EOSCogniton/Intergen/08_Quizz_competition/Quizz_FSG_2019/Q5_Chassis.jpg

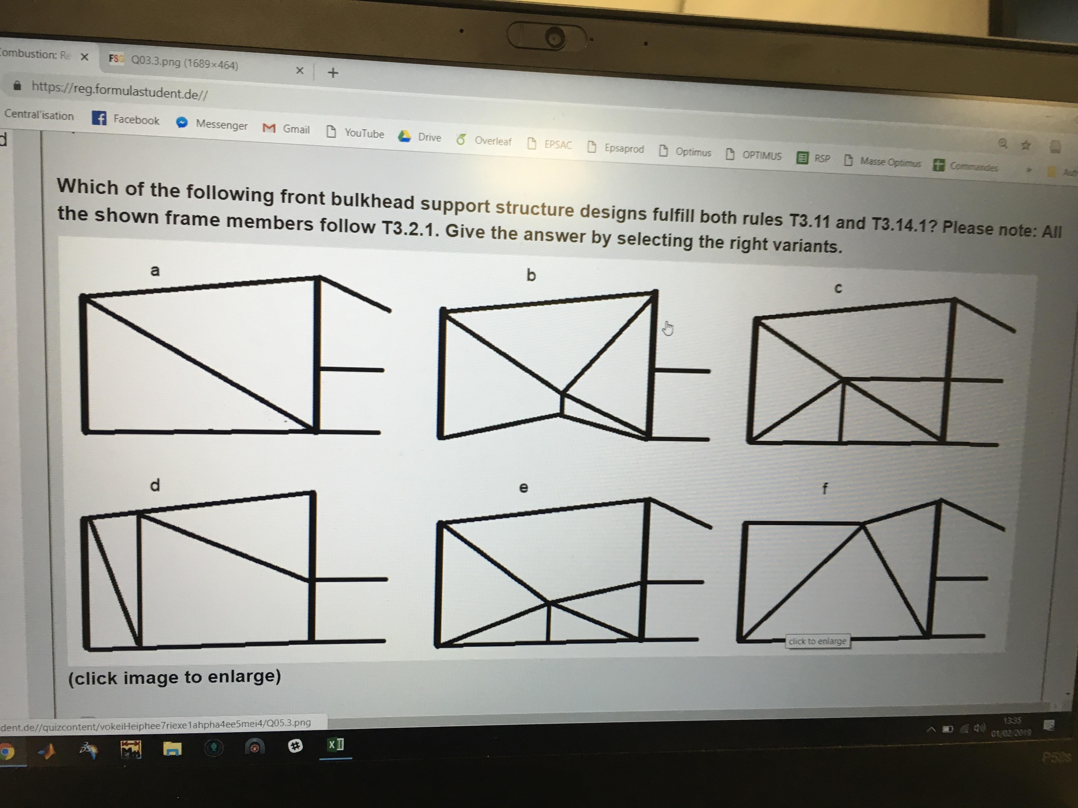
08_Quizz_competition/Quizz_FSG_2019/Q5_Chassis.jpg
