EOSCogniton/Intergen/05_Documents_Competition/03_Inscription Competition/Exemples questionnaire/IMG_5171.JPG

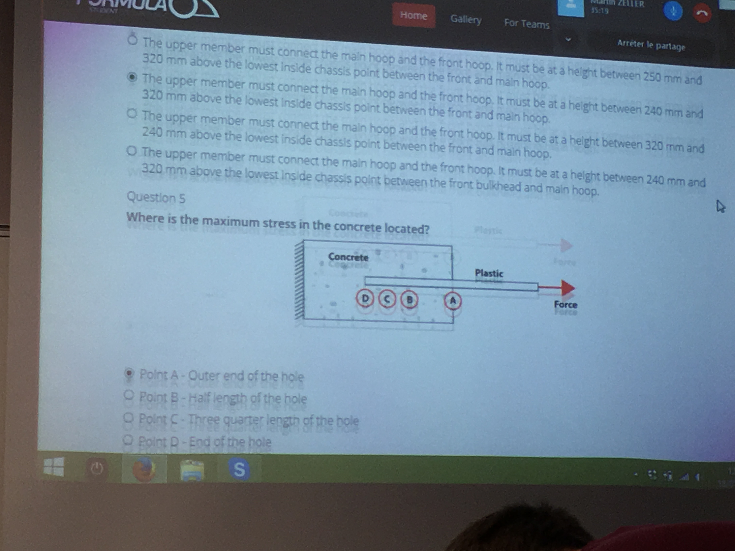
05_Documents_Competition/03_Inscription Competition/Exemples questionnaire/IMG_5171.JPG
