EOSCogniton/Intergen/02_Modèles/Lap_Time_Model/Read_Me.txt

Pour démarrer nous avons une version simple : peu précise mais faible en temps de calcul ==> Simple_Model
Puis une version plus complexe qui intégre les données pneu pour accel, freinage & skidpad ==> Complex_Model
Nous avons fait un programme pour trace le circuit ==> Track_Plot

Comparaison_Model.xslx ==> C'est un excel de rendu pour comparer différentes architectures
