EOSCogniton/Intergen/02_Modèles/Lap_Time_Model/04_Appli/Release_Version.txt

V0.1 : 
V0.2 : Import .mat Button added
v0.3 : Skidpad button run the simulation for Skidpad, Import .mat become import .xlsx
