EOSCogniton/Intergen/06_Plateforme_Bron/Plan_Rules.pptx

Plateforme de ISYPRO (Lycée Emile Bejuit - Bron)

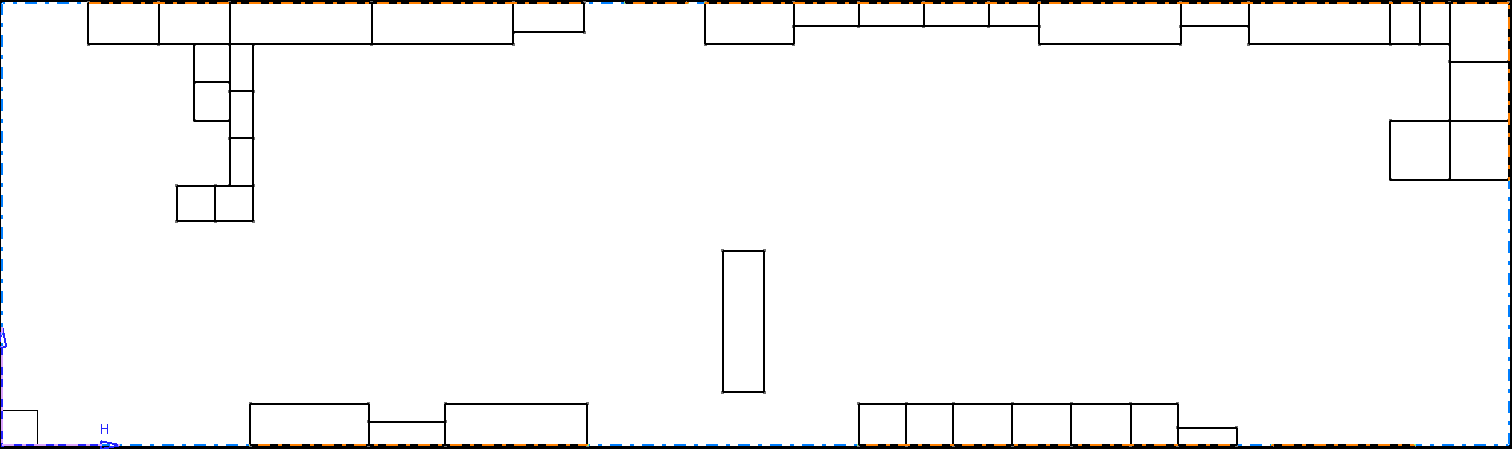
[picture p20: figure]

Sector 7

Sector 6

Sector 3

1,1 m

2,4 m

Sector 2

2,4 m

Sector 1

2 m

3 m

7,5 m

Sector 4

Tableau de Bord

1,6 m

Sector 5

Machines

25,5 m

1,6 m

3 m

0,8 m

1 m

0,6 m

2,4 m

Etabli Moteur

Sector 1

Raw materials & trailer & machining

Sector 2

Sector 3

Etagère Kit Montage & Inventaire Pièces

Sector 4

Anciens Véhicules
+ Equipements Pilotes

Sector 5

Rangement Outils
+ Etablis

Sector 6

Intégration sur le véhicule

Sector 7

Cuisine, Equipements de sécurité

Electrical Departement

Version : v3.0

Date : 06/03/2020, CMI

## Slide 2

Features

Sector 7

Machines

Sector 6

Sector 3

1,1 m

2,4 m

Sector 2

2,4 m

Sector 1

2 m

3 m

7,5 m

Sector 4

Sector 5

25,5 m

Sector 4

1,6 m

3 m

0,8 m

1 m

0,6 m

2,4 m

1,6 m

Sector 1

Sector 2

Sector 3

Sector 5

Sector 6

Sector 7

Version : v3.0

Version : v3.0

Date : 06/03/2020, CMI

## Slide 3

Plateforme de ISYPRO (Lycée Emile Bejuit - Bron)

I - Working rules :
- Rule I-1 : Always clean up after working time
- Rule I-2 : Put the tools back where you found them
- Rule I-3 : Leave written messages on parts you worked on if necessary
II - Safety rules :
- Rule II-1 : Do not work when you are alone
- Rule II-2 : Always wear the appropriate protection clothes & shoes
- Rule II-3 : When machining, wear safety glasses and gloves

Version : v3.0

## Slide 4

Sector 1 : Machining & Storage

Officer : MPL

- Grinder
- Drilling machine
- 2 metal shears
- One hydraulic press
- 2 Vices
- 4 raw material storage slots (plates, woods, plain material & misc.)

Version : v3.0

## Slide 5

Sector 2 : Electrical Departement

Officer : BAT

- …

Version : v3.0

## Slide 6

Sector 3 : Assembly Boxes

Officer : MPL

- …

Version : v3.0

## Slide 7

Sector 4 : …

Officer : …

- …

Version : v3.0

## Slide 8

Sector 5 : …

Officer : …

- …

Version : v3.0

## Slide 9

Sector 6 : …

Officer : …

- …

Version : v3.0

## Slide 10

Sector 7 : …

Officer : …

- …

Version : v3.0

## Pb echappement : distance entre echappement et réservoir

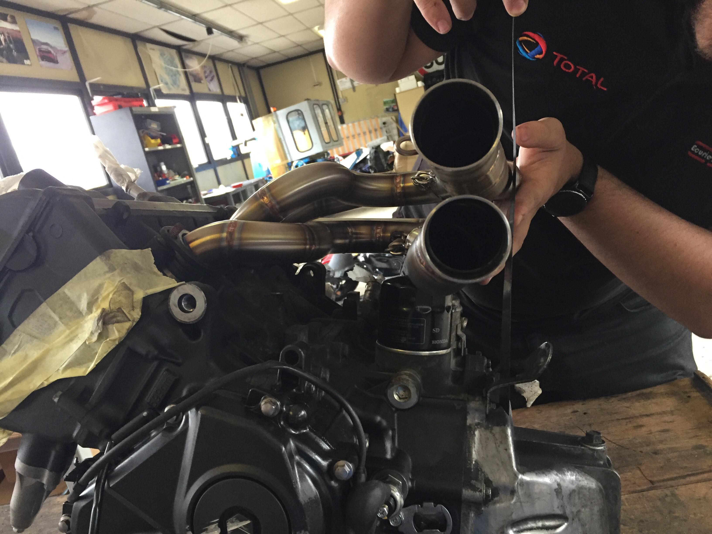
[picture p21: figure]
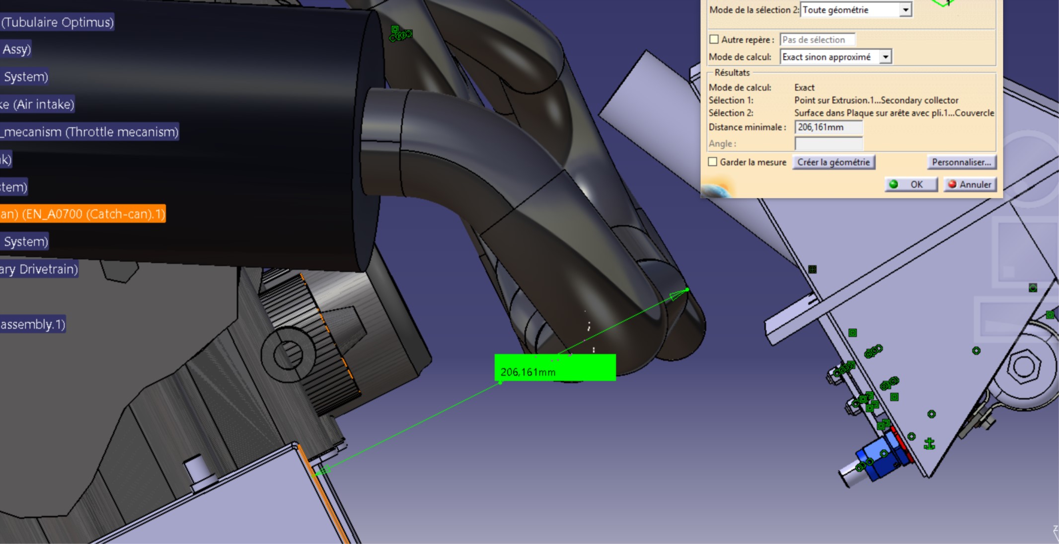
[picture p22: figure]

? < 50 mm

200 mm

215 mm

53 mm

## Pb chaine/couronne et BAR

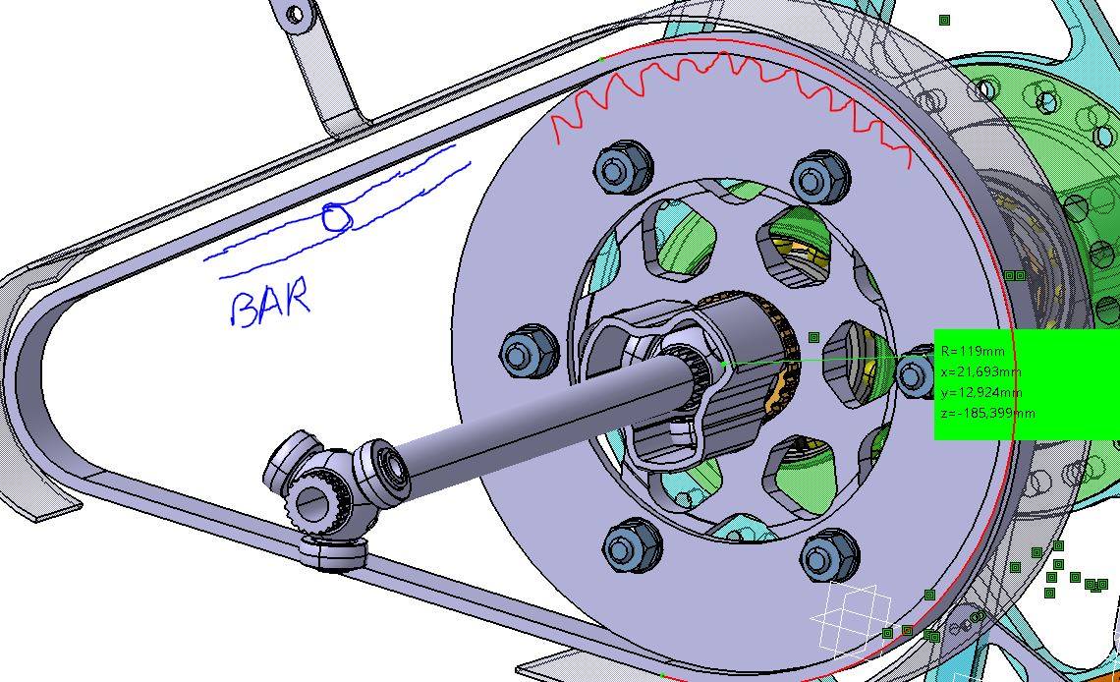
[picture p23: figure]

Braum tu es sur d’avoir pris en compte le fait que la chaine rentre dans les pignons de la couronne ?

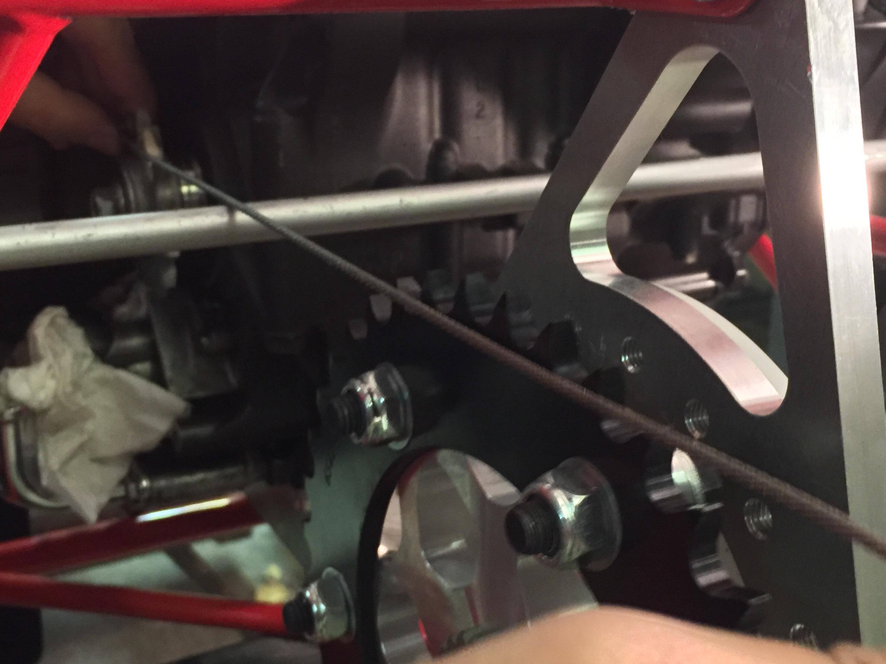
[picture p24: figure]

## Pb Couronne passage circlip

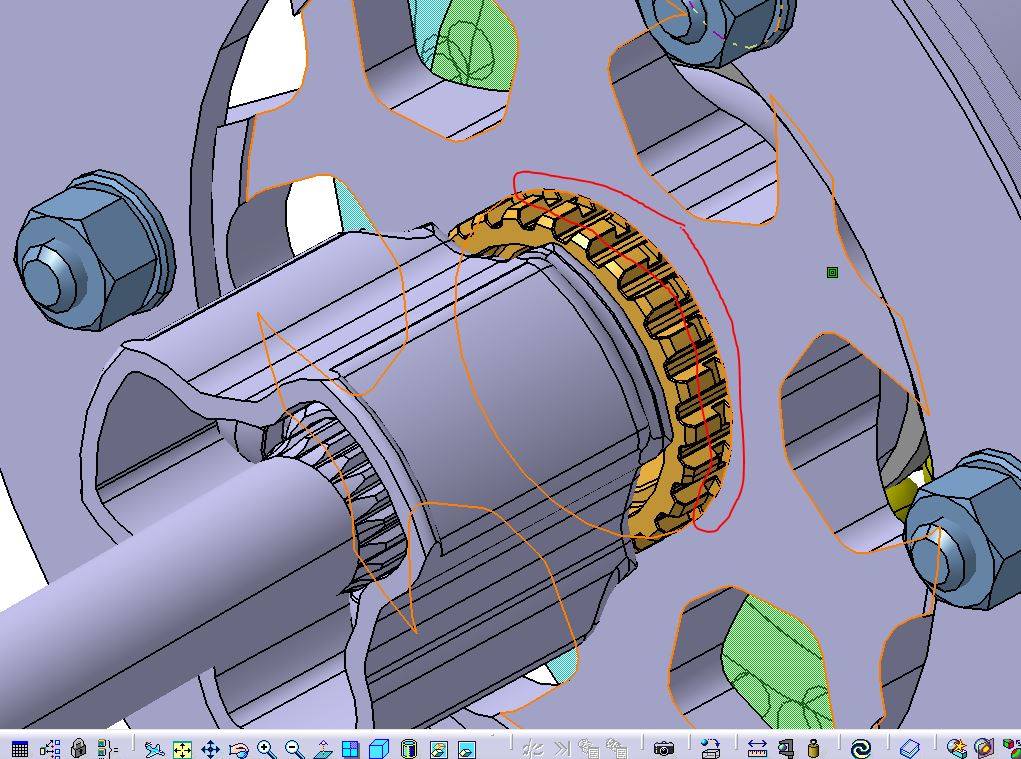
[picture p25: figure]

L’évidement que Bertrand houx n’avez pas fait pour éviter de l’usinage était en fait nécessaire pour assurer la place de passer correctement le circlip du Drexler

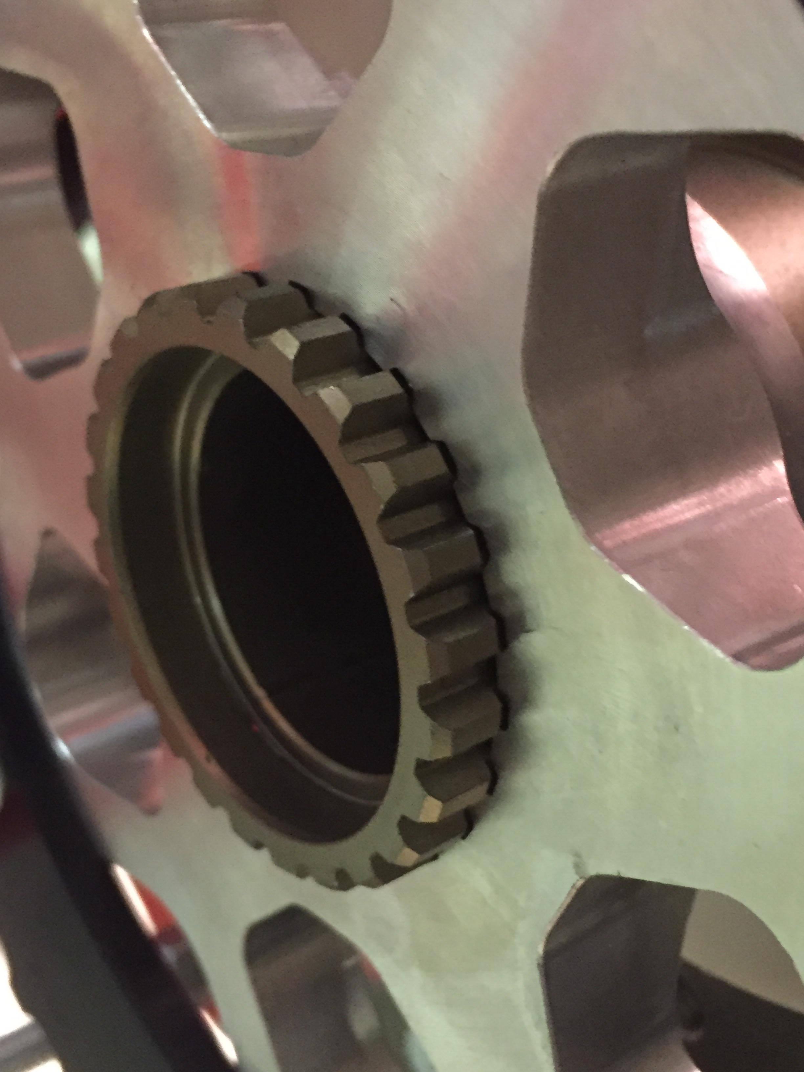
[picture p26: figure]
