EOSCogniton/Intergen/08_Quizz_competition/2018_Quizz2.pptx

Quizz #2

Mardi 4 Decembre 2018

## Question #1

What is the minimum distance between 95th percentile lower 200mm circle and face of the pedal ?
- 925 mm
- 920 mm
- 37 in
- 36 in

Notes: 36 in

## Question #2

What is the maximum angle which the lower portion of Main hoop (i-e below upper side impact member) can make with the horizontal, when inclined rearward ?

- No limit
- 10
- 80
- 45

Notes: 80

## Question #3

The engine lubrication system of your vehicle has a capacity of 12.5l. In driving condition it is 80% filled with the fluid. What is the minimum volume of catch can?

- 1l
- 0.9l
- 1.1l
- 1.2l

Notes: 1l

## Question #4

Which ones meets the positive locking requirement?

- Washers
- Cotter pins
- Bolts with nylon patches
- Loctite

Notes: Cotter pins

## Question #5

Runner system between restrictor and throttle body is made up of rectangular cross-section with height 55mm. What is the possible width of the runner system?
- 60mm
- 50mm
- 55mm
- 65mm

Notes: 50mm

## Question #6

What is the penalty, if a team is not able to submit notice of intent or FMEA of ETC by the due date?
- -10 points daily till max -50 points
- Disqualification from competition
- Back to mechanical throttle
- No penalty

Notes: Back to mechanical throttle

## Question #7

Which of the following is not a requirement of Cost report ?
- Font size 10 point or higher
- Page size A4
- Page size 8.5in x 11in
- Must not exceed 350 pages

Notes: Must not exceed

## Question #8

In Autocross Event, which flag is used to indicate the approval to begin ?
- Blue flag
- Red flag
- Green flag
- Red-yellow striped

Notes: green

## Question #9

In endurance event if a team exceeds Tmax time then how much points do they score ?
- 50
- 25
- 10
- 0

Notes: 25

## Question #10

Which of the following act results in penalty ?
- Alcohol and illegal material
- Arguments with official
- Unsportsmanlike conduct
- Failed to follow an official instruction

Notes: Failed to follow
