EOSCogniton/Intergen/03_Gestion_De_Projet/03_Diapo_Presentation_Seance_PA_PE/2018_12_18_Project_Brief.pptx

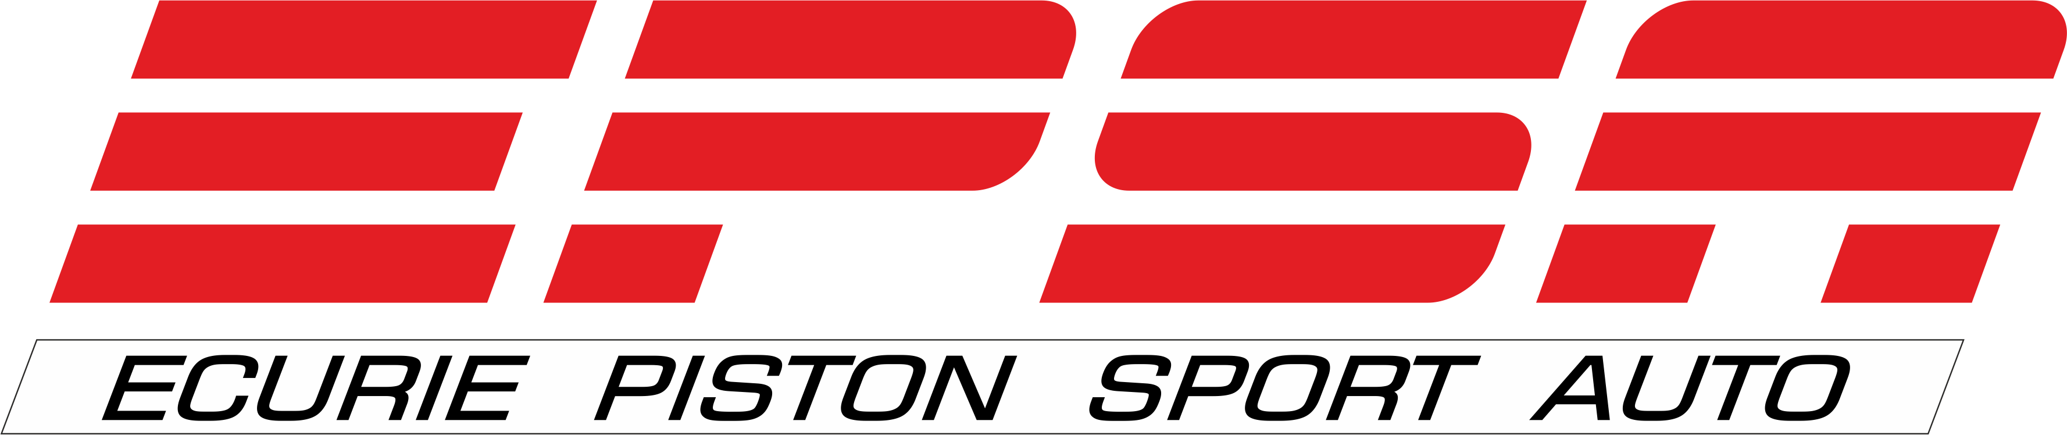
[picture p31: figure]

Point sur le projet

Mardi 18 Décembre 2018

## Point sur l’avancée des mEP

- Premiers envois en production chez La Mache productique, Boisard et La mache Laser
- Préparer les devis

## Réalisation des gabarits

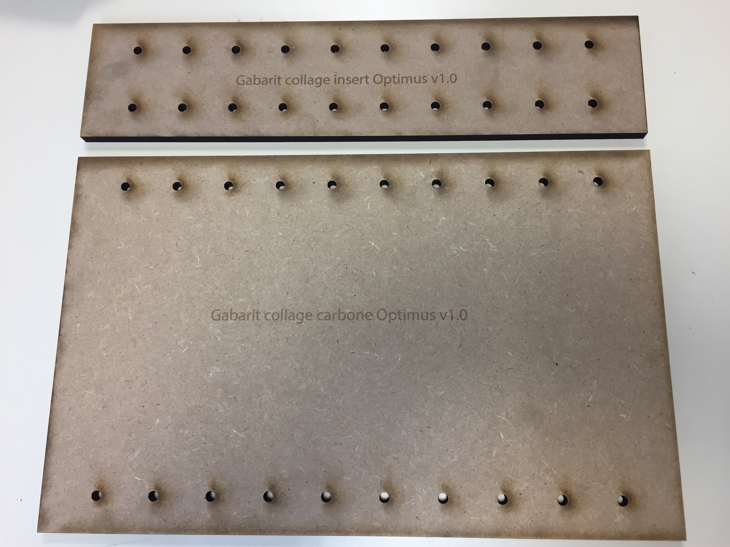
[picture p32: figure]

## Pour le top projet

Questions ?
