EOSCogniton/Intergen/07_Documents Techniques/02_Formations/Formation_Departement_2A/Template_Diapo_Formation.pptx

Département …

Janvier 2018

## Cahier de charges

- Explication des critères et contraintes principales intervenants dans la conception de votre système ou pièce.

## Conception préliminaire

- …

## Conception DETAILLEE

- …

## ERREURS A EVITER

- …

## Pour le top projet

Questions ?
