EOSCogniton/Intergen/05_Documents_Competition/Documents_Design_Vulcanix_2018/Impression/Engine Support.pdf

## MOTORISATION

## Aims

- Reliable engine
- Reduce the impact of the air intake restrictor

## Constraint

According to the rule, all the air used by the engine should go through a 20mm diameter air intake restrictor. Consequences after the “maximum” engine speed is reached:
- Constant power after a certain engine speed
- Decay of the torque

## Engine choice

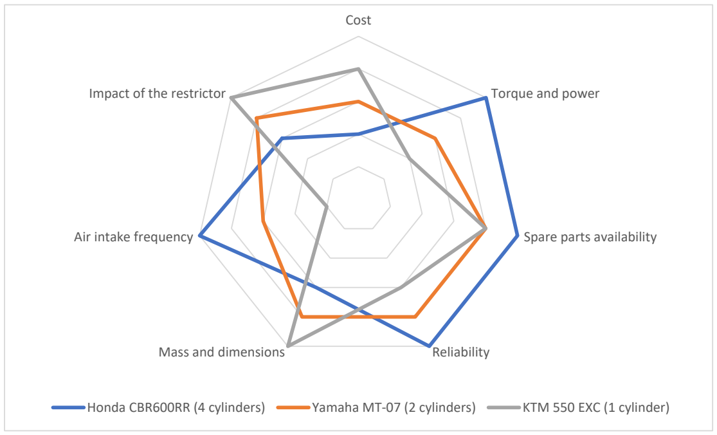
[picture p65: figure]
Cost; Torque and power; Spare parts availability; Mass and dimensions; Reliability; Air intake frequency; Impact of the restrictor; Honda CBR600RR (4 cylinders); Yamaha MT-07 (2 cylinders); KTM 550 EXC (1 cylinder)

- Choice of the Honda CBR600RR, particularly for is reliability, and impact of the restrictor on this engine.

Figure 1: Diagram of engine choice

## Air intake and exhaust

## Objective

- Reduce the impact of the air intake restrictor
- Dispose of a stock of air between the engine and the air intake restrictor
- Low pressure loss in the plenum

## Acoustic study

Hypothesis:

- Intake: 20°C
- Exhaust: 600°C

Lengths:

- Admission runner: 351mm
- Exhaust:
- First runner: 402-426mm
- Collector: 296-308mm
- Final collector: 378mm
- Gain of torque in the constant power zone.

## Engine tuning

Sensors:

- Camshaft angle
- Crankshaft speed
- Water temperature
- Air temperature

Parameters:

- Fuel injection time
- Ignition timing: timing advance

Objective: increase torque and efficiency

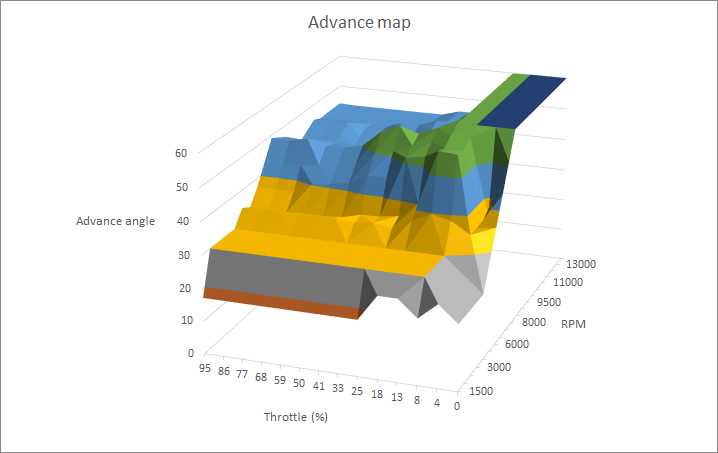
[picture p66: figure]

Figure 1: 3D timing advance map
