EOSCogniton/Intergen/02_Modèles/Acceleration BRT (Simulink)/Lisez-moi.txt

Lancer en premier le script matlab d'initialisation des variables.
Le fichier simulik s'exécutera tout seul.
