EOSCogniton/Intergen/04_Communication/CHARTE GRAPHIQUE EPSA.docx

CHARTE GRAPHIQUE EPSA

Couleurs :

R : 247

V : 9

B : 3

LOGO et utilisation :

Logo sur fond blanc

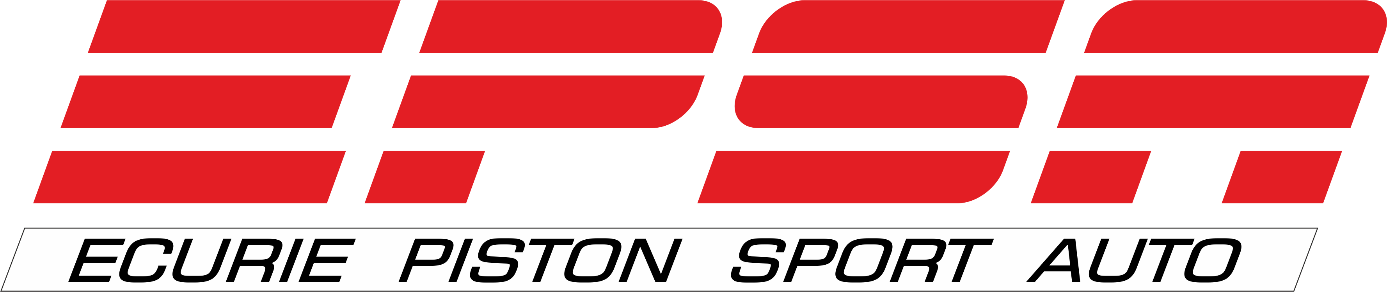
[picture p122: figure]

Petit format type signature

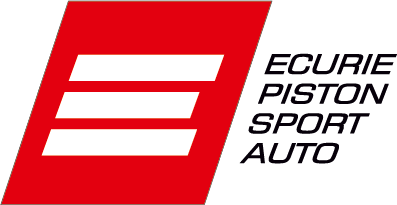
[picture p123: figure]

Police :

Raleway
