EOSCogniton/Intergen/03_Gestion_De_Projet/02_Ressources TOPs/Templates_Diapo_TOP_Projet/TOP PROJET.pptx

## Top Projet Optimus

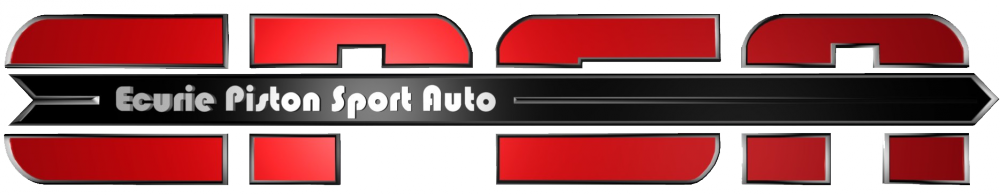
[picture p141: figure]
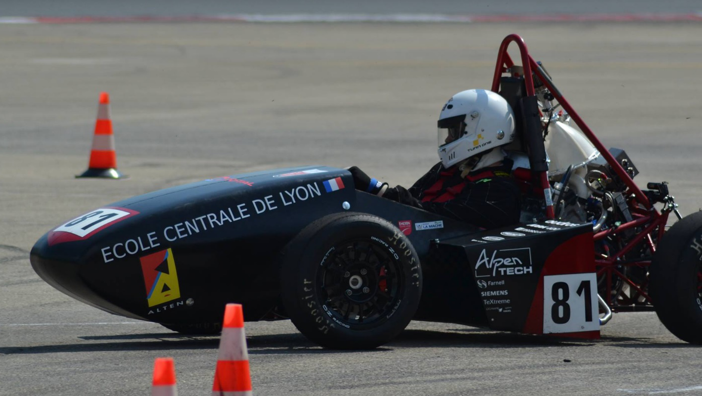
[picture p142: figure]

v1.3

## Sommaire

1. Présentation du Projet : Véhicule Optimus
2. Retour d’expérience de la saison passée
3. Présentation de la Direction Véhicule
4. Présentation des Départements
5. Proposition de jalonnement des TOP
6. Présentation du budget prévisionnel ISYRUN
7. Conclusion

## Sommaire

1. Présentation du Projet : Véhicule Optimus
2. Retour d’expérience de la saison passée
3. Présentation de la Direction Véhicule
4. Présentation des Départements
5. Proposition de jalonnement des TOP
6. Présentation du budget prévisionnel ISYRUN
7. Conclusion

## Objectifs Principaux

01

Respect strict des échéances

- Sortir la voiture dans les temps
- Date de TOP Moteur fixée au 1er Mars
- Permet une grande période de tests et entraînement pilotes

02

Formation efficace des Alpha 1A

- Formation et accompagnement revu
- Meilleure intégration de la contribution des 1A

## Optimus v1.0

Résultats Prévus :

Epreuve | Meilleurs résultats | Prévision | Barème
Cost Event | 94/100 Vulcanix | 85 | 100
Business Event | 63/75 Atomix v1.0 | 50 | 75
Design Event | 106/150 Dynamix v1.0 | 85 | 150
Skid Pad | 45/75 Kinétix | 40 | 75
Accélération | 60/100 Dynamix v2.0 | 75 | 100
Autocross | 41/125 Atomix v2.0 | 55 | 125
Endurance | 160/275 Dynamix v2.0 | 175 | 275
Efficiency | 6/100 Atomix v1.0 | 10 | 100
Total Brut | 480/1000 Dynamix v2.0 | 575 | 1000

## Sommaire

1. Présentation du Projet : Véhicule Optimus
2. Retour d’expérience de la saison passée
3. Présentation de la Direction Véhicule
4. Présentation des Départements
5. Proposition de jalonnement des TOP
6. Présentation du budget prévisionnel ISYRUN
7. Conclusion

## Retour d’expérience des années passées

Décisions :

- Un véritable travail intergénérationnel unissant 1A, 2A et 3A autour d’un même véhicule
- Un renforcement de la structure managériale autour de “Départements”
- Un reporting hebdomadaire pour le suivi d’avancement
- Une meilleure gestion de la formation pour les 1A arrivant à l’EPSA

## Sommaire

1. Présentation du Projet : Véhicule Optimus
2. Retour d’expérience de la saison passée
3. Présentation de la Direction Véhicule
4. Présentation des Départements
5. Proposition de jalonnement des TOP
6. Présentation du budget prévisionnel ISYRUN
7. Conclusion

## Organisation de la direction Véhicule pour la saison 2019

Organisation du Projet :
- Directeur de Projet : Nicolas Gameiro (NGO)
- Directeur Technique : Maxime Proriol (MPL)
- Directeur Performance : Bob Aubouin (BAT)
- Directeur Financier : Yohan Reguiai (YRI)

## Organisation de l’association pour la saison 2019

Organisation Associative :
- Président : Paco Tanchon (PTN)
- Vice-Président : Antoine Maros (AMS)
- Secrétaire Général : Josselin Kiefel (JKL)
- Trésorier : Erwan De Longcamp (EDP)

## Sommaire

1. Présentation du Projet : Véhicule Optimus
2. Retour d’expérience de la saison passée
3. Présentation de la Direction Véhicule
4. Présentation des Départements
5. Proposition de jalonnement des TOP
6. Présentation du budget prévisionnel ISYRUN
7. Conclusion

## Organisation des Départements

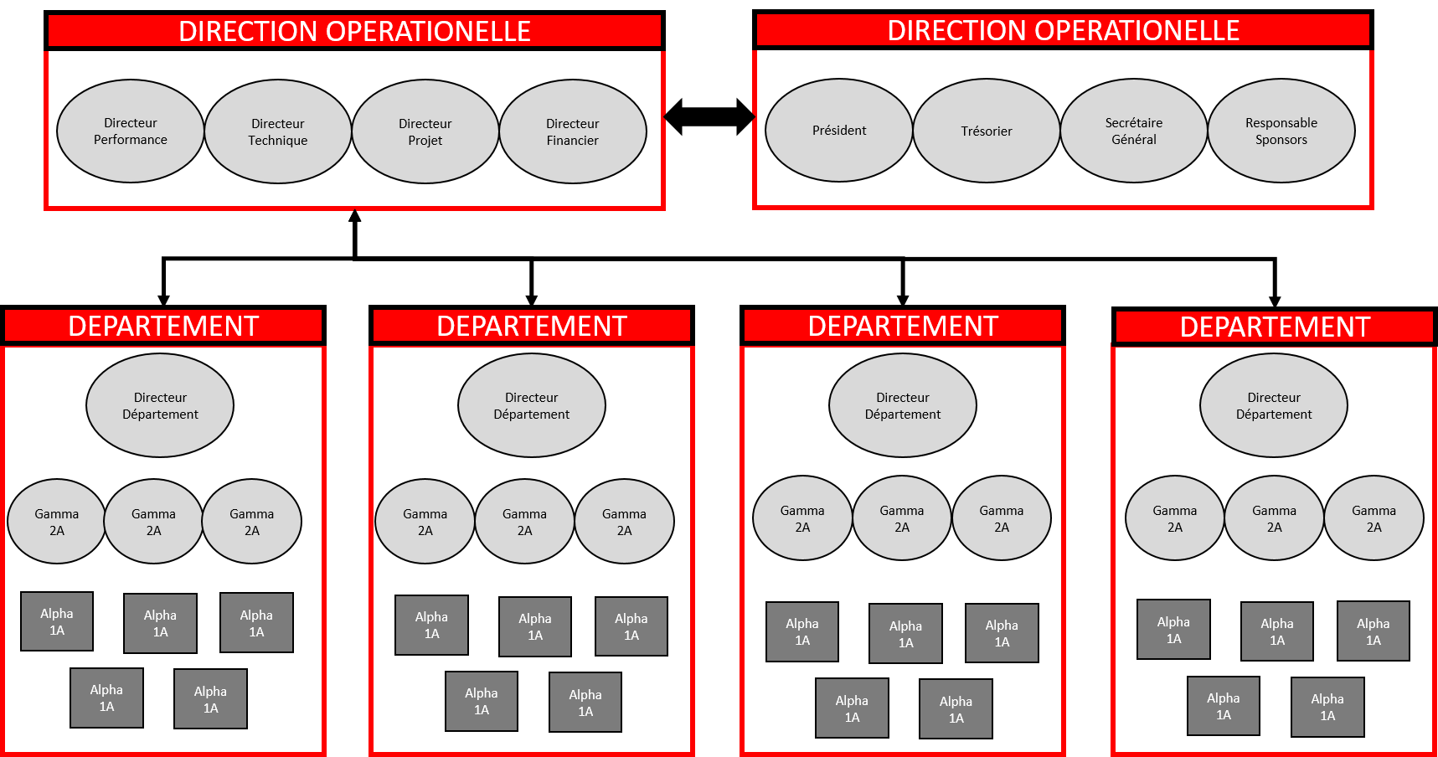
[picture p143: figure]

## Organisation des Départements

| Châssis équipé & aéro | Motorisation | LAS | Elec.
Directeur | Robin Clamens | Clément Emerique | Pierre Alexis Corpechot | Bob Aubouin
Membre | Rafael De Leon | Théophane Bau | Erwan De Longchamps | En phase de recrutement
Membre | Yohan Reguiai | Maxime Proriol | Lucas Trouessin
Membre | Josselin Kiefel | Paco Tanchon | Gameiro Nicolas

## Objectifs Département LAS

Ce qu’on garde :
- LAS Automatique réalisée par les 2As
- Porte Moyeux
Ce qu’on ajoute :
- Mise en place de l’anti-roll Bar
- Optimisation de la position des centres de Roulis
- Réflexion sur anti-dive & anti-squat

## Objectifs Département Chassis équipé & aéro

Ce qu’on garde :
- conception paramétrique
- structure générale
Ce qu’on ajoute :
- éléments aéro (ouies, diffuseur..)
- repenser la cellule arrière
- optimisation du cockpit
- attention au surdimensionnement

## Objectifs département Electronique

Ce qu’on garde :
- La rigueur de travail de l’équipe de Vulcanix
- Le faisceau de Vulcanix s’il fait ses preuves cet été
Ce qu’on ajoute :
- Un possible système de télémétrie ( si recrutement)
- Un volant équipé

## Objectifs Département Motorisation

Ce qu’on garde :
- Pas de changement Moteur
- Refroidissement
- Transmission secondaire
Ce qu’on ajoute :
- Changement de l’échappement
- Optimisation de l’admission
- Changement du réservoir d’essence

## Sommaire

1. Présentation du Projet : Véhicule Optimus
2. Retour d’expérience de la saison passée
3. Présentation de la Direction Véhicule
4. Présentation des Départements
5. Proposition de jalonnement des TOP
6. Présentation du budget prévisionnel ISYRUN
7. Conclusion

## Dates Prévisionnelles des TOPs (Conforme PO-07-002)

TOP Projet (S)
Lancement officiel du projet du nouveau véhicule autorisant les ressources humaines du projet

4 Avril 2018

TOP Pré-Dim (SF)
Validation des premiers maquettes autorisant l’engagement des ressources logicielles de validation numérique

6 Juin 2018

TOP Maquette
Présentation des premiers concepts autorisant l’engagement des ressources logicielles de la modélisation physique et de maquette numérique

9 Mai 2018

TOP Appro
Présentation des validation de maquettes et lancement des premiers approvisionnements autorisant l’engagement des bons de commandes des approvisionnements matière à cycle long

29 Juin 2018

TOP Saison
Lancement de la saison 2018/2019 avec les 1er années et les académiciens.

22 Septembre 2018

TOP Copeau (SFF)
Présentation de l’intégralité des choix de conceptions et leur justification autorisant le lancement de la production véhicule, l’engagement des matières premières, la fabrication des pièces unitaires chez les partenaires.

6 novembre 2018

TOP Synthèse
Présentation de l’avancement du projet autorisant l’engagement des moyens techniques et humains de la plateforme ISYMECA

2 Octobre 2018

TOP Organe
Vérification de l’état d’avancement des kits sur une plateforme partenaire.

9 Janvier 2019

Fin de la phase descendante
et début de la phase remontante

## Dates Prévisionnelles des TOPs (Conforme PO-07-002)

TOP Véhicule
autorise l’Intégration Véhicule sur la plateforme ISYPRO.

15 Février 2019

TOP Qualif (SFFV)
Validation du véhicule par un pilote professionnel

16 Mars 2018

TOP Moteur
Démarrage du moteur autorisant la Validation Système du véhicule sur piste d’essais.

2 Mars 2019

TOP Compet
Présentation de l’équipe des pilotes

1er Juillet 2019

## Diagramme de GANTT du début de la phase Descendante

## Jalonnement des livrables (Déploiement de la PO-19-001)

TOPs Phase descendante :
- Pour le TOP Maquette : DDI, DSS
- Pour le TOP PréDim : DCP, ½ DMI-3D
- Pour le TOP Appro : DCD, ¾ DMI-3D
- Pour le TOP Synthèse : DMI-3D
- Pour le TOP Copeaux : BIC, PROP
TOPs Phase remontante :
- Pour le TOP Organe : PROM, PROC, PFC
- Pour le TOP Véhicule : PROV, PROX

## Sommaire

1. Présentation du Projet : Véhicule Optimus
2. Retour d’expérience de la saison passée
3. Présentation de la Direction Véhicule
4. Présentation des Départements
5. Proposition de jalonnement des TOP
6. Présentation du budget prévisionnel ISYRUN
7. Conclusion

## Budget prévisionnel Optimus

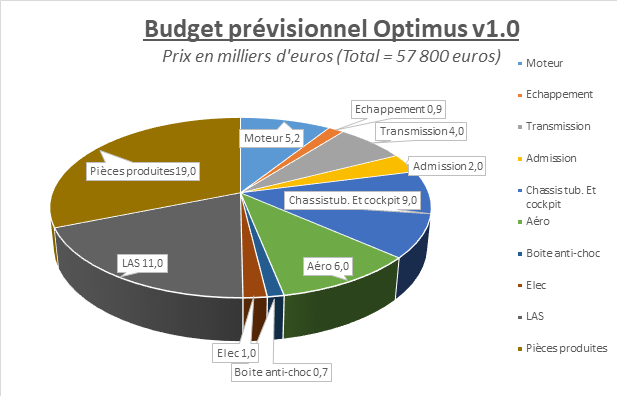
[picture p144: figure]

## Sommaire

1. Présentation du Projet : Véhicule Optimus
2. Retour d’expérience de la saison passée
3. Présentation de la Direction Véhicule
4. Présentation des Départements
5. Proposition de jalonnement des TOP
6. Présentation du budget prévisionnel ISYRUN
7. Conclusion

## Conclusion

⇒ Le retour intergénérationnel a été exploité
⇒ Le déploiement de la PO-07-002 et PO-19-001 est effectué
9 Mai 2018 : TOP Maquette
Save the date !
⇒ Questions ?

## Crowdfunding 2018

Lancement du crowdfunding sur Ulule
Lien dès demain par mail

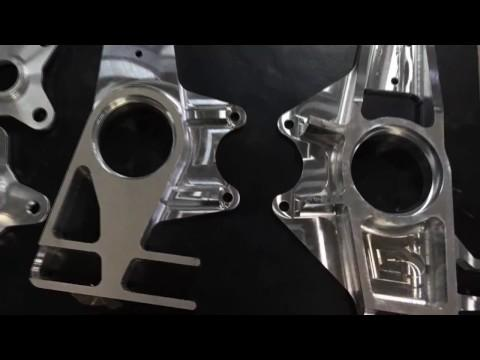
[picture p145: figure]
