EOSCogniton/Intergen/03_Gestion_De_Projet/01_Documents Organisation/2019_Optimus/04_Direction Financière/Gestion_Budget.pptx

## Gestion du Budget EPSA

Version 1.0

Saison 2019-2020

## Sommaire

Budget EPSA

- Les sources de financement de l’EPSA
- Les interlocuteurs privilégiers
- Les procédures à suivre
- Remarques de la saison 2018-2019

## Les sources de financement

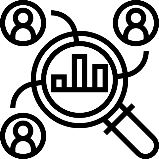
[picture p146: figure]

- La taxe d’apprentissage
  - Total
  - Alten
  - Volvo
  - Et plein d’autres
- Don sur l’association :
  - Alten
  - Instituts Carnot
- Don en nature :
  - SKF
  - ARRK
  - Souriau

## Les procédures à suivre

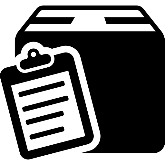
[picture p147: figure]

Procédure EPSA :

1. Faire un devis auprès d’une entreprise
2. Transmettre le devis au directeur financier qui tient un excel à jour avec les commandes et leur statut (en préparation, lancée,…)
3. Envoie d’un mail avec une forme particulière à Béatrice (Service facturé H10 Centrale)
4. Remplissage du Tableau chrono sur EPSABox

Procédure Service facturé Centrale :

1. Elle prépare la commande
2. Transmission de la commande à Roxane du service financier de Centrale

Procédure Service financier Centrale :

1. Elle prépare le bon de commande
2. Transmission de la commande à Oliver Barielle pour le signer

## Les procédures à suivre

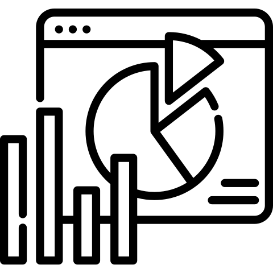
[picture p148: figure]

- Réalisation du budget prévisionnel en début de saison avec le directeur de projet
- Le directeur financier doit tenir à jour un excel avec des données statiques sur le budget.

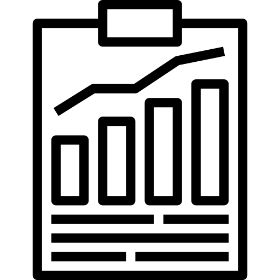
[picture p149: figure]

- Le directeur financier doit faire des rapports hebdomadaires à l’ensemble de l’équipe sur slack et lors des séances de PA

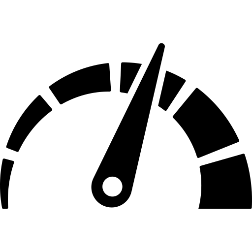
[picture p150: figure]

- Le directeur financier doit aider le directeur projet à la relance et la tenue des délais des commandes planifiées dans le Gantt.

## Les remarques

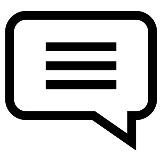
[picture p151: figure]

Nouveau fournisseur :

- Il faut demander à l’entreprise, en même temps que le devis, de remplir la fiche d’ajout de fournisseur de Centrale. Lien : …

Fournisseur étranger :

- Il faut les prévenir de notre mode de payement particulier
- Réaliser le Bill of sales (Bos). Exemple : …

## Les remarques

Nom des anciens directeurs financiers EPSA :

- Dynamix : Fabien ROBERT
- Atomix :
- Kinetix : Marc Salmon ?
- Olympix : Pierre Antoine Allart
- Vulcanix : Pierre Gras
- Optimus : Yohan Reguai
- Invictus : Romain Martin

## Questions ?
