EOSCogniton/Intergen/07_Documents Techniques/01_Livrables_TOPs/03_Livrables_TOP_Pré_Dim/Regles de conception_v1.0.pdf

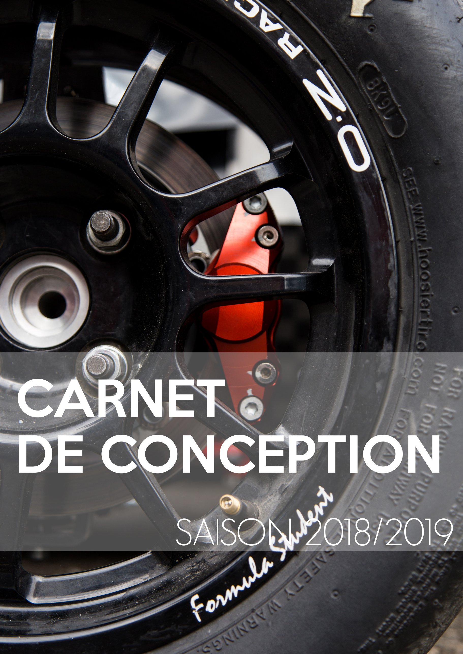
[picture p152: page 1]

# CARNET DE CONCEPTION

# SAISON 2018/2019

# INTRODUCTION :

# ACCESSIBILITE :

# PRINCIPALES REGLES :

L’objectif de ce document est de donner un ensemble d’informations utiles pour réaliser et concevoir les différentes pièces qui constituent vos systèmes et sous-systèmes. Il est principalement utile lors de la phase de conception Post TOP Pré-Dimensionnement. Il convient au directeur Technique du véhicule de prendre connaissance de ce document et de s’assurer du respect des régles qui y sont énoncées.

Vous concevez des pièces, mais plus largement des assemblages. Pensez que vous allez avoir des éléments de serrage (vis, écrou principalement). Mettez les autant que possible sur vos maquettes : ça peut montrer des problèmes d’encombrement, de collision, d’impossibilité de mise en place. Et oui, ça ne vient pas comme par magie dans le trou (place pour les doigts, suffisamment de place pour insérer la longueur de la vis).

Et ensuite il faut serrer : pensez que les outils ça prend encore plus de place (diamètre de douille, place pour les clés/ cliquets etc).

De manière générale, quand il s’agit d’encombrement au niveau du châssis, passages de gabarits, ou entre sous systèmes essayez toujours d’avoir un peu de marge. Car la maquette numérique reste parfaite. Dans le monde réel il y a des défauts de fabrication (notamment au niveau du châssis). Pour ce qui est usinage on est plutôt bon par contre.

Essayer au plus de prendre des épaisseurs standard pour vos pièces. Exemple porte excentrique 5mm c’est du standard, ça évite de devoir ressurfacer la pièce. Si c’est pas possible les partenaires feront avec mais bon : coût et travail en plus.

# Si votre pièce est découpée laser : c’est du 2D

Si votre pièce est usinée (tour/fraiseuse) : on ne fait pas les formes que l’on veut, les dimensions que l’on veut partout. On est limité par l’accessibilité/dimensions des outils, les techniques, le maintien en position de ta pièce (ce dernier point est beaucoup moins limitant). Ces problématiques sont surtout pour ce qui est formes internes et moins des contours. Typiquement un trou carré ça n’existe pas. Si tu fais une découpe interne, tu le fais avec une fraise qui est cylindrique. Donc tu auras des congés au minimum du rayon de ta fraise.

Si vous voulez avoir toute la liberté dans les formes, il faut voir du côté de l’impression 3D, mais bon.
Évitez absolument les variations brusques de section (exemple un cylindre de 10mm qui continu directement sur un cylindre de 20mm). Préférez des transitions plus douces : utilisation de congés.
Évitez au plus possible de faire travailler vos pièces en flexion, c’est beaucoup moins résistant que si tu travaille en simple traction compression.

Concernant les maquettes CATIA, aucune esquisse ne doit avoir de traits blancs, ils doivent tous être verts. Toutes les esquisses doivent être contriantes. Sinon tu as le risque pour tu sais pas quelle raison ton esquisse bouge. Soit tu t’en rend compte avant et ça te fais faire 2 fois le même travail, soit ta pièce part en prod, tu la reçoit et oh surprise, ça

# marche pas comme tu voulais !

# DIMENSIONNEMENT DES VIS :

Le diamètre/nombre de vis ne sort pas de nulle part.

# Deux écoles :

- Ta vis fonctionne comme un ressort. Quand tu sers ton écrou avec un certain couple, ça va avoir tendance à déformer ta vis qui va vouloir reprendre sa forme initiale. Donc elle applique une force (dépendante du couple, du filetage, de la lubrification,...) qui va comprimer les deux pièces que tu veux boulonner. Loi de coulomb : tant que tu reste dans le cône ça adhère. Combiné à l’effort normal, tes pièces bougent pas.

# - Tu dimensionnes au cisaillement

# Rédaction : Arthur Perdereau (Vulcanix - Saison 2018)

Si vous avez des questions d’usinage, de conception, que vous ne savez pas trop comment faire une pièce pour telle fonction, ou que vous pensez qu’il pourrait y avoir une meilleure solution, n’hésitez pas à me contacter j’essaierai de répondre du mieux possible. Ca fera gagner du temps à tout le monde :) En annexe, vous trouverez les tables de serrages et de passage de vis.

épaisseur chape découpée laser | 1,5 mm | 3 mm | 5 mm

# longueur entretoise conique (LAS)

# STANDARDISATION DES EPAISSEURS DE DECOUPE :

# TABLE SERRAGE DE VIS :

# 6Serrage contrôlé

| www.facom.com

ISO

Fo

Cs

8,8 *

5,6 | 5,8 | 6,8 | 8,8 * | 9,8 ** | 10,9 | 12,9

ISO 272

d mm | ISO mm | mm | Cs | Fo | Cs | Fo | Cs | Fo | Cs | Fo | Cs | Fo | Cs | Fo | Cs | Fo
1,6** | 0,35 | 3,2 | 0,060 | 260 | 0,084 | 364 | 0,096 | 416 | 0,128 | 555 | 0,144 | 624 | 0,189 | 815 | 0,221 | 954
2** | 0,40 | 4 | 0,126 | 432 | 0,177 | 604 | 0,202 | 690 | 0,270 | 921 | 0,303 | 1 036 | 0,396 | 1 352 | 0,463 | 1 582
2,5** | 0,45 | 5 | 0,261 | 718 | 0,365 | 1 006 | 0,417 | 1 150 | 0,556 | 1 533 | 0,626 | 1 724 | 0,82 | 2 251 | 0,96 | 2 634
3 | 0,50 | 5,5 | 0,44 | 1 077 | 0,62 | 1 508 | 0,71 | 1 724 | 0,95 | 2 298 | 1,09 | 2 586 | 1,40 | 3 376 | 1,64 | 3 951
4 | 0,70 | 7 | 1,03 | 1 868 | 1,44 | 2 615 | 1,65 | 2 988 | 2,20 | 3 985 | 2,49 | 4 484 | 3,23 | 5 853 | 3,78 | 6 849
5 | 0,80 | 8 | 2,03 | 3 053 | 2,85 | 4 275 | 3,25 | 4 885 | 4,34 | 6 514 | 4,92 | 7 335 | 6,3 | 9 568 | 7,4 | 11 196
6 | 1 | 10 | 3,53 | 4 310 | 4,95 | 6 034 | 5,6 | 6 896 | 7,5 | 9 195 | 8,53 | 10 336 | 11 | 13 506 | 12,9 | 15 805
8 | 1,25 | 13 | 8,5 | 7 904 | 11,9 | 11 066 | 13,6 | 12 647 | 18,2 | 16 863 | 20,63 | 18 968 | 26 | 24 768 | 31 | 28 984
10 | 1,50 | 16 | 16,8 | 12 580 | 23 | 17 612 | 27 | 20 128 | 36 | 26 838 | 41 | 30 197 | 52 | 39 418 | 61 | 46 128
12 | 1,75 | 18 | 29 | 18 337 | 40 | 25 672 | 46 | 29 339 | 62 | 39 119 | 70 | 44 022 | 91 | 57 457 | 106 | 67 236
14 | 2 | 21 | 46 | 25 175 | 65 | 35 245 | 74 | 40 280 | 99 | 53 707 | 111 | 60 251 | 145 | 78 882 | 170 | 92 309
16 | 2 | 24 | 71 | 34 597 | 100 | 48 436 | 115 | 55 356 | 153 | 73 808 | 173 | 83 165 | 225 | 108 406 | 263 | 126 858
18 | 2,5 | 27 | 99 | 42 094 | 139 | 58 932 | 159 | 67 351 | 220 | 92 440 | | | 313 | 131 897 | 366 | 154 348
20 | 2,5 | 30 | 140 | 54 059 | 196 | 75 682 | 225 | 86 494 | 311 | 119 003 | | | 440 | 169 385 | 515 | 198 216
22 | 2,5 | 34 | 192 | 67 511 | 269 | 94 515 | 307 | 108 017 | 424 | 148 374 | | | 602 | 211 534 | 704 | 247 540
24 | 3 | 36 | 241 | 77 845 | 338 | 108 983 | 387 | 124 552 | 534 | 171 437 | | | 758 | 243 914 | 887 | 285 432
27 | 3 | 41 | 355 | 102 393 | 498 | 143 350 | 569 | 163 829 | 784 | 225 110 | | | 1 114 | 320 832 | 1 304 | 375 442
30 | 3,5 | 46 | 483 | 124 491 | 677 | 174 287 | 773 | 199 185 | 1 067 | 274 030 | | | 1 515 | 390 072 | 1 773 | 456 467
33 | 3,5 | 50 | 653 | 155 083 | 915 | 217 116 | 1 046 | 248 132 | 1 442 | 341 347 | | | 2 048 | 485 926 | 2 397 | 568 637
36 | 4 | 55 | 841 | 182 032 | 1 177 | 254 845 | 1 346 | 291 252 | 1 855 | 400 571 | | | 2 636 | 570 369 | 3 085 | 667 453
39 | 4 | 60 | 1 088 | 218 667 | 1 523 | 306 135 | 1 741 | 349 868 | 2 399 | 481 158 | | | 3 410 | 685 159 | 3 990 | 801 782
42** | 4,5 | 65 | 1 348 | 250 311 | 1 887 | 350 435 | 2 156 | 400 497 | 2 965 | 550 683 | | | 4 223 | 784 306 | 4 941 | 917 805
45** | 4,5 | 70 | 1 681 | 292 970 | 2 353 | 410 158 | 2 690 | 468 752 | 3 698 | 644 534 | | | 5 267 | 917 973 | 6 164 | 1 074 223
48** | 5 | 75 | 2 032 | 329 254 | 2 845 | 460 956 | 3 251 | 526 807 | 4 470 | 724 359 | | | 6 367 | 1 031 663 | 7 450 | 1 207 265
52** | 5 | 80 | 2 608 | 395 006 | 3 651 | 553 008 | 4 172 | 632 009 | 5 737 | 869 013 | | | 8 171 | 1 237 685 | 9 562 | 1 448 354
56** | 5,5 | 85 | 3 255 | 456 159 | 4 557 | 638 622 | 5 208 | 729 854 | 7 161 | 1 003 549 | 10 199 | 1 429 298 11 935 | 1 672 582
60** | 5,5 | 90 | 4 032 | 532 893 | 5 645 | 746 050 | 6 451 | 852 629 | 8 871 | 1 172 365 | 12 634 | 1 669 732 14 785 | 1 953 941
64** | 6 | 95 | 4 856 | 602 793 | 6 798 | 843 911 | 7 769 | 964 470 | 10 683 | 1 326 146 | 15 215 | 1 888 753 17 805 | 2 210 243

# Clés dynamométriques

# Couple de serrage et force de précharge

## - Seule une précharge correcte procure un assemblage fiable : – précharge trop faible : risque de desserrage – précharge trop forte : risque de déformation des pièces à

assembler, ou de rupture de la vis.

## - La précharge est fonction du couple de serrage appliqué sur

la vis et du coefficient de frottement.

# Guide de serrage contrôlé

µ = 0.10 tableau de serrage pour visserie phosphatée ou zinguée, lubrification adaptée de bonne qualité ( µ = coefficient de frottement moyen)

## Qu’est-ce que la précharge ? (Fo) C'est la force en Newton qui met les pièces en pression

lors du serrage de la vis.

*Classe 8-8a jusqu’a d=16mm, 8-8b à partir de d=118 mm

Classes de qualité boulonnerie acier ISO 898-1

### 4. Convertir des Ibf.in

- Pound-force foot en Newton-mètre : | 1 lbf.ft = 1.35 N.m
- Pound-force foot en Kilogramme-force mètre : | 1 lbf.ft = 0.138 kgf.m
- Pound-force foot en Pound-force inch : | 1 lbf.ft = 12 lbf.in
- Pound-force inch en Newton-mètre : 1 lbf.in = 0.1129 N.m
- Pound-force inch en Kilogramme-force mètre : | 1 lbf.in = 0,0115 kgf.m
- Pound-force inch en Pound-force foot : | 1 lbf.in = 0,083 lbf.ft
- Pound-force inch en Ounce-force inch : | 1 lbf.in = 16 ozf.in

### 3. Convertir des lbf.ft

### 1. Convertir des N.m

- Newton-mètre en Kilogramme-force mètre : | 1 N.m = 0,102 kgf.m
- Newton-mètre en Pound-force foot : | 1 N.m = 0,738 lbf.ft
- Newton-mètre en Pound-force inch : | 1 N.m = 8,851 lbf.in
- Newton-mètre en Ounce-force inch : | 1 N.m = 141.61 ozf.in

TAbLE DE CONVERSIONS
L’unité internationale est le N.m (Newton x mètre).

## 1. Quel coefficient de frottement ?

Choisir le tableau de valeurs en fonction de votre vis (0.10, 0.15, ou 0.20).

## Exemple : µ = 0.10

### 2. Convertir des kgf.m

- Kilogramme-force mètre en Newton-mètre : | 1 kgf.m = 9.81 N.m
- Kilogramme-force mètre en Pound-force foot : | 1 kgf.m = 7.23 lbf.ft
- Kilogramme-force mètre en Pound-force inch : | 1 kgf.m = 86,8 lbf.in
3. Couples de serrage (Cs).
Ils sont indiqués, pour chaque type de vis, en Newton x mètre (N.m).

## Dans l’exemple, on appliquera un couple de serrage de 36 N.m sur

la vis.

# Tableau des couples de serrage :

## Les couples de serrage sont calculés à 85 % de la limite élastique

(documentation E 25-030).

## 2. Quelle "-classe de qualité-" de vis ? Les caractéristiques des vis dépendent de leur classe de qualité

(les vis 12.9 étant "-les plus performantes-").

Choisir la colonne correspondant à la classe de votre vis.

## Exemple : vis d 10, qualité de vis

## Qu’est-ce qu’un couple de serrage ? (Cs) Le couple "-est une force-" appliquée au bout d’un bras

de levier-;

*Classe 8-8a jusqu’a d=16mm, 8-8b à partir de d=118 mm

# Clés dynamométriques

# Guide de serrage contrôlé (suite)

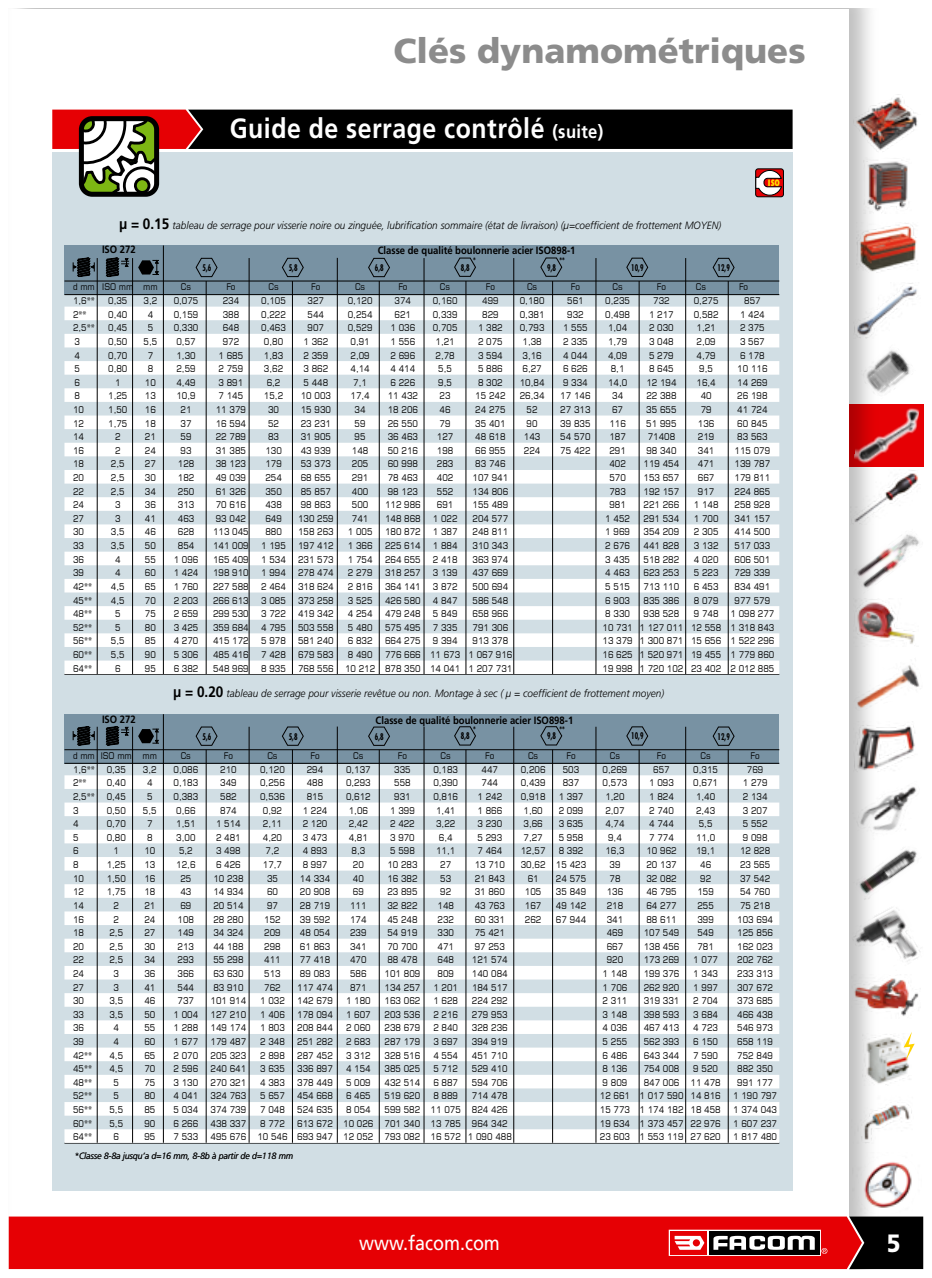
[picture p153: page 5]
www.facom.com; ISO; ISO 272; ISO mm

µ = 0.15 tableau de serrage pour visserie noire ou zinguée, lubrification sommaire (état de livraison) (µ=coefficient de frottement moyen)

Classe de qualité boulonnerie acier ISO898-1

µ = 0.20 tableau de serrage pour visserie revêtue ou non. montage à sec ( µ = coefficient de frottement moyen)

*Classe 8-8a jusqu’a d=16 mm, 8-8b à partir de d=118 mm

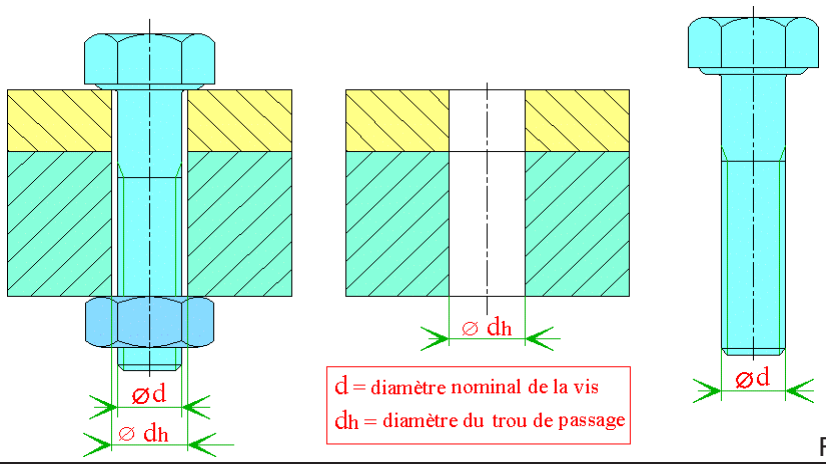
[picture p154: figure]

# Figure 15

# Trous de passage pour vis ou boulons - EN 20273 (ISO 273) Tableau 15

∅ de filetage | ∅ dh du trou de passage | ∅ de filetage | ∅ dh du trou de passage
d (mm) | série fine (H12)* | série moyenne (H13)* | série large (H14)* | d (mm) | série fine (H12)* | série moyenne (H13)* | série large (H14)*
1 1,2 1,4 1,6 | 1,1 1,3 1,5 1,7 | 1,2 1,4 1,6 1,8 | 1,3 1,5 1,8 2 | 36 39 42 45 | 37 40 43 46 | 39 42 45 48 | 42 45 48 52
1,8 2 2,5 3 | 2 2,2 2,7 3,2 | 2,1 2,4 2,9 3,4 | 2,2 2,6 3,1 3,6 | 48 52 56 60 | 50 54 58 62 | 52 56 62 66 | 56 62 66 70
3,5 4 4,5 5 | 3,7 4,3 4,8 5,3 | 3,9 4,5 5 5,5 | 4,2 4,8 5,3 5,8 | 64 68 72 76 | 66 70 74 78 | 70 74 78 82 | 74 78 82 86
6 7 8 10 | 6,4 7,4 8,4 10,5 | 6,6 7,6 9 11 | 7 8 10 12 | 80 85 90 95 | 82 87 93 98 | 86 91 96 101 | 91 96 101 107
12 14 16 18 | 13 15 17 19 | 13,5 15,5 17,5 20 | 14,5 16,5 18,5 21 | 100 105 110 115 | 104 109 114 119 | 107 112 117 122 | 112 117 122 127
20 22 24 27 | 21 23 25 28 | 22 24 26 30 | 24 26 28 32 | 120 125 130 140 | 124 129 134 144 | 127 132 137 147 | 132 137 144 155
30 33 | 31 34 | 33 36 | 35 38 | 150 | 155 | 158 | 165

# * pour information, à utiliser s'il est souhaitable de spécifier des tolérances

Dans un monde parfait, une vis M6 a un diamètre de 6 et ça rentre parfaitement dans un perçage de diamètre 6. Vous avez pas envie de vous faire chier à reprendre tous les passages de vis de la voiture à la main? Ce qu’on fait

# dans le monde réel, suivez le tableau suivant, série fine :

# TABLE PASSAGE DE VIS :
