EOSCogniton/Intergen/07_Documents Techniques/03_Ressources_Cours/MECAmaster_V0.1.pdf

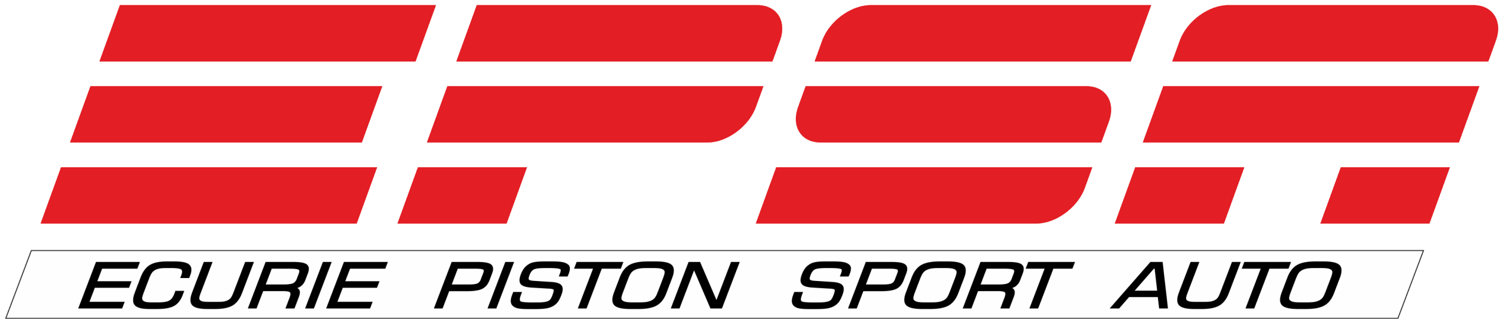
[picture p192: figure]

# Utilisation de MECAmaster : Calculs des efforts dans les liaisons d’un véhicule FS

### Maxime Proriol maxime.proriol@ecl17.ec-lyon.fr

5 Décembre 2018

## 1 Remerciements

Avant de commencer cette formation, je souhaite tout d’abord remercier Paul Clozel, de nous avoir prêter son logiciel MECAmaster et de nous avoir donner de nombreux conseils dans la modélisation de notre véhicule.
Pour les futurs membres de l’écurie, n’hésitez pas à contacter Mr Clozel, professeur à Centrale, il peut vous donner de bons conseils pour votre véhicule.

## 2 Objectifs

Lors de la phase de conception détaillée, le dimensionnement des systèmes impose de connaître les efforts appliqués sur ces derniers. Il est donc important d’employer une méthode de calcul adaptée pour connaître les différents cas de charges en fonction des diverses phases de fonctionnement du véhicule.

Le logiciel MECAmaster permet directement sous CATIA, de modéliser les liaisons d’un systèmes et de connaître les efforts appliqués dans ces dernières par un calcul statique dans les différents cas de charges imposés au systèmes.
Ce guide s’adresse particulièrement au département LASMECA pour connaître les efforts dans les portes moyeux, inserts de triangles, basculeurs de suspensions et tout autres constituants de la liaison au sol. Néanmoins, la méthode de modélisation est transposable et utilisable à tout système. En effet, cette méthode de calcul peut être généralisé à tout système contenant des liaisons (pédalier, guillotine, etc).

## 3 Modélisation du véhicule

Avant de commencer, Il faut savoir que plus votre véhicule sera bien modélisé et surtout bien organisée, plus vous obtiendrez de bons résultats sans perdre de temps.

Pour modéliser le liaison au sol du véhicule, le plus simple est d’utiliser un filaire de la LAS comme si dessous sur la figure 1. Les triangles, amortisseurs ont été laissé apparent pour une meilleur visualisation des systèmes (préférence personnelle). Il est important de définir les points de liaisons pour créer ces dernières grâce à MECAmaster.


Figure 1 – Filaire de la LAS de Optimus

1

### 3.1 Création des liaisons

Il existe deux manières de modéliser le système. En effet, il est possible de modéliser la voiture complète mais aussi de modéliser un seul coter du véhicule et de faire différentes hypothèses de symétries. Les deux cas marchent très bien, cela dépends du temps que vous souhaitez investir dans la modélisation.
Pour avoir un modèle le plus précis possible, l’ensemble des liaisons doivent être choisies de telle sorte que le système sois le plus proche de la réalité possible.

Figure 2 et 3, la modélisation du véhicule Optimus STUF2019.

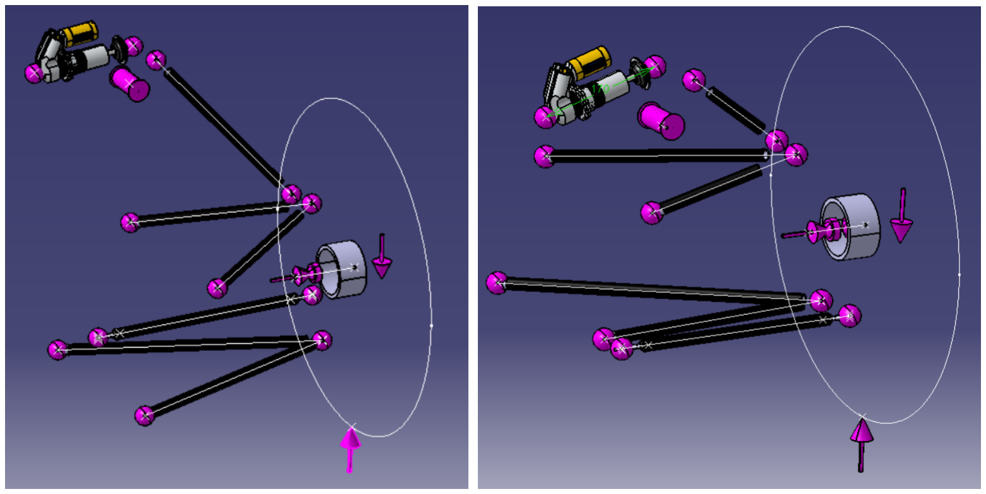
[picture p193: figure]

Figure 2 – A gauche : Front Right Suspension - A droite : Rear Right Suspension


Figure 3 – Vue globale de la modélisation du véhicule

2

Lors de la création d’une liaison divers paramètres sont a renseigner : nom, type de liaison, pièces concernés, point, direction. Ce travail de création de liaison demande une grande rigueur dans l’identification de toutes les liaisons permettant ainsi une meilleure facilité d’interprétation des résultats.
Pour le choix des pièces concernés, la création de pièces virtuelles permet de rendre plus clair la modélisation. Lors de la création d’une pièce, une rotule entre SOL et ROUE permet de créer un objet virtuel SOL et ROUE. Ces objets peuvent être réutilisé ultérieurement pour modéliser d’autre liaison.
Pour être bien organisé, le nom des pièces et des liaisons doivent être compréhensibles et les abréviations faciles à déchiffrer. Le véhicule STUF2018 Vulcanix a opté pour une identification normalisée facilement utilisable comme sur la figure 4 ci dessous.


Figure 4 – Exemple de noms de liaisons et de pièces virtuelles

3

Chaque pièce est nommé par sa position dans l’espace. Par exemple, rear uf a-arm est la bras du triangle supérieur (u :upper), avant (f :front) situé sur la suspension arrière (rear). Dans MECAmaster, la convention est prise de telle sorte que les efforts sont dirigés de la Part 1 sur la Part 2.

Première remarque : Quatre liaisons ponctuelles au point de contact sol/roues permettent de bloquer la translation suivant l’axe z.

Deuxième remarque : Une liaison ponctuelle sur chaque roues coté droit permet de connaître l’effort de freinage au niveau des étriers. Cette liaison doit être placée à un rayon égale au rayon moyen du disque de frein.

Troisième remarque : Les roulements sont modélisés par deux linéaires annulaires (à gauche et à droite) et une ponctuelle (à gauche). Attention, le placement des ces liaisons dépend des types de roulements utilisés. Dans le cas d’Optimus, l’emploi de roulement à contact oblique impose une modélisation des liaisons au centre de poussé des roulements. Ainsi, les différentes liaisons ne sont pas placé en centre du roulement mais au centre de poussé identifié par la côte a décrite sur la figure 5. En fonction du montage des roulement (en O ou en X) veillez à bien placer ces liaisons.


Figure 5 – Modélisation des deux roulements et extrais de la fiche technique des roulements

Quatrième remarque : On considère que chaque triangle est composé de deux branches. On modélise une branche grâce à deux rotules de part et d’autre. En conséquence, à l’intersection des branches deux rotules sont présentes (pas de panique).

4

### 3.2 Création des efforts extérieurs et adaptation du modèle

Pour connaître l’effort maximale dans les différents constituants de la liaison au sol, il est important de diviser l’étude pour balayer les différents modes de fonctionnement du véhicule.
Les modes de fonctionnement étudiés dans le cas de Vulcanix et Optimus sont :
— Freinage 2G (BRAKING 2G) ;

— BUMP 3G ;
— Virage à gauche 2G (LEFT TURN 2G) ;

— Virage à droite 2G (RIGHT TURN 2G) ;

— Combiné virage à gauche 1G + freinage 1G (LEFT TURN 1G + BRAKING 1G) ;

— Combiné virage à droite 1G + freinage 1G (RIGHT TURN 1G + BRAKING 1G) ;

— Accélération 0,5G (INVERSE BRAKING 0,5G).

Ces différents mode de fonctionnement sont extrêmes et difficilement atteignables avec le véhicule. Ils permettent ainsi de connaître les efforts les plus importants dans le pire des cas dans les différentes liaisons.

Remarque importante : Si vous modélisez l’ensemble des liaisons du véhicule (coté gauche et droit), il n’est pas nécessaire de réaliser les modes de fonctionnement des deux cotés. On se contentera donc d’un seul virage et d’un seul combiné.

### 3.2.1 Poids du véhicule

Le poids du véhicule avec pilote doit être inclus dans le modèle. Il doit être place au centre de gravité. Pour cela, il est important de calculer une approximation du poids du véhicule (bilan de masse), de la répartition de masse et de la hauteur du centre de gravité.

Données Optimus :
— Poids : 3100N (230kg de véhicule + 80kg de pilote) ;

— Répartitiion de masse : 50/50 (Donné vérifiée numériquement sur Vulcanix) ;

— Hauteur du centre de gravité : 35cm (Donné vérifiée numériquement sur Vulcanix) ;

### 3.2.2 BRAKING 2G

Pour modéliser le cas de freinage en 2G, il est nécessaire de placer de chaque coté du train avant, une liaison ponctuelle au point de contact avec le sol. Chacune des deux ponctuelles créé un paramètre que l’on nomme sur le dernier menu déroulant (BrakeFR pour le coté droit et BrakeFL pour le coté gauche. Enfin sur le train arrière, on place de chaque coté une force dirigée vers l’arrière située au point de contact avec le sol prenant en paramètre la valeur de l’effort de la ponctuelle située à l’avant. Pour cela, écrire sur le dernier menue déroulant le nom du paramètre créé initialement à l’avant. Cela permet indirectement de prendre en compte la répartition de freinage avant/arrière.
Le coté droit est décrit sur le figure 6 ci dessous.

5

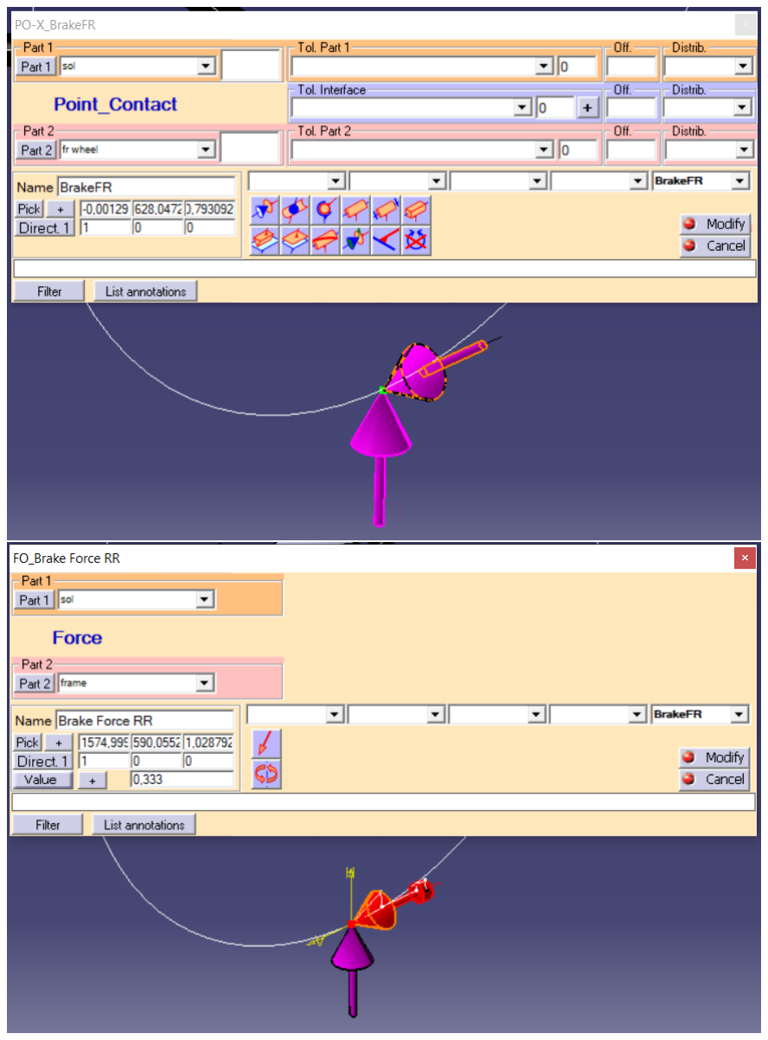
[picture p194: figure]

Figure 6 – En haut : Front Right Wheel - En bas : Rear Right Wheel

Ensuite, il est nécessaire de créer comme décrit sur la figure 7 une force d’inertie au centre de gravité égale à deux fois le poids du véhicule dirigée dans le sens d’avancement de ce dernier.

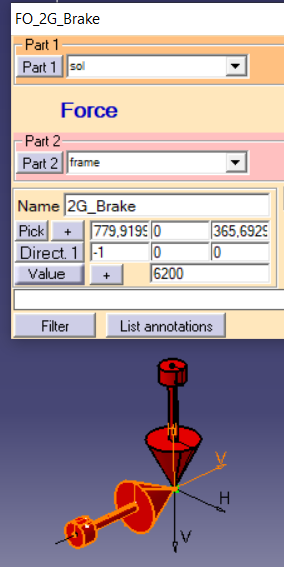
[picture p195: figure]

Figure 7 – création de la force d’inertie au centre de gravité

6

### 3.2.3 BUMP 3G

Ce mode de fonctionnement est très simple. Il consiste à multiplier la norme du poids du véhicule par trois et de lancer le calcul.

### 3.2.4 LEFT TURN 2G

### 3.2.5 LEFT TURN 1G + BRAKING 1G

### 3.2.6 INVERSE BRAKING 0,5G

Ce mode de fonctionnement est très simple. Il consiste à ajouter en plus du poids une force d’inertie dans le sens de la marche de 0,5 fois le poids du véhicule.

7
