EOSCogniton/Intergen/07_Documents Techniques/01_Livrables_TOPs/07_Livrables_TOP_Copeau/IO_GAV.pdf

### CERTIFICAT DE VERIFICATION ET DE CONFORMITE PIECE

Date de vérification :
Nom du vérificateur : | TRIGRAMME :
Référence COST de la pièce : | Numéro si multiple :
Référence de la MEP : | Versionnement de la MEP :
Lieu de la production :

Vérifications :

OK/KO

Statut déclaré de la pièce : | Conforme | Non Conforme

Si coché conforme, la pièce concernée est réputée de qualité BLEUE 4 ETOILES
Sinon, la pièce peut etre considérée valide si dérogation cochée, et visa DIR TECH apposé
VISA VERIFICATEUR | VISA DIR PERF | VISA DEROG.
COTES CRITIQUES | Valeur nominale | Valeur mesurée

Ce document est la propriété exclusive de l'EPSA et de ces membres Saison 2019 - Véhicule Optimus v1.0
