EOSCogniton/Intergen/03_Gestion_De_Projet/01_Documents Organisation/2018_Vulcanix/Vulcanix_FAB_commandes.pdf

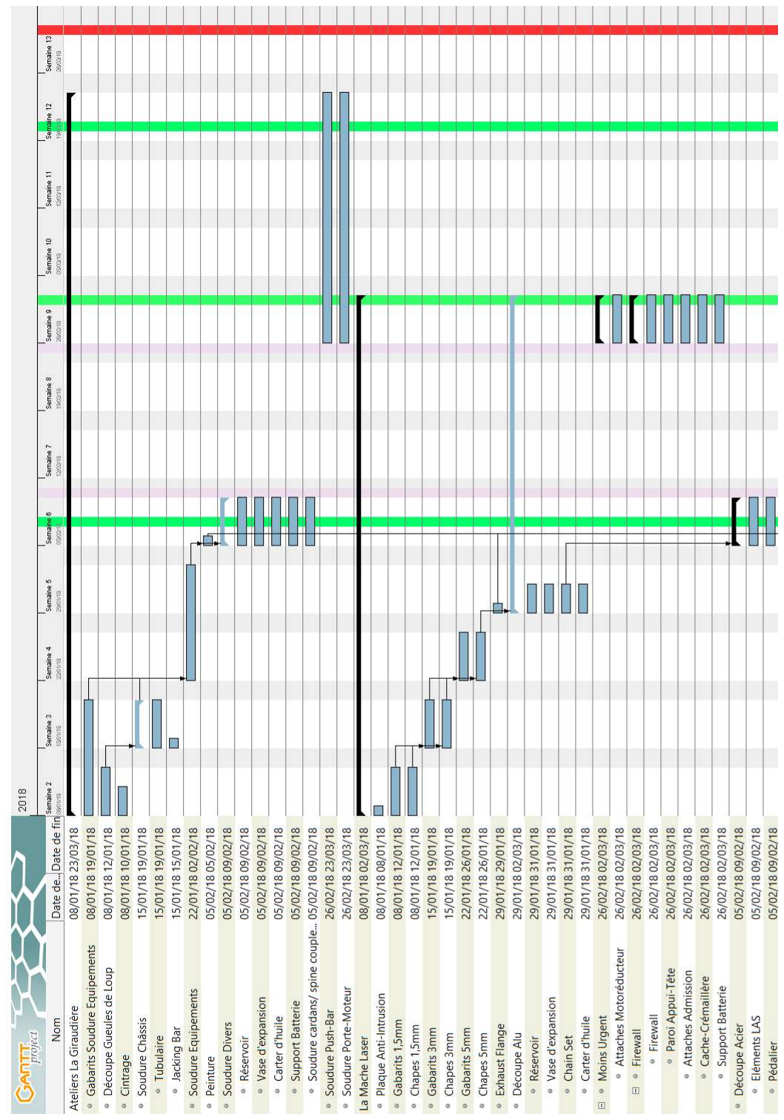
[picture p228: page 1]
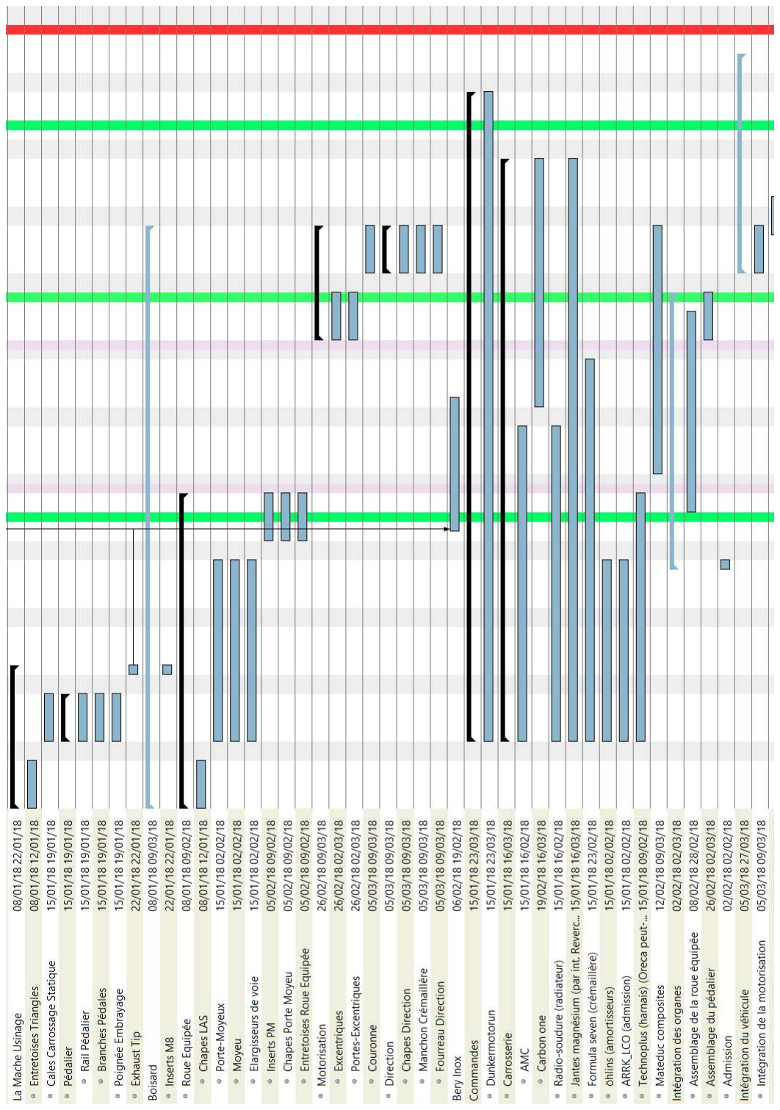
[picture p229: page 2]
