EOSCogniton/Intergen/02_Modèles/Acceleration TDN (Matlab)/essai_recalage_1.jpg

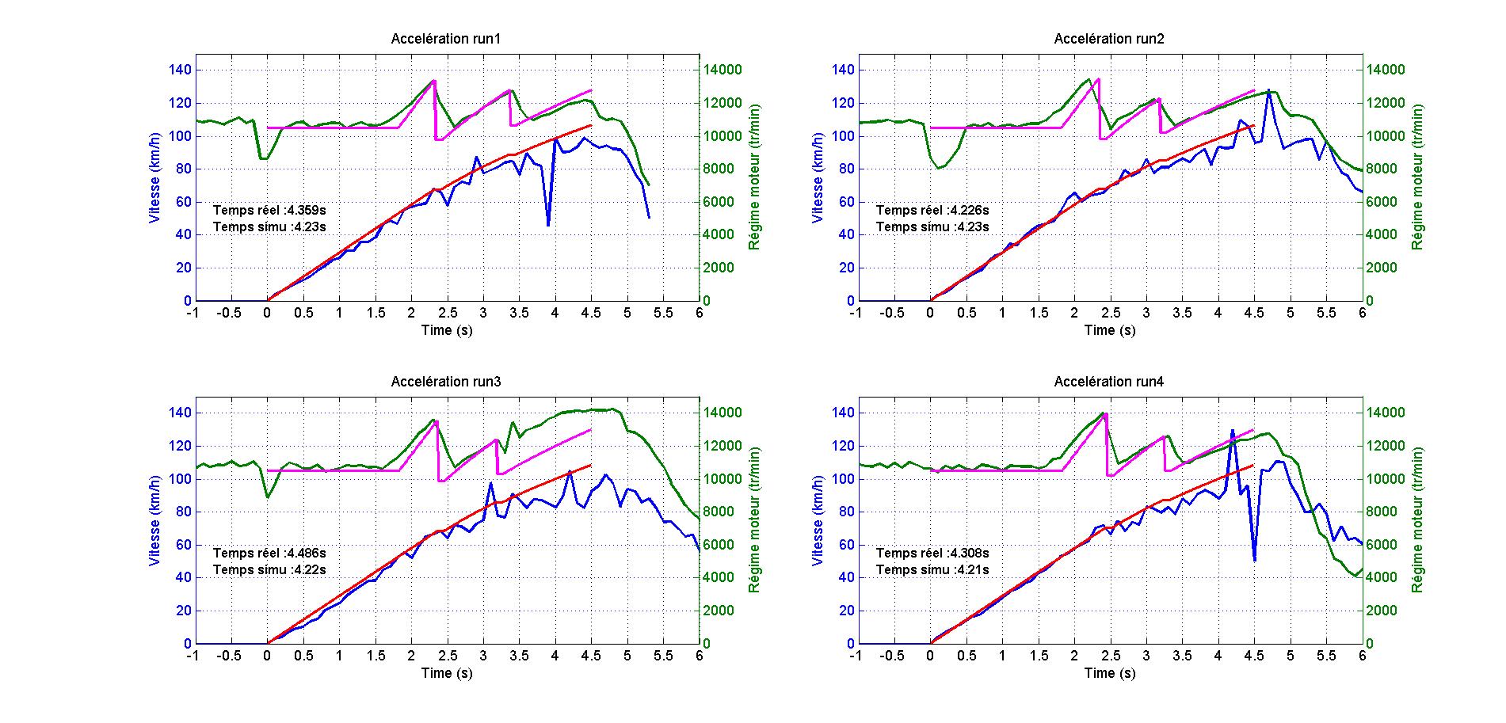
02_Modèles/Acceleration TDN (Matlab)/essai_recalage_1.jpg
