EOSCogniton/Intergen/02_Modèles/Acceleration TDN (Matlab)/essai_recalage_run2_adh=1.4.jpg

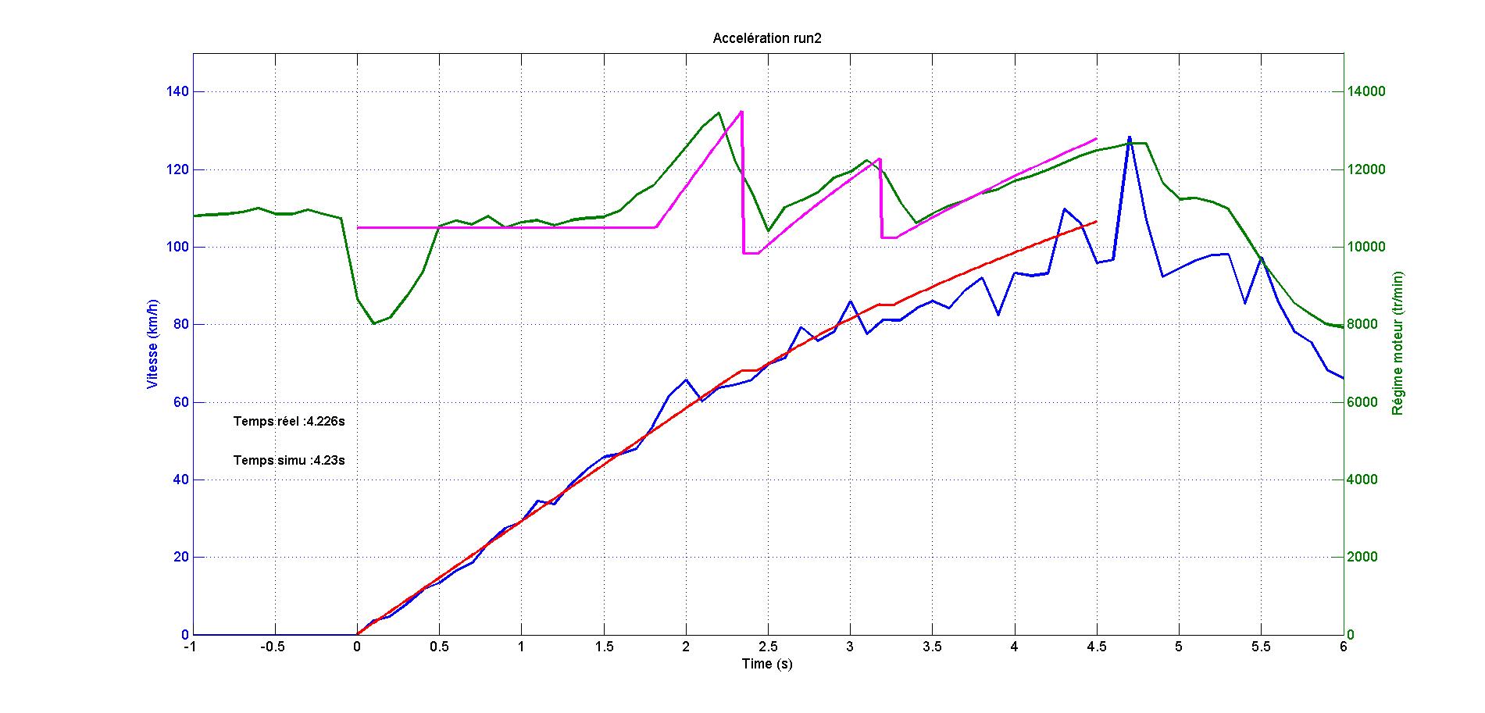
02_Modèles/Acceleration TDN (Matlab)/essai_recalage_run2_adh=1.4.jpg
