EOSCogniton/Intergen/02_Modèles/Acceleration TDN (Matlab)/etude_param_final_ratio.jpg

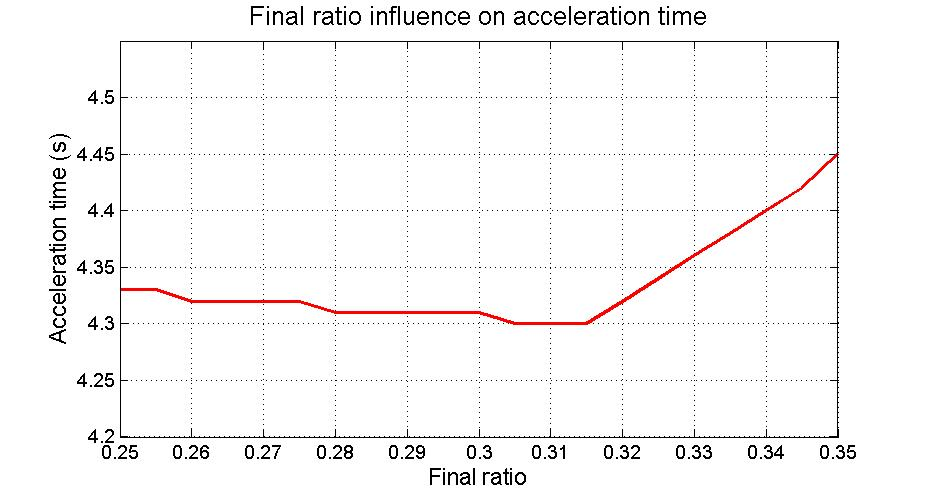
02_Modèles/Acceleration TDN (Matlab)/etude_param_final_ratio.jpg
