EOSCogniton/Intergen/02_Modèles/Acceleration TDN (Matlab)/etude_param_vehicle_mass.jpg

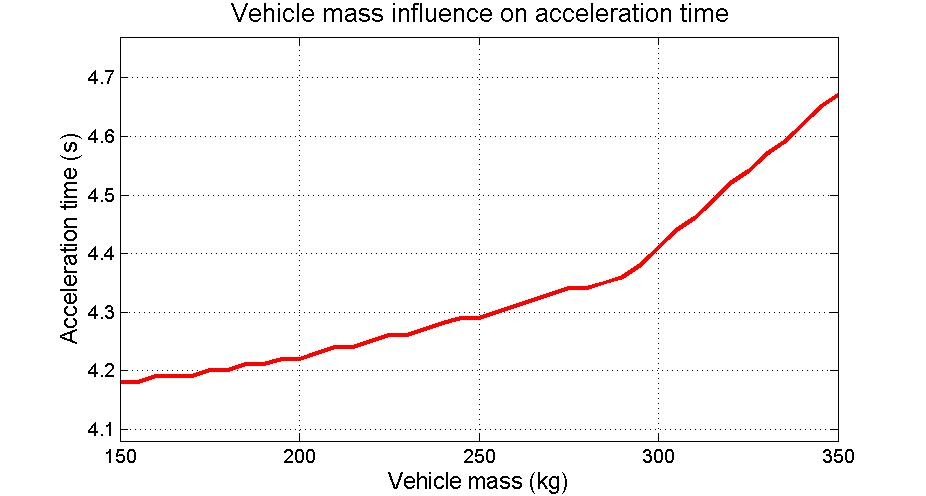
02_Modèles/Acceleration TDN (Matlab)/etude_param_vehicle_mass.jpg
