EOSCogniton/Intergen/02_Modèles/Lap_Time_Model/01_Simple_Model/Endurance_track_FSATA esual.JPG

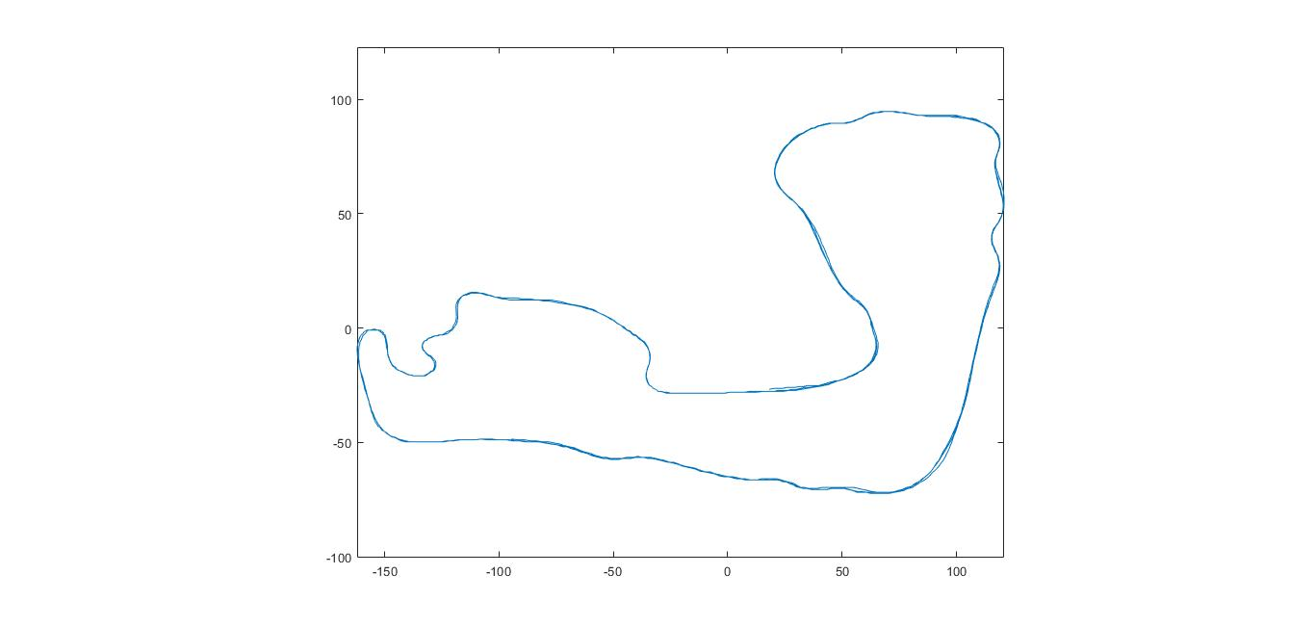
02_Modèles/Lap_Time_Model/01_Simple_Model/Endurance_track_FSATA esual.JPG
