EOSCogniton/Intergen/02_Modèles/Lap_Time_Model/04_Appli/Fichier 1.png

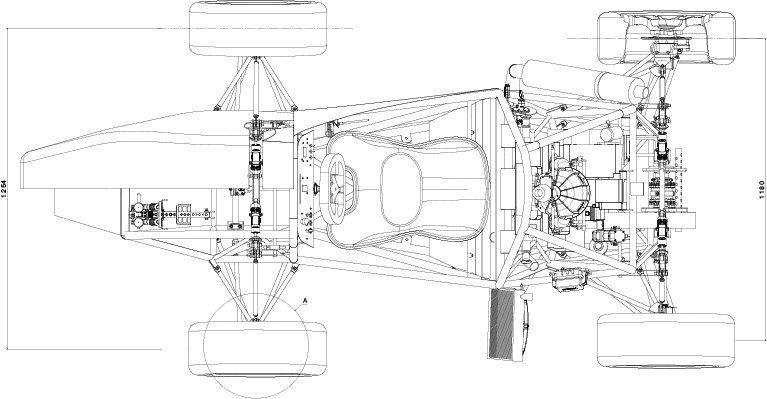
02_Modèles/Lap_Time_Model/04_Appli/Fichier 1.png
