EOSCogniton/Intergen/03_Gestion_De_Projet/01_Documents Organisation/2018_Vulcanix/Vulcanix.jpg

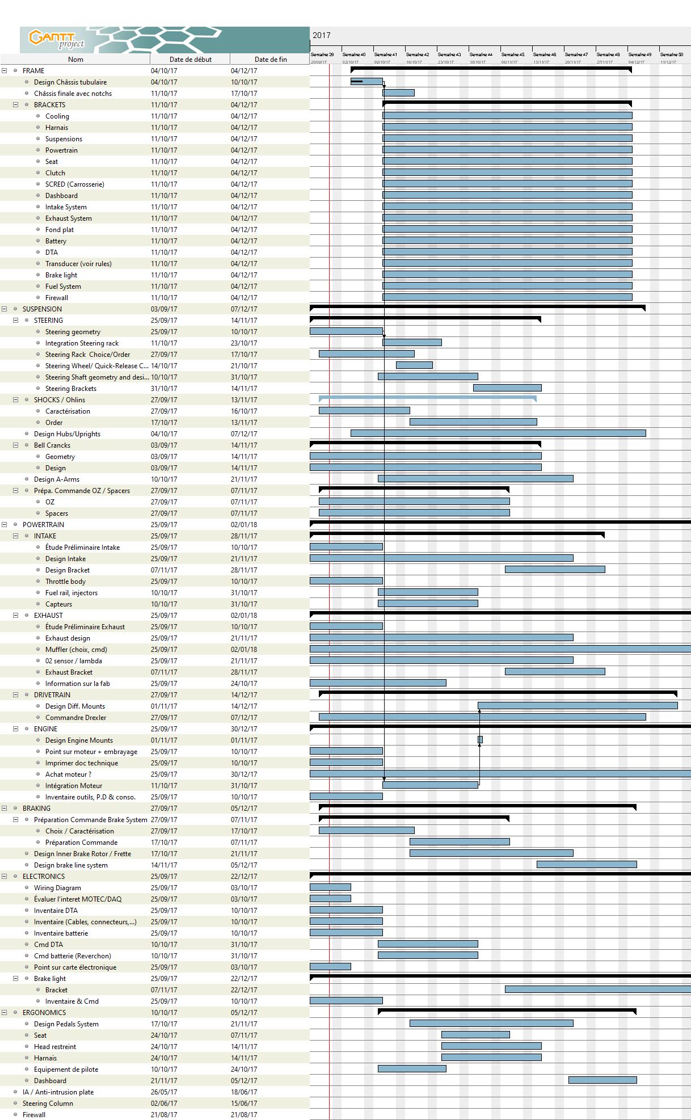
03_Gestion_De_Projet/01_Documents Organisation/2018_Vulcanix/Vulcanix.jpg
