EOSCogniton/Intergen/05_Documents_Competition/03_Inscription Competition/Exemples questionnaire/IMG_5175.JPG

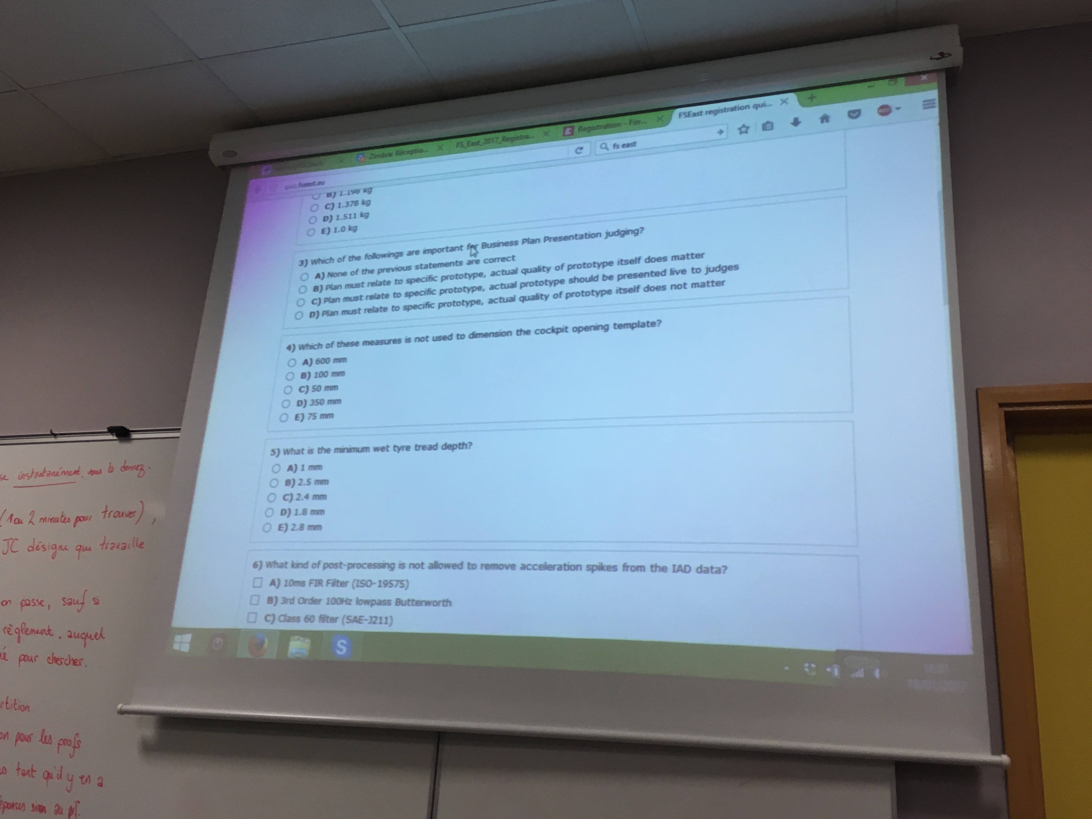
05_Documents_Competition/03_Inscription Competition/Exemples questionnaire/IMG_5175.JPG
