EOSCogniton/Intergen/08_Quizz_competition/Quizz_FSCZ_2019/Q1_aero.jpg

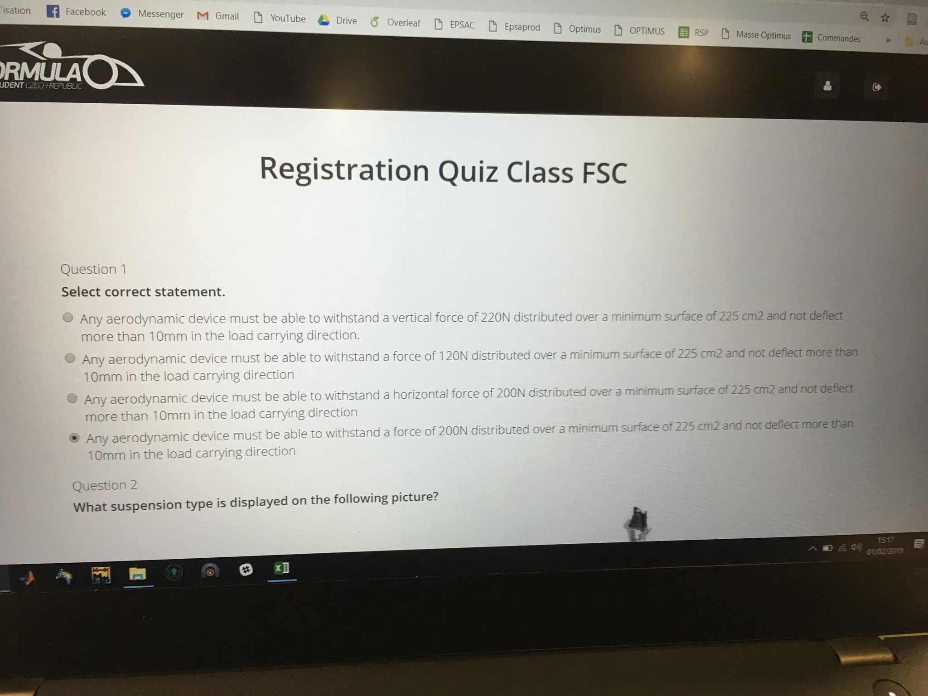
08_Quizz_competition/Quizz_FSCZ_2019/Q1_aero.jpg
