EOSCogniton/Intergen/08_Quizz_competition/Quizz_FSCZ_2019/Q2_suspension_type.jpg

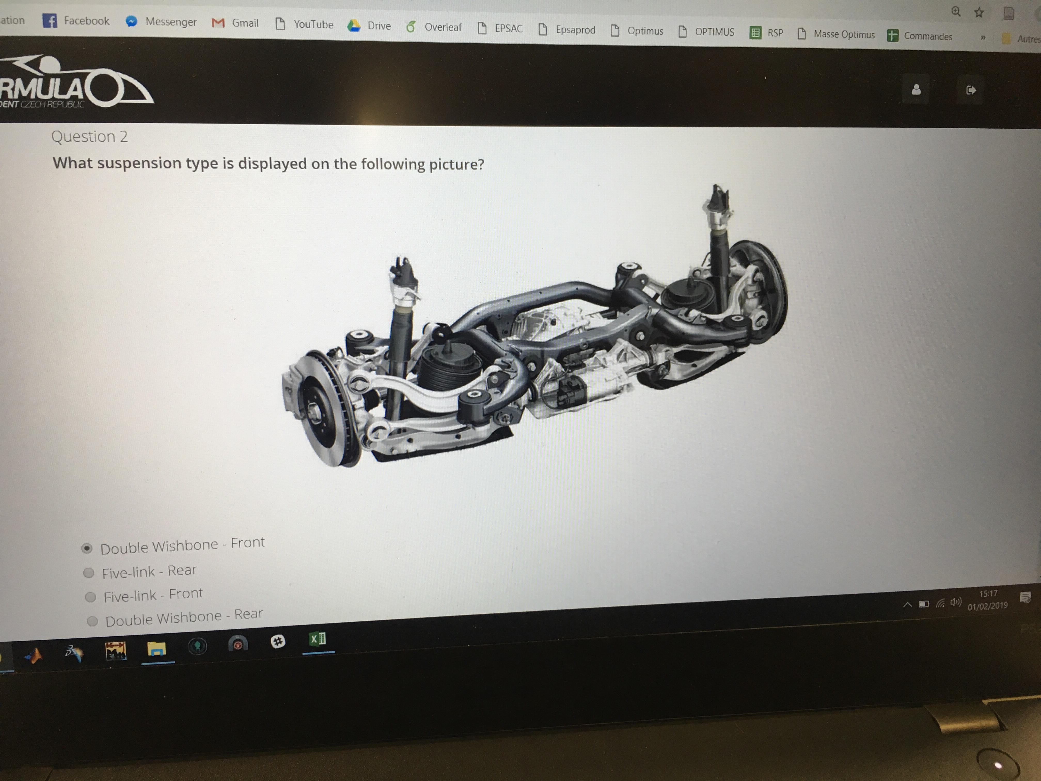
08_Quizz_competition/Quizz_FSCZ_2019/Q2_suspension_type.jpg
