EOSCogniton/Intergen/08_Quizz_competition/Quizz_FSCZ_2019/Q3_GearBox.jpg

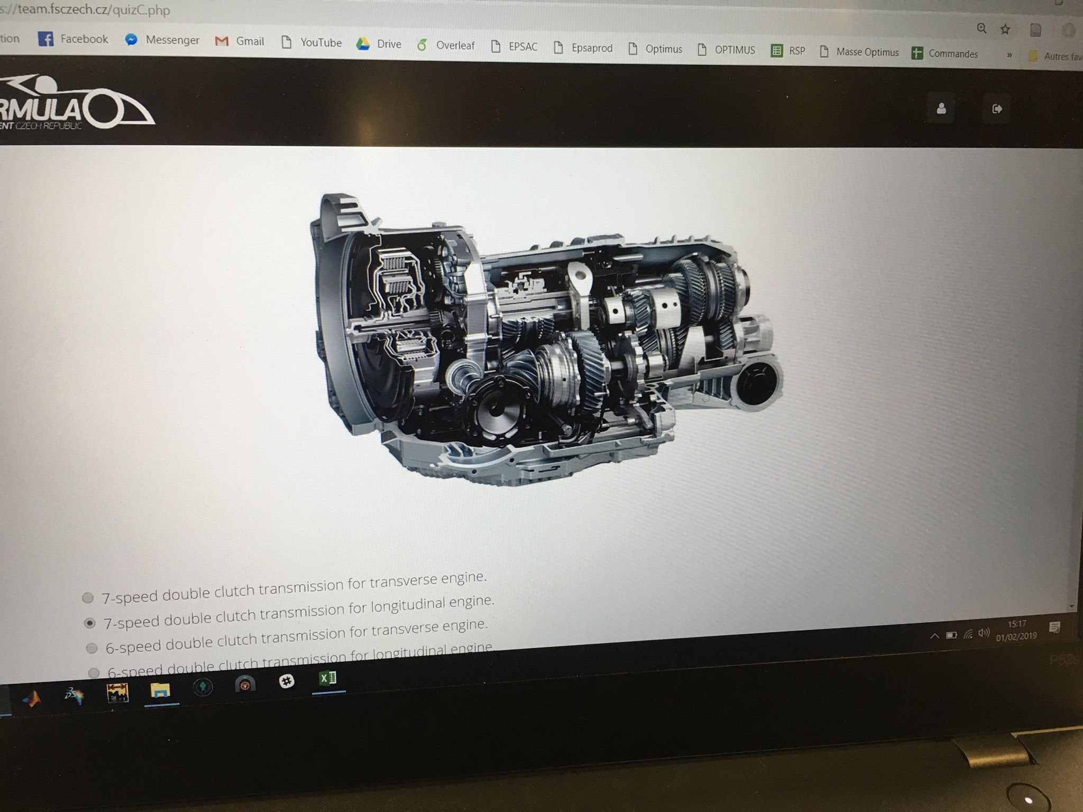
08_Quizz_competition/Quizz_FSCZ_2019/Q3_GearBox.jpg
