EOSCogniton/Intergen/08_Quizz_competition/Quizz_FSCZ_2019/Q4_5.JPG

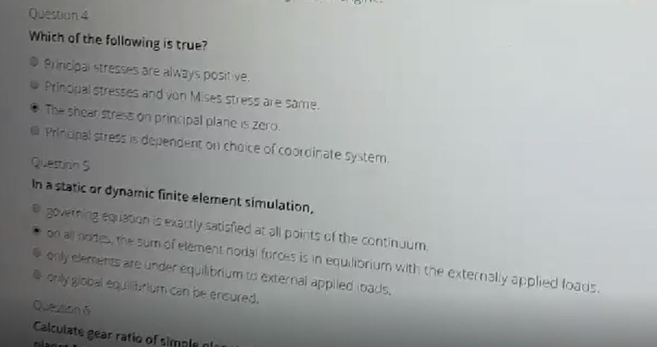
08_Quizz_competition/Quizz_FSCZ_2019/Q4_5.JPG
