EOSCogniton/Intergen/08_Quizz_competition/Quizz_FSCZ_2019/Q6.JPG

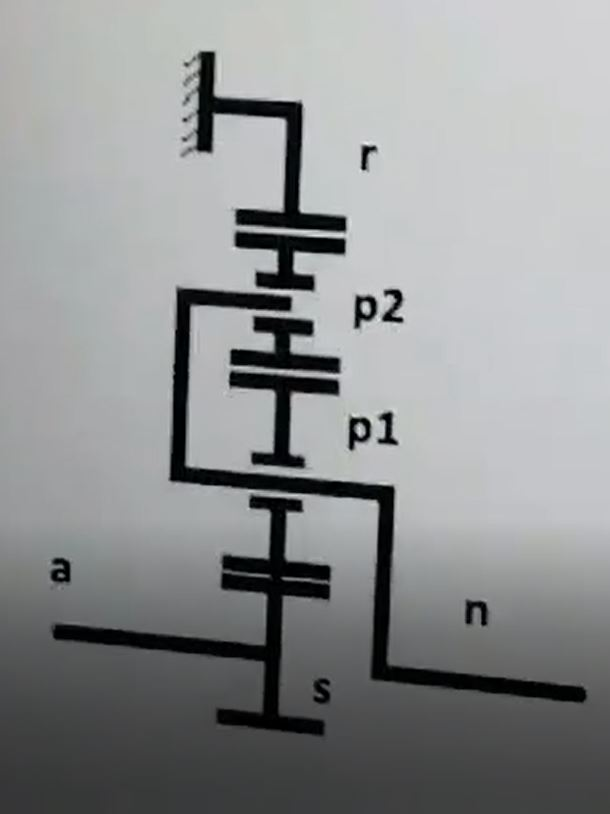
08_Quizz_competition/Quizz_FSCZ_2019/Q6.JPG
