EOSCogniton/Intergen/08_Quizz_competition/Quizz_FSCZ_2019/Q6_7.JPG

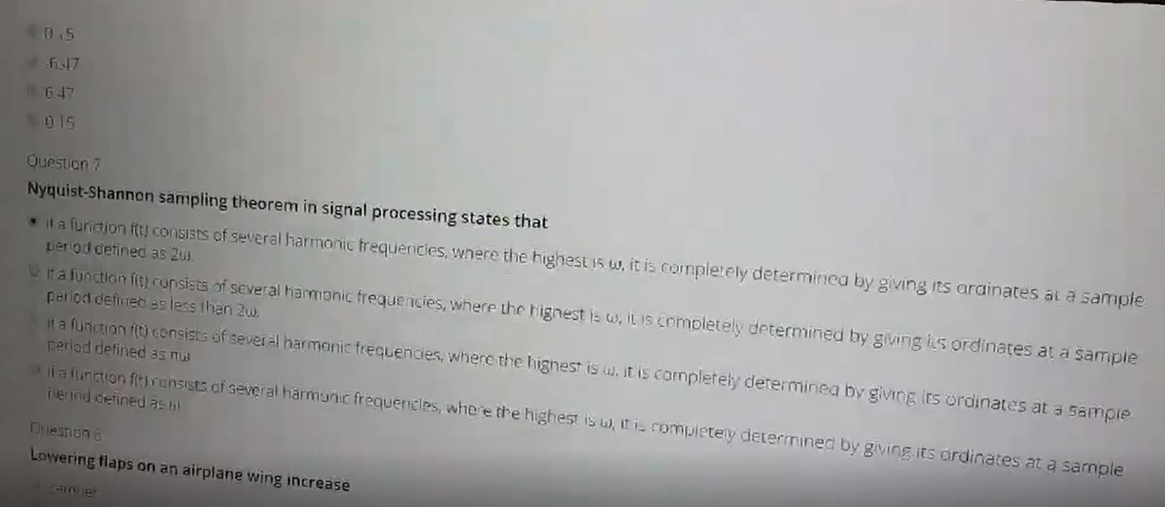
08_Quizz_competition/Quizz_FSCZ_2019/Q6_7.JPG
