EOSCogniton/Intergen/08_Quizz_competition/Quizz_FSCZ_2019/Q8_9_10.JPG

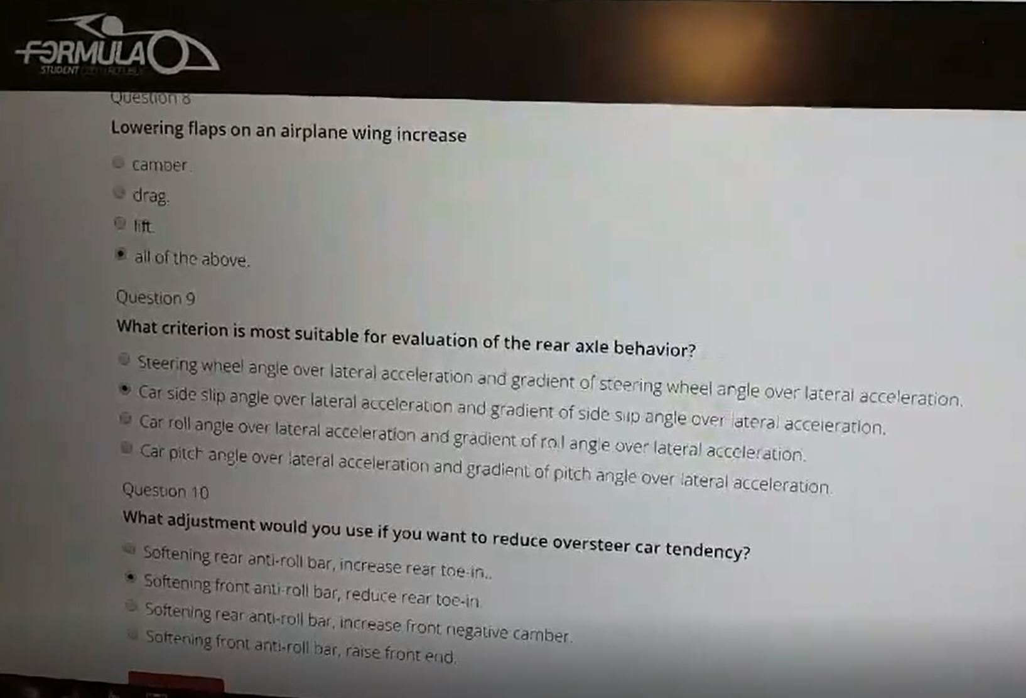
08_Quizz_competition/Quizz_FSCZ_2019/Q8_9_10.JPG
