EOSCogniton/Intergen/08_Quizz_competition/Quizz_FSG_2019/Q4_BusCAN.jpg

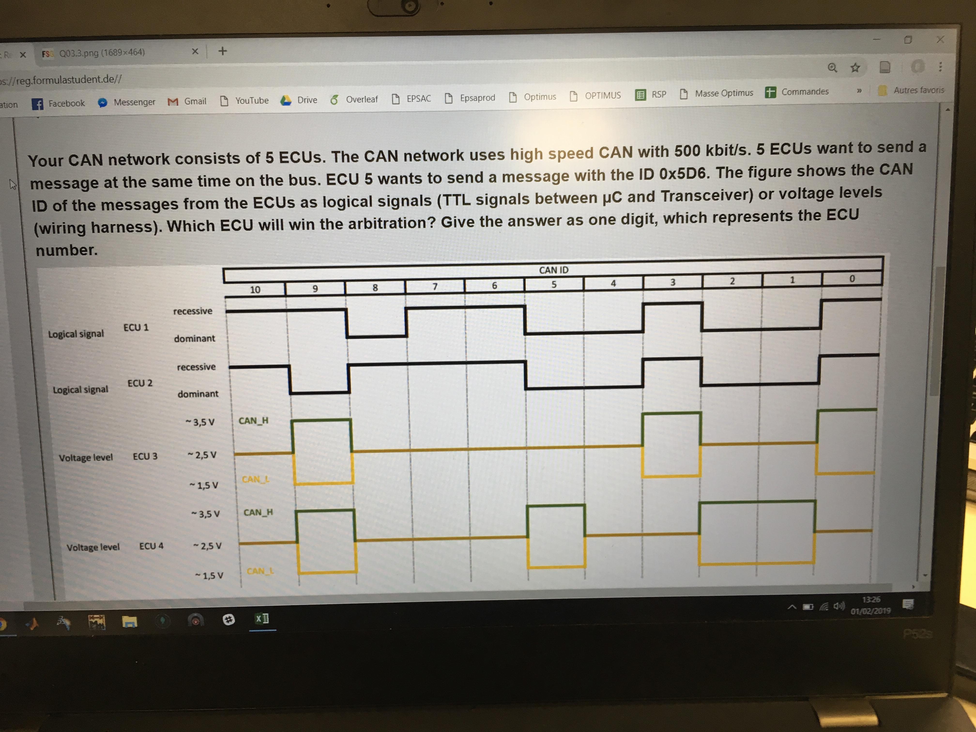
08_Quizz_competition/Quizz_FSG_2019/Q4_BusCAN.jpg
