EOSCogniton/Intergen/08_Quizz_competition/Quizz_FSG_2019/Q6_RDM.jpg

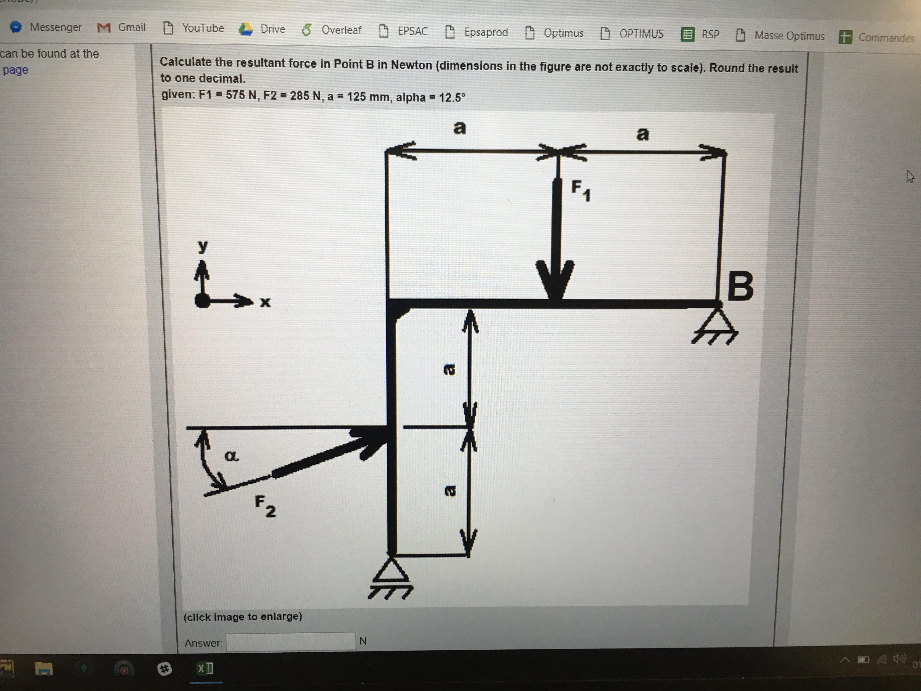
08_Quizz_competition/Quizz_FSG_2019/Q6_RDM.jpg
