EOSCogniton/Intergen/08_Quizz_competition/Quizz_FSG_2019/Q7_CdG.jpg

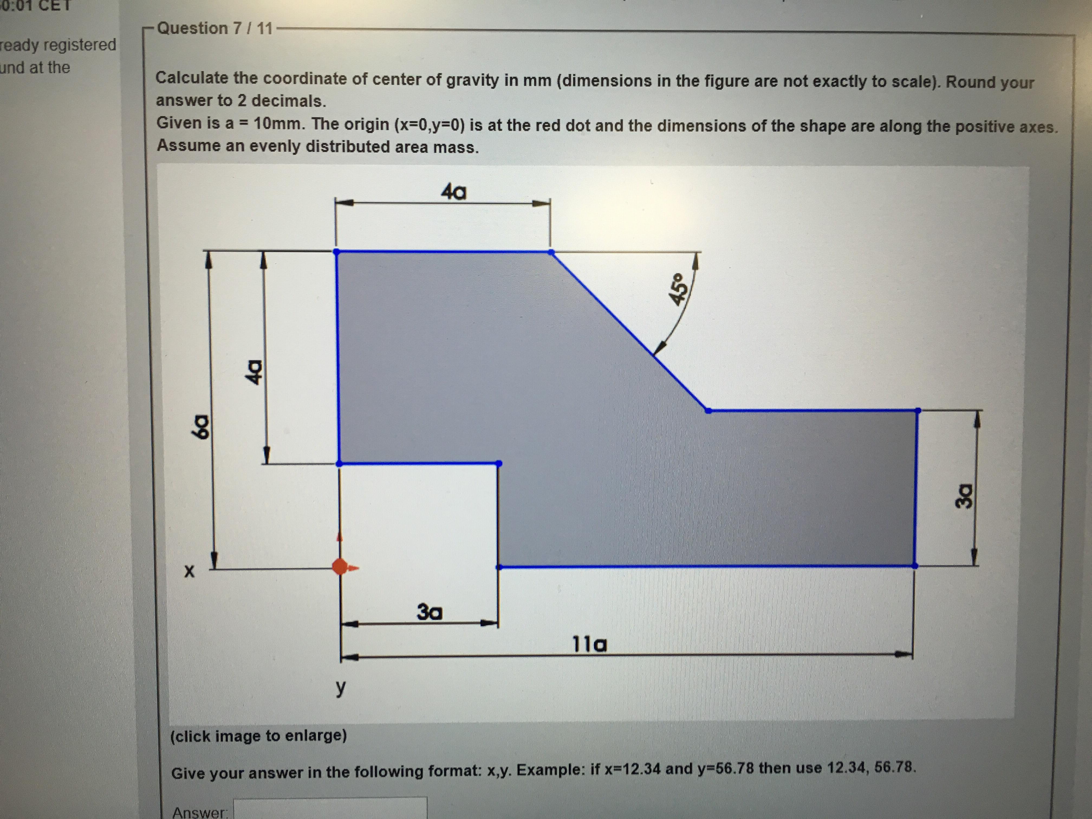
08_Quizz_competition/Quizz_FSG_2019/Q7_CdG.jpg
