EOSCogniton/Intergen/08_Quizz_competition/Quizz_FSG_2019/Q8_Ressorts_Frequences.jpg

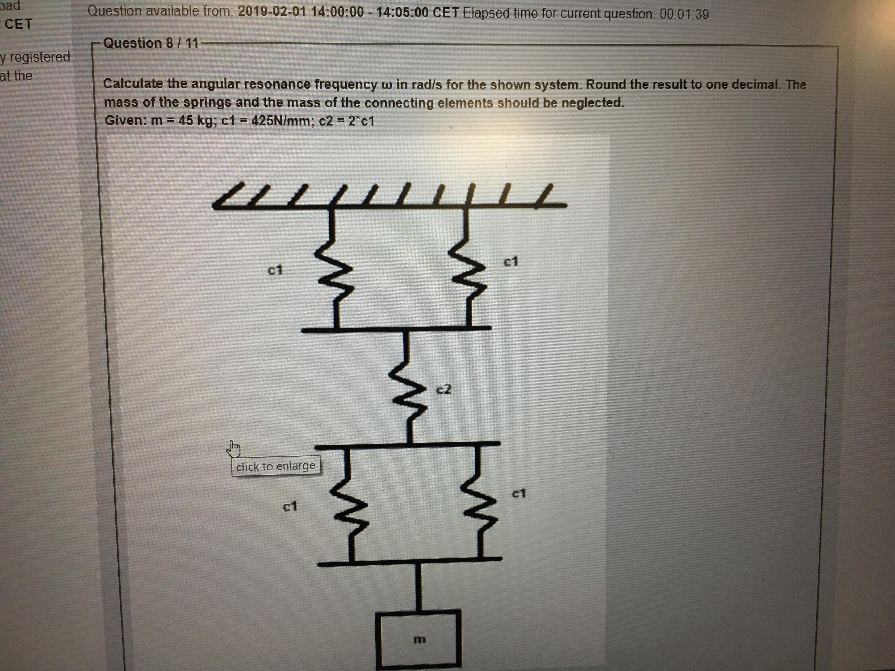
08_Quizz_competition/Quizz_FSG_2019/Q8_Ressorts_Frequences.jpg
