EOSCogniton/Intergen/08_Quizz_competition/Quizz_FSG_2019/Q9_Capacité.jpg

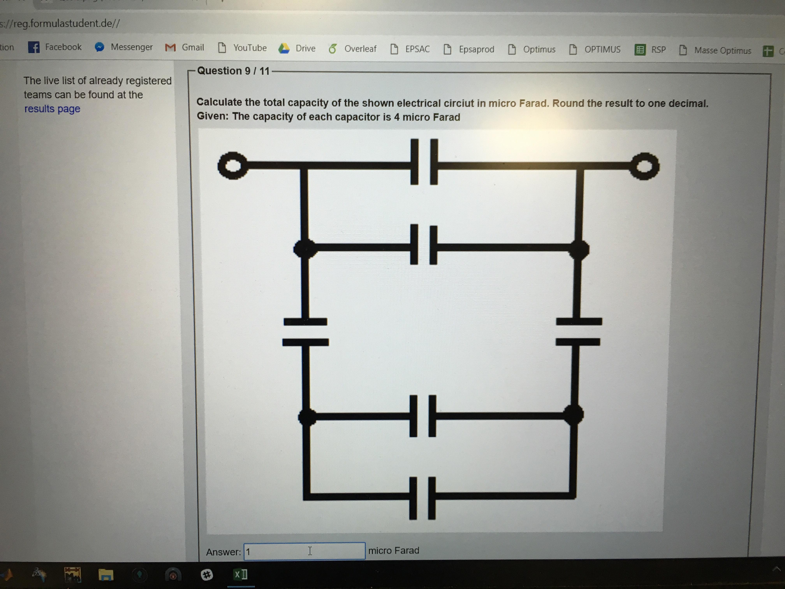
08_Quizz_competition/Quizz_FSG_2019/Q9_Capacité.jpg
