EOSCogniton/Intergen/08_Quizz_competition/Quizz_FSG_2019/Q11_Doppler.jpg

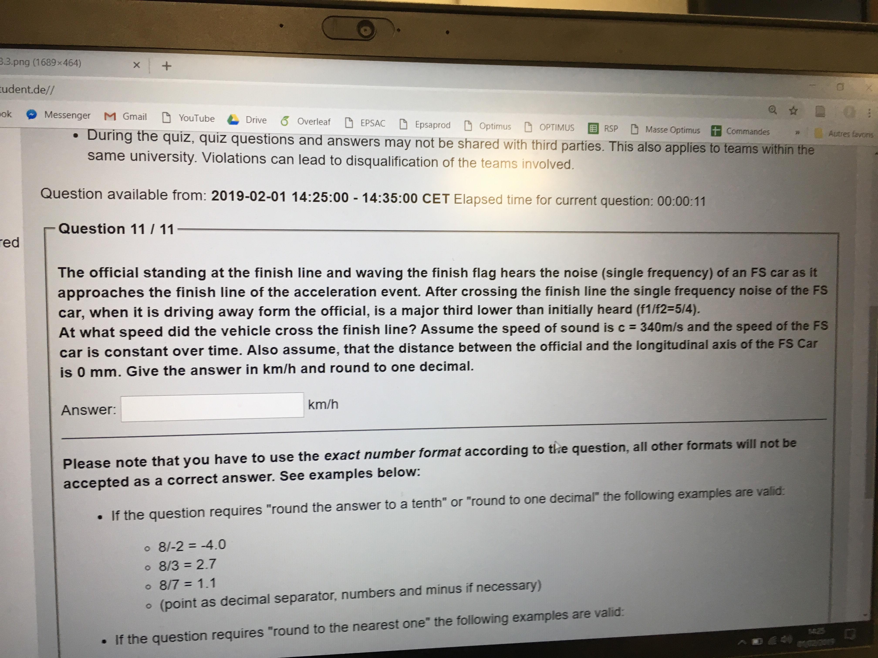
08_Quizz_competition/Quizz_FSG_2019/Q11_Doppler.jpg
