EOSCogniton/Intergen/08_Quizz_competition/Quizz_FSN_2019/Q3.jpg

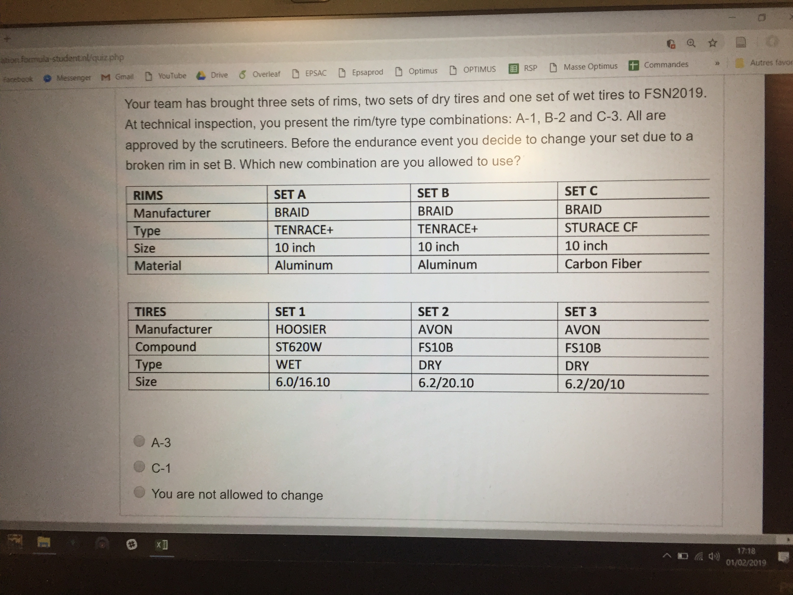
08_Quizz_competition/Quizz_FSN_2019/Q3.jpg
