EOSCogniton/Intergen/08_Quizz_competition/Quizz_FSN_2019/Q12.jpg

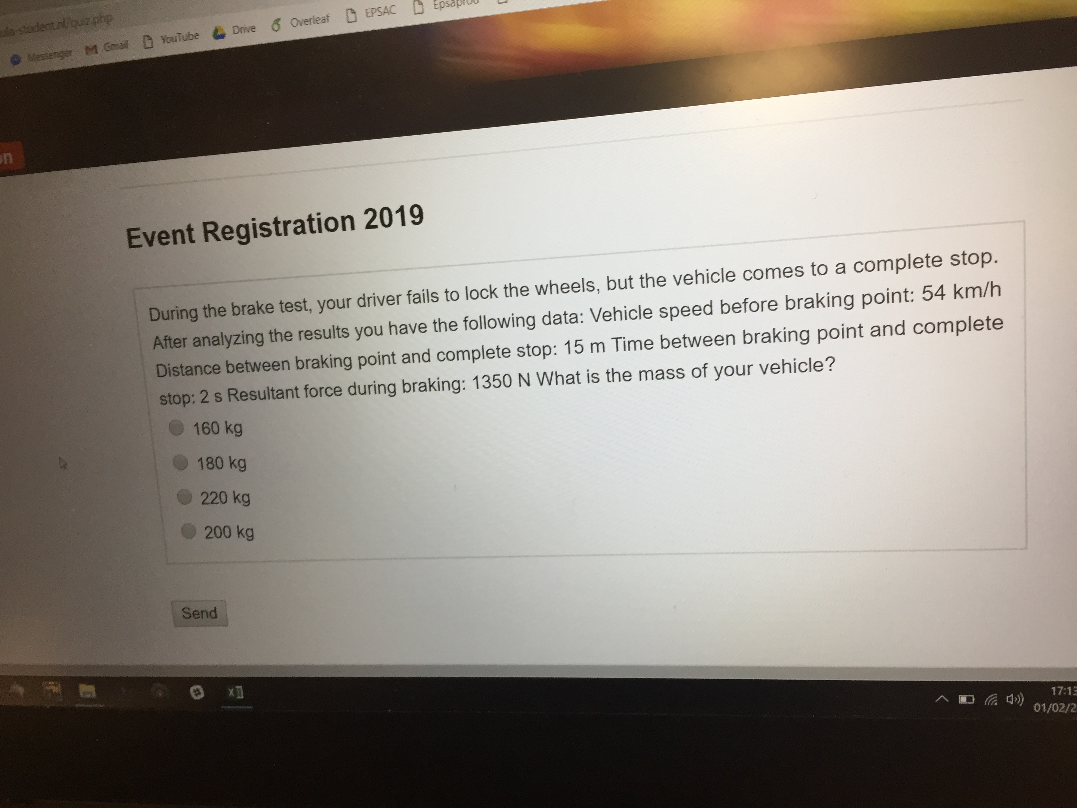
08_Quizz_competition/Quizz_FSN_2019/Q12.jpg
