EOSCogniton/Intergen/08_Quizz_competition/Quizz_FSS_2019/FSS3.PNG

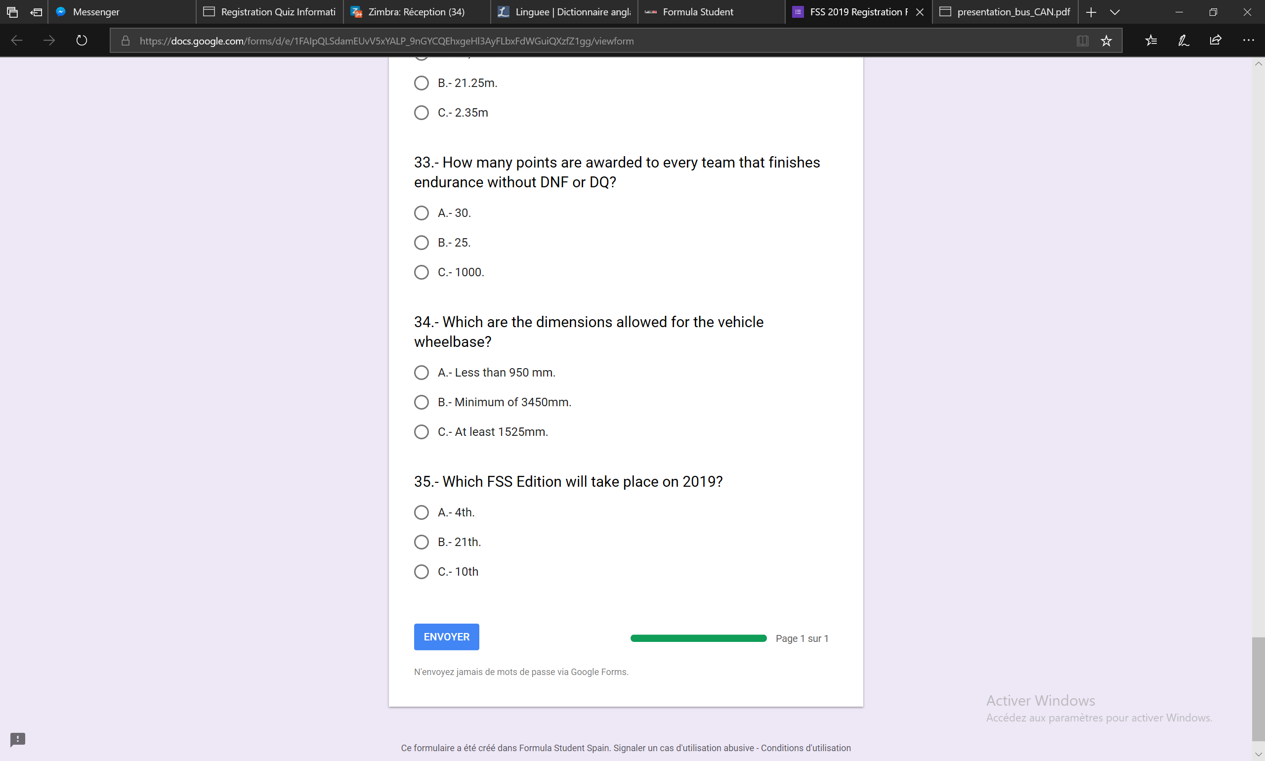
08_Quizz_competition/Quizz_FSS_2019/FSS3.PNG
