EOSCogniton/Intergen/05_Documents_Competition/Documents_Design_Vulcanix_2018/wetransfer-13cafa/Cost_Global_Vulcanix_v4_corrige_vrai-486-509.pdf

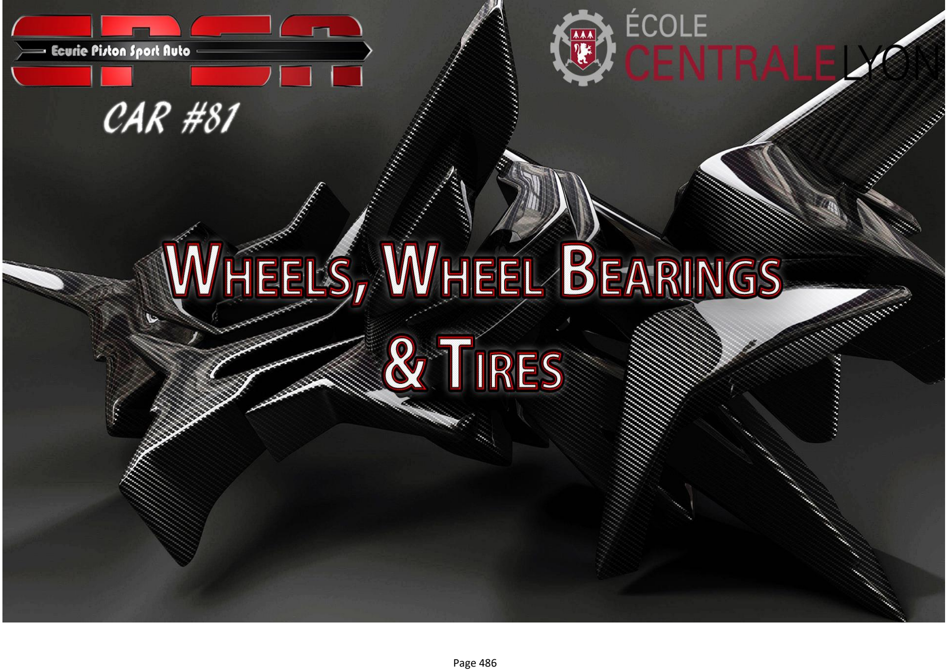
[picture p344: page 1]

University | Ecole Centrale de Lyon | Back to BOM | Car # | 81 | Asm Cost | $ 175,23
System | Wheels & Tires | | | | Qty | 4
Assembly | Wheel Assembly | | FileLink1
P/N Base | WT A0100 | FileLink2 | Extended Cost $ 700,92
Suffix | AA | | FileLink3
Details | Complete Wheel Assembly
ItemOrder | Material | Use | UnitCost | Size1 | Unit1 | Size2 | Unit2 | Area NameArea | Length | Density | Quantity | Sub Total
10 | Wheel, 13", 1 Piece OZ, Aluminum | Rim | $ 80,00 | | unit | | | | | | 1 | $ 80,00
20 | Tire, Hoosier, R25B, 13"-20.5 x 7.0 | Tire | $ 85,00 | | unit | | | | | | 1 | $ 85,00
30 | Valve Stem (and Tire Inflation) | | $ 1,00 | | unit | | | | | | 1 | $ 1,00
40 | Wheel Weights (and Balancing) | Balancing and set up the wheel | $ 4,00 | | unit | | | | | | 1 | $ 4,00
| | | | | | | | | | | Sub Total | $ 170,00

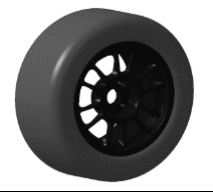
[picture p345: figure]

ItemOrder | Process | Use | UnitCost | Unit | Quantity | Multiplier | Mult. Val. | Sub Total
10 | Assemble, 5kg, Line-on-Line | Fix Wheel on Hubs | $ 0,63 | unit | 1 | | 1 | $ 0,63
20 | Ratchet <= 25.4 mm | Tighten Lug Nuts | $ 0,75 | unit | 4 | | 1 | $ 3,00
| | | | | | | Sub Total | $ 3,63
ItemOrder | Fastener | Use | UnitCost | Size1 | Unit1 | Size2 | Unit2 | Quantity | Sub Total
10 | Nut, Lug | Fix Wheel on Hubs | $ 0,40 | | unit | | | 4 | $ 1,60
| | | | | | | | Sub Total | $ 1,60

University | Ecole Centrale de Lyon | Back to BOM | Car # | 81 | Asm Cost | $ | 346,18
System | Wheels & Tires | | | | Qty | | 2
Assembly | Front Hubs | | FileLink1
P/N Base | WT A0200 | FileLink2 | Extended Cost $ | 692,35
Suffix | AA | | FileLink3
Details | Assembly of a part of the wheel with the hub, bearings and a part to mesure the speed of the wheel
ItemOrder Part | | Part Cost | Quantity | Sub Total
10 | Front Hub | $ 63,51 | 1 | $ 63,51
20 | Front Bearing Spacer | $ 2,62 | 1 | $ 2,62
30 | Front Wheel Spacer | $ 20,03 | 1 | $ 20,03
40 | Speed Sensor Spacer | $ 0,95 | 1 | $ 0,95
50 | Speed Sensor Disc | $ 9,71 | 1 | $ 9,71
| | | Sub Total | $ 96,81
ItemOrder Material | | Use | UnitCost | Size1 | Unit1 | Size2 | Unit2 | Area NameArea | Length | Density | Quantity | Sub Total
10 | Wheel Bearing, Ball, Angular Contact | | $ 118,75 | 72 | mm | 17 | mm | | | | 2 | $ 237,49
20 | Locknut/L.P.///Steel/ | Bearing Nuts | $ 5,98 | 35 | mm | | | | | | 1 | $ 5,98
30 | Adhesive | Wheel studs and hub assemble, cost included in process | $ - | | | | | | | | | $ -
| | | | | | | | | | | Sub Total | $ 243,47
ItemOrder Process | | Use | UnitCost | Unit | Quantity | Multiplier | Mult. Val. | Sub Total
10 | Assemble, 1kg, Loose | Bearing spacer assemble on the hub | $ 0,06 | unit | 1 | | 1 | $ 0,06
20 | Assemble, 1 kg, Interference | Bearings Assemble | $ 0,19 | unit | 2 | | 1 | $ 0,38
30 | Assemble, 1kg, Loose | Speed sensor spacer assemble on the hub | $ 0,06 | unit | 1 | | 1 | $ 0,06
40 | Assemble, 1kg, Loose | Speed sensor disc assemble on the hub | $ 0,06 | unit | 1 | | 1 | $ 0,06
50 | Assemble, 1kg, Loose | Lock nut washer assemble on the hub | $ 0,06 | unit | 1 | | 1 | $ 0,06
80 | Assemble, 1 kg, Line-on-Line | Locknut on hub | $ 0,13 | Unit | 1 | | 1 | $ 0,13
60 | Liquid Applicator Gun | Wheel studs and hub assemble | $ 0,02 | cm | 15,07 | | 1 | $ 0,30
70 | Assemble, 1 kg, Line-on-Line | Wheel studs and hub assemble | $ 0,13 | unit | 4 | | 1 | $ 0,52
80 | Assemble, 1 kg, Loose | Front Wheel Spacer on hub | $ 0,06 | Unit | 1 | | 1 | $ 0,06
| | | | | | | Sub Total | $ 1,63
ItemOrder Fastener | | Use | UnitCost | Size1 | Unit1 | Size2 | Unit2 | Quantity | Sub Total
10 | Stud, Grade 12.9 | Wheel Studs | $ 1,07 | 12 | mm | 62 | mm | 4 | $ 4,26
| | | | | | | | Sub Total | $ 4,26

University | Ecole Centrale de Lyon | Back to BOM | Car # | 81 | Part Cost | $ | 63,51
System | Wheels & Tires | FileLink1 | Drawing | Qty | 1
Assembly | Front Hubs | FileLink2 | FileLink1
Part | Front Hub | FileLink3 | FileLink2 | Extended Cost $ | 63,51
P/N Base | WT 02001 | | FileLink3
Suffix | AA
Details | Main part of the assembly
ItemOrder Material | | Use | UnitCost | Size1 | Unit1 | Size2 | Unit2 | Area Name | Area | Length | Density | Quantity | Sub Total
10 | Aluminium, Premium | | $ 4,20 | 3,27 | kg | | | round area, 130mm diameter | 0,013 | 0,091 | 2712 | 1 | $ 13,75
| | | | | | | | | | | | Sub Total | $ 13,75

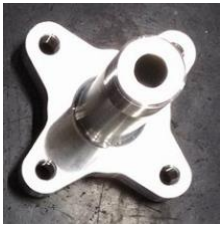
[picture p346: figure]

ItemOrder Process | | Use | UnitCost | Unit | Quantity | Multiplier | Mult. Val. | Sub Total
10 | Machining Setup, Install and Remove | Setup for turning | $ 1,30 | Unit | 1 | | 1 | $ 1,30
20 | Machining | Turning | $ 0,04 | cm^3 | 930,6 | Material - Aluminium | 1 | $ 37,22
30 | Machining Setup, Change | Change the turning setup | $ 0,65 | Unit | 1 | | 1 | $ 0,65
40 | Machining | Turning | $ 0,04 | cm^3 | 63,5 | Material - Aluminium | 1 | $ 2,54
50 | Machining Setup, Change | | $ 0,65 | Unit | 1 | | 1 | $ 0,65
60 | Machining | Milling | $ 0,04 | cm^3 | 149 | Material - Aluminium | 1 | $ 5,96
70 | Machining Setup, Change | | $ 0,65 | Unit | 1 | | 1 | $ 0,65
80 | Machining | Milling | $ 0,04 | cm^3 | 0,336 | Material - Aluminium | 1 | $ 0,01
90 | Threading, Internal (machining) | For wheel studs | $ 0,10 | cm | 6 | Material - Aluminium | 1 | $ 0,60
100 | Threading, External (machining) | For locknut | $ 0,10 | cm | 1,7 | Material - Aluminium | 1 | $ 0,17
| | | | | | | Sub Total | $ 49,76

### Drawing part : WT 02001

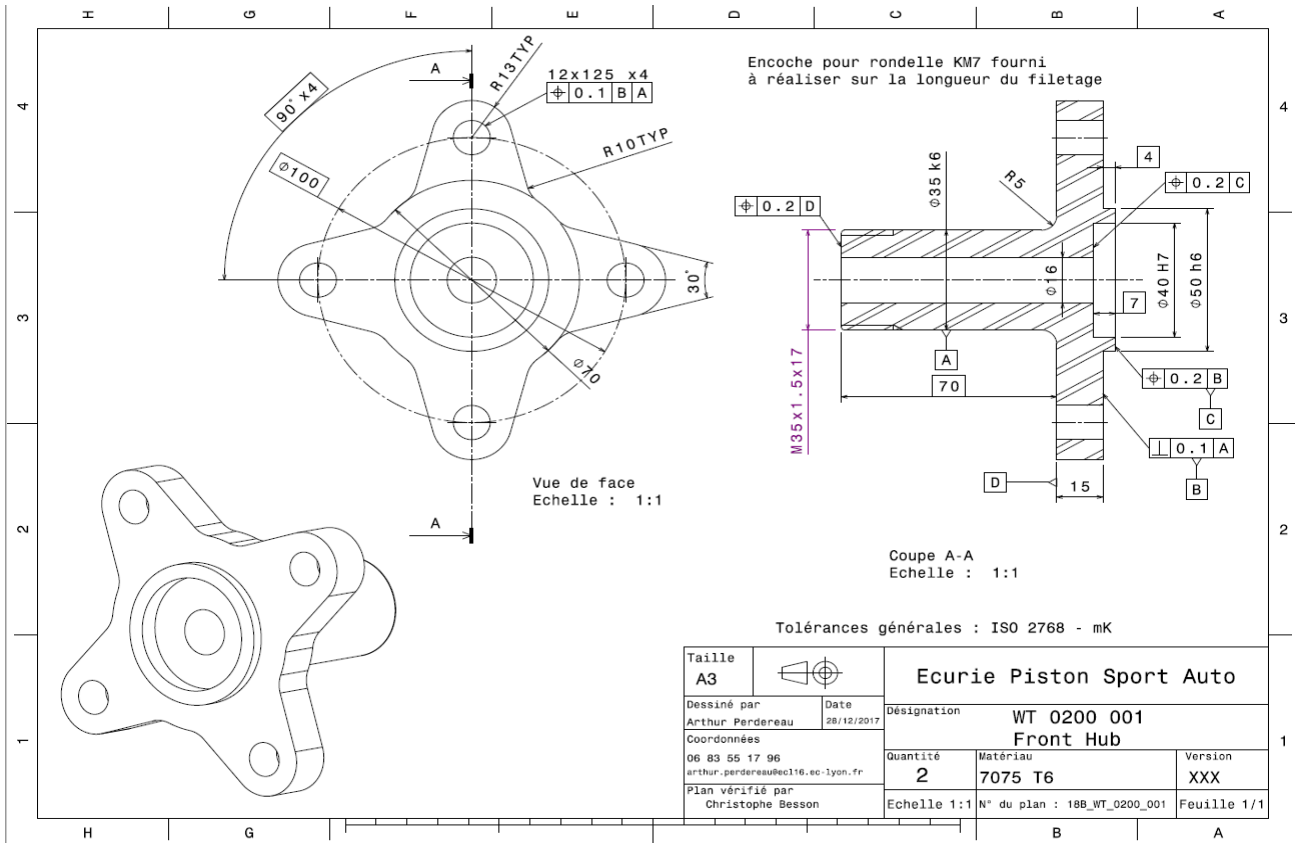
[picture p347: figure]

University | Ecole Centrale de Lyon | Back to BOM | Car # | 81 | Part Cost | $ | 2,62
System | Wheels & Tires | FileLink1 | Drawing | Qty | 1
Assembly | Front Hubs | FileLink2 | FileLink1
Part | Wheel bearing spacer | FileLink3 | FileLink2 | Extended Cost $ | 2,62
P/N Base | WT 02002 | | FileLink3
Suffix | AA
Details | Part to let a space beetween the hub and the first bearing

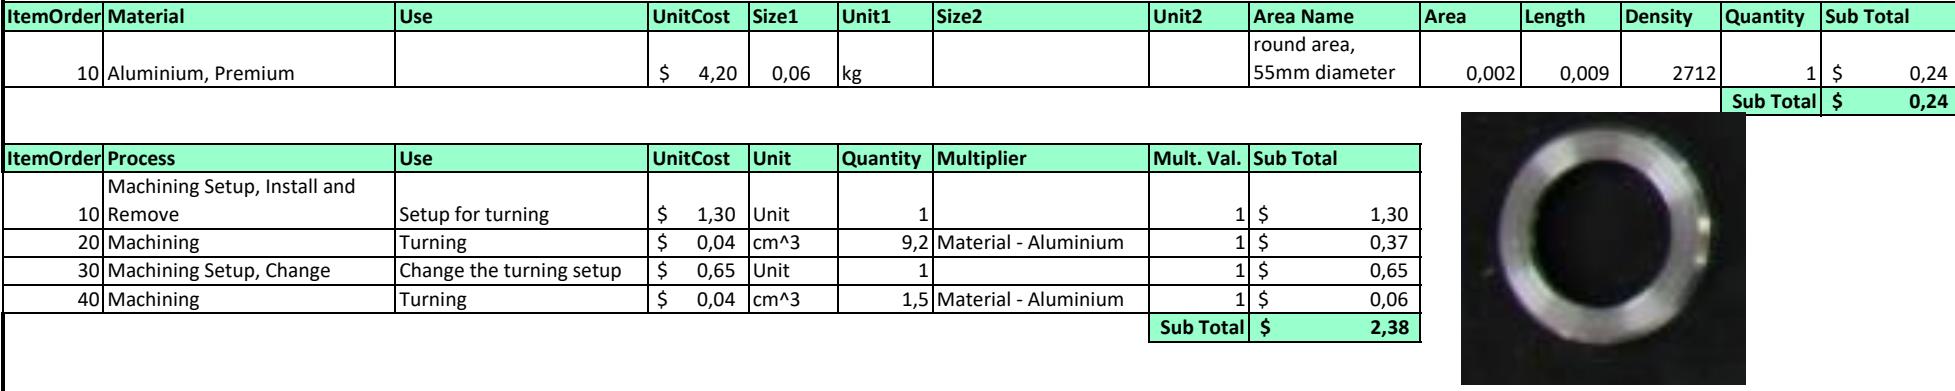
[picture p348: figure]
ItemOrder Material; Use; UnitCost; Size1; Unit1; Size2; Unit2; Area Name; Area; Length; Density; Quantity; Sub Total; Aluminium, Premium; round area, 55mm diameter; ItemOrder Process; Unit; Multiplier; Mult. Val.; Machining Setup, Install and Remove; Setup for turning; Machining; Turning; Material - Aluminium; Machining Setup, Change; Change the turning setup

### Drawing part : WT_02002

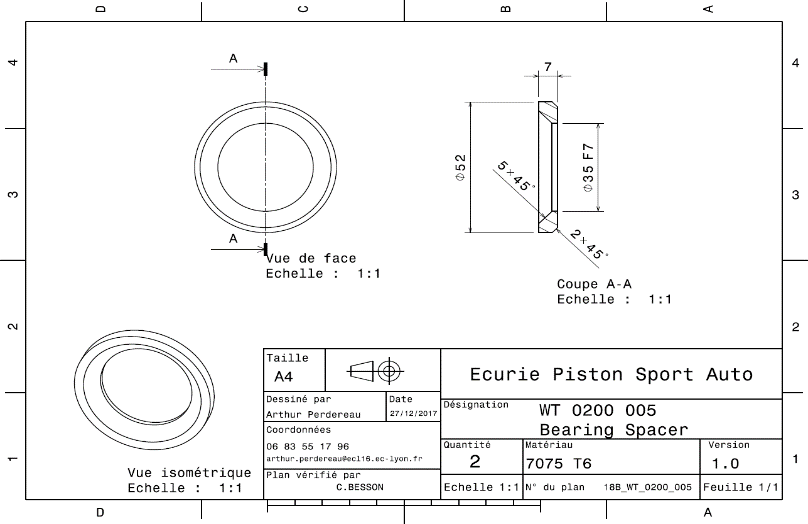
[picture p349: figure]

University | Ecole Centrale de Lyon | Back to BOM | Car # | 81 | Part Cost | $ | 20,03
System | Wheels & Tires | FileLink1 | Drawing | Qty | 1
Assembly | Front Hubs | FileLink2 | FileLink1
Part | Front Wheel Spacer | FileLink3 | FileLink2 | Extended Cost $ | 20,03
P/N Base | WT 02003 | | FileLink3
Suffix | AA
Details | Part to position the wheel on the good position relative to the hub and upright assembly
ItemOrder | Material | Use | UnitCost | Size1 | Unit1 | Size2 | Unit2 | Area Name | Area | Length | Density | Quantity | Sub Total
10 | Aluminium, Premium | | $ 4,20 | 0,86 | kg | | | round area, 130mm diameter | 0,013 | 0,024 | 2712 | 1 | $ 3,63
| | | | | | | | | | | | Sub Total | $ 3,63

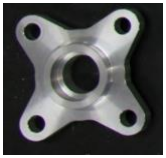
[picture p350: figure]

ItemOrder | Process | Use | UnitCost | Unit | Quantity | Multiplier | Mult. Val. | Sub Total
10 | Machining Setup, Install and Remove | Setup for turning | $ 1,30 | Unit | 1 | | 1 | $ 1,30
20 | Machining | Turning | $ 0,04 | cm^3 | 112 | Material - Aluminium | 1 | $ 4,48
30 | Machining Setup, Change | Change the turning setup | $ 0,65 | Unit | 1 | | 1 | $ 0,65
40 | Machining | Turning | $ 0,04 | cm^3 | 84 | Material - Aluminium | 1 | $ 3,36
50 | Machining Setup, Change | | $ 0,65 | Unit | 1 | | 1 | $ 0,65
60 | Machining | Milling | $ 0,04 | cm^3 | 149 | Material - Aluminium | 1 | $ 5,96
| | | | | | | Sub Total | $ 16,40

### Drawing part : WT_02003

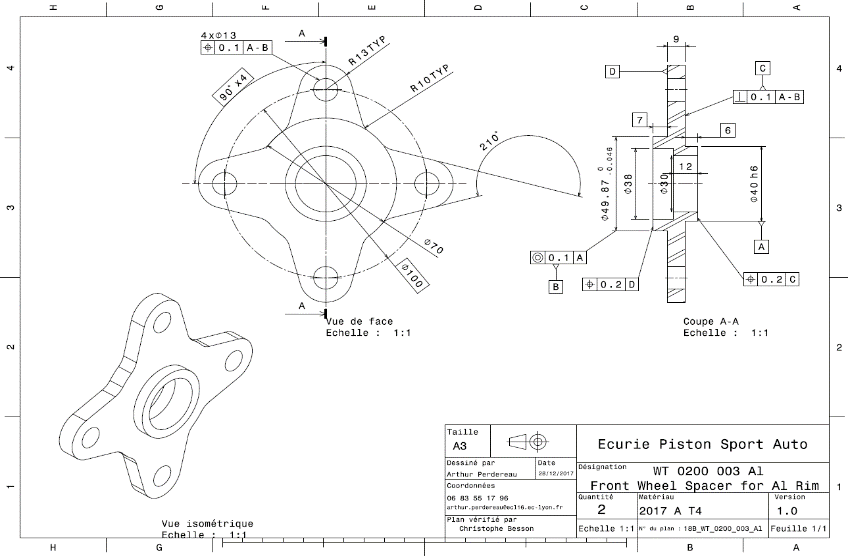
[picture p351: figure]

University | Ecole Centrale de Lyon | Back to BOM | Car # | 81 | Part Cost | $ | 0,95
System | Wheels & Tires | FileLink1 | Drawing | Qty | 1
Assembly | Front Hubs | FileLink2 | FileLink1
Part | Speed sensor spacer | FileLink3 | FileLink2 | Extended Cost $ | 0,95
P/N Base | WT 02004 | | FileLink3
Suffix | AA
Details | Part to avoid the speed sensor disc to interfere with the Upright
ItemOrder Material | | Use | UnitCost | Size1 | Unit1 | Size2 | Unit2 | Area Name | Area | Length | Density | Quantity | Sub Total
10 | Aluminum, Normal | | $ 4,20 | 0,011 | kg | | | Square area 45x45mm | 0,002 | 0,002 | 2712 | 1 | $ 0,05
| | | | | | | | | | | | Sub Total | $ 0,05
ItemOrder Process | | Use | UnitCost | Unit | Quantity | Multiplier | Mult. Val. | Sub Total
10 | Machining Setup, Install and Remove | Setup for turning | $ 1,30 | Unit | 1 | one setup for 2 pieces | 0,5 | $ 0,65
20 | Laser cut | | $ 0,01 | cm | 25,4 | | 1 | $ 0,25
| | | | | | | Sub Total | $ 0,90

### Drawing part : WT_02004

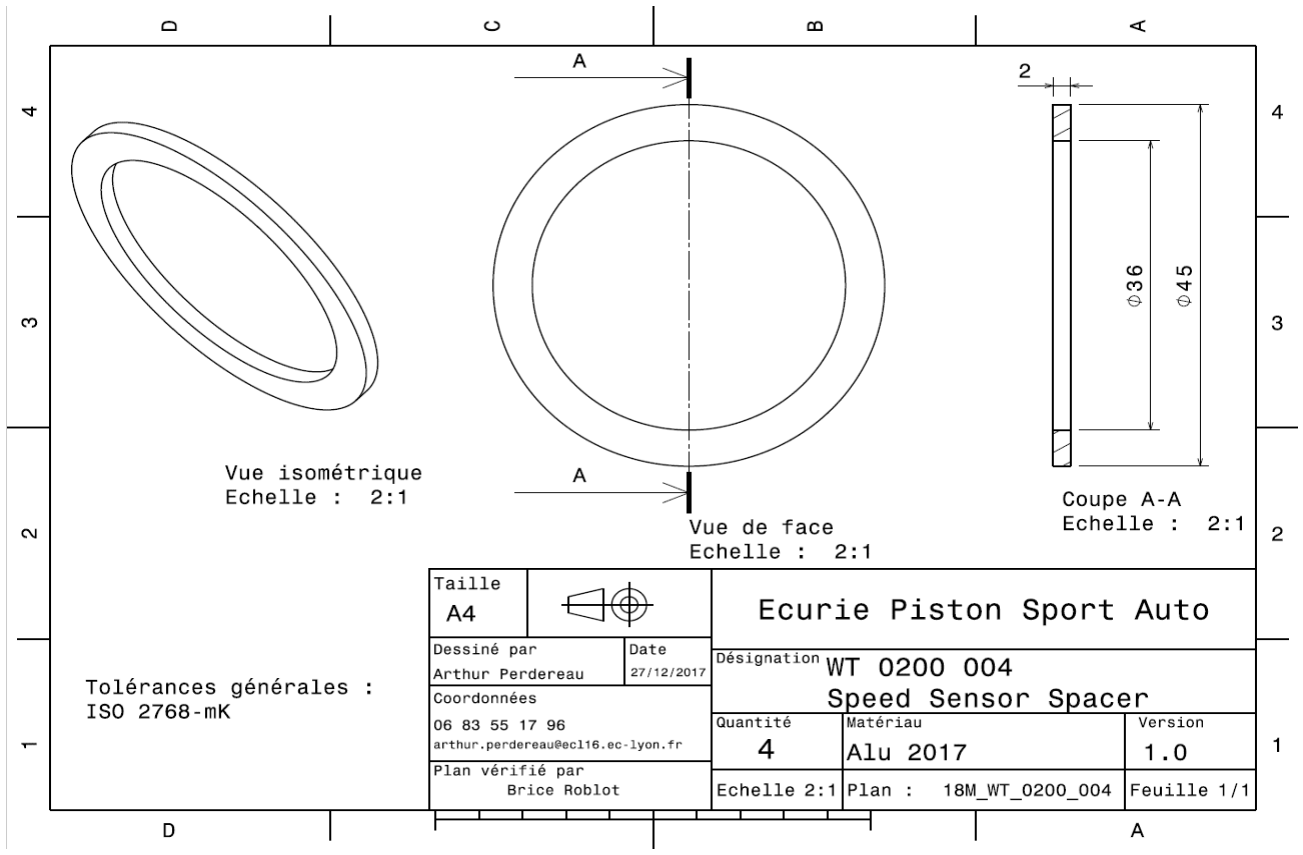
[picture p352: figure]

University | Ecole Centrale de Lyon | Back to BOM | Car # | 81 | Part Cost | $ | 9,71
System | Wheels & Tires | FileLink1 | Drawing | Qty | 1
Assembly | Front Hubs | FileLink2 | FileLink1
Part | Speed Sensor Disc | FileLink3 | FileLink2 | Extended Cost $ | 9,71
P/N Base | WT 02005 | | FileLink3
Suffix | AA
Details | Disc use in combination with a sensor to obtain the speed of a wheel
ItemOrder | Material | Use | UnitCost | Size1 | Unit1 | Size2 | Unit2 | Area Name | Area | Length | Density | Quantity | Sub Total
10 | Steel, Mild | | $ 2,25 | 0,20 | kg | | | rectangular area, 160mm*160mm | 0,026 | 0,001 | 7 850 | 1,00 | $ 0,45
| | | | | | | | | | | | Sub Total | $ 0,45
ItemOrder | Process | Use | UnitCost | Unit | Quantity | Multiplier | Mult. Val. | Sub Total
10 | Machining Setup, Install and Remove | Setup for turning | $ 1,30 | Unit | 1 | one setup for 2 pieces | 0,5 | $ 0,65
20 | Laser cut | | $ 0,01 | cm | 286,8 | Material -steel | 3 | $ 8,60
| | | | | | | Sub Total | $ 9,25

### Drawing part : WT_02005

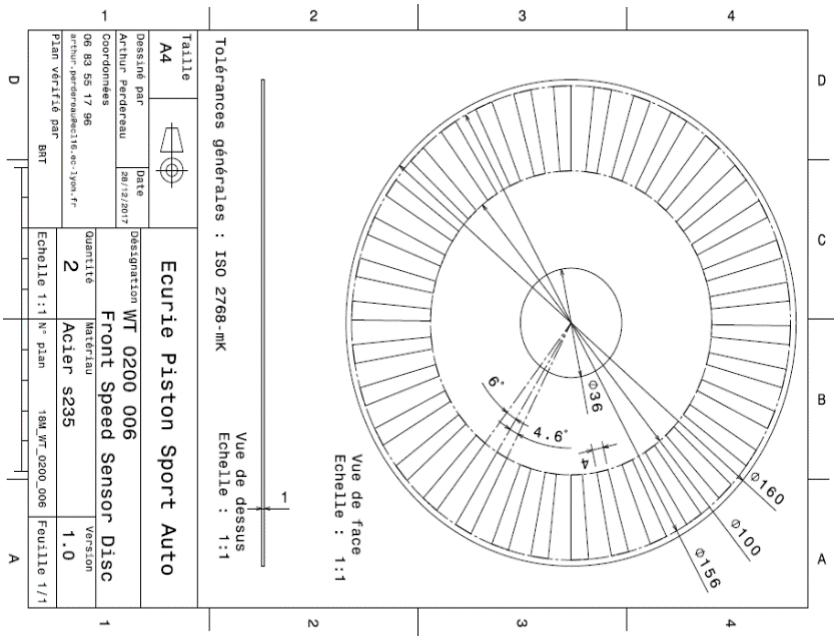
[picture p353: figure]

University | Ecole Centrale de Lyon | Back to BOM | Car # | 81 | Asm Cost | $ 346,18
System | Wheels & Tires | | | | Qty | 2
Assembly | Rear Hubs | | FileLink1
P/N Base | WT A0300 | FileLink2 | Extended Cost $ 692,35
Suffix | AA | | FileLink3
Details | Assembly of a part of the wheel with the hub, bearings and a part to mesure the speed of the wheel
ItemOrder Part | | Part Cost | Quantity | Sub Total
10 | Rear Hub | $ 52,08 | 1 | $ 52,08
20 | Rear Bearing Spacer | $ 3,97 | 1 | $ 3,97
30 | Rear Wheel Spacer | $ 21,67 | 1 | $ 21,67
40 | Tripod Housing Spacer | $ 3,90 | 1 | $ 3,90
50 | Speed Sensor Disc | $ 7,69 | 1 | $ 7,69
| | | Sub Total | $ 89,31
ItemOrder Material | | Use | UnitCost | Size1 | Unit1 | Size2 | Unit2 | Area NameArea | Length | Density | Quantity | Sub Total
10 | Wheel Bearing, Ball, Angular Contact | | $ 99,77 | 72 | mm | 12 | mm | | | | 2,00 | $ 199,53
20 | Adhesive | Wheel studs and hub assemble, cost included in process | $ - | | | | | | | | | $ -
| | | | | | | | | | | Sub Total | $ 199,53
ItemOrder Process | | Use | UnitCost | Unit | Quantity | Multiplier | Mult. Val. | Sub Total
10 | Assemble, 1kg, Loose | Bearing spacer assemble on the hub | $ 0,06 | unit | 1 | | 1 | $ 0,06
20 | Assemble, 1 kg, Interference | Bearings Assemble | $ 0,19 | unit | 2 | | 1 | $ 0,38
30 | Assemble, 1kg, Loose | Tripod housing spacer assemble on the hub | $ 0,06 | unit | 1 | | 1 | $ 0,06
40 | Assemble, 1kg, Loose | Speed sensor disc assemble on the hub | $ 0,06 | unit | 1 | | 1 | $ 0,06
50 | Liquid Applicator Gun | Wheel studs and hub assemble | $ 0,02 | cm | 15,07 | | 1 | $ 0,30
60 | Assemble, 1 kg, Line-on-Line | Wheel studs and hub assemble | $ 0,13 | unit | 4 | | 1 | $ 0,52
70 | Assemble, 1 kg, Loose | Front Wheel Spacer on hub | $ | 0,06 | Unit | 1 | 1 | $ | 0,06
| | | | | | | Sub Total | $ | 1,44
ItemOrder Fastener | | Use | UnitCost | Size1 | Unit1 | Size2 | Unit2 | Quantity | Sub Total
10 | Stud, Grade 12.9 | Wheel Studs | $ 1,07 | 12 | mm | 62 | mm | 4 | $ 4,26
| | | | | | | | Sub Total | $ 4,26

University | Ecole Centrale de Lyon | Back to BOM | Car # | 81 | Part Cost | $ | 52,08
System | Wheels & Tires | FileLink1 | Drawing | Qty | 1
Assembly | Rear Hubs | FileLink2 | FileLink1
Part | Rear Hub | FileLink3 | FileLink2 | Extended Cost $ | 52,08
P/N Base | WT 03001 | | FileLink3
Suffix | AA
Details | Main part of the assembly
ItemOrder | Material | Use | UnitCost | Size1 | Unit1 | Size2 | Unit2 | Area Name | Area | Length | Density | Quantity | Sub Total
10 | Aluminium, Premium | | $ 4,20 | 2,87 | kg | | | round area, 130mm diameter | 0,013 | 0,080 | 2712 | 1 | $ 12,06
| | | | | | | | | | | | Sub Total | $ 12,06

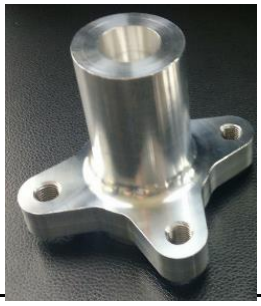
[picture p354: figure]

ItemOrder | Process | Use | UnitCost | Unit | Quantity | Multiplier | Mult. Val. | Sub Total
10 | Machining Setup, Install and Remove | Setup for turning | $ 1,30 | Unit | 1 | | 1 | $ 1,30
20 | Machining | Turning | $ 0,04 | cm^3 | 652,3 | Material - Aluminium | 1 | $ 26,09
30 | Machining Setup, Change | Change the turning setup | $ 0,65 | Unit | 1 | | 1 | $ 0,65
40 | Machining | Turning | $ 0,04 | cm^3 | 63,5 | Material - Aluminium | 1 | $ 2,54
50 | Machining Setup, Change | | $ 0,65 | Unit | 1 | | 1 | $ 0,65
60 | Machining | Milling | $ 0,04 | cm^3 | 149 | Material - Aluminium | 1 | $ 5,96
70 | Machining Setup, Change | | $ 0,65 | Unit | 1 | | 1 | $ 0,65
80 | Threading, Internal (machining) | For wheel studs | $ 0,10 | cm | 6 | Material - Aluminium | 1 | $ 0,60
100 | EDM - Wire | For tripod housing | $ 0,20 | cm | 7,9 | Material - Aluminium | 1 | $ 1,58
| | | | | | | Sub Total | $ 40,02

### Drawing part : WT_03001

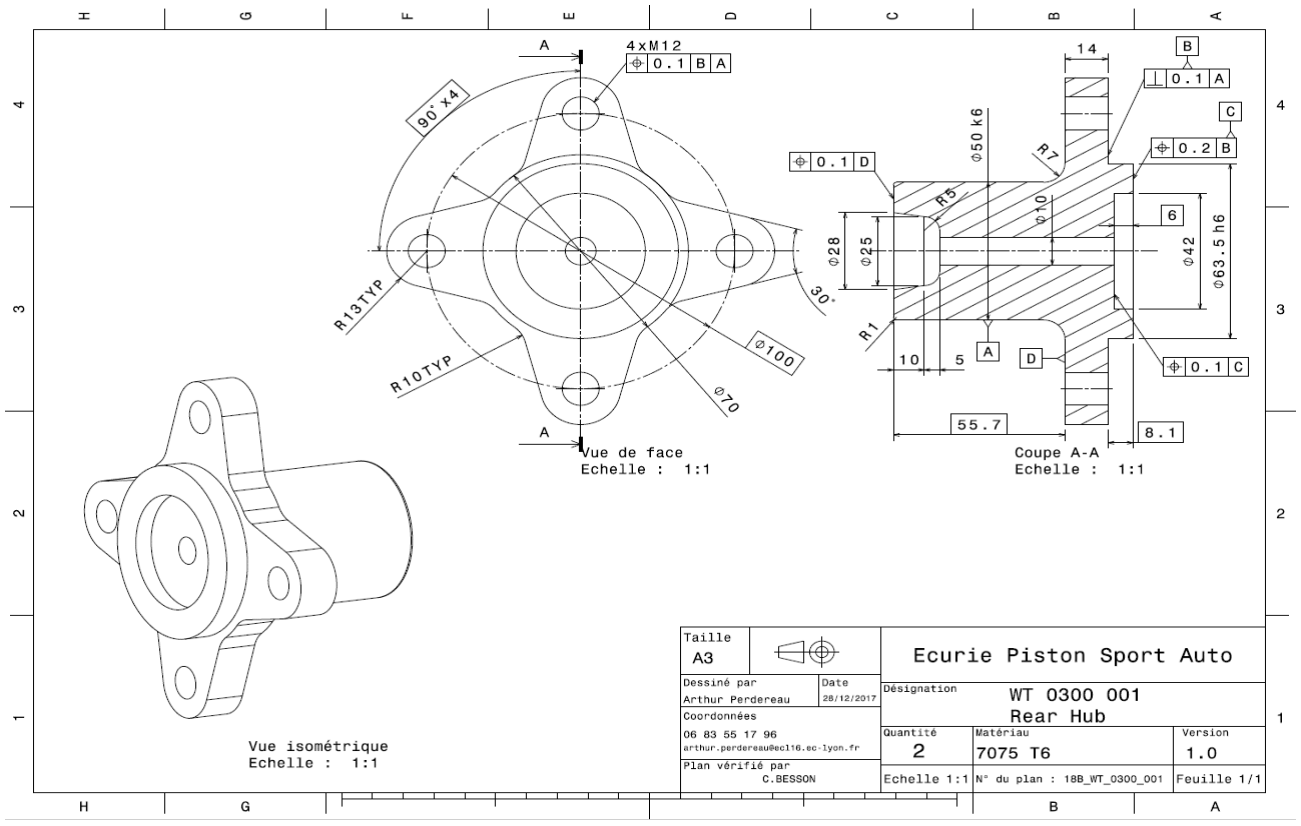
[picture p355: figure]

### Comment : Drawing before the EDM process for spline at the center

University | Ecole Centrale de Lyon | Back to BOM | Car # | 81 | Part Cost | $ | 3,97
System | Wheels & Tires | FileLink1 | Drawing | Qty | 1
Assembly | Rear Hubs | FileLink2 | FileLink1
Part | Wheel bearing spacer | FileLink3 | FileLink2 | Extended Cost $ | 3,97
P/N Base | WT 03002 | | FileLink3
Suffix | AA
Details | Part to let a space beetween the hub and the first bearing
ItemOrder | Material | Use | UnitCost | Size1 | Unit1 | Size2 | Unit2 | Area Name | Area | Length | Density | Quantity | Sub Total
10 | Aluminium, Premium | | $ 4,20 | 0,16 | kg | | | round area, 55mm diameter | 0,004 | 0,014 | 2712 | 1 | $ 0,67
| | | | | | | | | | | | Sub Total | $ 0,67

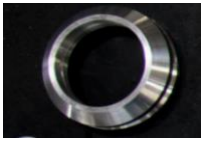
[picture p356: figure]

ItemOrder | Process | Use | UnitCost | Unit | Quantity | Multiplier | Mult. Val. | Sub Total
10 | Machining Setup, Install and Remove | Setup for turning | $ 1,30 | Unit | 1 | | 1 | $ 1,30
20 | Machining | Turning | $ 0,04 | cm^3 | 28,3 | Material -Aluminium | 1 | $ 1,13
30 | Machining Setup, Change | Change the turning setup | $ 0,65 | Unit | 1 | | 1 | $ 0,65
40 | Machining | Turning | $ 0,04 | cm^3 | 5,5 | Material -Aluminium | 1 | $ 0,22
| | | | | | | Sub Total | $ 3,30

### Drawing part : WT_03002

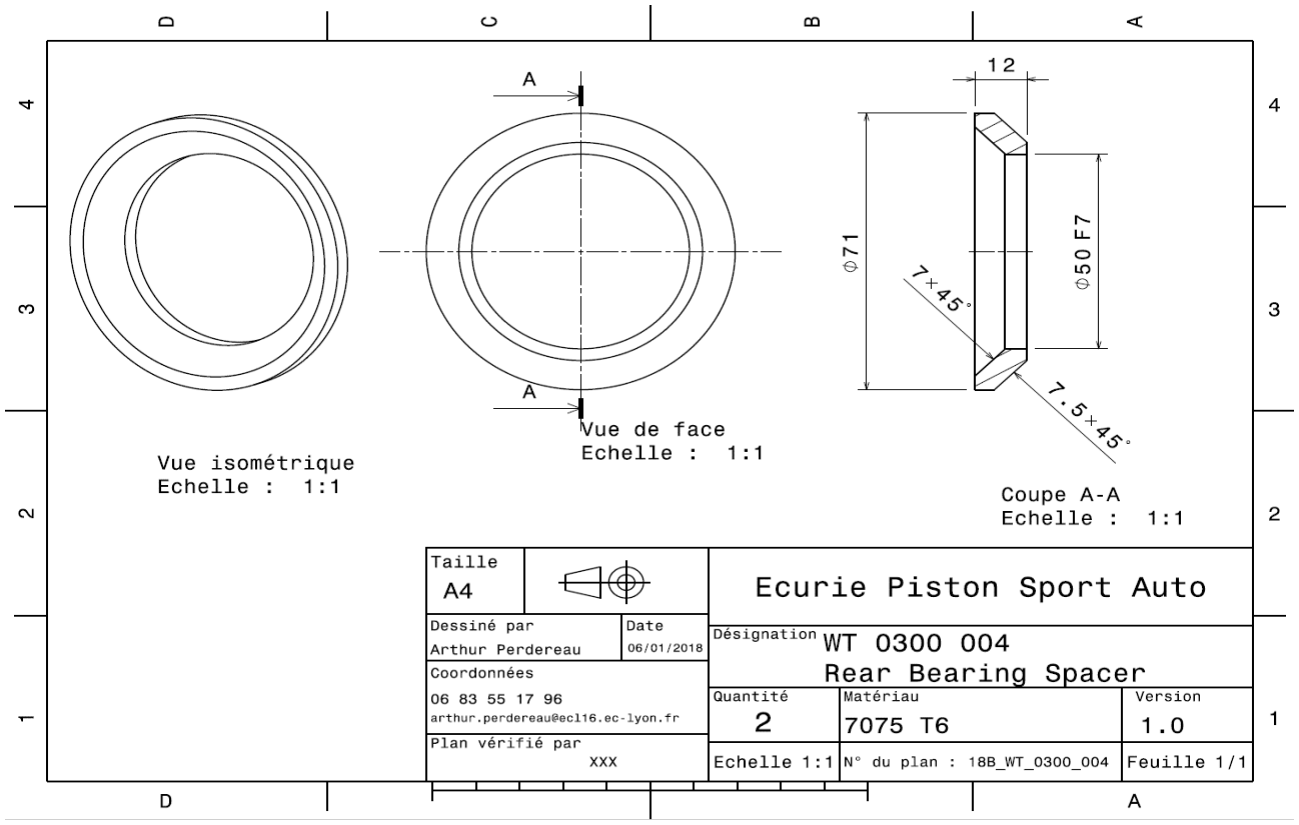
[picture p357: figure]

University | Ecole Centrale de Lyon | Back to BOM | Car # | 81 | Part Cost | $ | 21,67
System | Wheels & Tires | FileLink1 | Drawing | Qty | 1
Assembly | Rear Hubs | FileLink2 | FileLink1
Part | Rear Wheel Spacer | FileLink3 | FileLink2 | Extended Cost $ | 21,67
P/N Base | WT 03003 | | FileLink3
Suffix | AA
Details | Part to position the wheel on the good position relative to the hub and upright assembly
ItemOrder Material | | Use | UnitCost | Size1 | Unit1 | Size2 | Unit2 | Area Name | Area | Length | Density | Quantity | Sub Total
10 | Aluminium, Premium | | $ 4,20 | 0,86 | kg | | | round area, 130mm diameter | 0,013 | 0,024 | 2712 | 1 | $ 3,63
| | | | | | | | | | | | Sub Total | $ 3,63

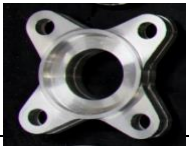
[picture p358: figure]

ItemOrder Process | | Use | UnitCost | Unit | Quantity | Multiplier | Mult. Val. | Sub Total
10 | Machining Setup, Install and Remove | Setup for turning | $ 1,30 | Unit | 1 | | 1 | $ 1,30
20 | Machining | Turning | $ 0,04 | cm^3 | 135 | Material - Aluminium | 1 | $ 5,40
30 | Machining Setup, Change | Change the turning setup | $ 0,65 | Unit | 1 | | 1 | $ 0,65
40 | Machining | Turning | $ 0,04 | cm^3 | 102 | Material - Aluminium | 1 | $ 4,08
50 | Machining Setup, Change | | $ 0,65 | Unit | 1 | | 1 | $ 0,65
60 | Machining | Milling | $ 0,04 | cm^3 | 149 | Material - Aluminium | 1 | $ 5,96
| | | | | | | Sub Total | $ 18,04

### Drawing part : WT_03003

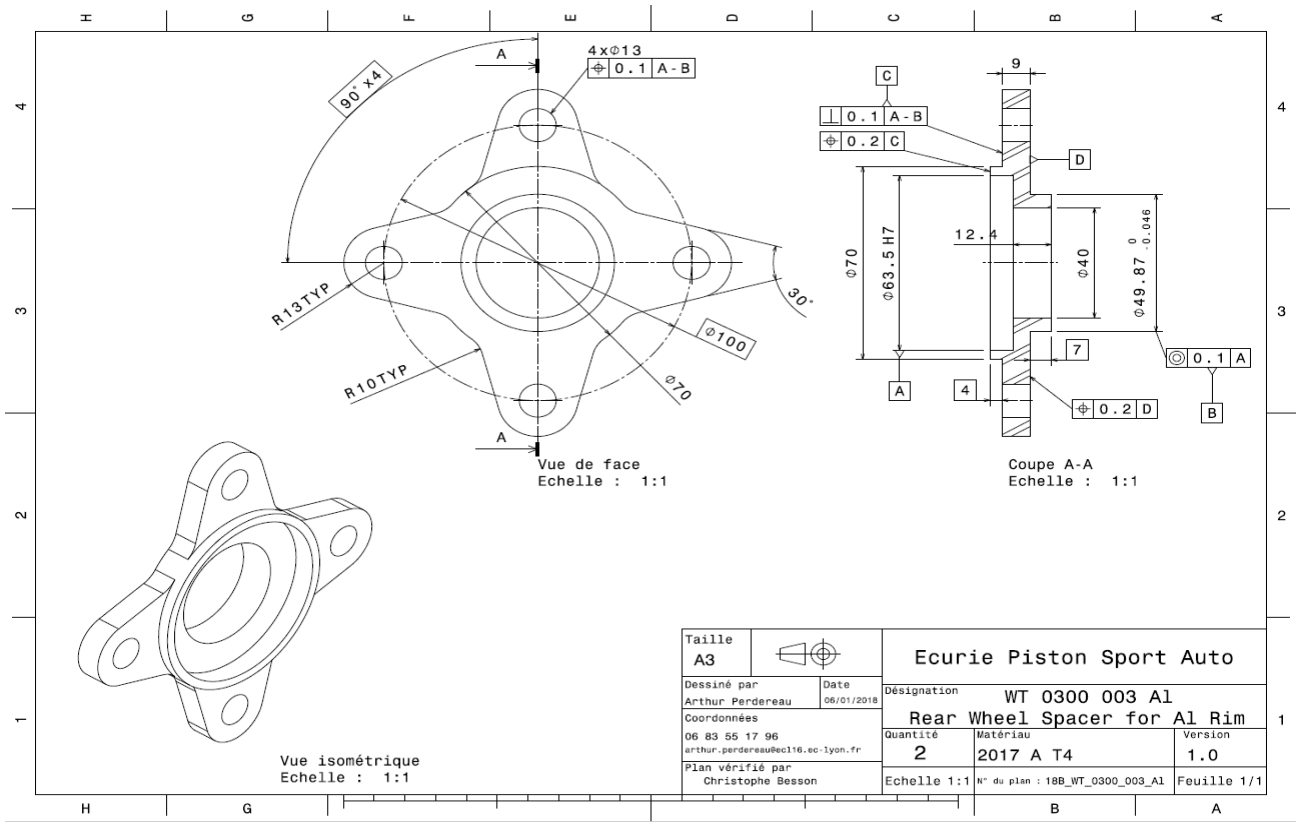
[picture p359: figure]

University | Ecole Centrale de Lyon | Back to BOM | Car # | 81 | Part Cost | $ | 3,90
System | Wheels & Tires | FileLink1 | Drawing | Qty | 1
Assembly | Rear Hubs | FileLink2 | FileLink1
Part | Tripod housing spacer | FileLink3 | FileLink2 | Extended Cost $ | 3,90
P/N Base | WT 03004 | | FileLink3
Suffix | AA
Details | Part to allow the tripod housing to be used as locknut to prestress the bearings. Also used to separate the speedsensor disc from the upright
ItemOrder | Material | Use | UnitCost | Size1 | Unit1 | Size2 | Unit2 | Area Name | Area | Length | Density | Quantity | Sub Total
10 | Aluminium, Premium | | $ 4,20 | 0,16 | kg | | | round area, 130mm diameter | 0,003 | 0,022 | 2712 | 1 | $ 0,66
| | | | | | | | | | | | Sub Total | $ 0,66

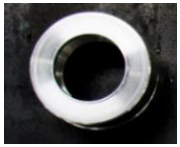
[picture p360: figure]

ItemOrder | Process | Use | UnitCost | Unit | Quantity | Multiplier | Mult. Val. | Sub Total
10 | Machining Setup, Install and Remove | Setup for turning | $ 1,30 | Unit | 1 | | 1 | $ 1,30
20 | Machining | Turning | $ 0,04 | cm^3 | 27,7 | Material - Aluminium | 1 | $ 1,11
30 | Machining Setup, Change | Change the turning setup | $ 0,65 | Unit | 1 | | 1 | $ 0,65
40 | Machining | Turning | $ 0,04 | cm^3 | 4,6 | Material - Aluminium | 1 | $ 0,18
| | | | | | | Sub Total | $ 3,24

### Drawing part : WT_03004

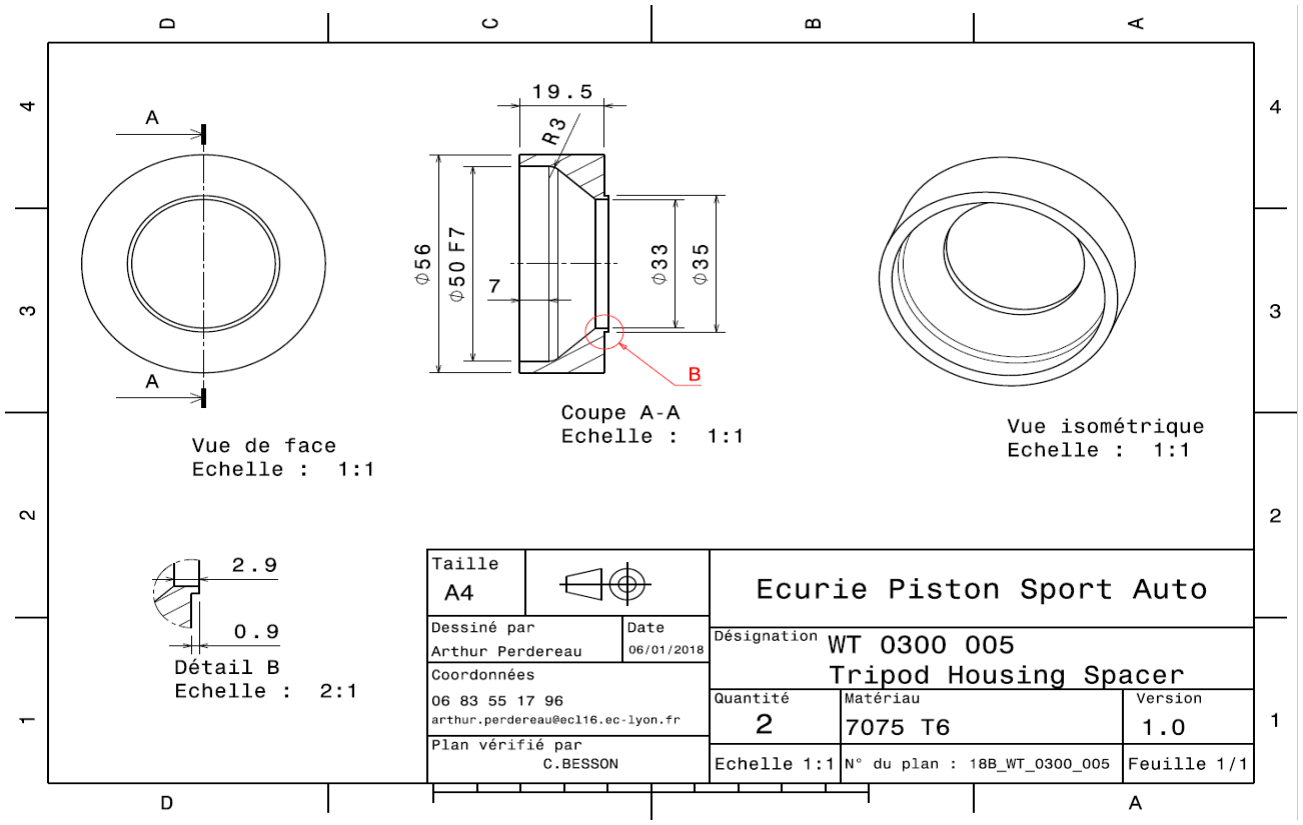
[picture p361: figure]

University | Ecole Centrale de Lyon | Back to BOM | Car # | 81 | Part Cost | $ | 7,69
System | Wheels & Tires | FileLink1 | Drawing | Qty | 1
Assembly | Rear Hubs | FileLink2 | FileLink1
Part | Speed Sensor Disc | FileLink3 | FileLink2 | Extended Cost $ | 7,69
P/N Base | WT 03005 | | FileLink3
Suffix | AA
Details | Disc use in combination with a sensor to obtain the speed of a wheel

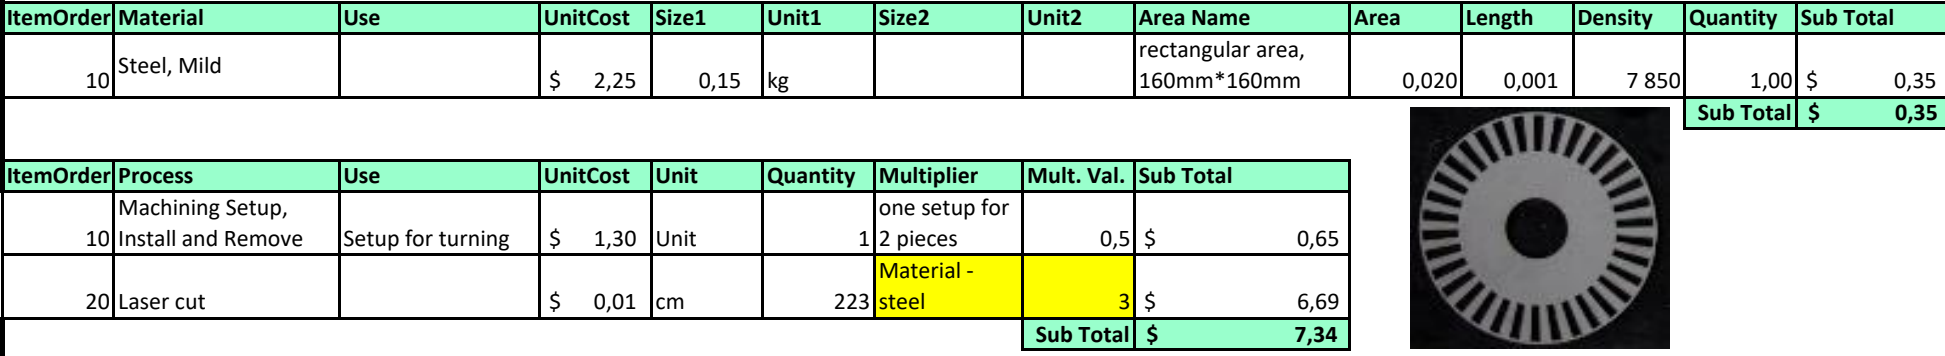
[picture p362: figure]
ItemOrder; Material; Use; UnitCost; Size1; Unit1; Size2; Unit2; Area Name; Area; Length; Density; Quantity; Sub Total; Steel, Mild; rectangular area, 160mm*160mm; Process; Unit; Multiplier; Mult. Val.; Machining Setup, Install and Remove; Setup for turning; one setup for 2 pieces; Laser cut; Material -steel

### Drawing part : WT_03005

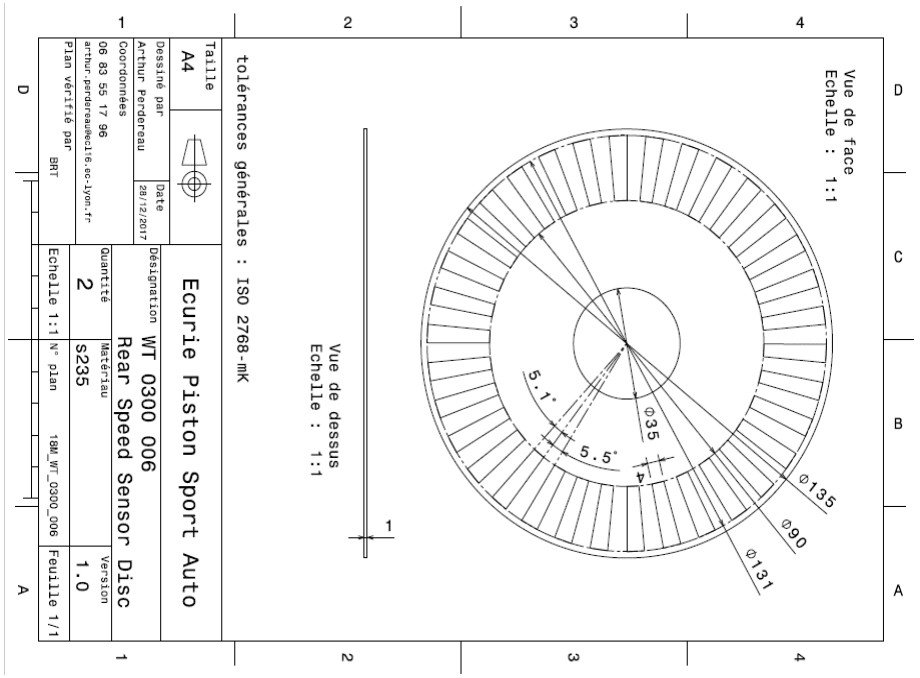
[picture p363: figure]
