EOSCogniton/Intergen/07_Documents Techniques/01_Livrables_TOPs/02_Livrables_TOP_Maquette/OPTIMUS - Tableau synthétique pièces assemblages.xlsx

Sheet: Introduction
Nomenclature des Pièces PFFVV de STUF'2019-Optimus
 | Version : | v1.6
 | Date : | 2019-01-16
 | Abréviations :
 | PFFV : | Pièce Fonctionnelle, Fabricable et Vérifiée - (statiquement sur plan)
 | PFFVV : | Pièce Fonctionnelle, Fabricable, Vérifiée et Validée - (dynamiquement sur système sur banc)

Sheet: Help
Cette classification est basée sur celle imposée par le cost
Comment remplir les différentes colonnes :
Asm | numéro de l'assemblage
Part # | numéro de la pièce
Component | nom de la pièce/assemblage
Description | petite description
version | version
date | date de la dernière modification
Etat | Différentes possibilitées :
 | En cours de design : | Design su CATIA et justification mécanique
 | Design terminé : | Pièce terminé sous CATIA
 | Devis effectué : | Prise de contact avec fournisseur et devis envoyé
 | Commande lancée : | Devis transmis au directeur financier
 | Fabrication : | Pièce en cours de fabrication
 | Livraison : | Pièce en cours de livraison
 | Reçu : | Pièce reçue
 | Intégré : | Pièce intégré
Dessin Technique | la mise en plan a été faite
Vérification dessin | Le dessin a été vérifié par une autre prsonne que le concepteur
Cost | La page du cost correspondant à la pièce est remplie
Prix | Prix de la pièce en €
Masse | Masse de la pièce (g)
Commentaire | Des remarques générales sur la pièce
L'appendix S-3 est fourni par la compétition, s'y référer pour avoir le nom des sous systèmes.

Sheet: Brake System
Brake System
Asm | Part # | Component | Description | version | Qté | date | Etat | Dessin technique | Vérification Dessin | Fournisseur | Numéro de commande | Prix | Masse théorique (g) | Masse réelle (g) | Localisation | Commentaire(s)
BR_A0100 |  | Front brake rotor | Même que vulcanix à l'avant
 | BR_0100_001 | Front Brake Caliper |  |  | 2 | 2018-12-06 | Design terminé |  |  | Récupéré de Olympix
 | BR_0100_002 | Front Brake disc |  |  | 2 | 2018-12-06 | Design terminé |  |  | Récupéré de Olympix
BR_A0200 |  | Rear brake rotor
 | BR_0200_001 | Rear Brake Caliper |  |  | 2 | 2018-12-06 | Design terminé |  |  | Récupéré de Olympix
 | BR_0200_002 | Rear Brake disc |  |  | 2 | 2018-12-06 | Design terminé |  |  | Beringer
BR_A0300 |  | Brake circuit assembly

Sheet: Engine & Drivetrain
Engine & Drivetrain
Asm | Part # | Component | Description | Qté | date | Etat | Dessin technique | Vérification Dessin | Fournisseur | Numéro de commande | Prix | Masse théorique (g) | Masse réelle (g) | Localisation | Commentaire(s)
EN_A0100 |  | Engine assembly
 | EN_0100_001 | Engine |  | 1 | 2018-09-28 | Reçu |  |  | Accimoto |  | 2700 |  |  | Bron
 | EN_0100_002 | Sprocket
 | EN_0100_003 | Plaque pair |  | 2 |  | Design terminé | OUI | NON | La mache
 | EN_0100_004 | Bracket |  | 2
 | EN_0100_005 | Adaptator oil pressure
 | EN_A0101 | Oil Sump |  | 1
 | EN_0101_001 | Carter |  | 1
 | EN_0101_002 | Plaque anti déjaugeage |  | 1
 | EN_0101_003 | Plan de joint |  | 1
 |  |  |  | 1
 |  |  |  | 1
 |  |  |  | 1
 |  |  |  | 1
 |  |  |  | 1
EN_A0250 |  | Exhaust System
 | EN_0200_001 | Exhaust Tip | CEE |  |  | En cours de design
 | EN_0200_002 | Exhaust Tip (part of Exhaust headers) |  |  |  | En cours de design
 | EN_A0261 | Exhaust header 1 |  |  |  | En cours de design
 | EN_0200_003 | ech 1.1 (part of Exhaust header 1) |  |  |  | En cours de design
 | EN_0200_004 | ech 1.2 (part of Exhaust header 1) |  |  |  | En cours de design
 | EN_0200_005 | ech 1.3 (part of Exhaust header 1) |  |  |  | En cours de design
 | EN_0200_006 | ech 1.4 (part of Exhaust header 1) |  |  |  | En cours de design
 | EN_A0262 | Exhaust header 2 |  |  |  | En cours de design
 | EN_0200_007 | ech 2.1 (part of Exhaust header 2) |  |  |  | En cours de design
 | EN_0200_008 | ech 2.2 (part of Exhaust header 2) |  |  |  | En cours de design
 | EN_0200_009 | ech 2.3 (part of Exhaust header 2) |  |  |  | En cours de design
 | EN_0200_010 | ech 2.4 (part of Exhaust header 2) |  |  |  | En cours de design
 | EN_0200_011 | ech 2.5 (part of Exhaust header 2) |  |  |  | En cours de design
 | EN_0200_012 | ech 2.6 (part of Exhaust header 2) |  |  |  | En cours de design
 | EN_0200_013 | ech 2.7 (part of Exhaust header 2) |  |  |  | En cours de design
 | EN_0200_014 | ech 2.8 (part of Exhaust header 2) |  |  |  | En cours de design
 | EN_0200_015 | ech 2.9 (part of Exhaust header 2) |  |  |  | En cours de design
 | EN_A0263 | Exhaust header 3 |  |  |  | En cours de design
 | EN_0200_016 | ech 3.1 (part of Exhaust header 3) |  |  |  | En cours de design
 | EN_0200_017 | ech 3.2 (part of Exhaust header 3) |  |  |  | En cours de design
 | EN_0200_018 | ech 3.3 (part of Exhaust header 3) |  |  |  | En cours de design
 | EN_0200_019 | ech 3.4 (part of Exhaust header 3) |  |  |  | En cours de design
 | EN_0200_020 | ech 3.5 (part of Exhaust header 3) |  |  |  | En cours de design
 | EN_0200_021 | ech 3.6 (part of Exhaust header 3) |  |  |  | En cours de design
 | EN_A0264 | Exhaust header 4 |  |  |  | En cours de design
 | EN_0200_022 | ech 4.1 (part of Exhaust header 4) |  |  |  | En cours de design
 | EN_0200_023 | ech 4.2 (part of Exhaust header 4) |  |  |  | En cours de design
 | EN_0200_024 | ech 4.3 (part of Exhaust header 4) |  |  |  | En cours de design
 | EN_0200_025 | ech 4.4 (part of Exhaust header 4) |  |  |  | En cours de design
 | EN_0200_026 | ech 4.5 (part of Exhaust header 4) |  |  |  | En cours de design
 | EN_0200_027 | Primary collector |  |  |  | En cours de design
 | EN_A0271 | Primary collector tubing 1-4 |  |  |  | En cours de design
 | EN_0200_028 | ech 1-4.1 (part of Primary collector tubing 1-4) |  |  |  | En cours de design
 | EN_0200_029 | ech 1-4.2 & ech 1-4.3 (part of Primary collector tubing 1-4) |  |  |  | En cours de design
 | EN_0200_030 | ech 1-4.4 (part of Primary collector tubing 1-4) |  |  |  | En cours de design
 | EN_0200_031 | Primary collector tubing 2-3 |  |  |  | En cours de design
 | EN_0200_032 | Secondary Collector |  |  |  | En cours de design
 | EN_A0282 | Secondary collector tubing |  |  |  | En cours de design
 | EN_0200_101 | Secondary collector tubing 1 |  |  |  | En cours de design
 | EN_0200_102 | Secondary collector tubing 2 |  |  |  | En cours de design
 | EN_0200_103 | Secondary collector tubing 3 |  |  |  | En cours de design
 | EN_0200_104 | Secondary collector tubing 4 |  |  |  | En cours de design
 | EN_0200_037 | Muffler |  |  |  | En cours de design
 | EN_0200_038 | Exhaust collar |  |  |  | En cours de design
 | EN_0200_151 | Frame fixation (mobile part) |  |  |  | En cours de design
 | EN_0200_152 | Frame fixation (fixed part) |  |  |  | En cours de design
EN_A0300 |  | Air Intake System |  |  |  | Design terminé
 | EN_0300_001 | Plenum | CEE | 1 |  | Design terminé
 | EN_0300_002 | Fond plat | CEE | 1 |  | Design terminé
 | EN_0300_003 | Tubulures | CEE | 1 |  | Design terminé
 | EN_0300_004 | Jonction moteur | CEE | 4 |  | Reçu
 | EN_0300_005 | Fixation moteur | CEE | 2 |  | Design terminé
 | EN_0300_006 | Rampe d'injection | CEE | 1 |  | Design terminé
 | EN_0300_007 | Fixation châssis droite | CEE | 1 |  | Design terminé
 | EN_0300_008 | Fixation châssis gauche | CEE | 1 |  | Design terminé
 | EN_0300_009 | Jonction bride / plenum | CEE | 1 |  | Design terminé
 | EN_0300_010 | Join plenum / tubulures | CEE | 1 |  | Reçu
 | EN_0300_011 | Chape fixation admission |  | 1 |  | Design terminé
EN_A0400 |  | Throttle body
 | EN_0400_001 | Bas guillotine | CEE | 1 |  | En cours de design
 | EN_0400_002 | Milieu guillotine | CEE | 1 |  | En cours de design
 | EN_0400_003 | Arret guillotine | CEE | 1 |  | En cours de design
 | EN_0400_004 | Guillotine | CEE | 1 |  | En cours de design
 | EN_0400_005 | Haut guillotine | CEE | 1 |  | En cours de design
 | EN_0400_006 | Gaine | CEE | 1 |  | En cours de design
 | EN_0400_007 | Convergeant | CEE | 1 |  | En cours de design
 | EN_0400_008 | Filtre à air | CEE | 1 |  | En cours de design
 | EN_0400_009 | Cable accélarateur | CEE | 1 |  | En cours de design
 | EN_0400_010 | Bride | CEE | 1 |  | En cours de design
 | EN_0400_011 | Capteur guillotine (fixe) | CEE | 1 |  | En cours de design
 | EN_0400_012 | Capteur guillotine (mobile) | CEE | 1 |  | En cours de design
 | EN_0400_013 | Entretoise 3mm | CEE | 2 |  | En cours de design
 | EN_0400_014 | Ressort | CEE | 2 |  | En cours de design
EN_A0500 |  | Fuel tank assembly |  |  |  | En cours de design
 | EN_0500_001 | Main | BVL | 1 |  | En cours de design
 | EN_0500_002 | Tube | BVL | 1 |  | En cours de design
 | EN_0500_003 | Silent block M4 | BVL | 4 |  | Design terminé
 | EN_0500_004 | Raccord Dash6 Droit | BVL | 2 |  | Design terminé
 | EN_0500_005 | Fonds | BVL | 1 |  | Design terminé
 | EN_0500_006 | Chape avant gauche final | BVL | 1 |  | Design terminé
 | EN_0500_008 | Chape reservoir fixation | BVL | 3 |  | En cours de design
 | EN_0500_009 | Triangle plie | BVL | 1 |  | En cours de design
 | EN_0500_010 | Embase dash 6 | BVL | 3 |  | En cours de design
 | EN_0500_011 | Filler neck | BVL | 1 |  | Design terminé
 | EN_0500_012 | filler neck collar | BVL | 1 |  | Design terminé
 | EN_0500_013 | filler neck collar bracket | MJT | 1 |  | Design terminé
EN_A0600 |  | Fuel system
 | EN_0600_001 | Fuel rail
 | EN_0600_002 | Fuel Pump |  | 1
 | EN_0600_003 | Pression Regulator |  | 1
 | EN_0600_004 | Chape fixation pompe chassis |  | 1
 | EN_0600_005 | Colier pompe essence |  | 1
 | EN_0600_006 | Chape fixation pression regulator |  | 1 |  | Design terminé
EN_A0700 |  | Catch cans
 | EN_0700_001 |  |  |  |  | En cours de design
EN_A0800 |  | Cooling system
 | EN_0800_001 |  | AMS
 | EN_0800_002 |  | AMS
 | EN_0800_003 | Chape vase d'expansion |  | 1 |  | Design terminé | OUI
 | EN_0800_004 | Frame Bracket Top |  | 1
 | EN_0800_005 | Frame bracket rear |  | 1
 | EN_0800_006 | Fixing bar |  | 1
 | EN_0800_007 | Frame bracket bottom |  | 1
 | EN_0800_008 | Radiator bracket |  | 3 |  |  | OUI
 | EN_0800_004 | Expansion Tank | ASE | 1
EN_A0900 |  | Secondary drivetrain
 | EN_A0901 | Differential assembly
 | EN_0901_001 | Drexler |  |  |  | Reçu |  |  |  |  |  |  |  | Local Centrale
 | EN_0901_002 | Left bearing
 | EN_0901_003 | Right bearing
 | EN_0901_004 | Left eccentric
 | EN_0901_005 | Right eccentric
 | EN_0901_006 | Douille
 | EN_0901_007 | Douille
 | EN_0901_008
 | EN_A0902 | Chain set
 | EN_0902_001 | Porte couronne |  |  |  | Design terminé |  |  |  |  |  |  |  | Local Centrale | En attente de la couronne pour usinage à Centrale
 | EN_0902_002 | Chaine |  |  |  | commande lancée
 | EN_0902_003
 | EN_0902_004 | Chape chainshield top |  | 1 |  | Design terminé | OUI
 | EN_0902_005 | Chape chainshield bottom |  | 1 |  | Design terminé | OUI
 | EN_A0903 | Drive shaft left
 | EN_0903_001
 | EN_A0904 | Drive shaft right
 | EN_0904_001
 | EN_A0905 | Jacking bar
 | EN_0905_001 | Brackets |  | 2
 | EN_0905_002 | Bar |  | 1
EN_A1200 |  | Shifter
 | EN_1200_001 | Reducteur
 | EN_1200_002 | MCC
 | EN_1200_003 | Renvoi d'angle
 | EN_1200_004 | Etoile
 | EN_1200_005 | Axe + Roue
 | EN_1200_006 | Roue
 | EN_1200_007 | Collier serrage
 | EN_1200_008 | Circlip
 | EN_1200_009 | Chape motored av
 | EN_1200_010 | Chape motored ar
 | EN_1200_011 | Rondelle
 | EN_1200_012 | Vis
 | EN_1200_013 | Boulon
 | EN_1200_014 | Silent bloc
 | EN_1200_015 | Vis silent bloc
 | EN_1200_016 | Ecrou silent bloc
 | EN_1200_017 | Rondelle silent bloc
 | EN_1200_018 | Chape frame

Sheet: Steering System
Asm | Part # | Component | Description | Qté | date | Etat | Dessin technique | Vérification Dessin | Fournisseur | Numéro de commande | Prix | Masse théorique (g) par pièce | Masse réelle(g) | Localisation | Commentaire(s)
ST_A0100 | ST_A0100 | Steering rack Assembly
 | ST_0100_001 | Steering rack | Crémaillère Formula Seven | 1 | 2018-10-16 | commande lancée | X | X | Formula Seven |  | 1200€ | 940 |  |  | Pièce arrivée
 | ST_0100_002 | Steering Rack Brackets | Chapes pliées pour accrocher la crémaillère | 2 | 2018-11-27 | Design terminé | NON | NON | La Mache |  |  | 31
ST_0100_003 | Half Moon |  | Pièce soutenant la crémaillère | 4 | 2018-10-16 | Design terminé | OUI | OUI | La Mache productique | 19M_ST_0100_003 |  | 21 |  |  | Cette pièce est en Aluminium
 | M6*50 |  |  | 4 | 2018-10-16 | En cours de design | X | X |  |  |  | 14
 | M6 Nut |  |  | 4 | 2018-10-16 | Design terminé | X | X |  |  |  | 3
 | M6 Washer |  |  | 4 | 2018-10-16 | Design terminé | X | X |  |  |  | 1
ST_A0200 | Steering column assembly
ST_0200_001 | Steering U-Join |  | Cardan | 1 | 2018-10-16 | En cours de design | X | X | APEX |  | 220€ (environ) | 120
ST_0200_002 | Spline Coupler |  | Coupleur à cannelure | 1 | 2018-10-16 | commande lancée | X | X | Formula Seven |  | 50€ (acier) et 65€ (Alu) | 30 |  |  | Version Alu et Acier commandées, l'acier pèse 60g. Idem crémaillère pour la commande
ST_0200_003 | Steering Column |  | Colonne de direction | 1 | 2018-10-16 | En cours de design | NON | NON |  |  |  | 60 |  |  | Le choix va se faire à priori sur une colonne en Aluminium collé et goupillée
ST_A0300 | ST_A0300 | Quick release |  | 1 | 2018-10-16 | Design terminé | X | X | Reverchon |  | 150€ (environ | 100 (environ) |  |  | La décomposition en sous-pièce ne se fait que pour le cost
ST_A0400 | ST_A0400 | Steering wheel assembly
 | ST_0400_001 | Steering Wheel | Volant | 1 | 2018-10-16 | commande lancée | NON | NON | Formula Seven |  | 250€ | 330 |  |  | Idem crémaillère, version 265mm de diamètre choisie. Attention il faudra percer le volant proprement à Boisard.
 | ST_0400_002 | Spacer | Entretoise entre le Quick release et le shifter | 1 | 2018-10-16 | Design terminé | NON | NON | Boissard ou la mache |  |  | 43 |  |  | PIèce en Aluminium
 | FR_0600_001 | Shifter | voir frame & Body
 |  | M6*50 | Pas sûr de la taille | 3 | 2018-10-16 | En cours de design | X | X |  |  |  | 14 |  |  | Le choix de ces vis n'est pas si simple que ça, il faut à priori des têtes fraisées qu'il faudra commander.
 |  | M6 Nut |  | 3 | 2018-10-16 | Design terminé | X | X |  |  |  | 3
 |  | M6 Washer |  | 3 | 2018-11-27 | Design terminé | X | X |  |  |  | 1 |  |  | Ces rondelles sont pour le volant, il ne faut pas mettre directement la vis sur le carbone
ST_A0500 | ST_A0500 | Steering rod
 | ST_0500_001 | tapped insert | Insert taraudé | 4 |  |  |  |  |  | SU_09001_AT
 | ST_0500_002 | Carbon fiber tube |  | 2
 | ST_0500_003 | Spacer |  | 8
ST_A0600 | ST_A0600 | Steering pivot Assembly
 | ST_0600_001 | Steering Upper Shaft | Axe du pivot | 1 | 2018-10-16 | Design terminé | OUI | OUI | Boisard |  |  | 127 |  |  | Il faut bien vérifier que la Mache n'a pas fait de la merde. La gorge du circlip a été agrandi par rapport à l'année dernière
 | ST_0600_002 | Steering Bore | Cage du pivot | 1 | 2018-11-27 | Design terminé | OUI | OUI | Boisard |  |  | 147 |  |  | Il faut bien vérifier que la Mache n'a pas fait de la merde car c'est une porté de roulement
 | ST_0600_003 | Quick release Shaft | Partie cannelé pour mettre le Quick release | 1 | 2018-10-16 | Design terminé | X | X | Comme Quick Release : Reverchon |  |  | 118 |  |  | A voir si il y en a encore à Bron
 | ST_0600_004 | Lateral tubes | tube d'attache du pivot de direction | 2 | 2018-11-27 | Design terminé | X | X | Decoupe laser des tube (Noel métal) |  |  | 85 |  |  | Robin est au courant et ajoute ce tube à la commande de decoupe laser
 |  | Retaining Ring | Circlip de rayon interieur 13.95mm | 1 | 2018-10-16 | Design terminé | X | X |  |  |  | 4 |  |  | A voir si il y en a encore à Bron
 |  | Bearing | Roulement SKF 61806-2RS1 | 2 | 2018-10-16 | Design terminé | X | X | SKF |  |  | 25 |  |  | Lien vers les références : http://www.skf.com/group/products/bearings-units-housings/ball-bearings/deep-groove-ball-bearings/deep-groove-ball-bearings/index.html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
ST_A0700 | ST_A0700 | Seering Rack protection Assembly
 | ST_0700_001 | Seering Rack protection | Cache crémailère | 1 | 2018-11-27 | En cours de design | NON | NON | La mache |  |  | 246 |  |  | En alu de 2mm d'épaisseur
 |  | M4*16 |  | 4 | 2018-11-27 | Design terminé | X | X |  |  |  | 3 |  |  | M4*10 passe inchallah mais très juste et sans rondelle
 |  | M4 nut |  | 4 | 2018-11-27 | Design terminé | X | X |  |  |  | 1

Sheet: Suspension System
re
Asm | Part # | Component | Description | Qté | date | Etat | Dessin technique | Vérification Dessin | Fournisseur | Numéro de commande | Prix | Masse théorique (g) | Masse réelle (g) | Localisation | Commentaire(s)
SU_A0100 |  | Upper Front A-Arms | ABR respo | 2
 | SU_0100_001 | Upper front bearing support | Insert côté PM | 2 | 2018-10-07 | En cours de design |  |  | ALPENTECH | SU_01001_AT
 | SU_0100_002 | Inner bearing support | Insert côté châssis | 4 | 2018-10-07 | En cours de design |  |  | ALPENTECH | SU_01002_AT
 | SU_0100_003 | Front carbon fiber tube |  | 2 | 2018-10-07 | En cours de design |  |  | Mateduc composites | SU_01003_AT
 | SU_0100_004 | Back Carbon fiber tube |  | 2 | 2018-10-07 | En cours de design |  |  | Mateduc composites | SU_01004_AT
 | SU_0100_005 | Spacer | Entretoises type 16 mm | 8 | 2018-10-07 | Design terminé | OUI |  | La Mache productique | SU_0100_005_MA
 | SU_0100_006 | Cylinder aluminium | Cylindre alu interieur | 4 | 2018-10-08 | En cours de design |  |  | Boisard
 | SU_0100_007 | Bracket triangle avant haut bras avant 1 |  | 2 | 2108-12-06 | Design terminé |  |  | La Mache | SU_0100_007_MA |  |  |  |  | Qté 2 = 1 + symétrique
 | SU_0100_008 | Bracket triangle avant haut bras avant 2 |  | 2 | 2108-12-06 | Design terminé |  |  | La Mache | SU_0100_008_MA |  |  |  |  | Qté 2 = 1 + symétrique
 | SU_0100_009 | Bracket triangle avant haut bras arrière 1 |  | 2 | 2108-12-06 | Design terminé |  |  | La Mache | SU_0100_009_MA |  |  |  |  | Qté 2 = 1 + symétrique
 | SU_0100_010 | Bracket triangle avant haut bras arrière 2 |  | 2 | 2108-12-06 | Design terminé |  |  | La Mache | SU_0100_010_MA |  |  |  |  | Qté 2 = 1 + symétrique
SU_A0200 |  | Lower Front A-Arms | ABR respo | 2
 | SU_0200_001 | Lower front bearing support | Insert côté PM | 2 | 2018-10-07 | En cours de design |  |  | ALPENTECH | SU_02001_AT
 | SU_0200_002 | Inner bearing support | Insert côté châssis | 4 | 2018-10-07 | En cours de design |  |  | ALPENTECH | SU_01002_AT
 | SU_0200_003 | Front carbon fiber tube |  | 2 | 2018-10-07 | En cours de design |  |  | Mateduc composites
 | SU_0200_004 | Back Carbon fiber tube |  | 2 | 2018-10-07 | En cours de design |  |  | Mateduc composites
 | SU_0200_005 | Spacer | Entretoises type 16 mm | 8 | 2018-10-07 | Design terminé | OUI |  | La Mache productique | SU_0100_005_MA
 | SU_0200_006 | Bracket triangle avant bas bras avant 1 |  | 2 | 2108-12-09 | Design terminé |  |  | La Mache | SU_0200_006_MA
 | SU_0200_007 | Bracket triangle avant bas bras avant 2 |  | 2 | 2108-12-09 | Design terminé |  |  | La Mache | SU_0200_007_MA
 | SU_0200_008 | Bracket triangle avant bas bras arrière 1 |  | 2 | 2108-12-09 | Design terminé |  |  | La Mache | SU_0200_008_MA
 | SU_0200_009 | Bracket triangle avant bas bras arrière 2 |  | 2 | 2108-12-09 | Design terminé |  |  | La Mache | SU_0200_009_MA
SU_A0300 |  | Upper Rear A-Arms | ABR respo | 2 | 2018-10-07 | En cours de design |  |  | ALPENTECH
 | SU_0300_001 | Upper rear bearing support | Insert côté PM | 2 | 2018-10-07 | En cours de design |  |  | ALPENTECH | SU_03001_AT
 | SU_0300_002 | Inner bearing support | Insert côté châssis | 4 | 2018-10-07 | En cours de design |  |  | Mateduc composites | SU_01002_AT
 | SU_0300_003 | Front carbon fiber tube |  | 2 | 2018-10-07 | En cours de design |  |  | Mateduc composites
 | SU_0300_004 | Back Carbon fiber tube |  | 2 | 2018-10-07 | En cours de design |  |  | Boisard
 | SU_0300_005 | Spacer | Entretoises type 16 mm | 8 | 2018-10-07 | Design terminé | OUI |  | La Mache productique | SU_0100_005_MA
 | SU_0300_006 | Cylinder aluminium | cylindre alu interieur, même que SU_0100_006 | 4 | 2018-10-07 | En cours de design |  |  | Boisard
 | SU_0300_007 | Bracket triangle arrière haut bras avant 1 |  | 2 | 2108-12-09 | Design terminé |  |  | La Mache | SU_0300_007_MA
 | SU_0300_008 | Bracket triangle arrière haut bras avant 2 |  | 2 | 2108-12-09 | Design terminé |  |  | La Mache | SU_0300_008_MA
 | SU_0300_009 | Bracket triangle arrière haut bras arrière 1 |  | 2 | 2108-12-09 | Design terminé |  |  | La Mache | SU_0300_009_MA
 | SU_0300_010 | Bracket triangle arrière haut bras arrière 2 |  | 2 | 2108-12-09 | Design terminé |  |  | La Mache | SU_0300_010_MA
SU_A0400 |  | Lower Rear A-Arms | ABR respo | 2
 | SU_0400_001 | Lower rear bearing support | Insert côté PM | 2 | 2018-10-07 | En cours de design |  |  | ALPENTECH | SU_04001_AT
 | SU_0400_002 | Inner bearing support | Insert côté châssis | 4 | 2018-10-07 | En cours de design |  |  | ALPENTECH | SU_01002_AT
 | SU_0400_003 | Front carbon fiber tube |  | 2 | 2018-10-07 | En cours de design |  |  | Mateduc composites
 | SU_0400_004 | Back Carbon fiber tube |  | 2 | 2018-10-07 | En cours de design |  |  | Mateduc composites
 | SU_0400_005 | Spacer | Entretoises type 16 mm | 8 | 2018-10-07 | Design terminé | OUI |  | La Mache productique | SU_0100_005_MA
 | SU_0400_006 | Bracket triangle arrière bas bras avant 1 |  | 2 | 2108-12-09 | Design terminé |  |  | La Mache | SU_0400_006_MA
 | SU_0400_007 | Bracket triangle arrière bas bras avant 2 |  | 2 | 2108-12-09 | Design terminé |  |  | La Mache | SU_0400_007_MA
 | SU_0400_008 | Bracket triangle arrière bas bras arrière 1 |  | 2 | 2108-12-09 | Design terminé |  |  | La Mache | SU_0400_008_MA
 | SU_0400_009 | Bracket triangle arrière bas bras arrière 2 |  | 2 | 2108-12-09 | Design terminé |  |  | La Mache | SU_0400_009_MA
SU_A0500 |  | Front Rocker Mount
 | SU_0500_001
 | SU_0500_002
SU_A0600 |  | Front bell cranck assembly
 | SU_A0600_001 | basculeur |  | 4 |  | Design terminé | OUI |  | La Mache Laser
 | SU_A0600_002 | Entretoise M8 20 mm |  | 32 |  | Design terminé | OUI |  | La Mache Productique
 | SU_A0600_003 | Entretoise Pivot Basculeur |  | 20 |  | Design terminé | OUI |  | La Mache productique
SU_A0700 |  | Rear shock assembly
 | SU_0700_001
 | SU_0700_002
 | SU_0700_003 | Chape fixation Ohlins |  | 2 |  | Design terminé | OUI
SU_A0800 |  | Rear bell cranck assembly
 | SU_0800_001 | Basculeur arrière |  | 4 |  | Design terminé | OUI |  | La Mache laser
 | SU_0800_002 | Bracket front rocker avant |  | 2 |  | Design terminé | OUI |  | La Mache
 | SU_0800_003 | Bracket front rocker arrière |  | 2 |  | Design terminé | OUI |  | La Mache
 | SU_0800_004 | Bracket Pivot suspension |  | 2 |  | Design terminé | OUI | NON
SU_A0900 |  | Rear tie-rod | ABR respo | 2 |  | En cours de design
 | SU_0900_001 | tapped insert | Insert taraudé | 4 |  | En cours de design |  |  | ALPENTECH | SU_09001_AT
 | SU_0900_002 | Carbon fiber tube |  | 2 |  | En cours de design |  |  | Mateduc composites
 | SU_0900_003 | Spacer | Entretoises type 16 mm | 4 | 2018-10-07 | Design terminé | OUI |  | La Mache productique | SU_0100_005_MA
 | SU_0900_004 | Spacer | Entretoise type 25 mm M6 | 4 |  | Design terminé | OUI |  | La Mache productique | SU_1000_006_MA
SU_A1000 |  | Front upright assembly |  | 1+1 | 2018-12-06 | En cours de design
 | SU_1000_001 | Front Left Upright | PM avant gauche | 1+1 |  | Design terminé | OUI | OUI | Boisard | 19B_SU_10001 |  | 718
 | SU_1000_002 | Upper Arm Bracket | Chappe pour triangle sup montée sur le PM | 2 |  | Design terminé | OUI | OUI | Boisard | 19B_SU_10002 |  | 60
 | SU_1000_003 | Upper Arm Wedge Shim | Calle de carrossage pour l'instant non détaillé . 2 version une en 1mm une en 2mm | 12 en 2mm 3 en 1mm |  | Design terminé | OUI | OUI | La mache découpe laser | 19M_SU_10003_1mm/19M_SU_10003_2mm |  | 5.7 pour 1mm
 | SU_1000_004 | Speed Sensor Washer | Entretoise pour correctement écarter le capteur de vitesse v2 du disque | 2 |  | Design terminé | OUI | OUI | La mache découpe laser | 19M_SU_10004 |  | 0.753
 | SU_1000_005 | Upper Arm Wedge base | base des cales de carrossage pour éviter les congés en fond de PM | 2 |  | Design terminé | OUI | OUI | Boisard | 19B_SU_10005 |  | 2018-05-28
 | SU_1000_006 | Spacer | Entretoise type 25 mm M6 | 12 |  | Design terminé | OUI |  | La Mache productique | SU_1000_006_MA
SU_A1100 |  | Rear upright assembly |  |  | 2018-12-06
 | SU_1100_001 | Rear Left Upright | PM arrière gauche | 1+1 |  | Design terminé | OUI | OUI | Boisard | 19B_SU_10001 |  | 679
 | SU_1100_002 | Upper Arm Bracket | Chappe triangle sup montée sur le PM, idem chape avant | 2 |  | Design terminé | OUI | OUI | Boisard | 19B_SU_10002 |  | 60
 | SU_1100_003 | Upper Arm Wedge Shim | Calle de carrossage idem avant | 12 en 2mm 3 en 1mm |  | Design terminé | OUI | OUI | La mache découpe laser | 19M_SU_10003_1mm/19M_SU_10003_2mm |  | 5.7 pour 1mm
 | SU_1100_004 | Speed Sensor Washer | Idem avant | 2 |  | Design terminé | OUI | OUI | La mache découpe laser | 19M_SU_10004 |  | 0.753
 | SU_1100_005 | Spacer | Entretoise type 25 mm M6 | 12 |  | Design terminé | OUI |  | La Mache productique | SU_1000_006_MA
SU_A1200 |  | Front suspension rod |  | 2
 | SU_1200_001 | tapped insert | Insert taraudé | 4 |  | En cours de design |  |  | ALPENTECH | SU_09001_AT
 | SU_1200_002 | Carbon fiber tube |  | 2 |  | En cours de design |  |  | Mateduc composites
 | SU_1200_003 | Spacer | Entretoises type 16 mm | 4 | 2018-10-07 | Design terminé | OUI |  | La Mache productique | SU_0100_005_MA
 | SU_1200_004 | Spacer 2 | Entretoise type 20 mm | 4 |  | Design terminé | OUI |  | La Mache productique | SU_1200_004_MA
SU_A1300 |  | Rear suspension rod |  | 2 |  | En cours de design
 | SU_1300_001 | tapped insert | Insert taraudé | 4 |  | En cours de design |  |  | ALPENTECH | SU_09001_AT
 | SU_1300_002 | Carbon fiber tube |  | 2 |  | En cours de design |  |  | Mateduc composites
 | SU_1300_003 | Spacer | Entretoises type 16 mm | 4 | 2018-10-07 | Design terminé | OUI |  | La Mache productique | SU_0100_005_MA
 | SU_1300_004 | Spacer 2 | Entretoise type 20 mm | 4 |  | Design terminé | OUI |  | La Mache productique | SU_1200_004_MA
SU_A1400 |  | Front Anti Roll Bar
 | SU_1400_001 | Barre |  | 1 |  | Design terminé
 | SU_1400_002 | Chape |  | 2 |  | Design terminé
 | SU_1400_003 | Pivot |  | 2 |  | Design terminé
 | SU_1400_004 | Couteau |  | 4 |  | Design terminé
 | SU_1400_005 | Biellette |  | 2 |  | Design terminé
SU_A1500 |  | Rear Anti Roll Bar
 | SU_1500_001 | Barre |  |  |  | Design terminé
 | SU_1500_002 | Chape (côté droit) |  | 1 |  | Design terminé | OUI
 | SU_1500_003 | Pivot |  |  |  | Design terminé
 | SU_1500_004 | Couteau |  | 4 |  | Design terminé | OUI
 | SU_1500_005 | Biellette |  |  |  | Design terminé
 | SU_1500_006 | Tube de la biellette |  |  |  | Design terminé
 | SU_1500_007 | assemblage biellette |  | 1 |  | Design terminé | OUI
 | SU_1500_008 | Chape (côté gauche)
SU_A01600 |  | Front shock assembly
 | SU_1600_001
 | SU_1600_002
 | SU_1600_003 | Chape Ohlins F

Sheet: Frame & Body
Frame & Body
Asm | Part # | Component | Description | Qté | date | Etat | Dessin technique | Vérification Dessin | Fournisseur | Numéro de commande | Prix | Masse théorique (g) | Masse réelle (g) | Localisation | Commentaire(s)
FR_A0100 |  | Frame
 | FR_0100_001 |  | RCS
 | FR_0100_002 | Anti intrusion plate | RCS | 1 |  | Design terminé
 | FR_0100_003 | Sleeve Joint | RCS | 2 |  | Design terminé
FR_A0200 |  | Impact attenuator
 | FR_0200_001 |  | PTN |  |  | Reçu
FR_A0300 |  | Pedal box | BDE
 | FR_0300_000_BA | Rail superieur pedale de frein |  | 1 | 2018-11-14 | Design terminé
 | FR_0300_001_BA | Branche pédale de frein |  | 1 | 2018-11-14 | Design terminé
 | FR_0300_002_BA | Branche pédale d'accélérateur |  | 1 | 2018-11-14 | Design terminé
 | FR_0300_003_BA | Cale bout de pied |  | 2 | 2018-11-14 | Design terminé
 | FR_0300_004_BA | Cale talon |  | 2 | 2018-11-14 | Design terminé
 | FR_0300_005_BA | Rail inférieur |  | 2 | 2018-11-14 | Design terminé
 | FR_0300_006_BA | Support latéral pédale de frein |  | 2 | 2018-11-14 | Design terminé
 | FR_0300_007_BA | Connecteur bouton d'arrêt d'urgence pédale de frein |  | 1 | 2018-11-14 | Design terminé
 | FR_0300_008_BA | Bouton d'arrêt d'urgence pédale de frein |  | 1 | 2018-11-14 | Design terminé
 | FR_0300_009_BA | Support bouton d'arrêt d'urgence pédale de frein |  | 1 | 2018-11-14 | Design terminé
 | FR_0300_010_BA | Support latéral gauche pédale d'accélérateur |  | 1 | 2018-11-14 | Design terminé
 | FR_0300_011_BA | Tige support câble pédale d'accélérateur |  | 1 | 2018-11-14 | Design terminé
 | FR_0300_012_BA | Cylindre répartiteur pédale de frein |  | 1 | 2018-11-14 | Design terminé
 | FR_0300_013_BA | Maitre cylindre |  | 2 | 2018-11-14 | Design terminé
 | FR_0300_014_BA | Axe répartiteur pédale de frein |  | 1 | 2018-11-14 | Design terminé
 | FR_0300_015_BA | Rotule répartiteur pédale de frein |  | 1 | 2018-11-14 | Design terminé
 | FR_0300_016_BA | Chape répartiteur pédale de frein |  | 2 | 2018-11-14 | Design terminé
 | FR_0300_017_BA | Cylindre vis répartiteur pédale de frein |  | 2 | 2018-11-14 | Design terminé
 | FR_0300_018_BA | Entretoise intérieure pédale de frein |  | 2 | 2018-11-14 | Design terminé
 | FR_0300_019_BA | Chape té de répartition |  | 1 | 2018-11-14 | Design terminé
 | FR_0300_020_BA | Rail supérieur pedale d'accélérateur |  | 1 | 2018-11-14 | Design terminé
 | FR_0300_021_BA | Cage a aiguille |  | 2 | 2018-11-14 | Design terminé
 | FR_0300_022_BA | Rondelle de butée |  | 4 | 2018-11-14 | Design terminé
 | FR_0300_023_BA | Vis épaulée HPC |  | 2 | 2018-11-14 | Design terminé
 | FR_0300_024_BA | Chape avant |  | 4 | 2018-11-14 | Design terminé
 | FR_0300_025_BA | Chape arrière |  | 4 | 2018-11-14 | Design terminé
 | FR_0300_026_BA | Manchon taraudé |  | 2 | 2018-11-14 | Design terminé
 | FR_0300_027_BA | Entretoise extérieure pédale de frein |  | 2 | 2018-11-14 | Design terminé
 | FR_0300_028_BA | Support latéral droit pédale d'accélérateur |  | 1 | 2018-11-14 | Design terminé
 | FR_0300_029_BA | Chape support bocal de liquide de frein |  | 1 | 2018-11-14 | Design terminé
 | FR_0300_030_BA | Bocal de liquide de frein |  | 2 | 2018-11-14 | Design terminé
 | FR_0300_031_BA | Couvercle bocal liquide de frein |  | 2 | 2018-11-14 | Design terminé
FR_A0400 |  | Floor pan
 | FR_0400_001 |  | CMI | 1 | 2018-11-24 | En cours de design
 | FR_0400_002
FR_A0500 |  | Clutch actuation system | Version levier
 | FR_0500_001 | Lever axis | MJT | 1 | 2018-11-22 | Design terminé | OUI
 | FR_0500_002 | Lever | MJT | 1 | 2018-11-22 | Design terminé | OUI
 | FR_0500_003 | cable cope | MJT | 1 | 2018-11-22 | Design terminé | OUI
 | FR_0500_004 | self-lubricating ring | MJT | 2 | 2018-11-22 | Design terminé | NON |  | SKF
 | FR_0500_005 | Circlip D14 | MJT | 1 | 2018-11-22 | Design terminé | NON
 | FR_0500_006 | Cable Protector | MJT | 2 | 2018-11-24 | Design terminé | OUI
 | FR_0500_007 | Cable sheath | MJT | 1 | 2018-11-22 | Design terminé | NON
 | FR_0500_008 | Clutch actuation Cable | MJT | 1 | 2018-11-22 | Design terminé | NON
 | FR_0500_009 | Nilstop nut | MJT | 2 | 2018-11-22 | Design terminé | NON
 | FR_0500_010 | Lock plate | MJT | 1 | 2018-11-24 | Design terminé | OUI
FR_A0600 |  | Shifter
 | FR_0600_001
 | FR_0600_002
FR_A0700 |  | Bodywork
 | FR_0700_001 | Nez | JKL | 1 |  | Design terminé
 | FR_0700_002 | Corps | JKL | 1 |  | Design terminé
FR_A0800 |  | Gearshiffting Paddles
 | FR_0800_001
 | FR_0800_002
FR_A0900 |  | Ergonomics
 | FR_0900_001 | Chapes harnais |  | 2

Sheet: Miscellaneous, Finish & Assembl
Miscellaneous, Finish & Assembly
Asm | Part # | Component | Description | Qté | date | Etat | Dessin technique | Vérification Dessin | Fournisseur | Numéro de commande | Prix | Masse théorique (g) | Masse réelle (g) | Localisation | Commentaire(s)
MS_A0100 |  | Firewall
 | MS_0100_001
 | MS_0100_002
MS_A0200 |  | Roll bar padding
 | MS_0200_001
 | MS_0200_002
MS_A0300 |  | Head restraint
 | MS_0300_001
 | MS_0300_002
MS_A0400 |  | Driver's seat
 | MS_0400_001 | Baquet
 | MS_0400_002 | Chapes |  | 4
MS_A0500 |  | Harness
 | MS_0500_001
 | MS_0500_002

Sheet: Electrical
Electrical
Asm | Part # | Component | Description | Qté | date | Etat | Dessin technique | Vérification Dessin | Fournisseur | Numéro de commande | Prix | Masse théorique (g) | Masse réelle (g) | Localisation | Commentaire(s)
EL_A0100 |  | Rear firewall instrument
 | EL_0100_001_AA | Regulator |  |  |  | Reçu
 | EL_0100_002_AA | Crash_sensor |  |  |  | Reçu
 | EL_0100_003_AA | break Light |  |  |  | Design terminé
 | EL_0100_004_AA | ECU |  |  |  | Reçu
 | EL_0100_005_AA | Power Box |  |  |  | Design terminé
 | EL_0100_006_AA | 40mm interrupter switch |  |  |  | Design terminé
EL_A0200 |  | Front vehicle electronics
 | EL_0200_001 | MK3
 | EL_0200_002
EL_A0300 |  | Battery assembly
 | EL_0300_001
 | EL_0300_002
 | EL_0300_003
 | EL_0300_004 | Chape 1 |  | 2
 | EL_0300_005 | Chape 2 |  | 1
EL_A0400 |  | Dashboard assembly |  |  |  | En cours de design
 | EL_0400_001_BD | Dashboard support |  | 1 |  | Design terminé
 | EL_0400_002_AA | Emergency stop button |  | 1 |  | Design terminé
 | EL_0400_003_AA | Blue LED Push button |  | 2 |  | Design terminé
 | EL_0400_004_AA | Push button reset motoreductor |  | 1 |  | Design terminé
 | EL_0400_005_AA | two position switch |  | 4 |  | Design terminé
 | EL_0400_006_AA | Push button |  | 1 |  | Design terminé
 | EL_0400_007_AA | LED Strip |  | 1 |  | Reçu
 | EL_0400_008_AA | three position switch |  | 1 |  | Design terminé
EL_A0401 |  | engaged gear display assembly
 | EL_0401_001_AA | 7 segment | display engaged gear | 1 |  | Design terminé
 | EL_0401_002_AA | printed circuit 7 segment display |  | 1 |  | En cours de design
 | EL_0401_003_AA | electrical components of the 7 segment display |  | 1 |  | En cours de design
EL_A0402 |  | 3*7 digit assembly
 | EL_04002_001_AA | 3*7 segment display | display motor temperature and batterie voltage | 1 |  | Design terminé
 | EL_04002_002_AA | printed circuit 3*7 segment display |  | 1 |  | En cours de design
 | EL_04002_003_AA | electrical components of the 3*7 segment display |  | 1 |  | En cours de design
EL_A0500 |  | Master switch assembly |  |  |  | Design terminé
 | EL_0500_001 | Master switch |  |  |  | Design terminé
 | EL_0500_002 | Master switch support |  |  |  | Design terminé
 | EL_0500_003 | DB-9 port |  |  |  | Design terminé
 | EL_0500_004 | Bracket |  | 2 |  | Design terminé | OUI | OUI
EL_A0600 |  | Box assembly
 | EL_0600_001 | Box |  | 2
 | EL_0600_002 | Cover |  | 2
 | EL_0600_003 | screw |  | 2
EL_A0700 |  | Chapes
 | EL_0700_001 | Chape push bouton |  | 2 |  | Design terminé | OUI | OUI | La mache Laser
 | EL_0700_002 | Chapes PowerBox |  | 2 |  | Design terminé | OUI | OUI | La mache Laser
 | EL_0700_003 | Chape Dashboard 1 |  | 1 |  | Design terminé | OUI | OUI | La mache Laser
 | EL_0700_004 | Chape Dashboard 2 |  | 1 |  | Design terminé | OUI | OUI | La mache Laser
 | EL_0700_005 | Chape Dashboard 3 |  | 1 |  | Design terminé | OUI | OUI | La mache Laser
 | EL_0700_006 | Chape Dashboard 4 |  | 1 |  | Design terminé | OUI | OUI | La mache Laser
 | EL_0700_007 | Chape Dashboard 5 |  | 1 |  | Design terminé | OUI | OUI | La mache Laser
 | EL_0700_008 | Chape Dashboard 6 |  | 1 |  | Design terminé | OUI | OUI | La mache Laser
 | EL_0700_009 | Chape Anderson (or booster) |  | 1 |  | Design terminé | OUI | OUI | La mache Laser
 | EL_0700_010 | Chape de masse |  | 1 |  | Design terminé | OUI | OUI | La mache Laser
 | EL_0700_011 | Chape_crash_sensor |  | 1 |  | Design terminé | OUI | OUI | La mache Laser
 |  |  |  | 1

Sheet: Wheels, Wheel Bearings & Tires
Wheels, Wheel Bearing & Tires
Asm | Part # | Component | Description | Qté | date | Etat | Dessin technique | Vérification Dessin | Fournisseur | Numéro de commande | Prix | Masse théorique (g) | Masse réelle (g) | Localisation | Commentaire(s)
WT_A0100 |  | Wheels assembly | Jantes, pneus, ... | 4 | 2018-12-15
 | WT_0100_001 | Oz Magnesium Rim |  | 1 |  | Reçu |  |  | Reverchon
 | WT_0100_002 | Hoosier 13" |  | 1 |  |  |  |  | ?
WT_A0200 |  | Front Hub |  | 2 | 2018-11-21 | Design terminé
 | WT_0200_001 | Front Hub | Moyeu avant | 2 |  | commande lancée | OUI | OUI | Boisard | 19B_WT_02001 |  | 492
 | WT_0200_002 | Brake Bell | Frette de frein | 2 |  | Design terminé | NON | NON | Boisard
 | WT_0200_003 | Front Bearing Washer | Entretoise pour eviter concentration de contrainte dans le moyeu | 2 |  | Design terminé | OUI | OUI | Boisard | 19B_WT_02003 |  | 39.9
 | WT_0200_004 | Speed sensor spacer | Entretoise pour positionner le disque capteur vitesse au milieu et aussi avoir un bon contact avec l'écrou encoche | 2 |  | Design terminé | OUI | OUI | La mache laser | 19M_WT_02004 |  | 2018-05-02
 | WT_0200_005 | Speed sensor disc | disque capteur vitesse style roue crantée | 1 |  | Design terminé | OUI | OUI | La mache laser | 19M_WT_02005 |  | 22
 | WT_0200_006 | Speed sensor spacer 3mm | Entretoise pour positionner le disque capteur vitesse au milieu | 1 |  | Design terminé | OUI | OUI | La mache laser | 19M_WT_02006 |  | 2018-08-03
WT_A0300 |  | Rear Hub |  | 2 | 2018-10-20 | Design terminé |  |  | Boisard
 | WT_0300_001 | Rear Hub | Moyeu arrière | 2 |  | Design terminé | OUI | OUI | Boisard | 19B_WT_03001 |  | 644.754 -cannelures
 | WT_0300_002 | Brake Bell | Frette de frein arrière | 2 |  | Design terminé | NON | NON | Acheté
 | WT_0300_003 | Rear Bearing Washer | Entretoise pour eviter concentration de contrainte dans le moyeu | 2 |  | Design terminé | OUI | OUI | Boisard | 19B_WT_03003 |  | 43.5
 | WT_0300_004 | Tripod Housing Spacer | Entretoise pour venir faire la précontrainte des roulements en serant le tripod housing | 2 |  | Design terminé | OUI | OUI | Boisard | 19B_WT_03004 |  | 33.7
 | WT_0300_005 | Speed sensor disc spacer | idem avant | 1 |  | Design terminé | OUI | OUI | La mache laser | 19M_WT_02004 |  | 2018-05-02
 | WT_0300_006 | Speed sensor disc | idem avant | 1 |  | Design terminé | OUI | OUI | La mache laser | 19M_WT_02005 |  | 22
 | WT_0300_007 | Speed sensor disc spacer 3mm | idem avant | 1 |  | Design terminé | OUI | OUI | La mache laser | 19M_WT_02006 |  | 2018-08-03

Sheet: Autre
Pour autres éléments : visseries spéciales, éléments pas intégré au véhicule, ...
Asm | Part # | Component | Description | Qté | date | Etat | Dessin technique | Vérification Dessin | Numéro de commande | Prix | Masse théorique (g) | Masse réelle (g) | Commentaire(s)
ESSAI_TRACTION
 | ESSAI_TRACTION_01 | Insert | Longueur collage 20 mm | 10 |  |  |  |  | 19B_TRACT_01
 | ESSAI_TRACTION_02 | Insert percage |  | 10 |  |  |  |  | 19B_TRACT_02
 | ESSAI_TRACTION_03 | Entretoises |  | 10 |  |  |  |  | 19B_TRACT_03
 | ESSAI_TRACTION_04 | Insert v2 | Longueur collage 25mm pour test avec tubes carbone |  |  |  |  |  | 19B_TRACT_04
ESSAI_ROTULES | ESSAI_ROTULES_01 | Entretoise rotule |  | 4 |  |  |  |  | 19B_ROTU_01
 | ESSAI_ROTULES_02 | Entretoise vis |  | 4 |  |  |  |  | 19B_ROTU_02
 | ESSAI_ROTULES_03 | Pièce bloc maintien vis rotule |  | 1 |  |  |  |  | 19B_ROTU_03
 | ESSAI_ROTULES_04 | Pièce bloc maintien plaque |  | 1 |  |  |  |  | 19B_ROTU_04
 | ESSAI_ROTULES_05 | Plaque blocage rotule |  | 1 |  |  |  |  | 19B_ROTU_05
 | ESSAI_ROTULES_06 | Plaque trou rotule H7 |  | 5 |  |  |  |  | 19B_ROTU_06
 | ESSAI_ROTULES_07 | Plaque trou rotule K7 |  | 5 |  |  |  |  | 19B_ROTU_07
 | ESSAI_ROTULES_08 | Plaque trou rotule M7 |  | 5 |  |  |  |  | 19B_ROTU_08
 | ESSAI_ROTULES_09 | Plaque trou rotule P7 |  | 5 |  |  |  |  | 19B_ROTU_09
 | ESSAI_ROTULES_10 | Entretoise presse bague ext M6 | Pour montage rotules à la presse |  |  |  |  |  | 19B_ROTU_10
