EOSCogniton/Intergen/03_Gestion_De_Projet/01_Documents Organisation/2019_Optimus/03_Gantt_Fabrication/Liste_Chapes_Vulcanix.xlsx

Sheet: Chapes par épaisseur
Nom/Acroche | Quantité | Système | Masse | Masse totale | Masse mesurée (g) | Masse mesurée totale (g) | Epaisseur | Fabriqué | Soudé | Localisation | Num | IGS | PLAN | Respo Mise en plan | Final
1,5 MM
cooling system back | 1 | EN | 0.005 | 0.005 | 6 | 6 | 1,5 mm | oui | oui | Bron | 1 | OUI | OUI | Antonio | ok
air intake | 2 | EN | 0.002 | 0.004 | 2.5 | 5 | 1,5 mm | oui | oui | Bron | 2 | OUI | OUI | Lucas | ok
Steering (ST_06_001) | 2 | ST | 0.044 | 0.088 | 40 | 80 | 1,5 mm + pliage | oui | oui | Bron | 3 | OUI | OUI | Antonio | ok
Break Light | 2 | EL | 0.003 | 0.006 | 2.5 | 5 | 1,5mm | oui | oui | Bron | 4 | OUI | OUI | Lucas | ok
Battery | 3 | EL | 0.003 | 0.009 | 2.666666667 | 8 | 1,5mm | oui | oui | Bron | 5 | OUI | OUI | Lucas | ok
Crash sensor | 1 | EL | 0.024 | 0.024 | 25 | 25 | 1,5mm | oui | oui | Bron | 6 | OUI | OUI | Antonio | ok | Ajustée avec un marteau et une pince
Masse | 3 | EL | 0.002 | 0.006 | 2 | 6 | 1,5mm | oui | oui | Bron | 7 | OUI | OUI | Antonio | ok
Tableau de bord haut | 2 | EL | 0.004 | 0.008 | 3.5 | 7 | 1,5 mm + pliage | oui | oui | Bron | 8 | OUI | OUI | Antonio | ok
tableau de bord bas | 2 | EL | 0.005 | 0.01 | 4 | 8 | 1,5 mm + pliage | oui | oui | Bron | 9 | OUI | OUI | Antonio | ok
master switch | 2 | EN | 0.002 | 0.004 | 0 |  | 1,5mm | oui | oui | Bron | 10 | OUI | OUI | Lucas | ok
Firewall | 24 | FR | 0.004 | 0.096 | 4.916666667 | 118 | 1,5mm | oui | oui | Bron | 11 | OUI | OUI | Antonio | ok
Firewall - Appui tête | 4 | FR | 0.007 | 0.028 | 4.25 | 17 | 1,5mm | oui | oui | Bron | 12 | OUI | OUI | Antonio | ok
bocaux equipe frein | 1 | FR | 0.006 | 0.006 | 7 | 7 | 1,5mm | oui | oui | Bron | 13 | OUI | OUI | Erwan | ok
T de repartition freinage | 1 | FR | 0.008 | 0.008 | 8 | 8 | 1,5mm | oui | oui | Bron | 14 | OUI | OUI | Erwan | ok
Fond plat | 10 | FR | 0.006 | 0.06 | 6.2 | 62 | 1,5mm | oui | oui | Bron | 15 | OUI | OUI | Antonio | ok
 |  |  |  |  |  |  |  |  |  |  | 16
Nez | 4 | FR | 0.007 | 0.028 | 7 | 28 | 1,5mm | oui | oui | Bron | 17 | OUI | OUI | Antonio
Ouïe avant | 2 | FR | 0.007 | 0.014 | 10 | 20 | 1,5mm | oui | oui | Bron | 18 | OUI | OUI | Antonio
Ouïe arrière | 2 | FR | 0.007 | 0.014 | 7 | 14 | 1,5mm | oui | oui | Bron | 19 | OUI | OUI | Antonio
Plaque anti-intrusion | 1 | FR | 1.528 | 1.528 | 1480 | 1480 | 1,5mm | oui | oui | Bron | 20 | OUI | OUI | Antonio
expansion tank | 2 | EN | 0.004 | 0.008 | 0 |  | 1.5mm | oui | non |  | 21 | OUI | OUI | Paco
fuel tank L | 1 | EN | 0.012 | 0.012 |  |  | 1.5mm | oui | non |  | 22 | OUI | OUI | Antonio | Envoyer en prod
fuel tank rear L | 1 | EN | 0.007 | 0.007 | 0 |  | 1.5mm | oui | non |  | 23 | OUI | OUI | Antonio | Envoyer en prod
fuel tank rear R | 1 | EN | 0.007 | 0.007 | 0 |  | 1.5mm | oui | non |  | 24 | OUI | OUI | Antonio | Envoyer en prod
fuel tank R | 1 | EN | 0.012 | 0.012 | 0 |  | 1.5mm | oui | non |  | 25 | OUI | OUI | Antonio | Envoyer en prod
Cash Cremailliere | 4 | FR | 0.001 | 0.004 | 0 |  | 1.5mm | oui | oui |  | 26 | OUI | OUI | Antonio | Envoyer en prod
Boitier carte avant | 3 | EN | 0.003 | 0.009 |  |  | 1.5mm | oui | oui |  | 27
3 MM
power distribution box | 4 | EL | 0.006 | 0.024 | 7 | 28 | 3mm | oui | oui | Bron | 101 | OUI | OUI | Paco |  | ok
bracket Jacking bar left | 1 | EN | 0.042 | 0.042 | 42 | 42 | 3mm | oui | oui | Bron | 102 | OUI | OUI | Paco |  | ok
bracket Jacking bar right | 1 | EN | 0.043 | 0.043 | 44 | 44 | 3mm | oui | oui | Bron | 103 | OUI | OUI | Paco |  | ok
differential assy tube sup | 4 | EN | 0.021 | 0.084 | 20 | 80 | 3mm | oui | oui | Bron | 104 | OUI | OUI | Paco
differential assy tube inf | 4 | EN | 0.019 | 0.076 | 19.5 | 78 | 3mm | oui | oui | Bron | 105 | OUI | OUI | Paco
chain shield sup | 1 | EN | 0.008 | 0.008 | 11 | 11 | 3mm | oui | oui | Bron | 106 | OUI | OUI | Paco |  | ok
cooling system up | 1 | EN | 0.021 | 0.021 | 21 | 21 | 3mm | oui | oui | Bron | 107 | OUI | OUI | Paco | ok, il y en a deux | ok
cooling system down pliee | 1 | EN | 0.048 | 0.048 | 46 | 46 | 3mm | oui | oui | Bron | 108 | OUI | OUI | Paco | Ok
 |  |  |  |  |  |  |  |  |  |  | 109 ??
Regulateur de pression | 1 | EN | 0.027 | 0.027 | 19 | 19 | 3mm | oui | oui | Bron | 110 | OUI | OUI | Aurélien | ok, masse Catia chelou | ok
pédalier tube avant | 4 | FR | 0.022 | 0.088 | 20.6 | 82.4 | 3mm | oui | oui | Bron | 111 | OUI | OUI | Aurélien | Fait en 5 fois par La Mache...
pédalier tube arrière | 4 | FR | 0.021 | 0.084 | 20 | 80 | 3mm | oui | oui | Bron | 112 | OUI | OUI | Aurélien | Fait en 5 fois par La Mache...
pedalier support gaine | 1 | FR | 0.022 | 0.022 | 22 | 22 | 3mm | oui | oui | Bron | 113 | OUI | OUI | Aurélien |  | ok
Siege dessous | 4 | MS | 0.004 | 0.016 | 4.75 | 19 | 3mm | oui | oui | Bron | 114 | OUI | OUI | Aurélien
Siège arrière | 2 | MS | 0.003 | 0.006 | 4.75 | 9.5 | 3mm | oui | oui | Bron | 115 | OUI | OUI | Aurélien | Fait en 4 fois par La Mache...
pompe vers tubulaire | 1 | EN | 0.004 | 0.004 | 6 | 6 | 3mm | oui | oui | Bron | 116 | OUI | OUI | Aurélien |  | ok
Sur radiateur | 3 | pas soudé | 0.003 | 0.009 | 0 |  | 3mm alu |  |  |  | 117 | NON | NON |  | Pas en acier
Shifter | 1 | EN | 0.015 | 0.015 | 11 | 11 | 3mm | oui | oui | Bron | 118 | OUI | OUI | Aurélien |  | ok
chain shield inf | 1 | EN | 0.023 | 0.023 | 23 | 23 | 3mm | oui | oui | Bron | 119 | OUI | OUI | Aurélien |  | ok
5mm
Moteur | 2 | EN | 0.039 | 0.078 | 48.5 | 97 | 5 mm | oui | oui | Bron | 201 | OUI | OUI
Basculeur de Suspension avant av | 2 | SU | 0.039 | 0.078 | 0 |  | 5mm | oui | oui | Bron | 202 | OUI | OUI | Antonio
Basculeur de Suspension avant arr | 2 | SU | 0.039 | 0.078 | 0 |  | 5mm | oui | oui | Bron | 203 | OUI | OUI | Antonio
Triangle arrière inf 1 (avant sup) | 2 | SU | 0.031 | 0.062 | 0 |  | 5mm | oui | oui | Bron | 204 | OUI | OUI | Antonio
Triangle arrière inf 2 (avant inf) | 2 | SU | 0.041 | 0.082 | 0 |  | 5mm | oui | oui | Bron | 205 | OUI | OUI | Antonio
Triangle arrière inf 5 (arr sup + biellete) | 2 | SU | 0.053 | 0.106 | 0 |  | 5mm | oui | oui | Bron | 206 | OUI | OUI | Antonio
Triangle arrière inf 6 (arr inf + biellete) | 2 | SU | 0.068 | 0.136 | 0 |  | 5mm | oui | oui | Bron | 207 | OUI | OUI | Antonio
Triangle arrière sup 1 (avant sup) | 2 | SU | 0.054 | 0.108 | 0 |  | 5mm | oui | oui | Bron | 208 | OUI | OUI | Antonio
Triangle arrière sup 2 (avant inf) | 2 | SU | 0.04 | 0.08 | 0 |  | 5mm | oui | oui | Bron | 209 | OUI | OUI | Antonio
Triangle arrière sup 3 (arr sup) | 2 | SU | 0.2 | 0.4 | 0 |  | 5mm | oui | oui | Bron | 210 | OUI | OUI | Antonio
Triangle arrière sup 4 (arr inf) | 2 | SU | 0.038 | 0.076 | 0 |  | 5mm | oui | oui | Bron | 211 | OUI | OUI | Antonio
Triangle avant inf 1 (avant sup) | 2 | SU | 0.025 | 0.05 | 0 |  | 5mm | oui | oui | Bron | 212 | OUI | OUI | Antonio
Triangle avant inf 2 (avant inf) | 2 | SU | 0.038 | 0.076 | 0 |  | 5mm | oui | oui | Bron | 213 | OUI | OUI | Antonio | Partiel
Triangle avant inf 3 (arr sup) | 2 | SU | 0.017 | 0.034 | 0 |  | 5mm | oui | oui | Bron | 214 | OUI | OUI | Antonio
Triangle avant inf 4 (arr inf) | 2 | SU | 0.028 | 0.056 | 0 |  | 5mm | oui | oui | Bron | 215 | OUI | OUI | Antonio
Triangle avant sup 1 (avant sup) | 2 | SU | 0.031 | 0.062 | 0 |  | 5mm | oui | oui | Bron | 216 | OUI | OUI | Arthur
Triangle avant sup 2 (avant inf) | 2 | SU | 0.04 | 0.08 | 0 |  | 5mm | oui | oui | Bron | 217 | OUI | OUI | Antonio
Triangle avant sup 3 (arr sup) | 2 | SU | 0.025 | 0.05 | 0 |  | 5mm | oui | oui | Bron | 218 | OUI | OUI | Antonio
Triangle avant sup 4 (arr inf) | 2 | SU | 0.041 | 0.082 | 0 |  | 5mm | oui | oui | Bron | 219 | OUI | OUI | Antonio
(double joint side bracket) | 4 | FR | 0.077 | 0.308 | 0 |  | 5mm | oui | oui | Bron | 220 | NON | NON |  | (On garde la sol des tubes)
double joint up bracket | 2 | FR | 0.095 | 0.19 | 0 |  | 5mm | oui | oui | Bron | 221 | NON | NON
Harnais inf | 2 | MS |  |  | 54.4 |  | 5mm | oui | oui | Bron | 222 | OUI | OUI | Aurélien | Fait en 6 fois par La Mache... | oeilet plus gros ou 2 chapes | soit plus epais et reduire section
 |  |  | 3.131
Usinage
Jacking bar | 1 | EN | 0.444 | 0.444 | 0 |  | tube usiné |  |  |  | 301 |  | NON
Tube fixation moteur | 2 | EN | 0.056 | 0.112 | 0 |  | tube usiné |  |  |  | 302 | OUI | OUI | Antonio
Poignée embrayage | 1 | MS | 0.017 | 0.017 | 0 |  | tube usiné |  |  |  | 303 | OUI | OUI | Jérôme
sleeve joint | 4 | FR | 0.115 | 0.46 | 0 |  | Tube usiné 32*2 |  |  |  | 304 |  | NON
Tubes tenant pivot direction (gauche/droite) | 2 | ST | 0.116 | 0.232 | 0 |  | usiné |  |  |  | 305 |  | NON
Tube tenant pivot direction (milieu) | 1 | ST | 0.074 | 0.074 | 0 |  | usiné |  |  |  | 306 |  | NON
Amortisseurs à l'arrière | 2 | SU | 0.046 | 0.092 | 0 |  | usinée |  |  |  | 307 |  | NON
Amortisseurs à l'avant | 1 | SU | 0.211 | 0.211 | 0 |  | usinée |  |  |  | 308 |  | NON
Basculeur de Suspension arriere | 2 | SU | 0.113 | 0.226 | 0 |  | usinée | oui | non | Bron | 309 |  | NON
pompe à essence (en alu?) | 1 | pas soudé | 0.013 | 0.013 | 0 |  |  |  |  |  | 310 | achete dans le commerce | NON
Chapes sur motoreducteur arrière | 1 | pas soudé | 0.007 | 0.007 | 0 |  | Alu usiné |  |  |  | 311 |  |  | Recuperer Olympix
Chapes sur motoreducteur avant | 1 | pas soudé | 0.004 | 0.004 | 0 |  | Alu usiné |  |  |  | 312 |  |  | Recuperer Olympix
Silencieux / exhaust |  | EN |  | 0
Total | 186 |  |  | 6.809
 |  |  |  |  |  | 2527.674

Sheet: LAS
Quel triangle ? |  | Quelle rotule ? | Chape au dessus ou en dessous de la rotule ?
Gauche |  |  |  | Gauche |  | Droite
 |  |  |  | Nouveau nom | Plan ok a priori |  | Plan
Avant | inf | avant | inf | SU_0200_007 | ok | SU_0200_011 | ok
 |  |  | sup | SU_0200_008 | ok | SU_0200_012 | ok
 |  | arriere | inf | SU_0200_009 | ok | SU_0200_013 | ok
 |  |  | sup | SU_0200_010 | ok | SU_0200_014 | ok
 | sup | avant | inf | SU_0100_007 | ok | SU_0100_011 | ok
 |  |  | sup | SU_0100_008 | ok | SU_0100_012 | ok
 |  | arriere | inf | SU_0100_009 | ok | SU_0100_013 | ok
 |  |  | sup | SU_0100_010 | ok | SU_0100_014 | ok
Arrière | inf | avant | inf | SU_0400_007 | ok | SU_0400_011 | ok
 |  |  | sup | SU_0400_008 | ok | SU_0400_012 | ok
 |  | arriere | inf | SU_0400_009 | ok | SU_0400_013
 |  |  | sup | SU_0400_010 | ok | SU_0400_014
 | sup | avant | inf | SU_0300_007 | ok | SU_0300_011
 |  |  | sup | SU_0300_008 | ok | SU_0300_012
 |  | arriere | inf | SU_0300_009 | ok | SU_0300_013
 |  |  | sup | SU_0300_010 | ok | SU_0300_014 | ok

Sheet: Liste des chapes
Nom/Acroche | Qté |  | Masse | Masse totale | Epaisseur
Electrical
Break Light | 2 |  | 0.003 | 0.006 | 1,5mm
Battery | 3 |  | 0.003 | 0.009 | 1,5mm
Crash sensor | 1 |  | 0.024 | 0.024 | 1,5mm
Tableau de bord haut | 2 |  | 0.004 | 0.008 | 1,5mm
Tableau de bord bas | 2 |  | 0.005 | 0.01 | 1,5mm
Masse | 3 |  | 0.002 | 0.006 | 1,5mm
power distribution box | 4 |  | 0.003 | 0.012 | 1,5mm
master switch | 2 |  | 0.002 | 0.004 | 1,5mm
 | Total: | 19
Engine & Powertrain
Engine | 2 |  | 0.039 | 0.078 | 5 mm
fuel tank Rear | 2 |  |  | 0
fuel tank right | 1 |  |  | 0
Fuel tank left | 1 |  |  | 0
bracket Jacking Bar left | 2 |  | 0.042 | 0.084 | 3mm
Jacking bar | 1 |  | 0.444 | 0.444 | tube usiné
differential assy tube sup | 4 |  | 0.021 | 0.084 | 3mm
differential assy tube inf | 4 |  | 0.019 | 0.076 | 3mm
chain shield | 2 |  | 0.008 | 0.016 | 3mm
pompe à essence vers tubulaire | 1 |  | 0.004 | 0.004 | 1,5mm
cooling system up 1 | 1 |  | 0.028 | 0.028 | 3mm
coling system down 2 pliee | 1 |  | 0.075 | 0.075 | 3mm
colling system back | 1 |  | 0.005 | 0.005 | 1,5 mm
Motoreductor/shifter | 1 |  | 0.015 | 0.015 | 3mm pliée
Regulateur de pression | 1 |  | 0.027 | 0.027 | 3mm | chape de merde discuter avec martin
Silencieux / exhaust |  |  |  | 0
Shifter | 1 |  | 0.015 | 0.015 | 3mm pliée | modifier de façon a pas faire plier, retourner le colier
 |  |  |  |  |  |  | dta s80
Admission | 2 |  | 0.002 | 0.004 | 1,5 mm
 | Total : | 28
FR - Frame
pédalier,tube avant | 4 |  | 0.022 | 0.088 | 3mm
pédalier tube arrière | 4 |  | 0.021 | 0.084 | 3mm
pedalier support gaine | 1 |  | 0.022 | 0.022 | 1,5mm | changer vers 3? | rq du top
bocaux equipe frein | 1 |  | 0.006 | 0.006 | 1,5mm
freinage (te de repartition) | 1 |  | 0.005 | 0.005 | 1,5mm
double joint side bracket | 4 |  | 0.077 | 0.308 | 5mm
double joint up bracket | 2 |  | 0.095 | 0.19 | 5mm
sleeve joint | 2 |  | 0.115 | 0.23 | Tube usiné 32*2
fond plat avant | 4 |  | 0.007 | 0.028 | 1,5mm
fond plat arriere | 6 |  | 0.007 | 0.042 | 1,5mm
Noise body front down bracket | 2 |  | 0.007 | 0.014 | 1,5mm
Noise body rear up bracket | 2 |  | 0.007 | 0.014 | 1,5mm
Ouïe chape avant | 2 |  | 0.007 | 0.014 | 1,5mm
Ouïe chape arrière sur main hoop | 2 |  | 0.007 | 0.014 | 1,5mm
Plaque anti-intrusion | 1 |  | 1.528 | 1.528 | 1,5mm
Paroie pare feu | 20 |  | 0.004 | 0.08 | 1,5mm
 | total: | 58
Miscellaneous
Appui tête sup | 2 |  | 0.012 | 0.024 | 1,5mm | changé vers 1,5
Appui tête inf | 2 |  | 0.007 | 0.014 | 1,5mm
Dessous Siege | 4 |  | 0.004 | 0.016 | 3mm
Derriere siege | 2 |  | 0.003 | 0.006 | 3mm
Poignée embrayage | 1 |  | 0.017 | 0.017 | tube usiné
Harnais inf | 2 |  | 0.037 | 0.074 | 4mm | oeilet plus gros ou 2 chapes
 | total | 13
Steering system
Steering brackets (ST_06_001) | 2 |  | 0.044 | 0.088 | 1,5 mm + pliage
Tubes tenant pivot direction (gauche/droite) | 2 |  | 0.116 | 0.232 | usiné
Tube tenant pivot direction (milieu) | 1 |  | 0.074 | 0.074 | usiné
Suspension
Amortisseurs à l'arrière | 2 |  | 0.046 | 0.092 | usinée
Amortisseurs à l'avant | 1 |  | 0.211 | 0.211 | usinée
Basculeur de Suspension avant 1 | 2 |  | 0.039 | 0.078 | 5mm
Basculeur de Suspension avant 2 | 2 |  | 0.039 | 0.078 | 5mm
Basculeur de Suspension arriere | 2 |  | 0.097 | 0.194 | usinée
Triangle arrière inf 1 (avant sup) | 2 |  | 0.031 | 0.062 | 5mm
Triangle arrière inf 2 (avant inf) | 2 |  | 0.041 | 0.082 | 5mm
Triangle arrière inf 5 (arr sup + biellete) | 2 |  | 0.053 | 0.106 | 5mm
Triangle arrière inf 6 (arr inf + biellete) | 2 |  | 0.068 | 0.136 | 5mm
Triangle arrière sup 1 (avant sup) | 2 |  | 0.054 | 0.108 | 5mm
Triangle arrière sup 2 (avant inf) | 2 |  | 0.04 | 0.08 | 5mm
Triangle arrière sup 3 (arr sup) | 2 |  | 0.2 | 0.4 | 5mm
Triangle arrière sup 4 (arr inf) | 2 |  | 0.038 | 0.076 | 5mm
Triangle avant inf 1 (avant sup) | 2 |  | 0.025 | 0.05 | 5mm
Triangle avant inf 2 (avant inf) | 2 |  | 0.038 | 0.076 | 5mm
Triangle avant inf 3 (arr sup) | 2 |  | 0.017 | 0.034 | 5mm
Triangle avant inf 4 (arr inf) | 2 |  | 0.028 | 0.056 | 5mm
Triangle avant sup 1 (avant sup) | 2 |  | 0.031 | 0.062 | 5mm
Triangle avant sup 2 (avant inf) | 2 |  | 0.04 | 0.08 | 5mm
Triangle avant sup 3 (arr sup) | 2 |  | 0.025 | 0.05 | 5mm
Triangle avant sup 4 (arr inf) | 2 |  | 0.041 | 0.082 | 5mm
 | Total : | 41
NB total d'equipement soudés | 164 |  | Masse totale : | 6.439
Equipement n'étant pas soudées sur le châssis
Fuel Tank chape en U | 4 |  | 0.029 | 0.116
cash can
pompe à essence (en alu?) | 1 |  | 0.013 | 0.013 | acheté dans le commerce a priori (à confirmer) |  | - modif de la chape qui entoure la pompe
Chapes sur motoreducteur arrière | 1 |  | 0.007 | 0.007 | Alu usiné
Chapes sur motoreducteur avant | 1 |  | 0.004 | 0.004 | Alu usiné
Chapes sur radiateur | 3 |  | 0.003 | 0.009 | 3mm alu
Nb non soudés | 10

Sheet: Chapes
Inventaire des Chapes
Nom / Accroche | Qté | Pole | Importance/cas de charge | Observations | Idées
Bocaux équipe de frein | 1 |  | benj | Doivent etre a une certaine distance de la plaque du chassi (à l’avant) 1 ou deux pouces, pour cela on fait plutot tangent au tube de devant
Nez | 4 | Carrosserie Benj | benj | bcp trop grosse la leurs
chapes de masse | 3 | Electronique IHM | 1 | 1 petite chape toujours la même pour la masse, protéger avant que le chassi aille en peinture | peut etre utiliseé la chappe d’accroche du sys electronique, du coup proteger en peinture
Pédalier | 8 | IHM Benj |  | Les chapes seront inclinées pour permettre une hauteur aux barres qui tiennent le pédalier, utiliser la chappe standart
Fond plat | 8 |  |  | Plan tangent au bas du tube et mettre 2 parties s il faut traverser le front hoop (decoupe lazer pliage) format en L (en variant l’angle)
Triangle | 32 | LAS | Chape 3 et 8 triangle arriere pas en contact - chape triangle avant 2 et 4sur le coude :/ | 4 chapes par triangle : Les plans d’en haut et d’en bas sont parallèles et on le même plan médian que les 2 autres et preferentiellement parraleles de 2 cotes → Le positionnement est très important | moule 3 pour les chapes d’en dessous
 |  |  |  | Le triangle donne l’épaisseur entre les deux. On fait un gabarit, découpé au laser et précis, où autour du trous pour les chapes triangles on a l’epaisseur voulue (environ 20mm d’ordre de grandeur) – pour ce qui est du parallelisme
 |  |  |  | pour l’orientation de la chape, on fait un troisiéme trou avec une rotule : On passe une tige filetée avec des écrous pour régler l’hauteur sur ces points(obtenue sur catia) | Faire un marbre avec déjà les appuis des chapes inferieures
Basculeur de suspension | 4 | LAS | 3 | Important le cas de charge !
Cash de Crémaillère | 4 |  | 1 | Facile a faire, pour proteger la crémaillère, juste en dessous du pilote, simple
Crémaillère voir la masse et note rsterring | 4 |  | 3 | 2 fixes et 2 libres, serieuses a concevoir, doivent permettre le démontage de la cremaière cf photo
amortisseur voir masse et noter | 4 | LAS | 3 | porte la voiture, 2 avant deux arrière, cas de charge important
Arbre volant voir masse et noter steering | 1 | Direction |  | Cylindre, attention au fait que soudure déforme la matiere. Des roulements entrent dedans – tolerance tres precise : options souder puis réusiner ou augmenter l’epaisseur pour diminuer la deformation mais on a du poids inutile
Poignée d’embrayage | 1 | Passage Vitesse |  | Un tube, peut etre fait sur place a la giraudiere 15mm environ, Attention au placement !! Peut etre en dernier, apres la place de siège le gars se met assis pour le confort
D’ouïe voir masse et noter | Environ 4 | Châssis | benj
Parroi pare feu | Ils avaient 14, mais c trop | IHM |  | une parroi en alu de 1,5 mm, plusieurs petites chappes pour l’accrocher, supporte que son poids, tout simple a faire, 0 effort, habillage
Harnais (ceinture) |  | IHM | 3 | super important, épaissuer minimum existe, soudée tout le long, faut que se soit gros, c dans le reglement. Eye bolts voir forums. Mieux de mettre 2 de chaque coté. Car le crochet de la ceinture doit pouvoir bouger. Acheter des anneaux Fsae | tab or bracket to which any harness is attached must fulfill the following requirements: Have a minimum cross sectional area of 60 sq. mm; minimum thickness of 1.6 mm ; Where lap belts and anti-submarine belts use the same attachment point, there must be a minimum cross sectional area of 90 sq. mm ; Where brackets are fastened to the chassis, two 6mm Metric Grade 8.8 (1/4 inch SAE Grade 5) fasteners or stronger must be used to attach the bracket to the chassis.
Radiateur | 3 |  |  | pas besoin d faire trop épaisse, pas bcp de charge, juste son poids, + pettit dimensionement, 3mm tranquile
reservoir Essence | 8 |  |  | pas d’effort, juste pour la tenir, le collier avec une tige filettee qui entre dans la chappe
Tenir le siege | 6 |  |  | voir combien de points le siege me donne, important a supporter le cas de charge | la photo est rop moche
Tableau de bord |  |  |  | Petites chappes, pas de cas de charge, 1,5 mm
T du circuit de frein | 2 |  |  | petites chappes, il me dira facile a faire mais a ne pas oublier
Carte éléctronique | peut etre
Appui de tête | 4 |  |  | Solides d’apres le reglement, 100kg dessus
Regulatuer de circuit d’essence |  |  |  | tenir, pas tres de cas de charge
Vase d’expansion d’eau | 1 ou 2 |  |  | voir avec a conception, tenir un bocal avec de l’eau, 3mm environ petit machin
Master switch | guillaume |  |  | pas de cas de charge
Calculateur moteur pas besoin | 3 |  |  | le poids du TTA * acc, pas forcement tres longue
Motoreducteur a refaire | 1 |  |  | Peut etre un peu longue avec plusieurs trous pour régler la position du motored
Moteur | 2 |  | 3
Cash chaîne | 2 |  |  | faut tenir un peu si jamais la chaine pete, mais 2mm suffit
Portes excentriques | 8 | tramssion |  | tenir le differentiel, la transmission secondaire
Tenir la baterie | 3 |  |  | 2 petites, la leur est moche
Pompe à essence | 2
Recuperateur de fluide - cash can prendre la masse alu | 2
Admission | 2
Réservoir - refaire | 4
Ideal gabarit pour toutes les chapes sinon
Chape pour le mechanicall attached rool Hoop Bracing
Selon Christophe
Pipo | Structurelle | Forte charge
1mm | 1,8mm | 2,5mm
1.5 | 3 | 5 | En pratique
 | Moteur suspension direction triangles reservoir transmission

Sheet: Analyses
Porte dif |  | Moteur |  | jack bar
x | 3801 | Norme | 1314.54 | norme | 1500
y | -5845 | angle | 0.1919862177 | angle | 2.56
 |  | x | 1290.388198 |  | -1253.383166
 |  | y | 250.8260568 |  | 824.0331546
