EOSCogniton/Intergen/07_Documents Techniques/01_Livrables_TOPs/Budget Optimus 2018_19.xlsx

Sheet: Budget saison 2019
Pôle | Détail | Quantité | Budget (Total € TTC) | Remarques | Détail budget | Total
Châssis | Moules Carrosserie | 1 | 4000.00 |  | Restant saison 2018 | 5800.00
 | Carrosserie | 1 | 0.00 | Aprovisionné par Bron, 1100 eu sinon | Budget avance | 10000.00
 | plaques latérales + tableau de bord | 1 | 0.00 | Approvisonné par Bron, 550 eu sinon | Budget saison 2019 | 34400.00
 | Cintrage Ateliers la Giraudière | 1 | 300.00 | Régularisation cintrage (à confirmer) | Crédit RCV perfo | 400.00
 | A2M essais traction |  | 120.00 |  | Budget PEs | 1200.00
 | Tubes carrés Osborn Metal |  | 511.46 |  | Prix exact
 | Peinture châssis | 1 | 330.00 | PSEP Industrie
Liaison au sol | Pneumatiques slick | 12 | 1000.00 | Achat 12 pneus slicks neufs
 | Pneus rallyes | 4 | 0.00 | Achat 4 pneus rallyes achaté sur Reverchon
 | Crémaillère + spline couplers + capteur position + crash box + appui tete +Volant | 1 | 2 403,48 | Formula Seven
 | Amortisseurs | 4 | 3300.00 | Ohlins
 | Roulements haute précision | 4 | 0.00 | Offerts par SKF
 | Rotules essais | 25 | 241.50 | Acheté chez Brammer
 | Usinage cannelures moyeux | 1 | 200.00 | Innomolds
 | Tubes carbones pour triangles |  | 800.00 | Mateduc composites
 | Maitre-cylindres | 2 | 1000.00 | Réutilisation de ceux d'Olympix
 | Freinage |  | 2200.00 | Beringer
 | Jantes O.Z. Magnésium | 8 | 2 760,00 | 8 jantes magnesium approvisionné par Reverchon
Motorisation | Bride réglementaire | 1 | 400.00 | AT power
 | Filtres à air | 3 | 250.00 | filtre à air pour en avoir de rechange - AT power
 | Boîte à air | 1 | 0.00 | Offerte (3000 euros)
 | Différentiel | 1 | 2274.90 | Drexler
 | Rampe injection | 1 | 100.00 | SurplusMoto
 | Porte_couronne | 1 | 100.00 | Brut
 | Tulipes + tripodes + axe transmission | 2 | 2100.00 | RCV performance
 | Kit pignon-couronne | 1 | 100.00 | France équipement
 | Embrayage anti-dribble, huile moteur, joints moteur, disques embrayages | 1 | 1400.00 | Maxxes
 | Motoréducteur | 1 | 1122.17
 | Axe motoréducteur + engrenages | 1 | 320.00 | HPC
 | Calculateur DTA + connecteurs | 1 | 1347.98 | DTA Fast
 | Pièces circuit d'essence | 1 | 650.00 | Pompe à essence, régulateur de pression, rampe d'injection, bouchon de remplissage
 | Carter moteur | 1 | 100.00
 | Collecteur échappement 4-2-1 | 1 | 2760.00 | Basé sur coût Vulcanix
 | Revétement collecteur | 1 | 320.00 | AB Decometal
 | Silencieux | 1 | 600.00 | Achat
 | Soudure alu (carter, vase expansion, réservoir) | 1 | 800.00 | Bery Inox
 | Ensemble Refroidissement | 1 | 600.00 | Radiateur, ventilateur, couvercle calorstat
Ergonomie et électronique | Palettes | 1 | 800.00
 | Capteur de vitesse | 4 | 400.00 | Texense
 | Siège | 1 | 100.00 | Estimation
 | Batterie | 1 | 430.00 | on en a déjà
 | Boitier acquisition capteurs | 1 | 654.29 | Autosportlabs
 | Connecteurs |  | 0.00 | Offert par SOURIAU
 | Electronique |  | 1000.00 | Boutons tableau de bord, LED, éléments du faisceau, carte arduino
Divers | Manyspace |  | 700.00
 | Communication |  | 1000.00 | Vêtements, supports de présentation
 | Camping FS |  | 2600.00 | A payer en mars, 2 compétitions
 | Inscription compétition |  | 3200.00 | 2 compétitions
 | Nourriture FS |  | 1000.00 | Carrefour, paiement à terme
 | Soudures diverses la Giraudière |  | 0.00 | A voir
 | Commandes supplémentaires Boisard |  | 0.00 | Usinage chez Alpentech diminue dépenses boisard
Prévisions pour impondérables | Moteur |  | 2 700,00 | Budget de Bron si jamais rachat 3ème moteur
 | Consommables |  | 1500.00
 | Reverchon |  | 1 260,00
 | Total |  | 42732.30 €
 | Budget |  | 51800.00 €
 | Economies sur fonds propres |  | 9067.70 €

Sheet: Suivi des devis
Tableau de gestion des devis et de commandes
Département | Date ajout | Responsable | Fournisseur | Description fournisseur (si nécessaire) | Prix TTC en euros | Délai d'appro | Description | Devis PDF déposé et envoyé | Etat de la commande | Si livré, stocké où ? | Remarques
Suspension |  |  |  |  |  |  |  |  | Vide
Suspension |  |  |  |  |  |  |  |  | Vide
Suspension |  |  |  |  |  |  |  |  | Vide
Suspension |  |  |  |  |  |  |  |  | Vide
Frame |  |  |  |  |  |  |  |  | Vide
Frame |  |  |  |  |  |  |  |  | Vide
Frame |  |  |  |  |  |  |  |  | Vide
Frame |  |  |  |  |  |  |  |  | Vide
Powertrain |  |  |  |  |  |  |  |  | Vide
Powertrain |  |  |  |  |  |  |  |  | Vide
Powertrain |  |  |  |  |  |  |  |  | Vide
Powertrain |  |  |  |  |  |  |  |  | Vide
Electrical |  |  |  |  |  |  |  |  | Vide
Electrical |  |  |  |  |  |  |  |  | Vide
Electrical |  |  |  |  |  |  |  |  | Vide
Electrical |  |  |  |  |  |  |  |  | Vide
Divers |  |  |  |  |  |  |  |  | Vide
Divers |  |  |  |  |  |  |  |  | Vide
Divers |  |  |  |  |  |  |  |  | Vide
Divers |  |  |  |  |  |  |  |  | Vide

Sheet: Avance budget
Département | Fournisseur | Description | Prix (TTC) | Délais d'approvisionnement | Personne responsable | Etat commande | Date commande | Si livré, stocké où ? | Remarques
Chassis equipé et carrossé | Osborn Metal | Tubes carrés | 511.46 € |  | RCS | Livré
Chassis equipé et carrossé | A2M Industrie | Essais traction | 120.00 € |  | RCS | Commandé
Elec | DTA Fast | controleur moteur avec les connecteurs qui vont avec | 1347.98 € | 1 semaines | Bob | Livré |  | Béatrice | Les frais de port ne sont pas compris et on devrais avoir une réduc de 20% | vient de loin (non pas vraiment)
Elec | Dunker motoren | Motoréducteur | 1155.60 € | 4-5 mois | Bob | Commandé |  |  | Il faut vérifier s'il il reste des cables au garage | longue car petite production
Elec | Autosport Lab | boitier d'acquisition | 792.29 € | 2 semaine | Bob | Livré
Elec | Watterott | 2 Shield Can pour Arduino | 42.26 € | 2 semaines ? | Bob | Livré
Elec | RS Components | Arduino et MCP23008 | 0.00 € |  |  | Livré
Elec | RS Components | Ruban LED | 43.46 € |  |  | Livré
LAS | Brammer | Rotules pour essais | 241.50 € |  |  | Livré
LAS | Formula Seven | Crémaillère avec capteur rotation et spine coupler, crash box, volant en carbone, mousse appuie-tête | 2403.48 € | 6 semaines | ABR | Livré |  |  | http://www.formula-seven.com/shop-products/steering-racks-w-rotative-sensor/ Manque volant carbone et crashbox | longue car attendent d'avoir un carnet de commande rempli
LAS | Reverchon (OZ Racing) | 8 Jantes magnésium | 2760.00 € |  | NGO | Livré |  |  |  | pas de partenariat et sponring possible
LAS | Reverchon | 4 pneus rally (150 eur unité) + nettoyant freins + equipements pilotes saison précédente | 1359.80 € |  |  | Livré
Moteur | Drexler | Différentiel | 2274.79 € | plusieurs mois | Ludovic | Livré |  |  | https://shop.drexler-automotive.com/limited-slip-differential/formula-student/
Moteur | Maxxess | Filtres, bougies, chaîne et autres | 1009.49 € |  |  | Commandé
Moteur | Accimoto | Moteur | 2700.00 € |  | Maxime | Livré
Divers | Locamail | Impressions | 354.52 € |  |  | Livré
Divers | LDLC | Prises et webcam | 284.48 € |  |  | Livré
 |  | Total : | 17401.11 € | Restant | 12.89 €
 |  |  |  | Restant pouvant être dépensé | 0€

Sheet: Avance 8000
Budget prévisionnel pour l'avance de budget |  |  |  |  |  | Excuse pour les avoir tot
Département | Approvisionnement | Fournisseur | Prix unité | Quantité | Prix
Liaison au sol mécatronique | rotules | Michaud Chailly | 300.00 € | 1 | 300.00 €
Liaison au sol mécatronique | Etrier de frein (2) | Beringer | 300.00 € | 2 | 600.00 €
Liaison au sol mécatronique | Disque de frein (4) | Beringer | 200.00 € | 4 | 800.00 € | test de résitance au matage des frette
Liaison au sol mécatronique | Amortisseur Ohlins | Ohlins | 704.17 € | 4 | 2816.68 € | Pour les caractériser sur une machine
Electronique | Potentiomètre linéaire | RS Components | 100.00 € | 1 | 100.00 €
Electronique | Fer à souder | RS Components | 300.00 € | 1 | 300.00 € | Pour pouvoir tester les carte électronique rapidement
Electronique | Cables elec | RS Components | 80.00 € |  | 80.00 €
Motorisation instrumentée | Consommable (huile, ...) | Maxxess | 400.00 € | 1 | 400.00 €
Motorisation instrumentée | Kit chaine | Maxxess | 200.00 € | 1 | 200.00 €
Motorisation instrumentée | Silencieux |  | 500.00 € | 1 | 500.00 € | Passage sur banc
Motorisation instrumentée | Embrayage anti dribble |  | 900.00 € | 1 | 900.00 € | Préparation du passage sur banc de l'an prochain
Motorisation instrumentée | Protection Thermique | Reverchon | 150.00 € | 1 | 150.00 € | Passage sur banc
Châssis équipée | plaques carbones |  | 700.00 € | 1 | 700.00 €
Châssis équipée |  |  |  |  | 0.00 €
Autres |  |  | 150.00 € | 1 | 150.00 €
 |  |  |  |  | 0.00 €
 |  |  |  |  | 0.00 €
 |  |  |  |  | 0.00 €
 |  |  |  | Total | 7996.68€

Sheet: Budget Bron Vulcanix 2018
DATE | FOURNISSEUR | DETAIL | MONTANT
2017-10-06 | FORCH | Divers Réorganisation Local | 2 050 €
2017-10-06 | SETAM | Etablis et étagères réorganisation local | 3 409 € | Fournisseurs connus de Bron :
TOTAL 2017 |  |  | 5 459 € | AD
2018-03-23 | CARBONE ONE | Carrosserie | 1 872 € | Durand Services
2018-03-30 | FORCH | Mallettes rangement et écrous nilstop | 298.81€
2018-04-09 | RS Components | Matériel Electronique | 70.80€
Mai-Juin | Durand | Matériel Electronique | env. 300€
TOTAL 2018 |  |  | 2 542 €
TOTAL |  |  | 8 001 €

Sheet: Budget Bron Optimus 2019
Nom | Fournisseur | Description | Prix (TTC) | Délais d'approvisionnement | Personne responsable | Etat commande | Date commande | Si livré, stocké où ? | Remarques
 |  | Total : | 4525.14 € | Restant | 5474.86 €
meuleuse air comprimé slim | Durand | Ks Tool | 80.00 € | 515.5030 | Brice |  |  |  | meuleuse slim, 25.000 RPM
fraise HM (10 fraises dedans) | Durand | Ks Tool | 150.00 € | 515.3210 | Brice |  |  |  | 10 fraises HM de chez KS tool
Douilles pour écrou de roues | Durand | Ks Tool |  | 515.0990 | Brice |  |  |  | 3 douilles longue (il faut la 19)
Extracteur de goujons | Durand | Ks Tool |  | 150.1330 | Brice
Clé à filtre à huile | Durand | Ks Tool |  | 155.5003 | Brice
Micro set de soudure | Durand | Ks Tool |  | 960.1160 | Brice
GRO 12V-35 Professional dans une L-BOXX, avec pack d’accessoires | ? | Bosch Pro | 130.00 € | 0 601 9C5 002 (ref site bosch) | Brice |  |  |  | équivalent dremel mais en bosch et sur batterie 12V ATTENTION : PRENDRE SANS BATTERIE
GSR 12V-20 Professional dans L-BOXX avec 2 batteries Li-Ion 3,0 Ah, 1 clip de ceinture, 1 porte-embout, 4 clips de couleur | ? | Bosch Pro | 220.00 € | 0 601 9D4 005 (ref site bosch) | Brice |  |  |  | Visseuse en 12V
Pince à sertir à 4 ergots | MOUSER |  | 400.78 € | 571-M22520/2-01 | GTI |  |  |  | Prix HT. |  | En cas de soucis, contacter le pôle élec.
Positionneur 22D Male | MOUSER |  | 99.42 € | 571-M22520/2-09 | GTI |  |  |  | Prix HT.
Positionneur 22D Fem | MOUSER |  | 99.42 € | 571-M22520/2-06 | GTI |  |  |  | Prix HT.
Fil 22 AWG | RS |  | 62.84 € | 918-5210 | GTI |  |  |  | Prix HT.
Fil 16 AWG | RS |  | 73.57 € | 789-3685 | GTI |  |  |  | Prix HT.
Fil 12 AWG low-cost | RS |  | 59.78 € | 113-5780 | GTI |  |  |  | Prix HT.
Fil 24 AWG | RS |  | 49.33 € | 229-1416 | GTI |  |  |  | Prix HT.
 |  |  |  |  |  |  |  |  |  | -> Si il y a besoin de dépenser + d'argent, contacter aussi le pôle élec (sérieusement)
Presse hydraulique d'établi |  |  |  |  |  |  |  |  | Peu en avoir une quitraine dans Bron, juste besoin de faire un carter de protection |  | Ouverture du budget au mois de janvier
Balance à peser |  | Special voiture | 1500.00 € |  |  |  |  |  | Pas super utile, en option
Fer à souder |  |  | 400.00 € |  |  |  |  |  | Weller chez RS
Visserie
Clé à filtre |  |  |  |  |  |  |  |  |  |  | Coordonnées :
Pince à sertir |  |  | 200.00 € |  |  |  |  |  | Besoin de plus de détails |  | Chef des travaux | arnaud.flandin@ac-lyon.fr | 06 87 14 29 57
Cisaille à tôle
Groupe électrogène portable |  |  | 1000.00 € |  |  |  |  |  | 800€ pour un 1000W, 1300 pour un 2000W chez Honda, (10i et 20i), pour info : une meuleuse 1200W,un ordi 200W pour un gros
outils carbure |  | pour le tour |  |  |  |  |  |  |  |  | Fournisseur
pistolet soufflette |  | On en a, c'est les adaptateurs qu'il manque |  |  |  |  |  |  | refaire l'ensemble du circuit à air de bron, prendre une seule taille de raccord |  |  | Durand | Restagraf | matériel électrique
Lampe de bureau |  |  |  |  |  |  |  |  |  |  |  |  | KS tools | A privilégier grosse réduction
sangles de routier |  | On en a déjà |  |  |  |  |  |  | achete des petite sangles de bonne qualité, avec des crochets inclus |  |  |  | Bosch | Très chere mais très bon
 |  |  |  |  |  |  |  |  |  |  |  |  | Facom | idem

Sheet: Commande Reverchon
Nom | reférence | prix
Kit de protection noir | 460094 | 159
velcro alu | 460013 | 39.9
clapet de mise à l'air | TRV67 | 39
Liquide de refroidissement
collier acier "ligarex"
Questions :
Embout femelle à souder pour le carter d'huile pour mettre un bouchon magnétique (page 221)
Balance poids par roue occasion

Sheet: Maxxess
Pour savoir les disponibilité et prix regarder les catalogue de chez Bihr |  |  |  | TOTAL | 880.05 €
Article | Marque | ref | Prix catalogue | Quantité | Total
filtre à huile | Hippofiltre | HF204RC | 12.00 € | 2 | 24.00 €
Filtre à air | Twin air |  | 25.00 € | 2 | 50.00 € | Page 85 catalogue Bihr consommable, choisir le diamètre du trou
chaine 80 maillons Or Sport XSR-G | AFAM | 4 501 764 | 81.90 € | 1 | 81.90 €
Maillon rapide correspondant | AFAM | 4 501 331 | 7.30 € | 5 | 36.50 €
Maillon rapide à riveter plein | AFAM | 4 501 206 | 7.30 € | 5 | 36.50 €
Pignon CBR600rr | AFAM |  | 25.00 € | 1 | 25.00 € | Page 324 bihr consommable, choix du nombre de dent, 13 à 17, type 20613
Couronne Alu cbr600rr | AFAM |  | 50.00 € | 1 | 50.00 € | Page 333 bihr conso, nbre de dent 39 à 48, type 11618
Bougie NGK Irridium | NGK |  | 25 | 8 | 200
Brosse à chaine | Muc-off | M035001 | 16.7 | 1 | 16.7
Nettoyant à chaine | Muc-off | 55030005 | 10.95 | 2 | 21.9
Dégraissant | Muc-off | 55030001 | 11.95 | 1 | 11.95
huile moteur 300V 10W40 4L | Motul |  | 80 | 3 | 240
Nettyant multi usage | Bihr |  | 29.9 | 2 | 59.8 | page 724 bihr conso
graisse motul Tech grease 300 200g | Motul |  | 12.9 | 2 | 25.8
clé pour embrayage honda origine |  |  |  |  | 0
porte mini fusible étanche |  |  |  |  | 0 | page 252 buhr outillage
Pompe à graisse 80ml | Pressol | 890514 |  |  | 0
Burette d'huile 125ml | Drapper Tools |  |  |  | 0
Collier ressort durites essence 8mm | Bihr | 891 700 13 |  | 10 | 0 | page 289 bihr outillage
Collier ressort durites essence 11mm | Bihr | 892 700 14 |  | 10 | 0
feuille à joint | Victor Reinz | 659 900 |  | 3 | 0 | page 332 bihr outillage
Décape Joint | Victor Reinz | 552 048 |  | 1 | 0
 |  |  |  |  | 0
embrayage anti dribble cbr600rr |  |  | 999 | 1 | 999
Disque d'embrayage lisse |  |  |  | 1 | 0
Disque d'embrayage rugueux |  |  |  | 1 | 0

Sheet: idée achat
Outillage |  |  | Consommable
pince à ecrou noyé |  |  | collier de serrage à oreille
~~presse d'établi ~~ | -> budget bron |  | collier de serrage à essence
pince pour collier de serrage |  |  | graisse pour rotule skf (ref plus tard)
clé pour embrayage cbr600rr origine |  |  | vis alu
douille de 19mm longue |  |  | Antidrible CBR (A vérifier qu'il n'y en a pas déja un sur la moto)
embout de vissage long |  |  | ~~Brut porte couronne ~~ | => deja recu
visseuse 12v | ~~https://www.peugeot-1810.com/electroportatif-sans-fil/perceuses-visseuses-sans-fil/perceuse-sans-fil-a-percussion-18v-2-bat-4ah-3684.html~~ | https://www.bosch-professional.com/fr/fr/products/gsr-12v-20-06019D4005 | Plaques bois pour découpe gabarits au Fablab
Pince à sertir pour connecteur Reverchon et boite à fusibles, par expl knipex 97 52 34 https://www.knipex.com/index.php?id=1216&L=3&page=group_detail&parentID=1299&groupID=1305 |  |  | papier à joint moteur | <- Ne pas acheter de papier à joint pour placo, on en a déjà assez à Bron.
Baladeuses
Dynamomètres
