EOSCogniton/Intergen/03_Gestion_De_Projet/01_Documents Organisation/01_Template_Outils/Template - Gantt.xlsm

Sheet: Introduction
Introduction :
L'objectif de cette feuille est de ...
Présentation des différentes pages :
Feuille | Description | Version | Date
Liste_ressources | Vous pouvez lister l'ensemble de vos ressources humaines | v0.1 | 2019-01-23
Planning | Feuille sous forme de gantt avec les listes des taches leur responsable et durée | v1.2 | 2019-01-31
Projets de feuilles :
Feuille | Description | Version | Date
Dashboard | Représentation de donner sous forme d'un tableau de bord avec des graphiques | v0.8 | 2019-01-31
Remarques :
On affecte une couleur à chaque trigramme en fonction de l'année
On affecte une couleur à chaque pole avec un logo
Contact :
nicolas Gameiro
nicolas.gameiro@ecl17.ec-lyon.fr

Sheet: Dashboard
Tableau de Bord : Gestion de Projet EPSA

Sheet: Planning_Prod
Planning Prévisionnel
Projet : Fabrication STUF'2019
Date de début : 01 Décembre 2018 | 2018-12-01
Jour J : | -632 | jours restants
Date de fin : 17 Mars 2019 | 2019-03-17
Version : 1.4 du 14/01/19 | 2020-12-08
Tâche à accomplir | Respo | Etat | Janvier
 |  |  | 1 | 2 | 3 | 4 | 5 | 6 | 7 | 8 | 9 | 10 | 11 | 12 | 13 | 14 | 15 | 16 | 17 | 18 | 19 | 20 | 21 | 22 | 23 | 24 | 25 | 26
La Mache Laser
Préparer les igs et MEP de la 1er vague (1,5 mm) | CEE | Terminée
Production de la 1er vague | CEE | Terminée
Préparer les igs et MEP de la 2er vague (Chapes LAS & S700) | CEE | Terminée
Production de la 2er vague | CEE | Terminée
Préparer les igs et MEP de la 3e vague (S355) | CEE | Terminée
Production de la 3e vague | CEE | Terminée
Préparer les igs et MEP de la 4e vague (2017A) | CEE | Terminée
Production de la 4e vague | CEE | En cours
Boisard
Commander les brutes alu 7075 T6 | MPL | Terminée
Envoyer les premieres pièces | MPL | Terminée
Production pièces soudés sur le châssis (direction & moteur) | MPL | Bloquée
Reception des brutes | MPL | Terminée
Envoyer des pièces aluminium 7075 T6 | MPL | Terminée
Production du PE | MPL | Terminée
Production du Moyeu | MPL | Bloquée
Production chapes suspensions arrières | MPL | Bloquée
Production du Porte Moyeu | MPL | Bloquée
La Mache Productique
Préparer les igs et MEP de la 1er vague (entretoises) | CEE | Terminée
Production de la 1er vague | CEE | Terminée
Préparer les igs et MEP de la 2er vague | CEE | Terminée
Production de la 2er vague | CEE | A faire
Alpentech
Faire les mises en plan | ABR | Terminée
Contacter AlpenTech | ABR | Terminée
Commander les brutes | ABR | Terminée
Production | ABR | Terminée
La Gir
Contacter Flash Cintrage | RCS | Terminée
Préparer fichiers pour Flash Cintrage | RCS | Terminée
Amener les tubes chez Flash Cintrage | RCS | Terminée
Cintrage des tubes (2 jours) | RCS | Terminée
Récupérer des arceaux | RCS | Terminée
Préparer les fichiers pour Noel Metal | RCS | Terminée
Amener les tubes chez Noel Metal | RCS | Terminée
Découpe des tubes | RCS | Terminée
Récupérer les tubes chez Noel Metal | RCS | Terminée
Réaliser un devis chez A2M (test pièces) | RCS | Terminée
Amener les échantillons chez A2M | RCS | Terminée
Récupérer les échantillons chez A2M | RCS | Terminée
Préparer fichiers pour Vernay | RCS | Terminée
Soudure du chassis | RCS | Terminée
Soudure de l'avant de la structure tubulaire | RCS | Terminée
Soudure de l'arriere de la structure tubulaire | RCS | Terminée
Réalisation des gabarits | EDP | Terminée
Soudure des chapes | RCS | En retard
Soudure des premières chapes sans gabarits | RCS | Terminée
Reprise des chapes à la meuleuse | ABR | Terminée
Récupérer le châssis pour échappement | ABR | Terminée
Découpe tubes pour crise chassis | RCS | Terminée
Découpe des mauvais tubes & soudures bons | RCS | Terminée
Soudure des dernières chapes (nouvelles las, ARB, pare feu) | RCS | Terminée
Essais traction
Réserve séance et machine de TP IDM | PCT | Terminée
Préparer les pièces et outils nécesssaire pour le montage | PCT | Terminée
Réalisation des essais 1 (rotules et collage alu-alu) | PCT | Terminée
Réserve séance et machine de TP IDM | PCT | Terminée
Préparer les pièces et outils nécesssaire pour le montage | PCT | Terminée
Réalisation des essais 2 (collage alu-carbone) | PCT | Terminée
Gabarits
Réaliser gabarits chapes elec | BAT | Terminée
Réaliser gabarits chapes pédalier | BDE | Terminée
Réalisation des gabarits de triangles | ABR | Terminée
Réalisation des gabarits de direction | EDP | Terminée
Chape basculeur avant | PCT | Terminée
Equerres BAR Av | PCT | Terminée
Equerres BAR Ar | PCT | Terminée
Chape en U olhins Ar | PCT | Terminée
Gabarit pour mise en postion des couteaux | PCT | Terminée
Réaliser le gabarits chapes Portes excentriques | MPY | Terminée
Réaliser gabarits chapes carrosserie | JKL | Terminée
Faire les mises en plan des gabarits | PCT | Terminée
Découper les gabarits Fablab | BAT | Terminée
ECL
Contacter B.Houx pour usinage Porte Couronne | MPY | Terminée
Usinage Porte couronne | MPY | Terminée
PSEP
Reprendre contact avec PSEP | RCS | Terminée
Fixer la couleur et la date pour amener le châssis | RCS | En cours
Amener le châssis | RCS | A faire
Peinture sur châssis | RCS | A faire
Récupérer le châssis peint | RCS | A faire
Bery Inox
Contacter Bery Inox | CEE | Terminée
Demander la commande des brutes | CEE | Terminée
Fixer une date pour amener le moteur | CEE | Terminée
Préparer les documents nécessaires | CEE | Terminée
Amener le moteur | CEE | Terminée
Soudure de l'échappement hors châssis | CEE | En cours
Amener le châssis | CEE | A faire
Soudure de l'échappement sur châssis | CEE | A faire
Commande
Faire liste des commandes chez SFK | EDP | Terminée
Commander chez SFK | EDP | En cours
Lister les raideur nécessaires | PCT | Terminée
Commander des amortisseurs et ressorts Ohlins | PCT | Terminée
Commander des axes de transmission | MPY | Terminée
Commander Maxxess | MPL | Terminée
Commander Reverchon | MPL | En cours
Commander circuit essence | BVL | En cours
Commander la carrosserie Bron | NGO | Terminée
Commander la carrosserie Centrale | JKL | Terminée
Lister commandes Faiseau electroniquer | BAT | A faire
Commander chez RS | BAT | A faire
Commander chez Mouser | BAT | A faire
Commande des textiles Asso | NGO | A faire
Commande Bron
Commande Meuleuse et Durand Servie divers | NGO | Terminée
Commande carrosserie | JKL | Terminée
Commande Mouser | BAT | Terminée
Association
Soirée remerciement | PTN | Terminée
EPSAlten | PTN | Terminée
Video d'intégration | PTN | En cours
Réparation du git Intergen | PTN | Terminée
Inviter Debouck au FS | PTN | En cours
Recontacter Prismadd | PTN | En cours
Partenariat Nexter Group | PTN | En cours
Définition du Roll Out | PTN | En cours
Plannification du roll out | PTN | En cours
Crise Incendie Boisard
Lister l'ensemble des entreprises alternatives à Boisard | NGO | Terminée
Préparer un mail de demande de partenariat | AMS | Terminée
Préparer les MEP et igs des pièces à faire | MPL | Terminée
Définir les pièces urgents | NGO | En cours
Envoyer un mail urgent à La Mache | CEE | Terminée
Affecter les entreprises à des responsables | NGO | En cours
Démarcher les entreprises sélectionnées | NGO | En cours
Formation 1As
Lister les formations à réaliser | NGO | En cours
Préparer formation transmission secondaire | LDN | A faire
Préparer formation liaison au sol | PCT | A faire
Préparer formation motorisation | PTN | A faire
Préparer formation chassis | RCS | A faire
Préparer formation Mecamaster | MPL | A faire
Préparer le planning des formations 2As | NGO | A faire
Direction Projet
Plannifier soudure des chapes | NGO | Terminée
Plannifier présentation Brice chez Boisard | NGO | Terminée
Affection des responsable fournisseurs | YRI | Terminée
Plannifier la cartographie à Chambery | NGO | A faire
Prévoir paiement pour compétitions | YRI | Terminée
Plannifier TOP Organe et moteur | NGO | Terminée
Envoyer le mail TOP Organe | NGO | Terminée
Préparer le diapo TOP Organe | NGO | Terminée
Inscription FS ATA | NGO | Terminée
Prévenir Béatrice en avance du paiement | NGO | Terminée
Paiement du FS ATA | NGO | Terminée
Réserver salle quizz compétition | NGO | Terminée
S'inscrire sur l'ensemble des sites FS | NGO | Terminée
Prévoir équipement (caméra,micro) quizz compétition | NGO | Terminée
Paiement du FSN | NGO | Terminée
Imprimer les deadlines des compétitions & ajouter au Gantt | NGO | En cours
Prévoir TOP Véhicule La Gir | NGO | A faire
Préparer Slide TOP Véhicule | NGO | A faire
 | A faire | 19
 | En cours | 17
 | Terminée | 100
 | Bloquée | 4
 | En retard | 1
 | Total | 141
 | Jalon | Date
 | TOP Organe | 2019-02-05
 | TOP Véhicule | 2019-03-15

Sheet: Planning_Projet
Planning Prévisionnel
Projet :
Date de début : | 2018-12-01 |  |  |  | Mettre vacances des partenaires et les rencontrer !
Jour J : | -632
Date de fin : | 2019-03-17
Version : 1.4 du | 2020-12-08 |  | Définition des objectifs |  |  |  | Modélisation |  |  |  |  | Préconception & 1er Appro |  |  |  |  |  |  |  |  |  |  |  |  | Conception & dimensionnement |  |  |  |  |  |  |  |  |  |  | Pré-Fabrication |  |  |  |  |  |  | Fabrication
Tâche à accomplir | Respo | Etat | Avril |  |  |  | Mai |  |  |  |  | Juin |  |  |  | Juillet |  |  |  | Aout |  |  |  |  | Septembre |  |  |  | Octobre |  |  |  |  | Novembre |  |  |  | Décembre |  |  |  | Janvier |  |  |  | Février |  |  |  | Mars |  |  |  | Avril
 |  |  | S14 | S15 | S16 | S17 | S18 | S19 | S20 | S21 | S22 | S23 | S24 | S25 | S26 | S27 | S28 | S29 | S30 | S31 | S32 | S33 | S34 | S35 | S36 | S37 | S38 | S39 | S40 | S41 | S42 | S43 | S44 | S45 | S46 | S47 | S48 | S49 | S50 | S51 | S52 | S1 | S2 | S3 | S4 | S5 | S6 | S7 | S8 | S9 | S10 | S11 | S12 | S13 | S14 | S15 | S16 | S17 | S18
Direction Projet |  |  |  |  |  |  |  |  |  |  |  |  |  |  |  | Vacances |  |  |  |  |  |  |  |  |  |  |  |  |  |  |  |  |  |  |  |  |  |  |  |  | Vacances Noel
Tache 1
Tache 2 |  | Terminée
Tache 3 |  | Terminée
Département LAS
Tache 1
Tache 2 |  | Terminée
Tache 3 |  | Terminée
Département Motorisation
Tache 1
Tache 2 |  | Terminée
Tache 3 |  | Terminée
Département Châssis équipé
Tache 1
Tache 2 |  | Terminée
Tache 3 |  | Terminée
Département Electronique
Tache 1
Tache 2 |  | Terminée
Tache 3 |  | Terminée

Sheet: Planning
Numéro | Nom | Durée | Prédecesseur | Retard | Début | Fin | 2019-01-25 | 2019-01-26 | 2019-01-27 | 2019-01-28 | 2019-01-29 | 2019-01-30 | 2019-01-31 | 2019-02-01 | 2019-02-02 | 2019-02-03 | 2019-02-04 | 2019-02-05 | 2019-02-06 | 2019-02-07 | 2019-02-08 | 2019-02-09 | 2019-02-10 | 2019-02-11 | 2019-02-12
1 | Fixer Date et Heure | 1 |  | 0 | 2019-01-25 | 2019-01-25 | Fixer Date et Heure
2 | Fixer le lieu | 1 | 1 | 0 | 2019-01-26 | 2019-01-26 |  | Fixer le lieu
3 | Définir les invités | 1 | 2 | 0 | 2019-01-27 | 2019-01-27 |  |  | Définir les invités
4 | Envoyer les invitations | 7 | 3 | 0 | 2019-01-28 | 2019-02-03 |  |  |  | Envoyer les invitations
5 | Faire visuel Calendrier | 1 | 3 | 0 | 2019-01-28 | 2019-01-28 |  |  |  | Faire visuel Calendrier
6 | Lancer comande calendrier | 7 | 5 | 0 | 2019-01-29 | 2019-02-04 |  |  |  |  | Lancer comande calendrier
7 | Faire Maquette goodies | 3 | 3 | 0 | 2019-01-28 | 2019-01-30 |  |  |  | Faire Maquette goodies
8 | Fabriquer Goodies | 2 | 7 | 0 | 2019-01-31 | 2019-02-01 |  |  |  |  |  |  | Fabriquer Goodies
9 | Tâche 9 | 2 | 8 | 0 | 2019-02-02 | 2019-02-03 |  |  |  |  |  |  |  |  | Tâche 9
10 | Tâche 10 | 5 | 9 | 0 | 2019-02-04 | 2019-02-08 |  |  |  |  |  |  |  |  |  |  | Tâche 10
11 | Tâche 11 | 4 | 10 | 0 | 2019-02-09 | 2019-02-12 |  |  |  |  |  |  |  |  |  |  |  |  |  |  |  | Tâche 11
Détails du Projet
Désignation | Soirée remerciement sponsors
Responsable : | PTN
Début : | 2019-01-25
Fin : | 2019-02-13
Durée : | 19
J Restants : | -664

Sheet: Data
Prénom | Nom | Trigramme | Année | Département | Nb tache
Aurélien | Bienner | ABR | 3A | Suspension | 7 | Date : | 2020-12-08
Arthur | Perdereau | APU | 3A | Suspension | 0
Guillaume | Touzé | GTE | 3A | Suspension | 0 | Effectifs
Guillaume | Tsilieski | GTI | 3A | Electrical | 0 | 3A | 7
Brice | Roblot | BRT | 3A | Advisor | 0 | 2A | 16
Antoine | Elain | AEN | 3A | Advisor | 0 | 1A | 22
Antoine | Maros | AMS | 3A | Advisor | 1 | Total | 45
Nicolas | Gameiro | NGO | 2A | Management | 25 | Data1 | Data2 | Data3
Maxime | Proriol | MPL | 2A | Management | 13 | #N/A | #N/A | 25
Paco | Tanchon | PTN | 2A | Management | 10 | #N/A | 13 | #N/A
Pierre Alexis | Corpechot | PCT | 2A | Suspension | 15 | #N/A | 10 | #N/A
Erwan | De Longcamp | EDP | 2A | Suspension | 4 | #N/A | 15 | #N/A
Bob | Auboin | BAT | 2A | Electrical | 6 | 4 | #N/A | #N/A
Mathieu | Pinay | MPY | 2A | Engine & Powertrain | 4 | #N/A | 6 | #N/A
Batiste | Vidal | BVL | 2A | Engine & Powertrain | 1 | 4 | #N/A | #N/A
Clement | Emerique | CEE | 2A | Engine & Powertrain | 21 | 1 | #N/A | #N/A
Ludovic | Beguin | LDN | 2A | Engine & Powertrain | 1 | #N/A | #N/A | 21
Robin | Clamens | RCS | 2A | Frame & Body | 27 | 1 | #N/A | #N/A
Josselin | Kiefel | JKL | 2A | Frame & Body | 3 | #N/A | #N/A | 27
Yohan | Reguiai | YRI | 2A | Frame & Body | 2 | 3 | #N/A | #N/A
Agostino | Cembelo | ACO | 2A | Frame & Body | 0 | 2 | #N/A | #N/A
Michele | Romaneli | MRI | 2A | Frame & Body | 0 | 0 | #N/A | #N/A
Andrea | Possema | APA | 2A | Frame & Body | 0 | 0 | #N/A | #N/A
Thibault | Lassus | TLS | 1A | Engine & Powertrain | 0 | 0 | #N/A | #N/A
Aimery | Sauliere | ASE | 1A | Engine & Powertrain | 0
Idriss | Gouhaga | IGH | 1A | Engine & Powertrain | 0
Ghassen |  | GLD | 1A | Engine & Powertrain | 0
Mathieu | Jacquet | MJT | 1A | Engine & Powertrain | 0
Erwan | Benkara | EBA | 1A | Engine & Powertrain | 0
Michele | Schio | MSO | 1A | Suspension | 0
Victor | Hugo | VDO | 1A | Suspension | 0
Paul | Charcaluk | PCK | 1A | Suspension | 0
Pierre Emmanuel | Ariaux | PAX | 1A | Suspension | 0
Arthur | Delort | ADT | 1A | Suspension | 0
Martin | Kasinsky | MKI | 1A | Suspension | 0
Camille | Simon | CSN | 1A | Frame & Body | 0
Come | Archinard | CAD | 1A | Frame & Body | 0
Pierre guillaume | Thomas | PCK | 1A | Frame & Body | 0
Mattei | Calixthe | PCK | 1A | Frame & Body | 0
Tanguy | Maurin | TMN | 1A | Frame & Body | 0
Arthur | Rodriguez | ARZ | 1A | Electrical | 0
Corentin | Lepais | CLS | 1A | Electrical | 0
Bruno | Morera | BMA | 1A | Electrical | 0
Romain | Martin | RMN | 1A | Electrical | 0
Martin | Gomez | MGZ | 1A | Electrical | 0
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
