EOSCogniton/Intergen/07_Documents Techniques/01_Livrables_TOPs/01_Livrables_TOP_Projet/Budget_Heure_Homme_Optimus.xlsx

Sheet: TEMPS INTER-TOP
 | Nombre de semaine entre TOP | Nombre d'heure |  | Nombre heures par semaines par homme | 6
Phase de conception
TOP Pré Dim -- TOP Appro | 3 | 216 |  | Effectif de l'équipe
Vacances | 9 | 648 |  | Pôle | nombre
Rentrée -- TOP Saison | 3 | 216 |  | LAS | 4
TOP Saison -- TOP Synthèse | 1 | 72 |  | Motor | 4
TOP Synthèse -- TOP Copeau | 5 | 360 |  | Elec | 1
Phase de fabrication & Intégration |  | 648 | Sous Total | Chassis | 2
TOP Copeau -- TOP Organe | 9 | 648 |  | Aéro | 1
TOP Organe -- TOP Véhicule | 6 | 432 |  | Total | 12
TOP Véhicule -- TOP Moteur | 2 | 144
Total | 38 | 3384
temps équi réparti |  | 846 | h/h par pole

Sheet: GLOBAL
BUDGET Heure/Homme GLOBAL |  | en semaine | Commentaire
S1 LASMECA | 240
S2 MOTORISATION INSTRUMENTEE | 186
S3 CHASSIS EQUIPEE ET PACK AERO | 166
S4 SEISM | 88
AUTRE | 9
TEMPS TOTALE (h) | 689
Nombre heures par semaines par homme | 6

Sheet: LASMECA
BUDGET Heure/Homme S1: LASMECA |  | en semaine | Commentaire
Amortisseurs | 32 | 4
Barre anti roulis | 32 | 4 | modèle et dimensionnement en torsion + packaging
Triangles | 40 | 5 | choix points de suspensions + collage
Système de freinage | 16 | 2 | compréhesion et choix appro
Roue équipée | 64 | 8 | Pas mal de conception et dimensionnement
Pneus | 16 | 2 | Appro récupération
Jantes | 8 | 1 | Appro en magnésium (voir OZ racing)
Direction | 32 | 4 | comprendre modéle + comparaison avec résultats réel de vulcanix + appro + conception collone de drémaillère
TEMPS TOTALE (h) | 240
Nombre heures par semaines par homme | 8

Sheet: CHASSIS EQUIPE ET AERO
BUDGET Heure/Homme S3: CHASSIS EQUIPE ET PACK AERO |  | en semaine | Commentaire
Châssis tubulaire | 70 | 6 | dessin filaire du chassis
Equipements | 30 | 4 | faciliter les chapes (tubes rectangles endroits clé ?)
Paroi pare feu | 22 | 2
Fond plat | 10 | 2
Plaque anti intrusion | 10 | 2
Carrosserie | 24 | 4 | conserver celle de vulcanix
Apendices aéro | 0 | 12 | à justifier car bcp de travail et pas forcément rentable
TEMPS TOTALE (h) | 166
Nombre heures par semaines par homme | 6

Sheet: MOTORISATION INSTRUMENTEE
BUDGET Heure/Homme S2: MOTORISATION INSTRUMENTEE |  | en semaine | Commentaire
Admission | 18 | 3
Echappement | 18 | 3 | Modification de celui de vulcanix
Moteur | 30 | 5 | temps d'appro
Système de lubrification | 0 | 0 | Pas fait cette année
Circuit de carburant | 24 | 4
Refroidissement | 24 | 4
Différentiel | 36 | 6
Arbres de transmission | 6 | 1
Autres éléments de transmission secondaire | 12 | 2
Mulet thermodynamique | 18 | 3
TEMPS TOTALE (h) | 186
Nombre heures par semaines par homme | 6

Sheet: SEISM
BUDGET heure/homme S4: SEISM |  | en semaine | Commentaire
Faisceau électrique | 32 | 4
Tableau de bord | 8 | 1 | normalement fais par un 0A sinon ce sera pas long
Volant équipé | 0 | 0 | Très surement appro chez FormulaSeven
Commande BV | 24 | 3
Télémétrie | 24 | 3
Interface télémétrie | 24 | 3
TEMPS TOTALE (h) | 88 | 11
Nombre heures par semaines par homme | 8
