EOSCogniton/Intergen/07_Documents Techniques/01_Livrables_TOPs/06_Livrables_TOP_Synthèse/Référentiel standard de production.xlsx

Sheet: Introduction
Il est possible de choisir le statut des pièces (la liste des possibilités et parmi les états référencés dans la feuille "Statistiques"
Feuille | Fonctionnement
Feuille partenaire
Feuille Statistique

Sheet: Statistiques
Statistiques Qualité Cognitive et Physique des Pièces PFFV des Kits de Montage des Systèmes du véhicule STUF'2019-Optimus
Statue | La Mache Laser | Boisard | La Mache Prod | Alpen'Tech | Qualité
Pas de MEP | 0 | 0 | 0 | 0 | 0 étoile verte
MEP en cours | 0 | 6 | 0 | 0 | 2 étoiles vertes
MEP terminée à vérifier | 0 | 0 | 0 | 0 | 3 étoiles vertes
MEP vérifiée | 0 | 0 | 0 | 0 | 4 étoiles vertes
Brut approvisionné | 0 | 0 | 0 | 0 | 0 étoile bleue
MEP validée | 0 | 1 | 0 | 0 | 1 étoile bleue
En production | 4 | 16 | 7 | 6 | 2 étoiles bleues
Production terminée | 0 | 0 | 0 | 0 | 3 étoiles bleues
Pièce vérifiée | 0 | 0 | 0 | 0 | 4 étoiles bleues
Pièce pesée | 0 | 0 | 0 | 0 | 5 étoiles bleues
En kit de montage | 0 | 0 | 0 | 0 | 0 étoile rouge
ICO spé | 229 | 51 | 218 | 60
Total ICO spécifique : |  |  | 0 | pièces SFFV spécifiques Optimus à produire et à vérfier
Total ICO du commerce : |  |  |  | composants du commerce Optimus (roulements, rotules, rivets, vis, ...) à commander et à approvisionner
TOTAL ICO à RECEPTIONNER : |  |  | 0 | items (pièces et composants) à intégrer en sous-systèmes SFFVV
Abréviations :
RSP : | Référentiel Standard de Production
MEP : | Mise en Plan
 | - 3 étoiles vertes : | MEP terminée par un Alpha 1A
 | - 4 étoiles vertes : | MEP vérifiée par un Gamma 2A
 | - 5 étoiles vertes : | MEP validée par le Directeur Technique Optimus
PFFV : | Pièce Fonctionnelle, Fabricable et Vérifiée
 | - 3 étoiles bleues : | Pièce PFF terminée de produire
 | - 4 étoiles bleues : | Pièce PFFV vérifiée avec pv GAC-PV dans le classeur central CCPP
 | - 5 étoiles bleues : | Pièce PFFVV pesée et validée par système vérifié sur banc
CCPP : | Classeur Central des Pièces à Produire (https://epsabox.kad-office.com/w/Pacte_p%C3%A9dagogique_EPSA/ECL_pour_la_formation_interg%C3%A9n%C3%A9rationnelle_des_Centraliens_au_d%C3%A9veloppement_annuel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)
GAC : | Gamme de Contrôle pièce
GAC-PV : | PV de Gamme de Contrôle pièce (ie : plan pièce avec côtes OK et KO)

Sheet: BOISARD
Référentiel Standard de Production (RSP) des pièces PFFV de STUF2019-Optimus
 |  |  |  |  | Téléphone | E-mail
Partenaire: |  |  | Responsable EPSA: | Maxime Proriol | 0637499240 | maxime.proriol@ecl17.ec-lyon.fr
 |  |  | Contact partenaire: | Phillipe Passalacqua (Usinage) | 0472056844 | PPASSALACQUA@ecoleboisard.com
 |  |  |  | Arnaud Desjonqueres (Directeur) | 0472056830 | ADESJONQUERES@ecoleboisard.com
Version: | V2.0 |  |  |  | ICO (Inconnue Cardinale Organique) | 51
Date: | 2019-01-23
Localisation | Matériaux | Description | Quantité | Dimensions du brut (en mm) | Opérations | Nuances | Statut | Responsable | Vague | Dimensions enveloppe pièce (en mm) | Commentaire
LASMECA | ACIER | Pivot de direction | 1 |  | Tournage | S235 | En production | MPL | 1
LASMECA | ACIER | Manchon de direction exté | 1 |  | Tournage | S235 | Reçu & vérifiée | MPL | 1
LASMECA | ACIER | Manchon de direction inté en attente de soudure | 1 |  | Tournage | S235 | Prêt à partir | MPL | 1
LASMECA | ACIER | Insert chassis pivot de basculeur | 2 | D40xL45 | Usinage | S355 | En production | PCT | 1
LASMECA | ACIER | Chape rear Ohlins/Frame | 2 | L40xH30xE30 | Usinage | S355 | En production | PCT | 2
LASMECA | ACIER | Colonne direction acier backup | 1 |  | Usinage | / | MEP en cours | ABR
LASMECA | ACIER | Spline coupler acier backup | 1 |  | Usinage | / | MEP en cours | ABR
LASMECA | ALUMINIUM | Porte moyeu avant | 2 | 170x280x45 | Tournage/Fraisage | 7075 T6 | En production | APU | 3
LASMECA | ALUMINIUM | Moyeu avant | 2 | D130xL120 | Tournage/Fraisage | 7075 T6 | En production | APU | 3
LASMECA | ALUMINIUM | Chape rapporté triangle supérieur | 5 | 40x45x65 | Fraisage | 7075 T6 | En production | APU | 3
LASMECA | ALUMINIUM | Porte moyeu arrière | 2 | 155x260x45 | Tournage/Fraisage | 7075 T6 | En production | MSO | 3
LASMECA | ALUMINIUM | Moyeu arrière | 2 | D130xL105 | Tournage/Fraisage | 7075 T6 | En production | MSO | 3
LASMECA | ALUMINIUM | Cylindres triangles diam 11.8 | 12 |  | Tournage | 7075 T6 | En production | ABR | 3
LASMECA | ALUMINIUM | Base cale de carrossage chape rapporté avant | 2 | 40x65x8 | Fraisage | 2017 T4 | Reçu & vérifiée | APU | 2 | 36.235x60x5.5 | Possibilité de la faire en 5 d'épé si plus simple niveau appro de bruts
LASMECA | ALUMINIUM | Entretoise roulement avant | 2 | D75x20 | Tournage (fraisage si arrache roulement) | 2017 T4 | En production | APU | 2 | D74.2x15
LASMECA | ALUMINIUM | Entretoise roulement arrière | 2 | D75x25 | Tournage (fraisage si arrache roulement) | 2017 T4 | En production | APU | 2 | D70.2x20
LASMECA | ALUMINIUM | Entretoise tripod housing | 2 | D60x20 | Tournage | 2017 T4 | En production | APU | 2 | D56x16.5
LASMECA | ALUMINIUM | Pivot barre anti roulie (coté droit) | 2 |  | Usinage | 2017 T4 | En production | PCT | 2
LASMECA | ALUMINIUM | Pivot barre anti roulie (coté gauche) | 2 |  | Usinage | 2017 T4 | En production | PCT | 2
LASMECA | ALUMINIUM | Reprise d'usine spline coupler | 1 |  | Perçage | / | MEP en cours | APU | 1
LASMECA | ALUMINIUM | Reprise d'usinage joint de cardan | 1 |  | Perçage | / | MEP en cours | APU | 2
LASMECA | ALUMINIUM | Reprise colonne de direction | 1 |  | Perçage | / | MEP en cours | APU | 2
MOTORISATION INSTRUMENTEE | ALUMINIUM | Porte excentrique gauche | 1 | 380x190x10 (à la fin) | Fraisage | 7075 T6 | En production | MPY | 3
MOTORISATION INSTRUMENTEE | ALUMINIUM | Porte excentrique droit | 1 | 380x190x10 (à la fin) | Fraisage | 7075 T6 | En production | MPY | 3
MOTORISATION INSTRUMENTEE |  | Adaptateur pression d'huile | 1 |  | Fraisage |  | MEP en cours | BAT
LASMECA | N'importe | Pièce pour enfiler les roulement | 1 |  | Tournage | N'importe, pas cher | MEP validée | APU
Coordonnées de leur fournisseur : | SISO | https://www.siso.fr

Sheet: LA MACHE LASER
Référentiel Standard de Production (RSP) des pièces PFFV de STUF2019-Optimus
 |  |  |  |  |  | Téléphone | E-mail
Partenaire: |  |  |  | Responsables EPSA: | Clément Emerique | 0778041636 | clement.emereique@ecl17.ec-lyon.fr
 |  |  |  |  | Maxime Proriol | 0637499240 | maxime.proriol@ecl17.ec-lyon.fr
Version: | V2.0 |  |  | Contact partenaire: | Brice Gelly (Laser) | 0616790875 | brice.gelly@lamache.org
Date: | 2019-01-23
 |  |  |  | ICO (Inconnue Cardinale Organique) | 229
Standardisation des plaques
 | Épaisseurs | 4mm | 3 mm | 1,5 mm |  |  | Date envoi vague 1 : | 2018-12-12
 | Surface (cm²) | 481.189 | #REF! | #REF! |  |  | Date envoi vague 2 : | 2018-12-20
Aluminium | Nuances | 2017 |  |  |  |  | Coordonnées du leur fournisseur :
 | Épaisseurs | 3 | 2 | 1 |  |  | Aciers classiques | Descours et cabaud
 | Surface (cm²) | 536 | #REF! | 0 |  |  | Aciers spéciaux | SOFYMETAL
Département | Matériaux | Description | Quantité | Epaisseur (en mm) | Opérations | Nuances | Surface approximative totale (cm²) | Statut | Responsable | Vague
LASMECA | ACIER | Chapes fixation triangles au châssis | 32 | 4 | Découpe laser | S700 | 221.189 | En production | PCK | 1
LASMECA | ACIER | Plaques fixation suspensions avant au chassis | 2 | 3 | Découpe laser | S355 | 40 | Prêt à partir | MKI | 2
LASMECA | ACIER | Basculeurs avant | 6 | 3 | Découpe laser | S355 | 224 | Prêt à partir | PCT | 2
LASMECA | ACIER | Basculeurs arrière | 6 | 3 | Découpe laser | S355 | 360 | Prêt à partir | PCT | 2
LASMECA | ACIER | Chapes basculeurs avant | 4 | 3 | Découpe laser | S355 | 19 | Prêt à partir | MPL | 2
LASMECA | ACIER | Chapes barre anti roulis avant droite | 1 | 4 | Découpe laser / Pliage | S700 | 180 | Prêt à partir | PCT | 2
LASMECA | ACIER | Chapes barre anti roulis avant gauche | 1 | 4 | Découpe laser / Pliage | S700 | 180 | Prêt à partir | PCT | 2
LASMECA | ACIER | Chapes barre anti roulis arrière gauche | 1 | 3 | Découpe laser / Pliage | S355 | 180 | Prêt à partir | PCT | 2
LASMECA | ACIER | Chapes barre anti roulis arrière droite | 1 | 3 | Découpe laser / Pliage | S355 | 180 | Prêt à partir | PCT | 2
LASMECA | ACIER | Couteaux avant | 4 | 3 | Découpe laser | S355 | 160 | Prêt à partir | EDP | 2
LASMECA | ACIER | Couteaux arrière | 4 | 3 | Découpe laser | S355 | 18.52 | Prêt à partir | EDP | 2
LASMECA | ACIER | Disques capteur vitesses | 4 | 5 | Découpe laser + reprise alésage au tour pour montage presse | S235 | 144 | Prêt à partir | APU | 2
LASMECA | ALUMINIUM | Entretoises disque capteur de vitesse 3mm | 5 | 3 | Découpe laser | 2017A |  | Prêt à partir | APU | 2
LASMECA | ALUMINIUM | Entretoises disque capteur de vitesse 2mm | 8 | 2 | Découpe laser | 2017A |  | Prêt à partir | APU | 2
LASMECA | ALUMINIUM | Cales de carrossage 2mm | 24 | 2 | Découpe laser | 2017 T4 |  | Prêt à partir | APU | 2
LASMECA | ALUMINIUM | Cales de carrossages 1mm | 6 | 1 | Découpe laser | 2017 T4 |  | Prêt à partir | APU | 2
LASMECA | ALUMINIUM | Entretoise Capteur vitesse | 12 | 2 | Découpe Laser | 2017A |  | Prêt à partir | APU | 2
MOTORISATION INSTRUMENTEE | ACIER | Chapes fixation moteur | 2 | 4 | Découpe laser | S700 | 48 | En production | EDP | 1
MOTORISATION INSTRUMENTEE | ACIER | Plaque supérieure guillotine | 1 | 1.5 | Découpe laser | S235 | 40 | Reçu | TLS | 1
MOTORISATION INSTRUMENTEE | ACIER | Plaque inferieure guillotine | 1 | 1.5 | Découpe laser / Pliage | S235 | 40 | Reçu | CEE | 1
MOTORISATION INSTRUMENTEE | ACIER | Chapes portes excentriques haut | 4 | 3 | Découpe laser | S355 | 50 | Prêt à partir | LDN / MPY | 2 | en modification
MOTORISATION INSTRUMENTEE | ACIER | Chapes portes excentriques bas | 4 | 3 | Découpe laser | S355 | 50 | Prêt à partir | EDP | 2
MOTORISATION INSTRUMENTEE | ACIER | Chapes fixation refroidissement | 3 | 3 | Découpe laser | S355 | 20 | Prêt à partir | MJT | 2
MOTORISATION INSTRUMENTEE | ACIER | Chapes fixation réservoir de carburant | 4 | 3 | Découpe laser | S355 | 40 | Prêt à partir | BVL | 2
MOTORISATION INSTRUMENTEE | ACIER | Cache chaîne | 1 | 3 | Découpe laser / Pliage | S355 | 520 | Prêt à partir | MPL | 2
MOTORISATION INSTRUMENTEE | ACIER | Chapes cache chaine | 2 | 3 | Découpe laser | S355 | 20 | Prêt à partir | MJT | 2
MOTORISATION INSTRUMENTEE | ACIER | Chapes jacking bar | 2 | 3 | Découpe laser | S355 | 60 | Prêt à partir | NGO | 2
MOTORISATION INSTRUMENTEE | ACIER | Chape fixation pompe | 1 | 3 | Découpe laser | S355 | 5 | Prêt à partir | MJT | 2
MOTORISATION INSTRUMENTEE | ACIER | Chape fixation régulateur | 1 | 3 | Découpe laser | S355 | 10 | Prêt à partir | MJT | 2
MOTORISATION INSTRUMENTEE | ACIER | Chape fixation tube de remplissage | 1 | 3 | Découpe laser | S355 | 7 | Prêt à partir | MJT | 2
MOTORISATION INSTRUMENTEE | ACIER | Chape fixation vase d'expension | 1 | 1.5 | Découpe laser | S235 | 6 | Reçu & vérifiée | MJT | 1
MOTORISATION INSTRUMENTEE | ACIER | Chapes fixation admission au chassis | 2 | 1.5 | Découpe laser | S235 | 12 | Reçu & vérifiée | MJT | 1
MOTORISATION INSTRUMENTEE | ACIER | Chape fixation shifter au chassis | 1 | 3 | Découpe laser | S355 | 8 | Prêt à partir | MJT | 2
MOTORISATION INSTRUMENTEE | ALUMINIUM | Plan de joint carter d'huile | 1 | 15 | Découpe laser / Rectifiction après soudure | 5754 |  | Prêt à partir | MPL | 2
MOTORISATION INSTRUMENTEE | ALUMINIUM | Carter d'huile | 1 | 2.5 | Découpe laser | 5754 |  | Prêt à partir | MPL | 2
MOTORISATION INSTRUMENTEE | ALUMINIUM | Plaque anti déjaugeage carter d'huile | 1 | 2.5 | Découpe laser | 5754 |  | Prêt à partir | MPL | 2
MOTORISATION INSTRUMENTEE | ALUMINIUM | Arrêt en translation guillotine gauche | 1 | 3 | Découpe laser / Pliage | 2017A | 80 | Prêt à partir | TLS | 2
MOTORISATION INSTRUMENTEE | ALUMINIUM | Arrêt en translation guillotine droite | 1 | 3 | Découpe laser | 2017A | 5 | Prêt à partir | TLS | 2
MOTORISATION INSTRUMENTEE | ALUMINIUM | Fonds plat admission | 1 | 2 | Découpe laser | 2017A | 440 | Prêt à partir | CEE | 2
MOTORISATION INSTRUMENTEE | ALUMINIUM | Plaques fixation admission/moteur | 2 | 2 | Découpe laser / Pliage | 2017A | 100 | Prêt à partir | Idriss | 2
MOTORISATION INSTRUMENTEE | ALUMINIUM | Corps réservoir de carburant | 1 | 2 | Découpe laser / Pliage | 2017A | 4108 | Prêt à partir | BVL | 2
MOTORISATION INSTRUMENTEE | ALUMINIUM | Fonds réservoir de carburant | 1 | 2 | Découpe laser / Pliage | 2017A | 880 | Prêt à partir | BVL | 2
MOTORISATION INSTRUMENTEE | ALUMINIUM | Cavité réservoir de carburant | 1 | 2 | Découpe laser / Pliage | 2017A | 176 | Prêt à partir | BVL | 2
MOTORISATION INSTRUMENTEE | ALUMINIUM | Chape motoreducteur arrière | 1 | 2 | Découpe laser / Pliage | 2017A | 48 | Prêt à partir | TLS | 2
MOTORISATION INSTRUMENTEE | ALUMINIUM | Chape motoreducteur avant | 1 | 2 | Découpe laser / Pliage | 2017A | 11 | Prêt à partir | TLS | 2
MOTORISATION INSTRUMENTEE | ALUMINIUM | Chapes radiateurs | 3 | 2 | Découpe laser / Pliage | 2017A | 8 | Prêt à partir | MJT | 2
MOTORISATION INSTRUMENTEE | ALUMINIUM | Chapes vase d'expansion | 1 | 2 | Découpe laser / Pliage | 2017A | 2 | Prêt à partir | Aimery | 2
MOTORISATION INSTRUMENTEE | ALUMINIUM | Plaques pair | 2 | 2 | Découpe laser | 2017A |  | Prêt à partir | MPL | 2
MOTORISATION INSTRUMENTEE | BRONZE | Partie mobile guillotine | 1 | 3 | Découpe laser / Pliage | Bronze | 56 | En production | TLS | 2
CHASSIS ÉQUIPÉ | ACIER | Chapes fixation harnais | 2 | 4 | Découpe laser | S700 | 32 | En production | TMN
CHASSIS ÉQUIPÉ | ACIER | Chapes baquet | 6 | 3 | Découpe laser | S355 | 24 | Prêt à partir | Camille | 2
CHASSIS ÉQUIPÉ | ACIER | Support latéral pédale de frein | 2 | 3 | Découpe laser | S355 | 182 | Prêt à partir | BDE | 2
CHASSIS ÉQUIPÉ | ACIER | Support latéral pédale accelérateur gauche | 1 | 3 | Découpe laser | S355 | 75 | Prêt à partir | BDE | 2
CHASSIS ÉQUIPÉ | ACIER | Support latéral pédale accelérateur droit | 1 | 3 | Découpe laser | S355 | 126 | Prêt à partir | BDE | 2
CHASSIS ÉQUIPÉ | ACIER | Plaque anti intruison | 1 | 1.5 | Découpe laser | S235 |  | Reçu & vérifiée | MPL | 1
CHASSIS ÉQUIPÉ | ACIER | Chape bocal liquide pédalier | 1 | 1.5 | Découpe laser | S235 |  | Prêt à partir | BDE
CHASSIS ÉQUIPÉ | ACIER | Chape T de répartition pédalier | 1 | 1.5 | Découpe laser | S235 |  | Reçu & vérifiée | BDE | 1
CHASSIS ÉQUIPÉ | ACIER | Chape avant pédalier | 4 | 3 | Découpe laser | S355 | 10 | Prêt à partir | BDE | 2
CHASSIS ÉQUIPÉ | ACIER | Chape arrière pédalier | 4 | 3 | Découpe laser | S355 | 10 | Prêt à partir | BDE | 2
CHASSIS ÉQUIPÉ | ACIER | Chapes carrosserie | 4 | 1.5 | Découpe laser | S235 | 48 | Reçu & vérifiée | JKL | 1
CHASSIS ÉQUIPÉ | ACIER | Chapes crémaillère | 2 | 1.5 | Découpe laser / Pliage | S235 | 52 | Prêt à partir | PAX / EDP | 2
CHASSIS ÉQUIPÉ | ALUMINIUM | Cales talon | 2 | 3 | Découpe laser / Pliage | 2017 T4 | 184 | Prêt à partir | BDE | 2
CHASSIS ÉQUIPÉ | ALUMINIUM | Cales bout de pieds | 2 | 3 | Découpe laser / Pliage | 2017 T4 | 257 | Prêt à partir | BDE | 2
CHASSIS ÉQUIPÉ | ALUMINIUM | Support coupe circuit freinage | 1 | 3 | Découpe laser / Pliage | 2017 T4 | 10 | Prêt à partir | BDE | 2
SEISM | ACIER | Chapes power box | 2 | 1.5 | Découpe laser | S235 | 8 | Reçu & vérifiée | RMN | 1
SEISM | ACIER | Chapes Master switch | 2 | 1.5 | Découpe laser | S235 | 8 | Reçu & vérifiée | ARZ | 1
SEISM | ACIER | Chapes bouton d'arrêt d'urgence | 2 | 3 | Découpe laser | S235 | 8 | Prêt à partir | BAT | 2
SEISM | ACIER | Chapes crash sensor | 1 | 1.5 | Découpe laser | S235 | 4 | Reçu & vérifiée | MGV | 1
SEISM | ACIER | Chapes batterie | 3 | 1.5 | Découpe laser | S235 | 12 | Prêt à partir | MPL | 2
SEISM | ACIER | Chapes de masse | 4 | 1.5 | Découpe laser | S235 | 16 | Reçu & vérifiée | CLS | 1
SEISM | ACIER | Chapes Break light | 1 | 1.5 | Découpe laser | S235 | 4 | Reçu & vérifiée | BMR | 1
SEISM | ACIER | Chapes Booster | 1 | 1.5 | Découpe laser | S235 |  | Reçu & vérifiée | RMN | 1
SEISM | ACIER | Chapes tableau de bords | 6 | 1.5 | Découpe laser / Pliage | S235 | 24 | Reçu & vérifiée | RMN | 1
SEISM | ALUMINIUM | Support batterie | 1 | 2 | Découpe laser / Pliage | 2017A |  | Prêt à partir | PTS
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
