EOSCogniton/Intergen/03_Gestion_De_Projet/01_Documents Organisation/01_Template_Outils/03_Production/Planning_Prévisionnel_Soudure.xlsx

Sheet: Soudure des Equipements
 |  | Année | STUF2020 - Invictus
 |  | Description | Cet Excel est un outil utilisé les différentes années pour gérer la soudure des Equipements sur le Châssis
 |  | Lien GGSheet de la version | https://docs.google.com/spreadsheets/d/1uW1FFhkz3D_QsAObjA-RuQ5B1AE26Oy6Awb2tsTxfyE/edit?usp=sharing
 |  | Dernière MAJ | 2020-03-05
 |  | Par : | CMI
Désignation | Qté | Date prévue | Soudé ? | Date de soudure | Respo | Fabriqué | Gabarits à faire | Responsable Gabarit | Responsable vérification | A meuler | Remarques |  |  |  | Jour de Pointage d'Equipements
Vague Placement Moteur + Chapes Triangles |  |  |  |  |  |  |  |  |  |  |  |  |  |  | Jour de Soudage d'Equipements (pas besoin d'être présent)
Chapes Fixation Moteur | 2 | 2020-01-30 | TRUE | 2020-01-30 | ASE | TRUE |  |  |  |  | Placement Moteur, il faut un Respo Motorisation présent | Prévisionnel |  |  |  |  |  |  | Réel
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
