EOSCogniton/Intergen/02_Modèles/ModeleMoteur (Simpliste)/gabarit_moteur.STEP

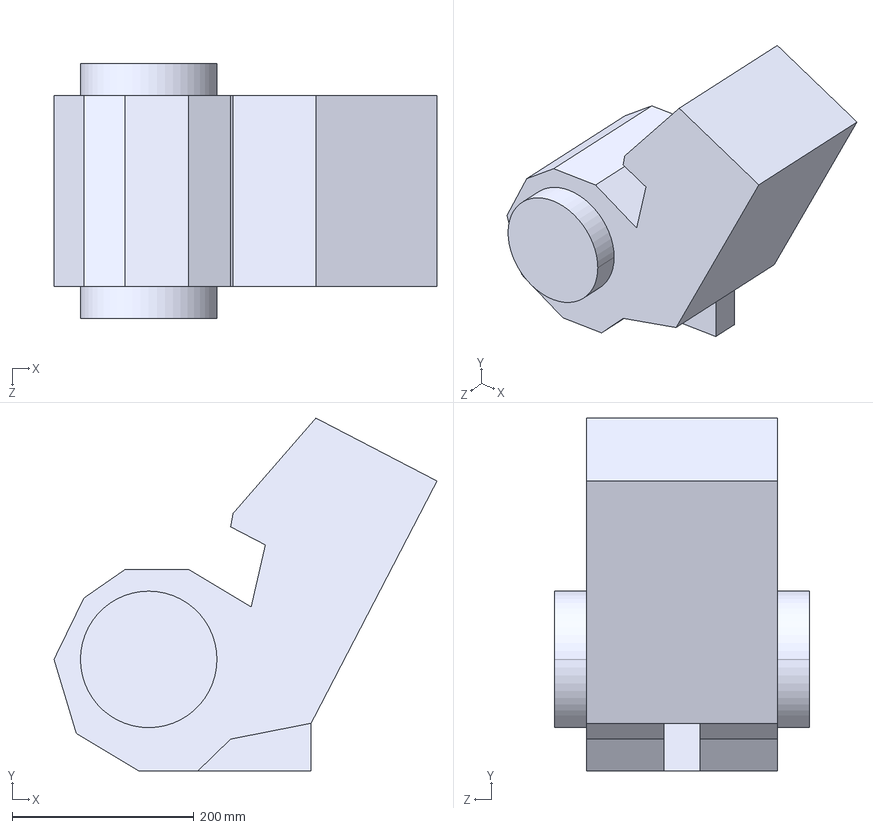
[picture p364: CAD file, 2018-03-16]
02_Modèles/ModeleMoteur (Simpliste)/gabarit_moteur.STEP
420.9 x 387.7 x 280.0 mm
