EOSCogniton/Intergen/(list of files, cad)

Other CAD files:
02_Modèles/ModeleMoteur (Simpliste)/gabarit_moteur.CATPart
02_Modèles/ModeleMoteur (Simpliste)/gabarit_moteur.SLDPRT
