EOSCogniton/Intergen/03_Gestion_De_Projet/01_Documents Organisation/2019_Optimus/03_Gantt_Fabrication/Planning_Soudure_Chapes.xlsx

Sheet: Dispo_Soudure
 | Lundi |  | mardi |  | mercredi |  | jeudi |  | vendredi |  | Samedi 09/02 : séance de roulage
Nom | Matin | Aprem | Matin | Aprem | Matin | Aprem | Matin | Aprem | Matin | Aprem
NGO | NON | OUI | NON | OUI | NON | OUI | NON | OUI | NON | OUI
MPY | NON | OUI | NON | OUI | OUI | NON | NON | NON | NON
MPL | NON | NON | NON | OUI | NON | OUI | NON | OUI | OUI | OUI
BAT |  |  |  |  |  |  |  |  |  |  | OUI
RCS | NON | NON | NON | OUI | OUI | NON | NON | OUI | NON | OUI | NON
CEE
PCT
LDN
~~YRI~~
JKL | NON | NON | OUI | OUI | NON | NON | NON | OUI | NON | OUI
EDP | NON | NON | NON | OUI | NON | NON | OUI | NON | NON | NON
PTN
MJT | OUI | OUI | NON | OUI | NON | OUI | NON | OUI | NON | NON
MKI | NON | NON | NON | OUI | NON | OUI | NON | OUI | NON | NON
BVL | NON | NON | NON | OUI | NON | OUI | OUI | OUI | OUI
Remplisez vos trigramme ou nom les 0As

Sheet: Planning_Optimus
Janv |  |  |  | Février |  |  |  | Mars
Semaine 2 | Semaine 3 | Semaine 4 | Semaine 5 | Semaine 6 | Semaine 7 | Semaine 8 | Semaine 9 | Semaine 10 | Semaine 11 | Semaine 12 | Semaine 13
Soudure de la structure tubulaire |  |  | Soudure des chapes |  |  | Vacances Centrale | Vacances La Gir
Dépose des tubes pour début de la soudure | Soudure avant de la structure tubulaire | Soudure arrière de la structure tubulaire | Jeudi 31/01 matin : Soudure chapes elec partie 1 [Groupe 2] | Mercredi 06/02 : soudures chapes mototrisation et ergonomie -- Vendredi 08/02 matin : soudure chapes suspension av/ar et transmission secondaire et direction[Groupe 5] | Jeudi 14/02 aprem : Soudure chapes pédalier [Groupe 7] | Vendredi 22/02 : Récupération du chassis par Aurélien pour l'amener chez Bery inox pour soiuder l'échappement | Chassis immobilisé chez Bery Inox pour soudure de l'échappement
Groupe 1 |  |  |  |  | Groupe 4
CEE | MPL | TLS |  |  | PCT | LDN | EDP
Responsable : | CEE avec MPY |  |  |  | Responsable : | PCT + photos + vidéos
Système : | chapes moteur, Chapes Admission, refroidissement |  |  | Fait | Système : | Chapes suspensions av/ar et chapes BAR , chapes Portes excentriques (transmission secondaire), direction cache cremaillere,Pivot et machon direction |  |  |  | PCT pas dispo le mercredi matin et aprem
Date : | mercredi 6 fevrier matin |  |  | programmé | Date : | vendredi 8 février matin
 |  |  |  | à programmer
Groupe 2 |  |  |  |  | Groupe 5
BAT |  |  |  |  | PCT | 0As
Responsable : | BAT |  |  |  | Responsable : | Reedom
Système : | Electronique 1 |  |  |  | Système : | Chapes LAS
Date : | Jeudi 29 janvier matin |  |  |  | Date : | jeudi 21 fevrier aprem
Groupe 3 |  |  |  |  | Groupe 6
JKL | 0AS |  |  |  | BDE | 0As | MJT
Responsable : | JKL |  |  |  | Responsable : | BDE
Système : | chapes ergonomie, carrosserie, pare feu, anti intrusion |  |  |  | Système : | Pédalier
Date : | mercredi 6 février aprem |  |  |  | Date : | Jeudi 14 février aprem
 |  |  |  |  | Groupe 7
 |  |  |  |  | BVL | 0As
 |  |  |  |  | Responsable : | BVL
 |  |  |  |  | Système : | Reservoir - circuit essence - fond plat |  |  |  | jeudi aprem plutot ou vendredi aprem
 |  |  |  |  | Date : | mercredi/vendredi (aprem) ou jeudi

Sheet: Planning_Vulcanix
 | Groupe 1 | Groupe 2 | Groupe 3 | Groupe 4 | Groupe 5 | Groupe 6 | Groupe 7 | Groupe 8 | Groupe 9 | Groupe 10 | Groupe 11
Systèmes | Moteur | Pare feu - carrosserie - fond plat - anti intrusion | Refroidissement | Admission | Direction - cache crémaillère | Electronique | Pédalier | Reservoir - circuit essence - tubes direction | Transmission secondaire | Ergo | Suspension
Présents | Brice | Benji | Maros | Emilien | Touze | GTI - Pedro | Benji | Touze | Arpys | Jérome | Touze
Equipements | 201 | 11 - 12 - 15 - 17 - 18 - 19 - 20 | 1 - 21 - 107 - 108 | 2 | 3 - 26 | 4 -5- 6 - 7 - 8 - 9 - 10 - 101 | 13 - 14-111-112-113 | 22-23-24-25-110-116 | 102-103-104-105-106-119 | 114 - 115-118-222 | 202 à 219
Session | 1 | 2 | 3 | 4 | 5
Groupe | 11, 5 | 1,3,4 + attache moteur | 2.7 | 6, 10 | 8.9
Nombre équipements | 42 | 15 | 58 | 28 | 18
Responsables | Touze | Brice, Maros, Emilien | Benjamin | GTI, Jérome | Adrien, Touze
Calendrier | Mercredi 21 matin | Jeudi 22 aprem | Mercredi 28 matin | Jeudi 29 aprem | Mercredi 4 matin
 | Session 3 | Session 4 | Session 1 | Session 2 | Session 5

Sheet: Planning_Rentrée
 | Début de l'intégration : | 2019-02-16 | Pendant les vacances | 2019-02-25
 | Vacances 2 | 2019-04-13 | Essais | 2019-04-29
 | Janv |  |  |  | Février
Semaine 1 | Semaine 2 | Semaine 3 | Semaine 4 | Semaine 5 | Semaine 6 | Semaine 7 | Semaine 8 | Semaine 9
 | soudure chassis |  |  | Soudure chapes |  |  |  | Vacances La Gir | Frame
 | Récupérer Chapes LAS et découpe meuleuses attention brutes pour La Mache |  |  |  |  |  |  |  | LAS | Démarcher aquacut pour tester des chapes découpées à l'eau
 | apporter main et front hoop et récupérer tubes découpés et les amener (mardi) |  |  |  |  |  |  |  | Frame
 | ARRK admission ajouter nom et envoyer puis préparer le nécessaire pour soudure echappement hors chassis |  |  |  |  |  |  |  | Motorisation
 | Réfaire carte passage vitesse Atomix | visite 2 (La Gir) | visite 3 (La Gir) | visite 4 (La Gir) | visite 5 (La Gir) | visite 6 (La Gir) |  |  | Elec
 | visite 1 (La Gir) avec choco et carte voeux |  |  |  |  |  |  |  | Comm
 | visite Boisard et usinage pivot et machon direction pour ensuite etre soudé à la Gir puis réusinage des portées de roulements à Boisard |  | Fab roue équipée |  |  |  |  |  | 1As
 | Seance rangement Bron 1 |  |  |  |  |  |  |  | Prod
 | préparer commandes Ohlins et skf et visserie LAS | Réouverture du budget envoie des commandes | Faire vue blender quali |  |  | Faire invitation pour roll out + teaser | Envoie invitation pour roll out |  | Asso
 | Préparer commandes Bron
 | Mars |  |  |  | Avril
 | Semaine 10 | Semaine 11 | Semaine 12 | Semaine 13 | Semaine 14 | Semaine 15 | Semaine 16 | Semaine 17
 |  |  |  |  | Prévoir organisation et invitation un mois avant i.e le 17 février
 | Mai |  |  |  | Roll Out
 | Semaine 18 | Semaine 19 | Semaine 20 | Semaine 21
 | Départ stage 2As
