EOSCogniton/Intergen/01_Association/Commission d'enquête Optimus/Check_List_Depart_Essais.pdf

## Check Liste Logistique

Outillage
- Pince à rivet | Tourne vis
- Lime | Maillet
- Visseuse | Chasse-goupille
- Embouts de visseuse | Marteau
- Clé allen | Clé à molette
- Clé plates | Clé dynamométrique :
- Cliquets | Adaptateur de clé dynamo moyenne
- Pinces coupantes | Douille profonde pour jante
- Pinces plates | Douilles

Outils de mesure
- Mètre (2m et 30m) | Règlet
- Capteur de carrossage | Thermomètre Laser
- Manomètre | Sonomètre
- Pied à coulisse | Pyromètre

Consommables
- Rilsan | Circlips
- Papier à poncer | Velcro
- Visserie | Rotules
- Rivet | Coussinets de suspensions
- Essuie-tout | Sac poubelle
- Eau | Bougie

Liquides
- Liquide de frein | Essence
- Liquide de refroidissement | Frein filet
- Huile moteur | Blanc de vis
- Décapant industrielle | Colle loctite à rotule
- Acétone | Lubrifiant chaine

Matériel Piste
- Booster | Ordinateurs portables
- Pneu de rechange | Ressorts de suspension
- Barnum | Calles de carrossage
- Cônes | Malle d'équippement pilote
- Extincteurs (grand et petit) | Pompe à air
- Bancs (x2) | Entonnoire pour essence
- Chandelles & Cric | Entonnoire pour huile moteur

Séance
Date
Lieu
Responsable Logistique

DO

par NGO | Version 3.0 du 24/11/2019 | STUF'2019 - Optimus

## Check Liste Logistique

Electronique
- Cable Booster | Batterie de rechange
- Câble DTA | Boite connecteurs DBD
- Câble Motoréducteur | Fils 24-20-16
- Boite rouge gaine thermo | Scotch (alu, gris, faisceau noir)
- Boite à fusibles | Briquet
- Multimètre | Pince à dénuder
- Pince rouge à sertir

Brut
- Plaque d'aluminium
- Tube d'acier
- Mousse
par NGO | Version 3.0 du 24/11/2019 | STUF'2019 - Optimus
