EOSCogniton/Intergen/01_Association/Commission d'enquête Optimus/Check_List_MCO.pdf

### Check Liste MCO

- Etat des plaquettes de frein | Presence des ressorts de maintient
- 2 Bocaux de liquides de freins pleins | Vis de silencieux serrée
- Circlips positionnés vers le bas et dans les gorges | Lambda en place et serrée
- Fil à freiner en position et tendu
- Disques de frein nettoyés
- Vérification fuites au niveau des étriers | Serrage des vis avec la rampe d'injection
- Rilesants en place avec bon coulissage des durites | Collier de filtre à air bien en place
| Capteurs de plenum bien branché
- Vérification du jeu dans les PM
- Non collision entre les triangles av inf et les PM | Attaches du radiateur bien en place
- Serrage capteurs de vitesse et éloignement du disque | Niveau d'eau normal
- Précharge des suspensions cohérentes
- Longueur des biellettes de pince et de direction
- Ecroues des jantes serrés à 105Nm | Contrôle visuel du serrage des vis
- Pression des pneus vérifiée | Tension de chaine vérifiée
- Contrôle visuel des vis de triangle et de suspension, resserage au couple si besoin | Présence de graisse et de lubrifiant sur la
| chaine
- Bonne longueur des biellettes de pince et de direction | Attaches de soufflet bien en place
| Attache du motored bien en place
| Connecteur du motored branché
| Huile de Drexler OK
- Contrôle visuel du serrage des vis | Branchement des capteurs
- Vérification du bon fonctionnement du pivot de la pédale d'accélération | Capteur de vilbrequin
- Câble d'accélérateur bien positionné | Bougies
| Injecteurs
| Capteur de papillon
- Vis de siège bien serrées | Câble de master switch en place
- Harnais correctement mis avec passage dans le siège | DTA bien branché
- Bon fonctionnement de la poigné d'embrayage et
serrage.

Admission

Liaison au sol

Freinage

Séance
Date
Lieu
Respo MCO
DO

Transmission secondaire

Refroidissement

Ergonomie

Pédalier

Echappement

Moteur

par NGO | Version 3.0 du 24/11/2019 | 1

### Check Liste MCO

- Serrage des vis du volant | Batterie bien branchée
- Connecteur des palettes en place | Tuyaux arrivant bien dans les catch can
- Appui tête bien en place | Vis de moteur bien serrée
- Câbles tous bien en place
- Vis et boutons en place et serrés
- Bonne attache des cartes avant
- Connecteurs AV et AR en place
- Pompe montant bien en pression, 4,8 bar en absolu
- Abscence de fuite dans le circuit
- Essence dans le réservoir
- Serrages des vis du fond plat
- Serrages des vis des ouïes
- Serrages des vis de la paroi pare-feu
- Bon fonctionnement des écrans et voyant

Divers

Circuit d'essence (une fois le contact mis)

Carte éléctronique

Tableau de Bord

Carrosserie

par NGO | Version 3.0 du 24/11/2019 | 2
