EOSCogniton/Intergen/01_Association/Commission d'enquête Optimus/Check_List_PAE.pdf

### Check Liste Equipement

- Gants FIA
- Casque FIA
- Combinaison FIA
- Chaussette FIA
- Cagoulle FIA
- arm restreint

Séance
Date
Lieu
Respo PAE

DO

Equipement pilote

par NGO | Version 1.0 du 24/11/2019 | 1
