EOSCogniton/Intergen/01_Association/Commission d'enquête Optimus/Check_List_Data.pdf

### Check Liste Data

- Les capteurs sont branchés
- Le DTA est en wifi
- Les données sont collectées correctement

Séance
Date
Lieu
Respo Data

DO

Données

par NGO | Version 1.0 du 24/11/2019 | 1
