EOSCogniton/Intergen/01_Association/Commission d'enquête Optimus/Check_List_ESE.pdf

### Check Liste DO

- Check list Data
- Check list TraSec
- Check list PAE
- Check list MCO
- Check list Logistique

Séance
Date
Lieu
DO

Les Check List suivantes sont remplies

par NGO | Version 1.0 du 24/11/2019 | 1
