EOSCogniton/Intergen/01_Association/Commission d'enquête Optimus/Check_List_TraSec.pdf

### Check Liste TraSec

- Les plots sont bien en place
- Les chicanes sont positionées
- Les slaloms sont positionnés
- Les 2 extincteurs avec leur responsables sont positionnées
- Les réglès de sécurité ont été rappelées
- Les entrées et sorties de pistes sont indiquées

Séance
Date
Lieu
Respo TraSec

DO

Tracé

Sécurité

par NGO | Version 1.0 du 24/11/2019 | 1
