EOSCogniton/Intergen/01_Association/Commission d'enquête Optimus/Arbre des causes.pdf

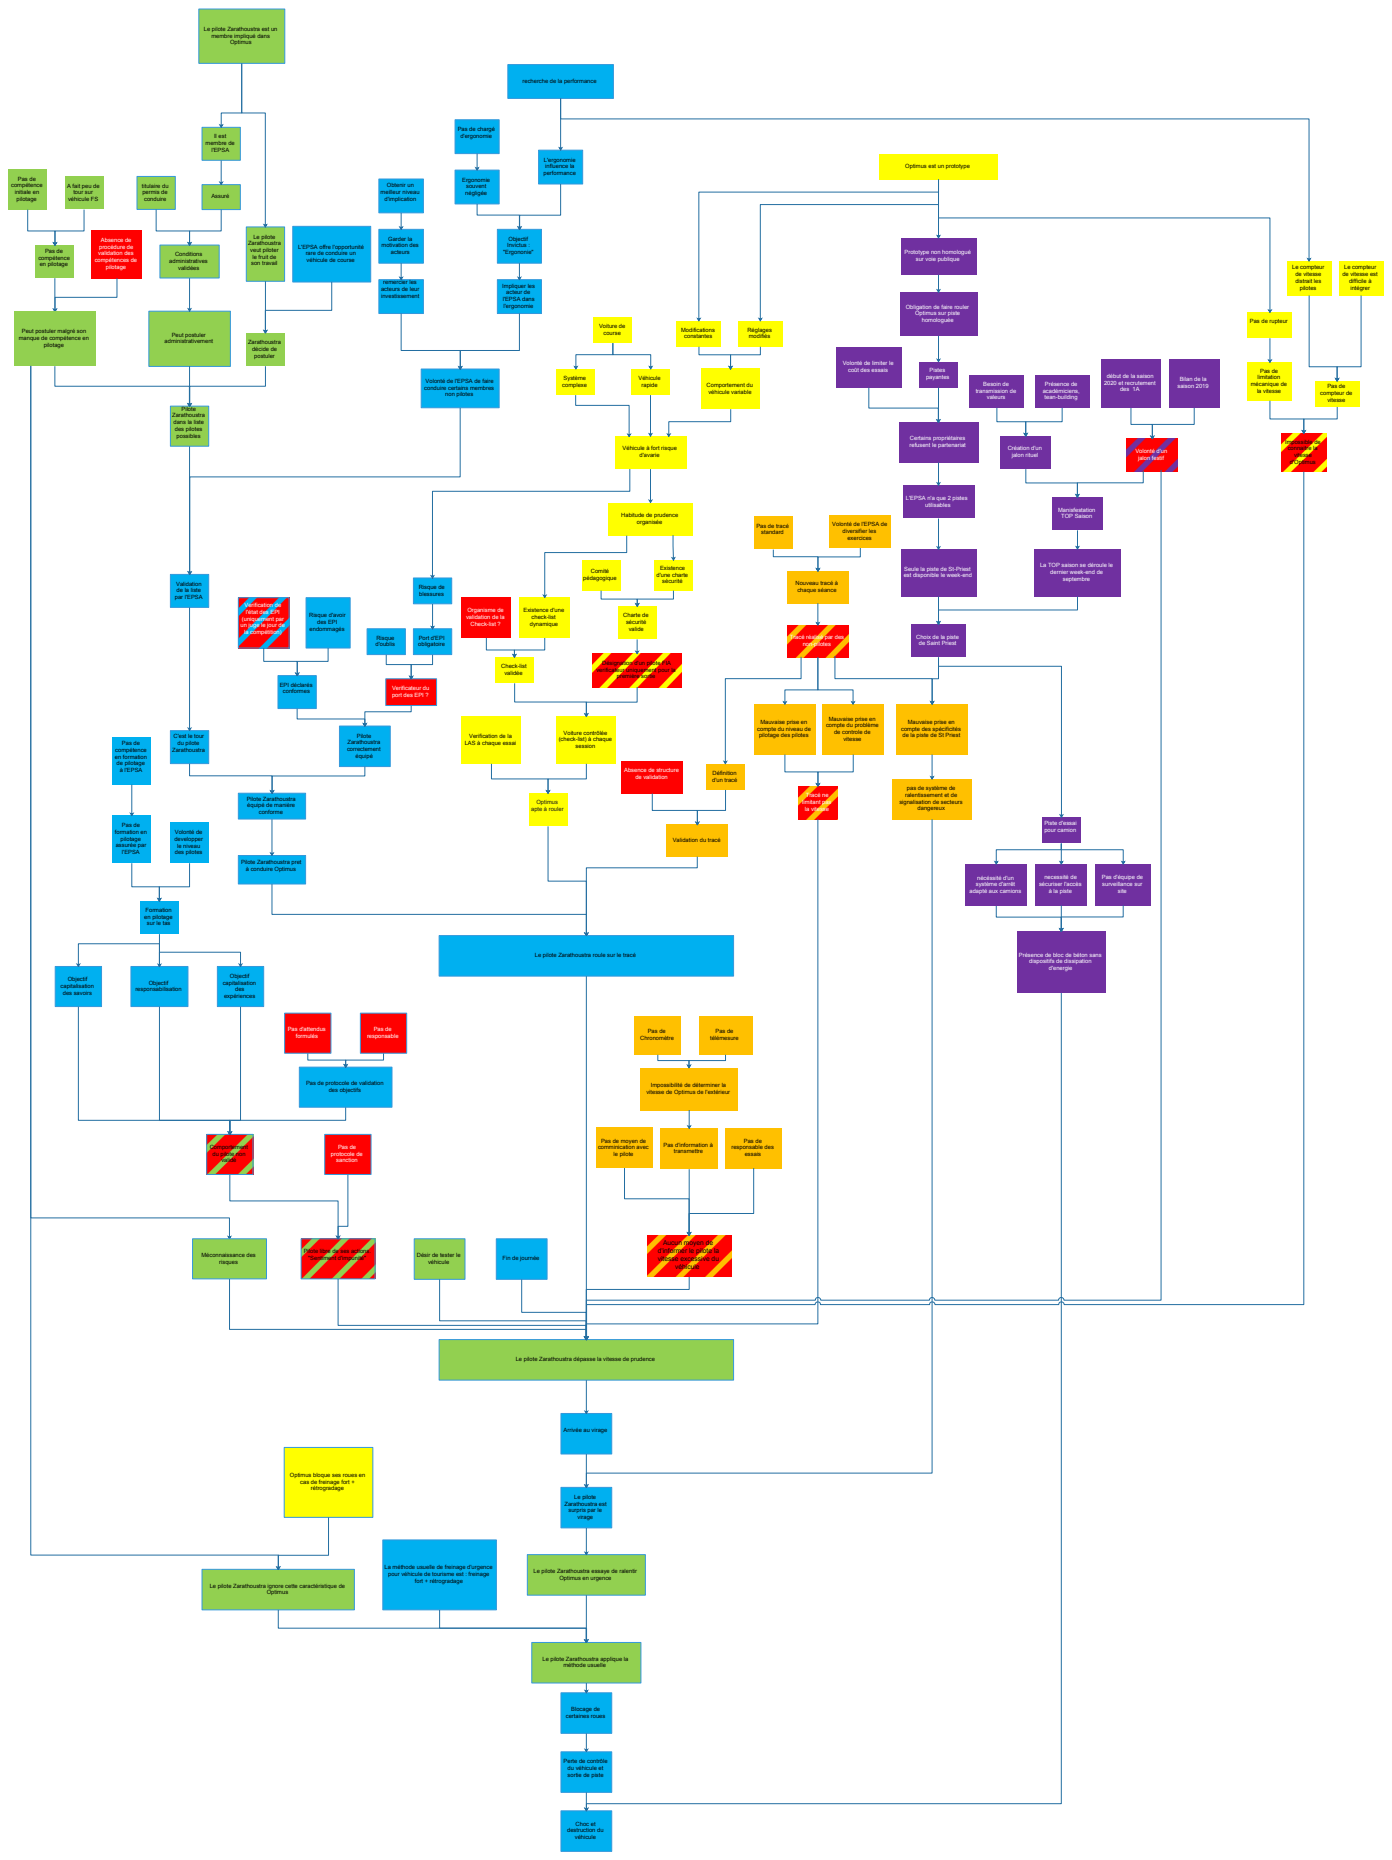
[picture p366: page 1]
non pilotes; Impliquer les acteur de l'EPSA dans l'ergonomie; Garder la motivation des acteurs; Obtenir un meilleur niveau d'implication; Objectif Invictus : "Ergononie"; L'ergonomie influence la performance; Ergonomie souvent négligée; Conditions administratives validées; Assuré; titulaire du permis de conduire; Il est membre de l'EPSA; Pilote Zarathoustra correctement équipé; Risque d'avoir des EPI endommagés; Risque d'oublis; Risque de blessures; EPI déclarés conformes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

Le pilote Zarathoustra est un
membre impliqué dans
Optimus

recherche de la performance

Pas de chargé
d'ergonomie

Optimus est un prototype

A fait peu de
tour sur
véhicule FS

Le pilote
Zarathoustra
veut piloter
le fruit de
son travail

L'EPSA offre l'opportunité
rare de conduire un
véhicule de course

Prototype non homologué
sur voie publique

Le compteur
de vitesse est
difficile à
intégrer

remercier les
acteurs de leur
investissement

Obligation de faire rouler Optimus sur piste homologuée

Pas de rupteur

Modifications constantes | Réglages modifiés

Peut postuler malgré son
manque de compétence en

Volonté de limiter le

début de la saison
2020 et recrutement
des 1A

Volonté de l'EPSA de faire
conduire certains membres

Bilan de la
saison 2019

Pilote
dans la liste
des pilotes
possibles

Certains propriétaires
refusent le partenariat

Véhicule à fort risque
d'avarie

L'EPSA n'a que 2 pistes
utilisables

Habitude de prudence
organisée

Pas de tracé
standard

Volonté de l'EPSA de
diversifier les
exercices

La TOP saison se déroule le
dernier week-end de
septembre

Seule la piste de St-Priest
est disponible le week-end

Validation
de la liste
par l'EPSA

Verification de
l'état des EPI
(uniquement par
un juge le jour de
la compétition)

Organisme de
validation de la
Check-list ?

Tracé réalisé par des
non-pilotes

Choix de la piste
de Saint Priest

Désignation d'un pilote FIA
verificateur uniquement pour la

Verificateur du
port des EPI ?

Mauvaise prise en
compte du problème
de controle de
vitesse

compte du niveau de
pilotage des pilotes

compte des spécificités
de la piste de St Priest

Voiture contrôlée
(check-list) à chaque
session

C'est le tour
du pilote

Verification de la
LAS à chaque essai

Absence de structure
de validation

pas de système de
ralentissement et de
signalisation de secteurs
dangereux

Pilote Zarathoustra
équipé de manière
conforme

Validation du tracé

Pilote Zarathoustra pret
à conduire Optimus

Pas d'équipe de
surveillance sur
site

nécéssité d'un
système d'arrêt
adapté aux camions

Formation
en pilotage
sur le tas

Le pilote Zarathoustra roule sur le tracé

Présence de bloc de béton sans
dispositifs de dissipation

Pas de protocole de validation

Impossibilité de déterminer la
vitesse de Optimus de l'extérieur

Pas de moyen de
comminication avec
le pilote

Comportement
du pilote non
validé

Aucun moyen de
d'informer le pilote la
vitesse excessive du
véhicule

Pilote libre de ses actions.
"Sentiment d'impunité"

Fin de journée Désir de tester le

Le pilote Zarathoustra dépasse la vitesse de prudence

Arrivée au virage

Optimus bloque ses roues en
cas de freinage fort +
rétrogradage

Zarathoustra est
surpris par le
virage

La méthode usuelle de freinage d'urgence
pour véhicule de tourisme est : freinage

Le pilote Zarathoustra essaye de ralentir

Optimus en urgence

fort + rétrogradage Le pilote Zarathoustra ignore cette caractéristique de

Le pilote Zarathoustra applique la

Perte de contrôle
du véhicule et
sortie de piste
