EOSCogniton/Intergen/01_Association/Commission d'enquête Optimus/5P.png

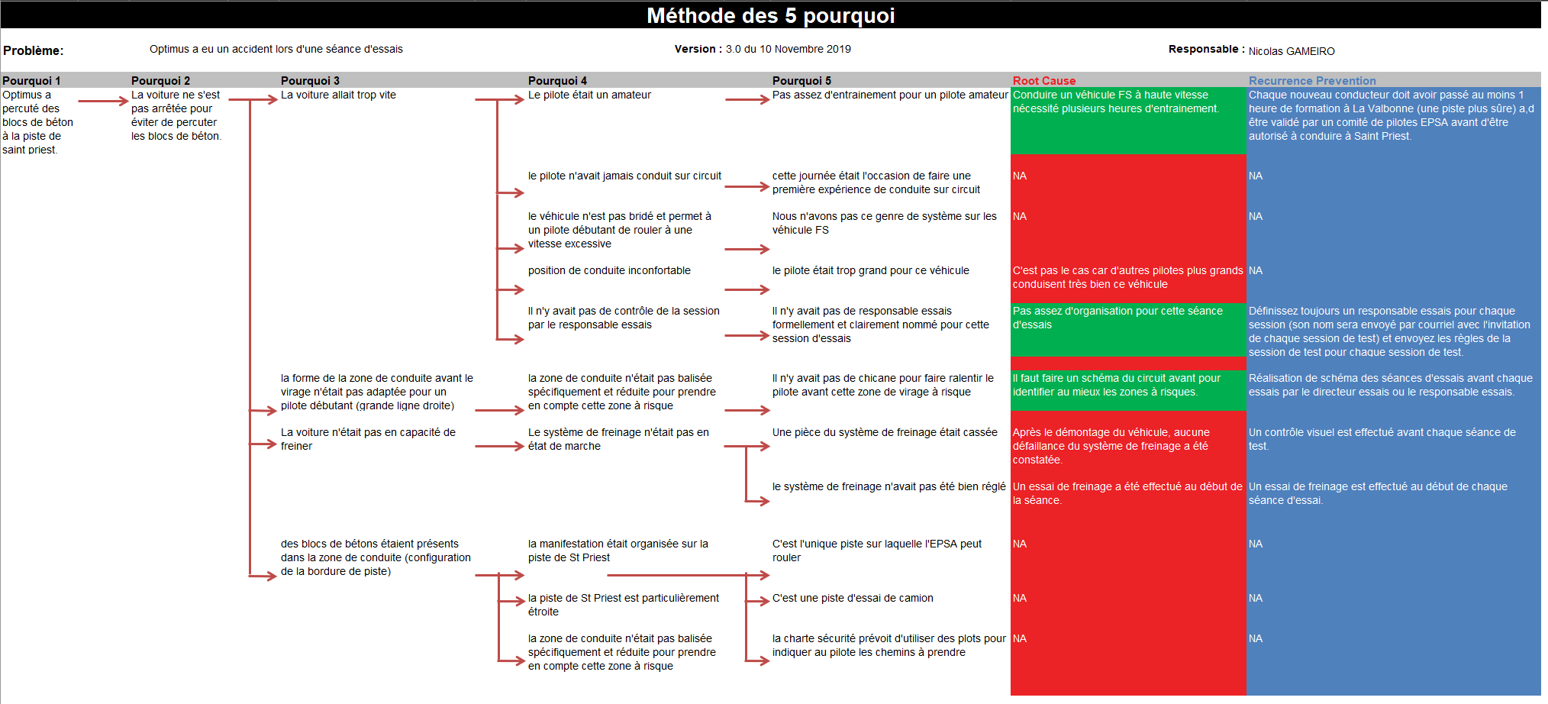
01_Association/Commission d'enquête Optimus/5P.png
