EOSCogniton/Intergen/01_Association/Commission d'enquête Optimus/5W.png

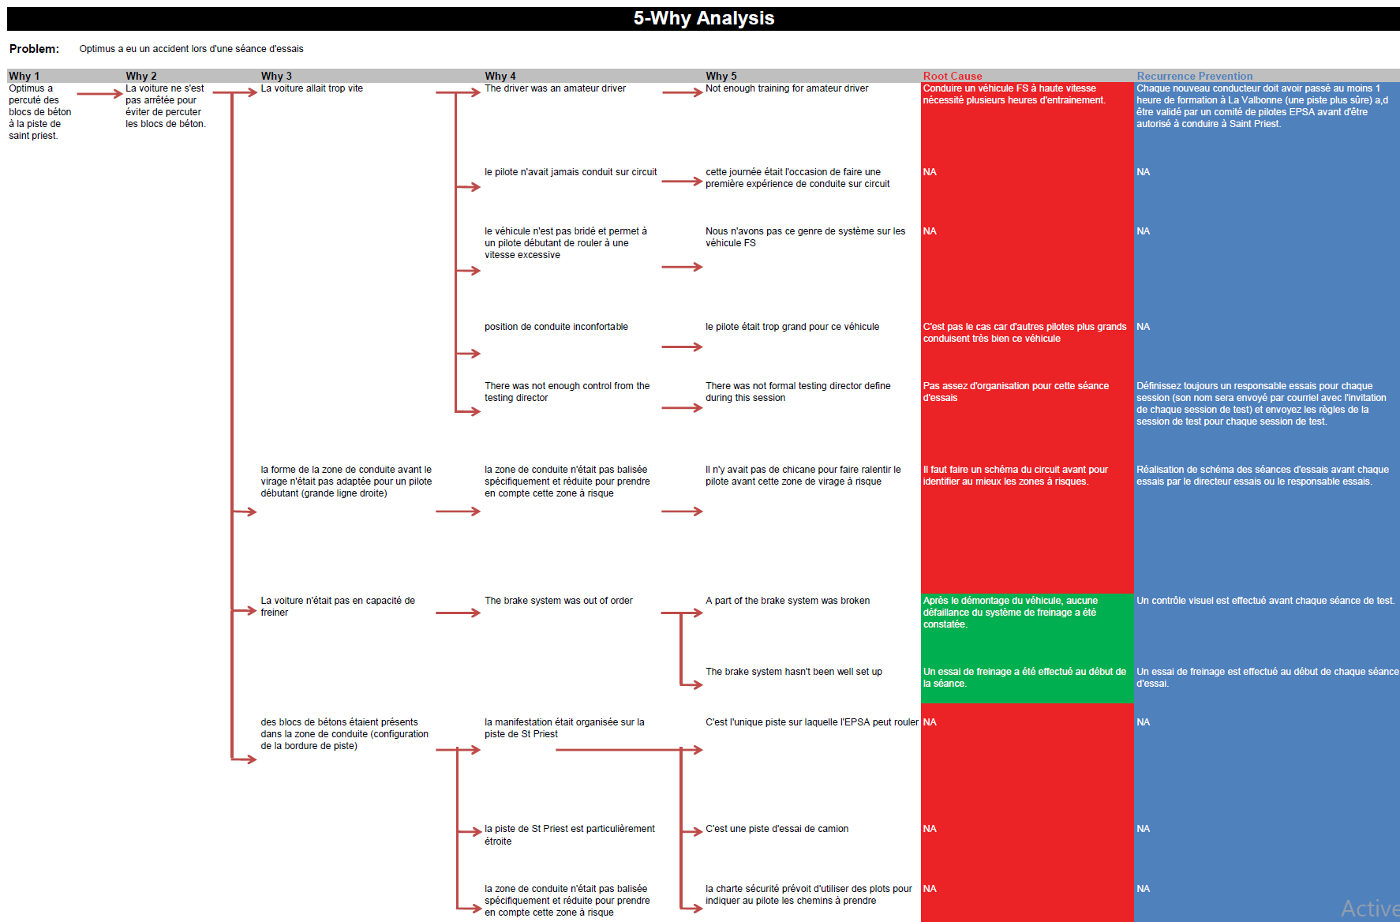
01_Association/Commission d'enquête Optimus/5W.png
