EOSCogniton/Intergen/05_Documents_Competition/Documents_Design_Vulcanix_2018/wetransfer-13cafa/faisceau_NB4_en.pdf

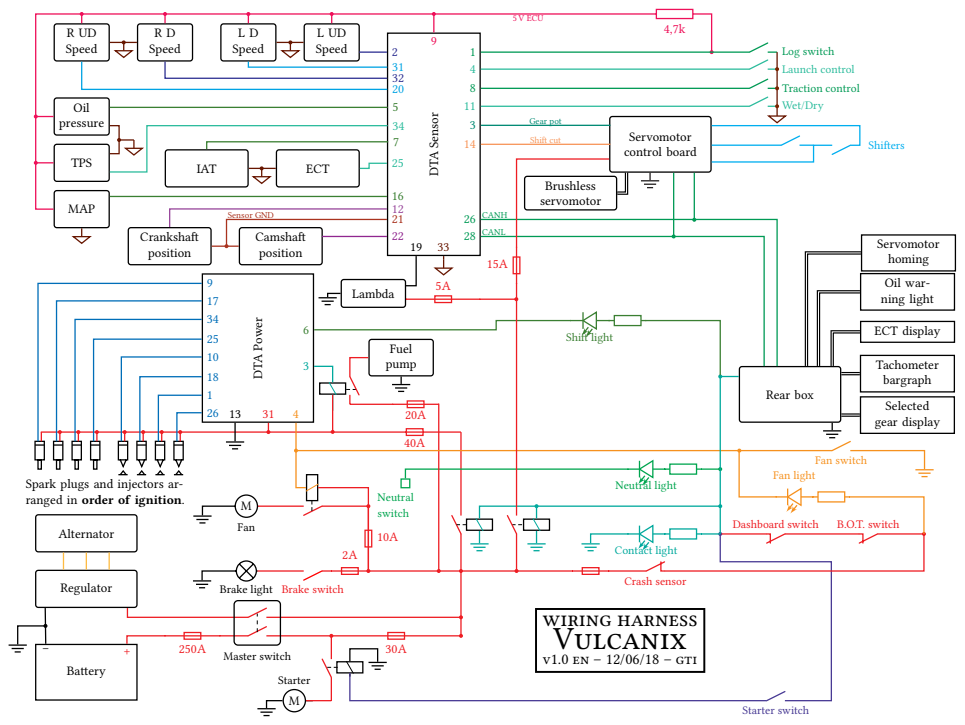
[picture p369: page 1]
Alternator; Regulator; Battery; Starter; Master switch; Starter switch; 31DTA Power; Neutral light; Neutral switch; Brake switch; Brake light; Fan; Fuel; pump; Lambda; 5ADTA Sensor; R UD Speed; R D Speed; L D Speed; Speed; Oil pressure; TPS; IAT; ECT; Crankshaft position; Camshaft position; 12 21 Sensor GND 22; MAP; Servomotor control board; Gear pot; Shift cut; Shifters; Brushless servomotor; Rear box; Tachometer bargraph; Selected gear display; ECT display; Oil war- ning light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

Spark plugs and injectors ar-
ranged in order of ignition.
