EOSCogniton/Intergen/03_Gestion_De_Projet/01_Documents Organisation/2019_Optimus/01_Gantt_Conception_Préliminaire/Gantt_Optimus.pdf

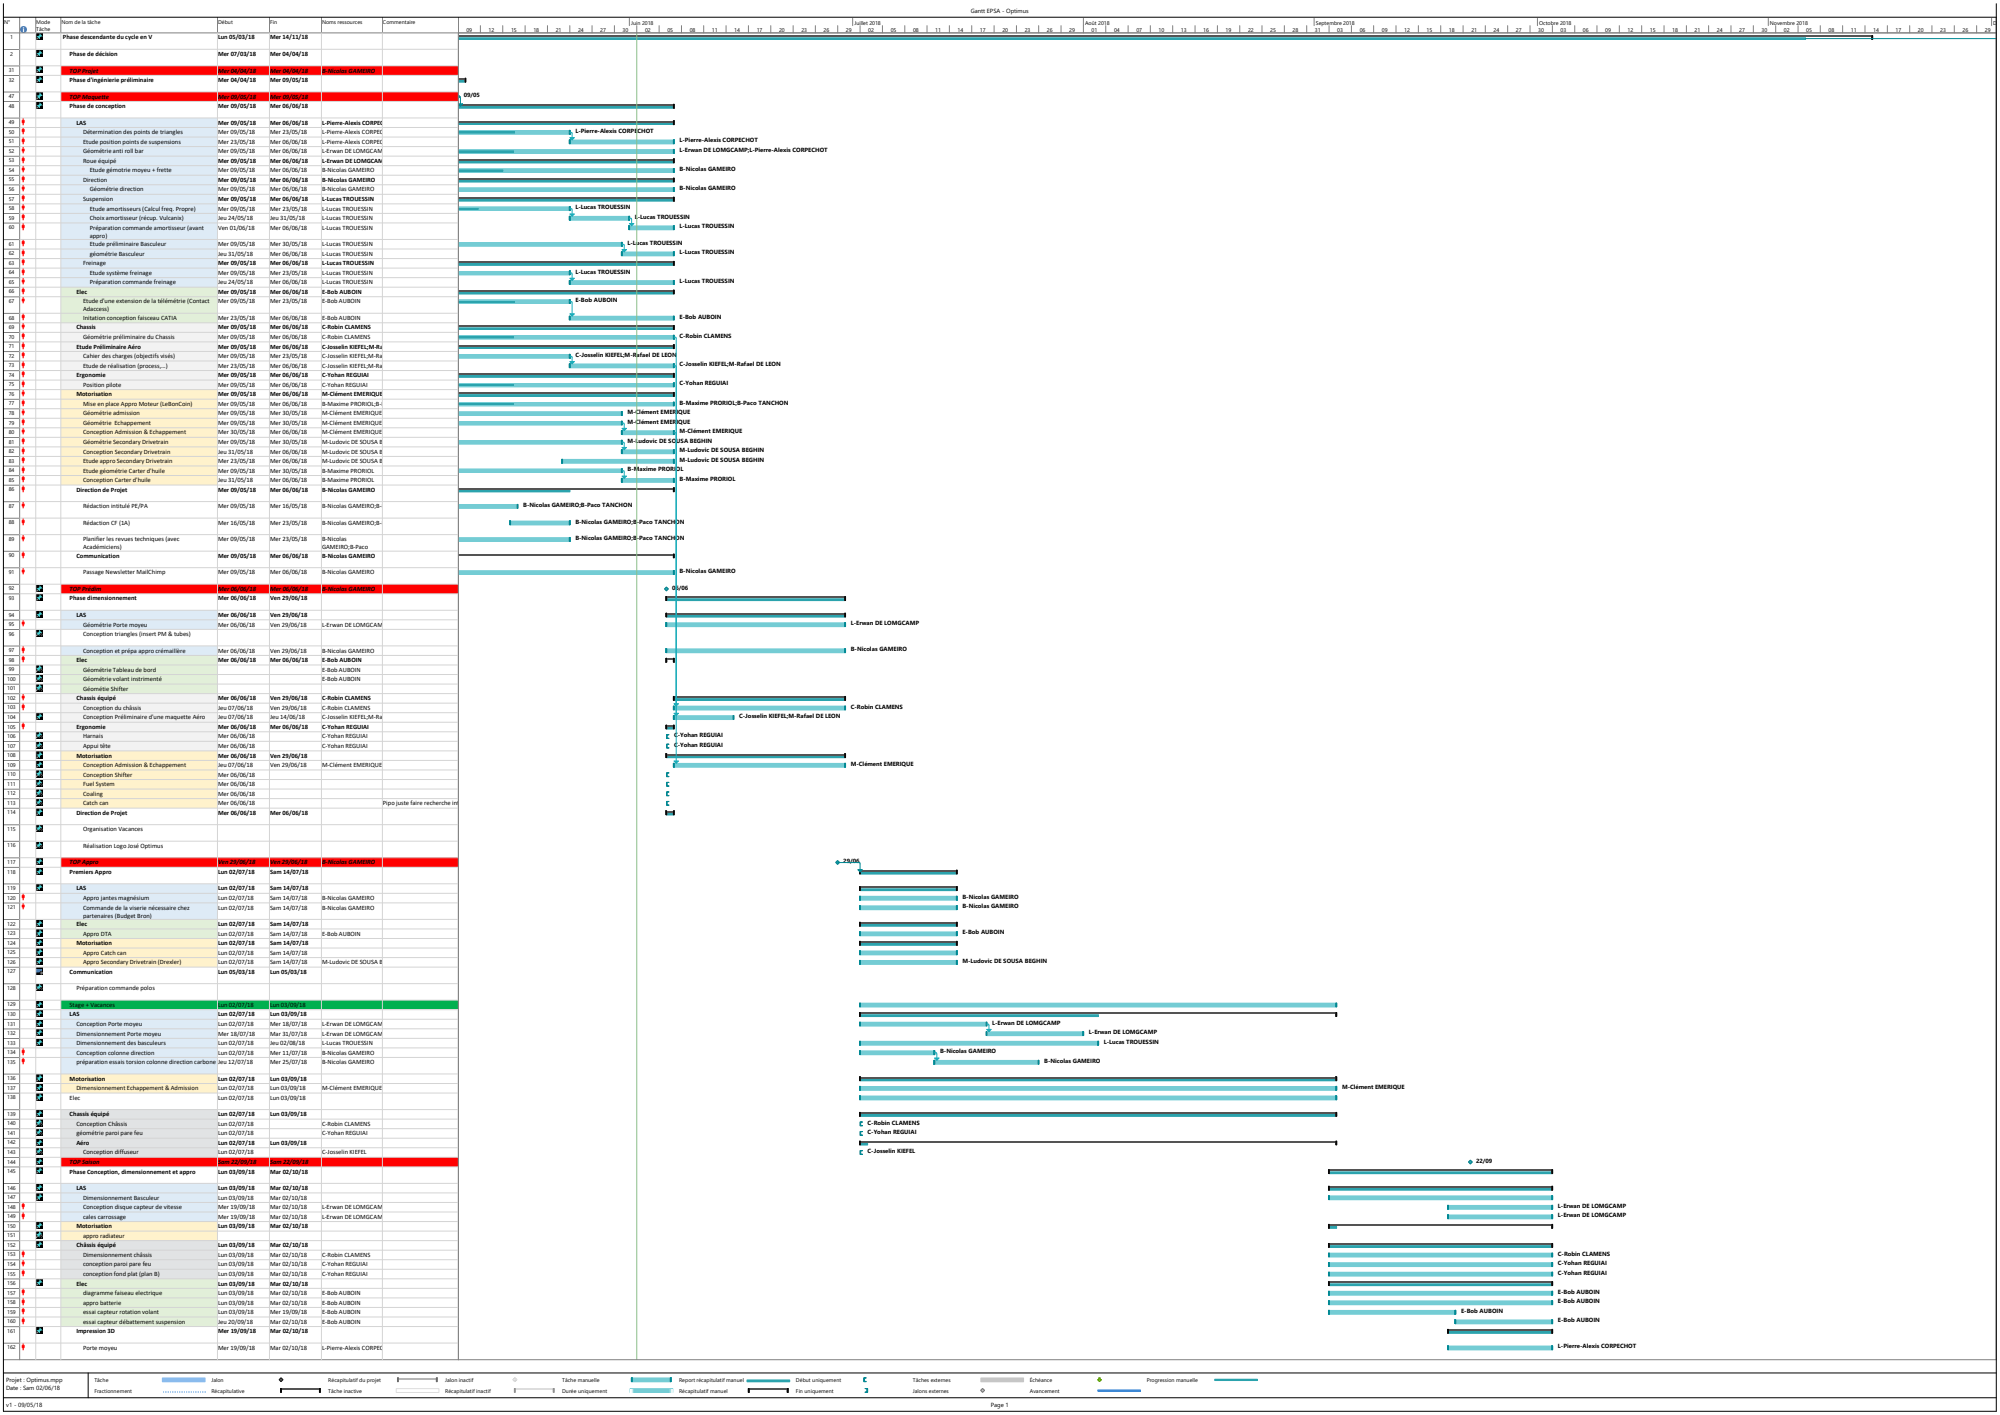
[picture p370: page 1]
B-Nicolas GAMEIRO; L-Lucas TROUESSIN; L-Lucas TROUESSIN L-Lucas TROUESSIN; E-Bob AUBOIN; C-Robin CLAMENS; C-Yohan REGUIAI; M-Clément EMERIQUE M-Clément EMERIQUE M-Clément EMERIQUE; B-Maxime PRORIOL B-Maxime PRORIOL; C-Yohan REGUIAI C-Yohan REGUIAI; M-Clément EMERIQUE; B-Nicolas GAMEIRO B-Nicolas GAMEIRO; C-Robin CLAMENS C-Yohan REGUIAI; C-Josselin KIEFEL; C-Robin CLAMENS C-Yohan REGUIAI C-Yohan REGUIAI; E-Bob AUBOIN E-Bob AUBOIN; Juin 2018; Juillet 2018; Août 2018; Septembre 2018; Octobre 2018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

Gantt EPSA - Optimus

N° | Mode Tâche | Nom de la tâche | Début | Fin | Noms ressources | Commentaire

1 | Phase descendante du cycle en V | Lun 05/03/18 | Mer 14/11/18

2 | Phase de décision | Mer 07/03/18 | Mer 04/04/18

31 | TOP Projet | Mer 04/04/18 | Mer 04/04/18 | B-Nicolas GAMEIRO
32 | Phase d'ingénierie préliminaire | Mer 04/04/18 | Mer 09/05/18

47 | TOP Maquette | Mer 09/05/18 | Mer 09/05/18
48 | Phase de conception | Mer 09/05/18 | Mer 06/06/18

49 | LAS | Mer 09/05/18 | Mer 06/06/18 | L-Pierre-Alexis CORPECHOT
50 | Détermination des points de triangles | Mer 09/05/18 | Mer 23/05/18 | L-Pierre-Alexis CORPECHOT
51 | Etude position points de suspensions | Mer 23/05/18 | Mer 06/06/18 | L-Pierre-Alexis CORPECHOT
52 | Géométrie anti roll bar | Mer 09/05/18 | Mer 06/06/18 | L-Erwan DE LOMGCAMP;L-Pierre-Alexis CORPECHOT
53 | Roue équipé | Mer 09/05/18 | Mer 06/06/18 | L-Erwan DE LOMGCAMP
54 | Etude gémotrie moyeu + frette | Mer 09/05/18 | Mer 06/06/18 | B-Nicolas GAMEIRO
55 | Direction | Mer 09/05/18 | Mer 06/06/18 | B-Nicolas GAMEIRO
56 | Géométrie direction | Mer 09/05/18 | Mer 06/06/18 | B-Nicolas GAMEIRO
57 | Suspension | Mer 09/05/18 | Mer 06/06/18 | L-Lucas TROUESSIN
58 | Etude amortisseurs (Calcul freq. Propre) | Mer 09/05/18 | Mer 23/05/18 | L-Lucas TROUESSIN
59 | Choix amortisseur (récup. Vulcanix) | Jeu 24/05/18 | Jeu 31/05/18 | L-Lucas TROUESSIN
60 | Préparation commande amortisseur (avant appro) | Ven 01/06/18 | Mer 06/06/18 | L-Lucas TROUESSIN

L-Pierre-Alexis CORPECHOT

L-Erwan DE LOMGCAMP;L-Pierre-Alexis CORPECHOT

61 | Etude préliminaire Basculeur | Mer 09/05/18 | Mer 30/05/18 | L-Lucas TROUESSIN
62 | géométrie Basculeur | Jeu 31/05/18 | Mer 06/06/18 | L-Lucas TROUESSIN
63 | Freinage | Mer 09/05/18 | Mer 06/06/18 | L-Lucas TROUESSIN
64 | Etude système freinage | Mer 09/05/18 | Mer 23/05/18 | L-Lucas TROUESSIN
65 | Préparation commande freinage | Jeu 24/05/18 | Mer 06/06/18 | L-Lucas TROUESSIN
66 | Elec | Mer 09/05/18 | Mer 06/06/18 | E-Bob AUBOIN
67 | Etude d'une extension de la télémétrie (Contact Adaccess) | Mer 09/05/18 | Mer 23/05/18 | E-Bob AUBOIN

68 | Initation conception faisceau CATIA | Mer 23/05/18 | Mer 06/06/18 | E-Bob AUBOIN
69 | Chassis | Mer 09/05/18 | Mer 06/06/18 | C-Robin CLAMENS
70 | Géométrie préliminaire du Chassis | Mer 09/05/18 | Mer 06/06/18 | C-Robin CLAMENS
71 | Etude Préliminaire Aéro | Mer 09/05/18 | Mer 06/06/18 | C-Josselin KIEFEL;M-Rafael DE LEON
72 | Cahier des charges (objectifs visés) | Mer 09/05/18 | Mer 23/05/18 | C-Josselin KIEFEL;M-Rafael DE LEON
73 | Etude de réalisation (process,…) | Mer 23/05/18 | Mer 06/06/18 | C-Josselin KIEFEL;M-Rafael DE LEON
74 | Ergonomie | Mer 09/05/18 | Mer 06/06/18 | C-Yohan REGUIAI
75 | Position pilote | Mer 09/05/18 | Mer 06/06/18 | C-Yohan REGUIAI
76 | Motorisation | Mer 09/05/18 | Mer 06/06/18 | M-Clément EMERIQUE
77 | Mise en place Appro Moteur (LeBonCoin) | Mer 09/05/18 | Mer 06/06/18 | B-Maxime PRORIOL;B-Paco TANCHON
78 | Géométrie admission | Mer 09/05/18 | Mer 30/05/18 | M-Clément EMERIQUE
79 | Géométrie Echappement | Mer 09/05/18 | Mer 30/05/18 | M-Clément EMERIQUE
80 | Conception Admission & Echappement | Mer 30/05/18 | Mer 06/06/18 | M-Clément EMERIQUE
81 | Géométrie Secondary Drivetrain | Mer 09/05/18 | Mer 30/05/18 | M-Ludovic DE SOUSA BEGHIN
82 | Conception Secondary Drivetrain | Jeu 31/05/18 | Mer 06/06/18 | M-Ludovic DE SOUSA BEGHIN
83 | Etude appro Secondary Drivetrain | Mer 23/05/18 | Mer 06/06/18 | M-Ludovic DE SOUSA BEGHIN
84 | Etude géométrie Carter d'huile | Mer 09/05/18 | Mer 30/05/18 | B-Maxime PRORIOL
85 | Conception Carter d'huile | Jeu 31/05/18 | Mer 06/06/18 | B-Maxime PRORIOL
86 | Direction de Projet | Mer 09/05/18 | Mer 06/06/18 | B-Nicolas GAMEIRO

C-Josselin KIEFEL;M-Rafael DE LEON

B-Maxime PRORIOL;B-Paco TANCHON

M-Ludovic DE SOUSA BEGHIN

B-Nicolas GAMEIRO;B-Paco TANCHON

87 | Rédaction intitulé PE/PA | Mer 09/05/18 | Mer 16/05/18 | B-Nicolas GAMEIRO;B-Paco TANCHON

88 | Rédaction CF (1A) | Mer 16/05/18 | Mer 23/05/18 | B-Nicolas GAMEIRO;B-Paco TANCHON

89 | Planifier les revues techniques (avec Académiciens) | Mer 09/05/18 | Mer 23/05/18 | B-Nicolas GAMEIRO;B-Paco

90 | Communication | Mer 09/05/18 | Mer 06/06/18 | B-Nicolas GAMEIRO

91 | Passage Newsletter MailChimp | Mer 09/05/18 | Mer 06/06/18 | B-Nicolas GAMEIRO

92 | TOP Prédim | Mer 06/06/18 | Mer 06/06/18 | B-Nicolas GAMEIRO
93 | Phase dimensionnement | Mer 06/06/18 | Ven 29/06/18

94 | LAS | Mer 06/06/18 | Ven 29/06/18
95 | Géométrie Porte moyeu | Mer 06/06/18 | Ven 29/06/18 | L-Erwan DE LOMGCAMP
96 | Conception triangles (insert PM & tubes)

L-Erwan DE LOMGCAMP

97 | Conception et prépa appro crémaillère | Mer 06/06/18 | Ven 29/06/18 | B-Nicolas GAMEIRO
98 | Elec | Mer 06/06/18 | Mer 06/06/18 | E-Bob AUBOIN
99 | Géométrie Tableau de bord | | | E-Bob AUBOIN
100 | Géométrie volant instrimenté | | | E-Bob AUBOIN
101 | Géométie Shifter
102 | Chassis équipé | Mer 06/06/18 | Ven 29/06/18 | C-Robin CLAMENS
103 | Conception du châssis | Jeu 07/06/18 | Ven 29/06/18 | C-Robin CLAMENS
104 | Conception Préliminaire d'une maquette Aéro | Jeu 07/06/18 | Jeu 14/06/18 | C-Josselin KIEFEL;M-Rafael DE LEON
105 | Ergonomie | Mer 06/06/18 | Mer 06/06/18 | C-Yohan REGUIAI
106 | Harnais | Mer 06/06/18 | | C-Yohan REGUIAI
107 | Appui tête | Mer 06/06/18 | | C-Yohan REGUIAI
108 | Motorisation | Mer 06/06/18 | Ven 29/06/18
109 | Conception Admission & Echappement | Jeu 07/06/18 | Ven 29/06/18 | M-Clément EMERIQUE
110 | Conception Shifter | Mer 06/06/18
111 | Fuel System | Mer 06/06/18
112 | Coaling | Mer 06/06/18
113 | Catch can | Mer 06/06/18 | | | Pipo juste faire recherche internet pour appro
114 | Direction de Projet | Mer 06/06/18 | Mer 06/06/18

115 | Organisation Vacances

116 | Réalisation Logo José Optimus

117 | TOP Appro | Ven 29/06/18 | Ven 29/06/18 | B-Nicolas GAMEIRO
118 | Premiers Appro | Lun 02/07/18 | Sam 14/07/18

119 | LAS | Lun 02/07/18 | Sam 14/07/18
120 | Appro jantes magnésium | Lun 02/07/18 | Sam 14/07/18 | B-Nicolas GAMEIRO
121 | Commande de la viserie nécessaire chez partenaires (Budget Bron) | Lun 02/07/18 | Sam 14/07/18 | B-Nicolas GAMEIRO

122 | Elec | Lun 02/07/18 | Sam 14/07/18
123 | Appro DTA | Lun 02/07/18 | Sam 14/07/18 | E-Bob AUBOIN
124 | Motorisation | Lun 02/07/18 | Sam 14/07/18
125 | Appro Catch can | Lun 02/07/18 | Sam 14/07/18
126 | Appro Secondary Drivetrain (Drexler) | Lun 02/07/18 | Sam 14/07/18 | M-Ludovic DE SOUSA BEGHIN
127 | Communication | Lun 05/03/18 | Lun 05/03/18

128 | Préparation commande polos

129 | Stage + Vacances | Lun 02/07/18 | Lun 03/09/18
130 | LAS | Lun 02/07/18 | Lun 03/09/18
131 | Conception Porte moyeu | Lun 02/07/18 | Mer 18/07/18 | L-Erwan DE LOMGCAMP
132 | Dimensionnement Porte moyeu | Mer 18/07/18 | Mar 31/07/18 | L-Erwan DE LOMGCAMP
133 | Dimensionnement des basculeurs | Lun 02/07/18 | Jeu 02/08/18 | L-Lucas TROUESSIN
134 | Conception colonne direction | Lun 02/07/18 | Mer 11/07/18 | B-Nicolas GAMEIRO
135 | préparation essais torsion colonne direction carbone Jeu 12/07/18 | | Mer 25/07/18 | B-Nicolas GAMEIRO

L-Lucas TROUESSIN

136 | Motorisation | Lun 02/07/18 | Lun 03/09/18
137 | Dimensionnement Echappement & Admission | Lun 02/07/18 | Lun 03/09/18 | M-Clément EMERIQUE
138 | Elec | Lun 02/07/18 | Lun 03/09/18

139 | Chassis équipé | Lun 02/07/18 | Lun 03/09/18
140 | Conception Châssis | Lun 02/07/18 | | C-Robin CLAMENS
141 | géométrie paroi pare feu | Lun 02/07/18 | | C-Yohan REGUIAI
142 | Aéro | Lun 02/07/18 | Lun 03/09/18
143 | Conception diffuseur | Lun 02/07/18 | | C-Josselin KIEFEL
144 | TOP Saison | Sam 22/09/18 | Sam 22/09/18
145 | Phase Conception, dimensionnement et appro | Lun 03/09/18 | Mar 02/10/18

146 | LAS | Lun 03/09/18 | Mar 02/10/18
147 | Dimensionnement Basculeur | Lun 03/09/18 | Mar 02/10/18
148 | Conception disque capteur de vitesse | Mer 19/09/18 | Mar 02/10/18 | L-Erwan DE LOMGCAMP
149 | cales carrossage | Mer 19/09/18 | Mar 02/10/18 | L-Erwan DE LOMGCAMP
150 | Motorisation | Lun 03/09/18 | Mar 02/10/18
151 | appro radiateur
152 | Châssis équipé | Lun 03/09/18 | Mar 02/10/18
153 | Dimensionnement châssis | Lun 03/09/18 | Mar 02/10/18 | C-Robin CLAMENS
154 | conception paroi pare feu | Lun 03/09/18 | Mar 02/10/18 | C-Yohan REGUIAI
155 | conception fond plat (plan B) | Lun 03/09/18 | Mar 02/10/18 | C-Yohan REGUIAI
156 | Elec | Lun 03/09/18 | Mar 02/10/18
157 | diagramme faiseau electrique | Lun 03/09/18 | Mar 02/10/18 | E-Bob AUBOIN
158 | appro batterie | Lun 03/09/18 | Mar 02/10/18 | E-Bob AUBOIN
159 | essai capteur rotation volant | Lun 03/09/18 | Mer 19/09/18 | E-Bob AUBOIN
160 | essai capteur débattement suspension | Jeu 20/09/18 | Mar 02/10/18 | E-Bob AUBOIN
161 | Impression 3D | Mer 19/09/18 | Mar 02/10/18

162 | Porte moyeu | Mer 19/09/18 | Mar 02/10/18 | L-Pierre-Alexis CORPECHOT

Projet : Optimus.mpp
Date : Sam 02/06/18

Récapitulatif du projet
Tâche inactive

Report récapitulatif manuel
Récapitulatif manuel

N° | Mode Tâche | Nom de la tâche | Début | Fin | Noms ressources | Commentaire
163 | Frette | Mer 19/09/18 | Mar 02/10/18 | L-Pierre-Alexis CORPECHOT | | | 02/10 | 06/11
164 | Modèle réduit châssis équipé | Mer 19/09/18 | Mar 02/10/18 | C-Robin CLAMENS
165 | Tableau de bord | Mer 19/09/18 | Mar 02/10/18 | E-Bob AUBOIN
166 | Moyeu | Mer 19/09/18 | Mar 02/10/18 | L-Pierre-Alexis CORPECHOT
167 | Carter d'huile | Mer 19/09/18 | Mar 02/10/18 | B-Maxime PRORIOL
168 | Communication | Lun 03/09/18 | Mar 02/10/18
169 | Commande des polos | Lun 03/09/18 | Jeu 20/09/18
170 | TOP Synthèse | Mar 02/10/18 | Mar 02/10/18
171 | LAS | Mar 02/10/18 | Mar 06/11/18
176 | Motorisation | Mar 02/10/18 | Lun 05/11/18
177 | Châssis équipé | Mar 02/10/18 | Lun 05/11/18
178 | Elec | Mar 02/10/18 | Lun 05/11/18
179 | Réalisation des châpes | Mar 02/10/18 | Mar 06/11/18
195 | Direction de Projet | Lun 05/03/18 | Mar 06/11/18
196 | Prévenir partenaire lancement production | Lun 05/03/18 | Lun 05/11/18
197 | TOP Copeau | Mar 06/11/18 | Mar 06/11/18 | B-Nicolas GAMEIRO
198 | Phase remontante du cycle en V | Mer 14/11/18 | Lun 01/07/19

L-Pierre-Alexis CORPECHOT

C-Robin CLAMENS

E-Bob AUBOIN

L-Pierre-Alexis CORPECHOT

B-Maxime PRORIOL

09 | 12 | 15 | 18 | 21 | 24 | 27 | 30 | 02 | 05 | 08 | 11 | 14 | 17 | 20 | 23 | 26 | 29 | 02 | 05 | 08 | 11 | 14 | 17 | 20 | 23 | 26 | 29 | 01 | 04 | 07 | 10 | 13 | 16 | 19 | 22 | 25 | 28 | 31 | 03 | 06 | 09 | 12 | 15 | 18 | 21 | 24 | 27 | 30 | 03 | 06 | 09 | 12 | 15 | 18 | 21 | 24 | 27 | 30 | 02 | 05 | 08 | 11 | 14 | 17 | 20 | 23 | 26 | 29
Juin 2018 | Juillet 2018 | Août 2018 | Septembre 2018 | Octobre 2018 | Novembre 2018 | Décembre 2018

Tâche
Fractionnement

Jalon
Récapitulative

Récapitulatif du projet
Tâche inactive

Jalon inactif
Récapitulatif inactif

Tâche manuelle
Durée uniquement

Report récapitulatif manuel Récapitulatif manuel

Début uniquement
Fin uniquement

Tâches externes
Jalons externes

Échéance
Avancement

Progression manuelle

Gantt EPSA - Optimus

v1 - 09/05/18 | Page 2

Projet : Optimus.mpp
Date : Sam 02/06/18
