EOSCogniton/Intergen/07_Documents Techniques/03_Ressources_Cours/Cours UTC CFD/CF04_EcoulementsCompressibles.pdf

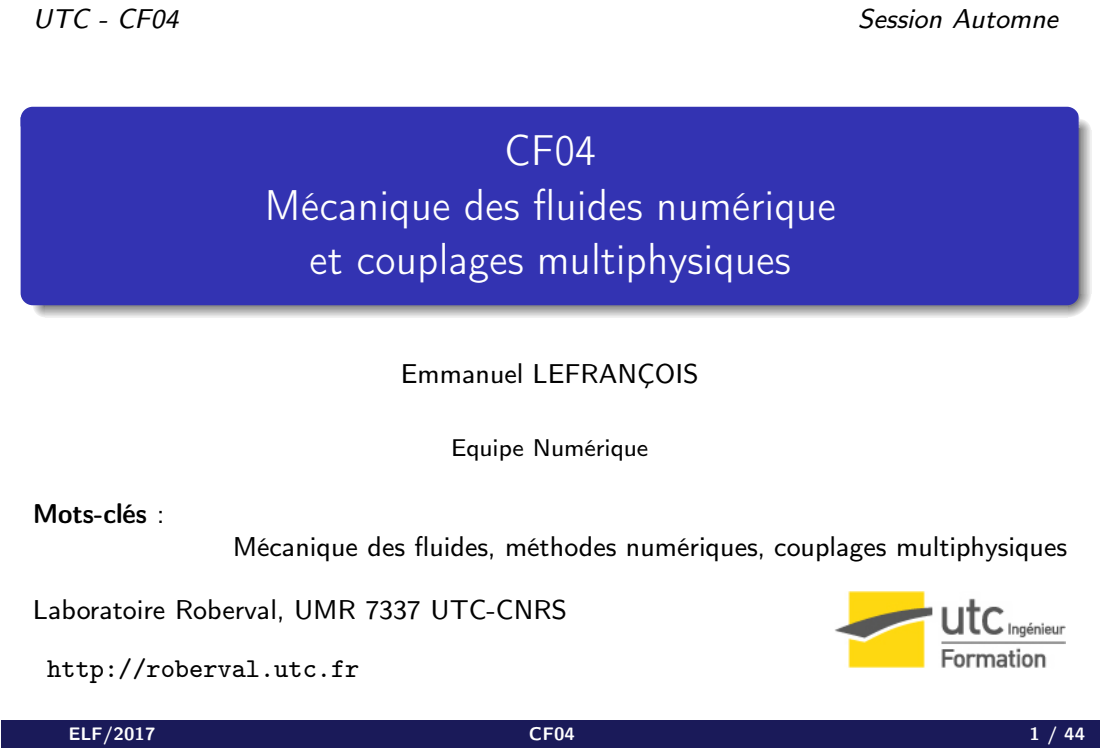
[picture p371: page 1]
UTC - CF04; Session Automne; Emmanuel LEFRANÇOIS; Equipe Numérique; Mots-clés :; ELF/2017

Mécanique des fluides numérique
et couplages multiphysiques

Mécanique des fluides, méthodes numériques, couplages multiphysiques

Laboratoire Roberval, UMR 7337 UTC-CNRS

http://roberval.utc.fr

## Cinquième partie

## Ecoulements compressibles et captures de chocs

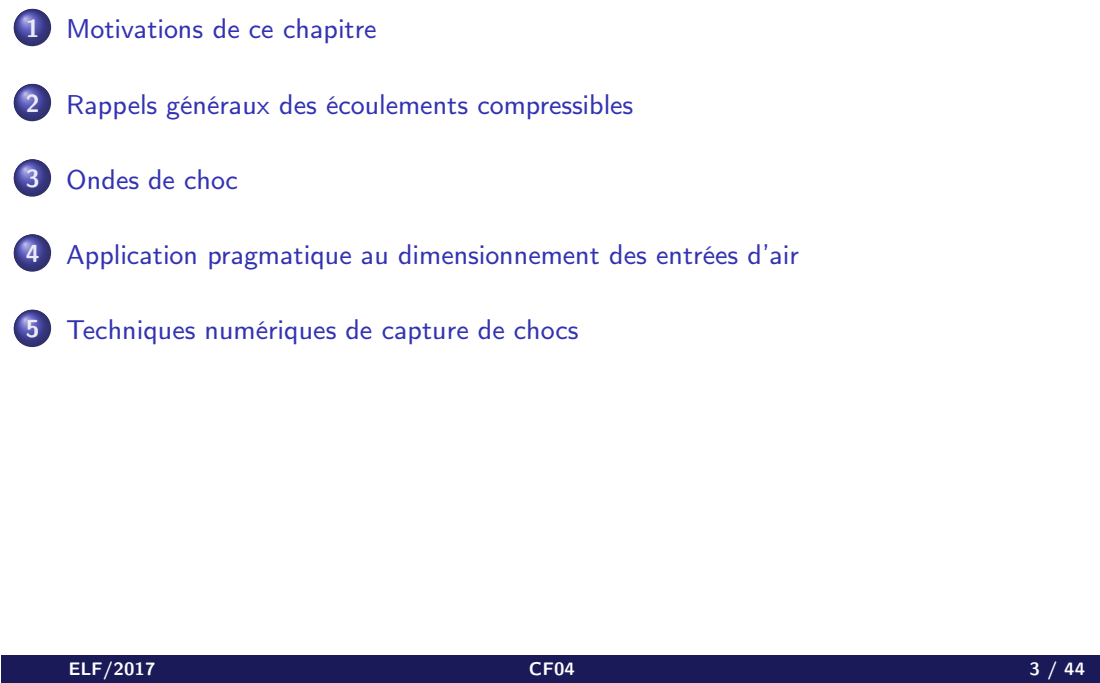
[picture p372: page 3]
Motivations de ce chapitre; Rappels généraux des écoulements compressibles; Ondes de choc; Application pragmatique au dimensionnement des entrées d’air; Techniques numériques de capture de chocs

## Section. 1

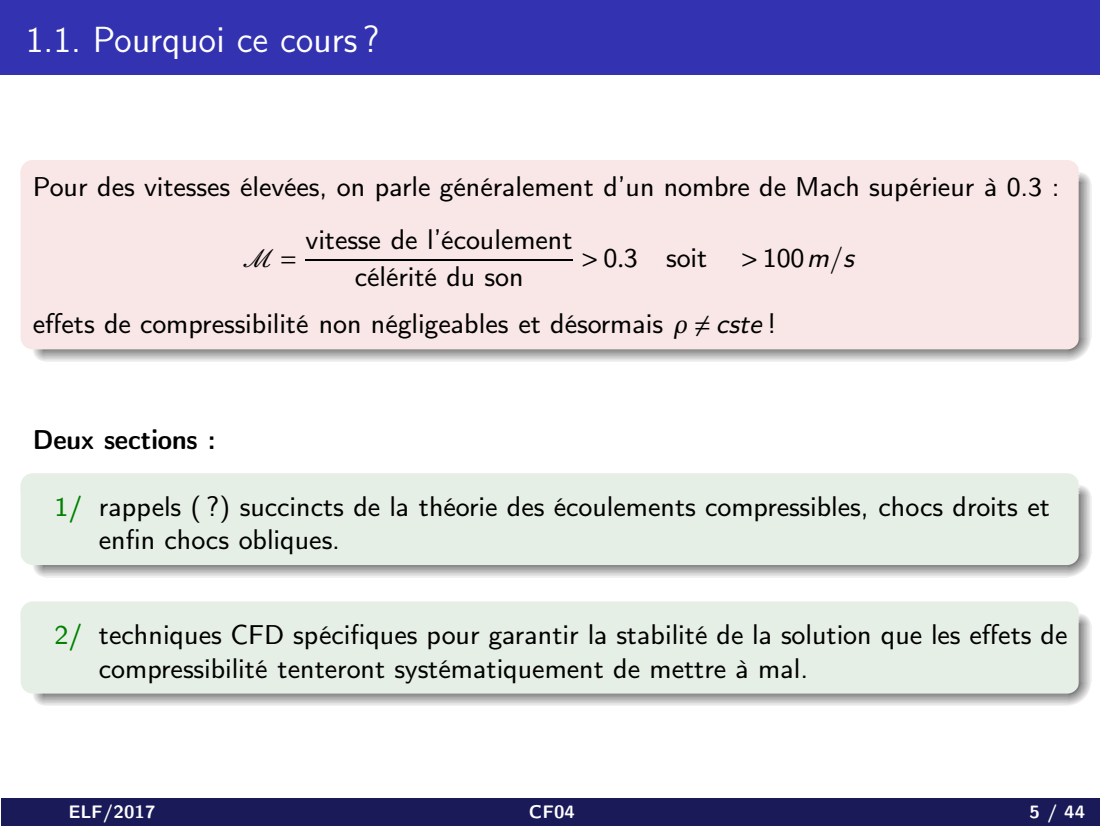
[picture p373: page 5]
célérité du son; > 0.3 soit > 100m/s; Deux sections :

1.1. Pourquoi ce cours ?

Pour des vitesses élevées, on parle généralement d’un nombre de Mach supérieur à 0.3 :

vitesse de l’écoulement

effets de compressibilité non négligeables et désormais ρ 6= cste !

1/ rappels ( ?) succincts de la théorie des écoulements compressibles, chocs droits et
enfin chocs obliques.

2/ techniques CFD spécifiques pour garantir la stabilité de la solution que les effets de
compressibilité tenteront systématiquement de mettre à mal.

## Section. 2

## Rappels généraux des écoulements compressibles

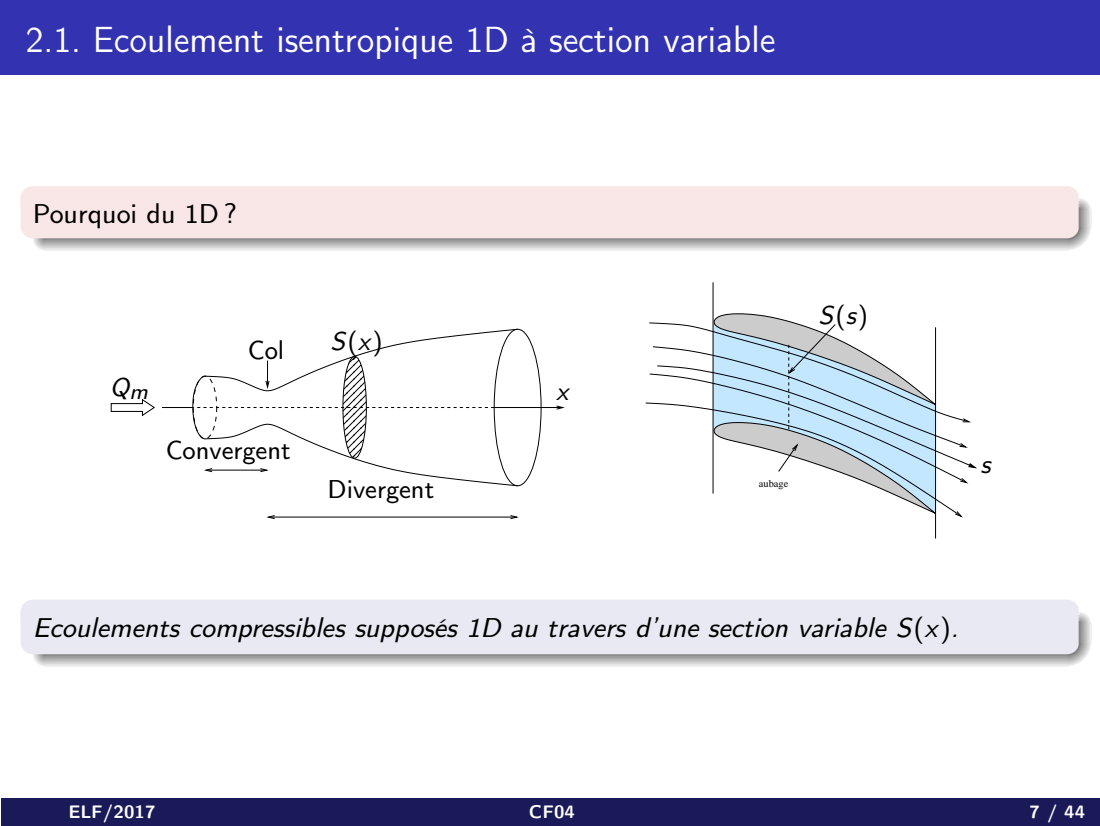
[picture p374: page 7]
Pourquoi du 1D ?; aubage; Divergent; Convergent; Col

2.1. Ecoulement isentropique 1D à section variable

Ecoulements compressibles supposés 1D au travers d’une section variable S(x).

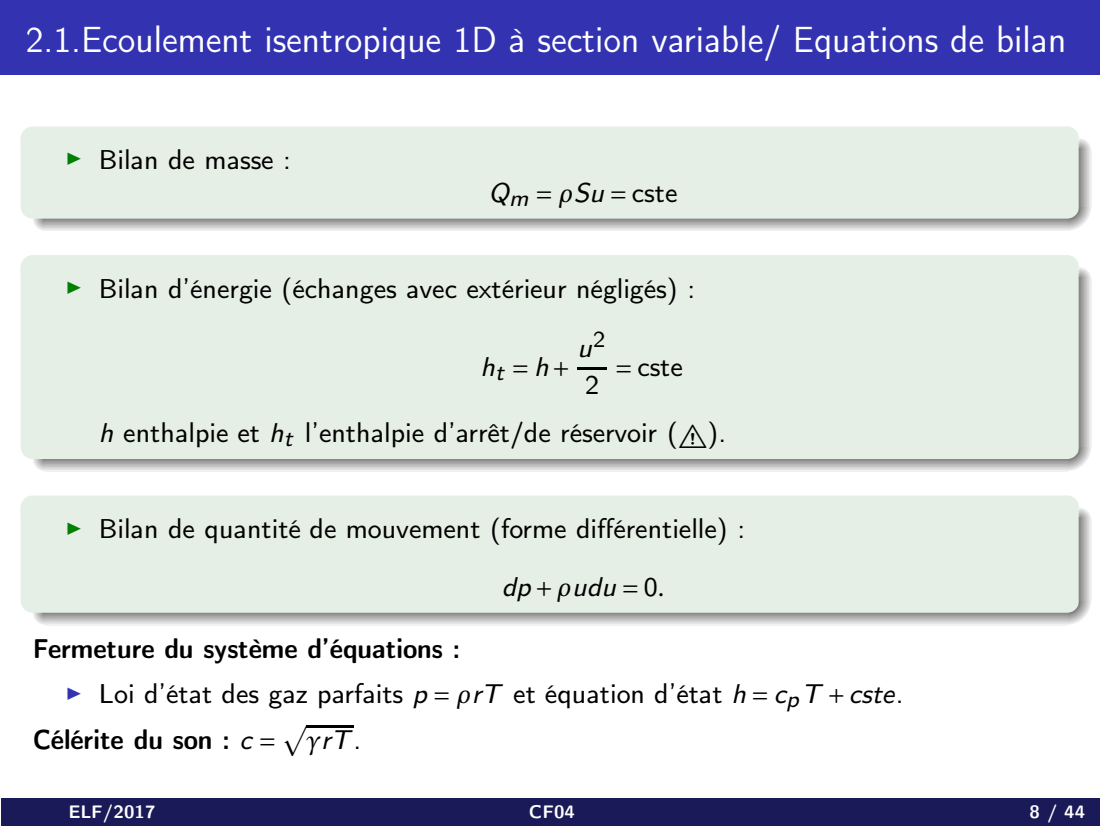
[picture p375: page 8]
= cste; dp +ρudu = 0.; γrT .

2.1.Ecoulement isentropique 1D à section variable/ Equations de bilan

Ï Bilan de masse :

Qm = ρSu = cste

Ï Bilan d’énergie (échanges avec extérieur négligés) :

h enthalpie et ht l’enthalpie d’arrêt/de réservoir (B).

Ï Bilan de quantité de mouvement (forme différentielle) :

Fermeture du système d’équations :
Ï Loi d’état des gaz parfaits p = ρrT et équation d’état h = cpT +cste.

Célérite du son : c =

Ã

!

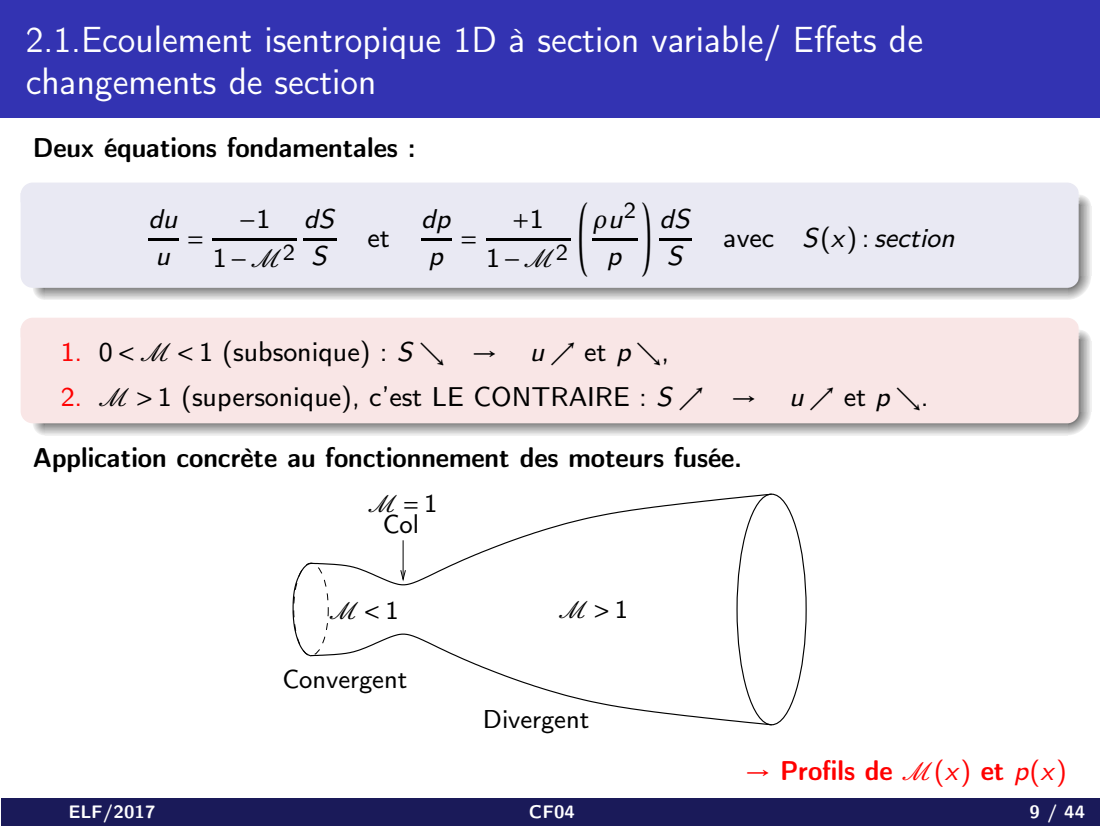
[picture p376: page 9]
avec S(x) :section; 1. 0 < M < 1 (subsonique) : S ց; 2. M > 1 (supersonique), c’est LE CONTRAIRE : S ր; Divergent; Convergent; Col

2.1.Ecoulement isentropique 1D à section variable/ Effets de
changements de section

Deux équations fondamentales :

Application concrète au fonctionnement des moteurs fusée.

→ Profils de M(x) et p(x)

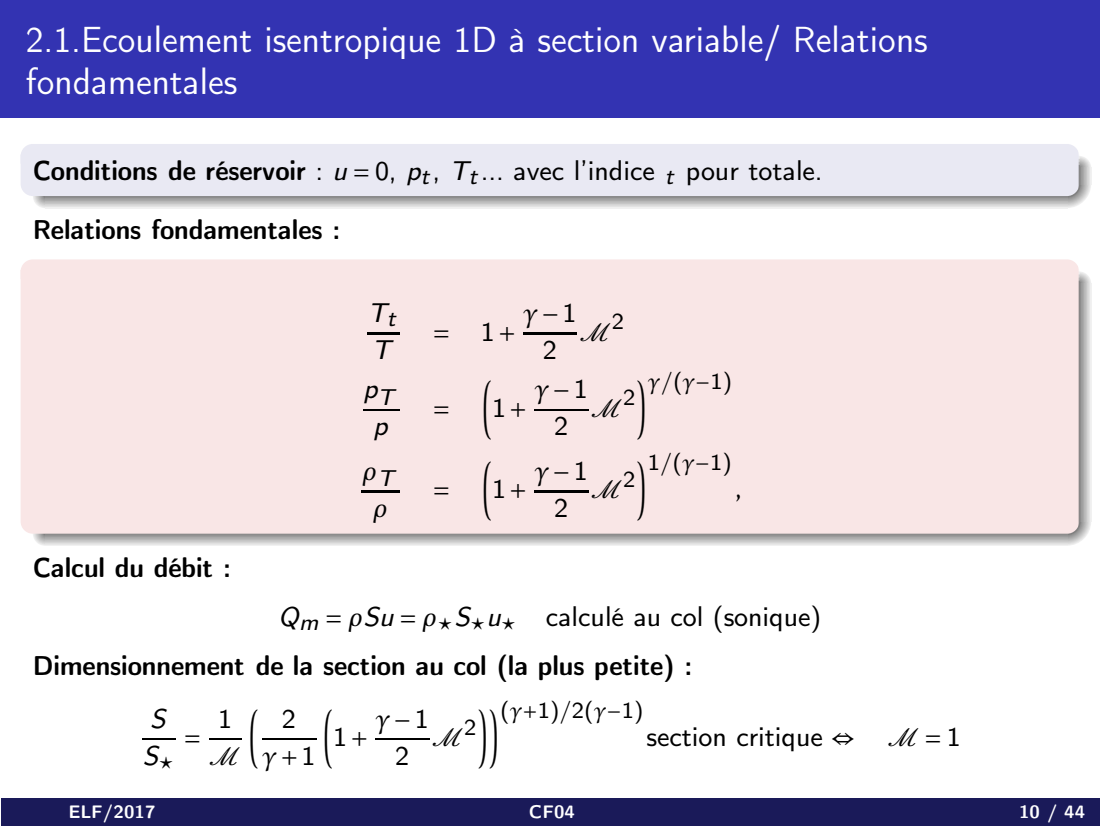
[picture p377: page 10]
Relations fondamentales :; Qm = ρSu = ρ⋆S⋆u⋆; calculé au col (sonique); section critique ⇔

2.1.Ecoulement isentropique 1D à section variable/ Relations
fondamentales

Conditions de réservoir : u = 0, pt, Tt... avec l’indice t pour totale.

Calcul du débit :

Dimensionnement de la section au col (la plus petite) :

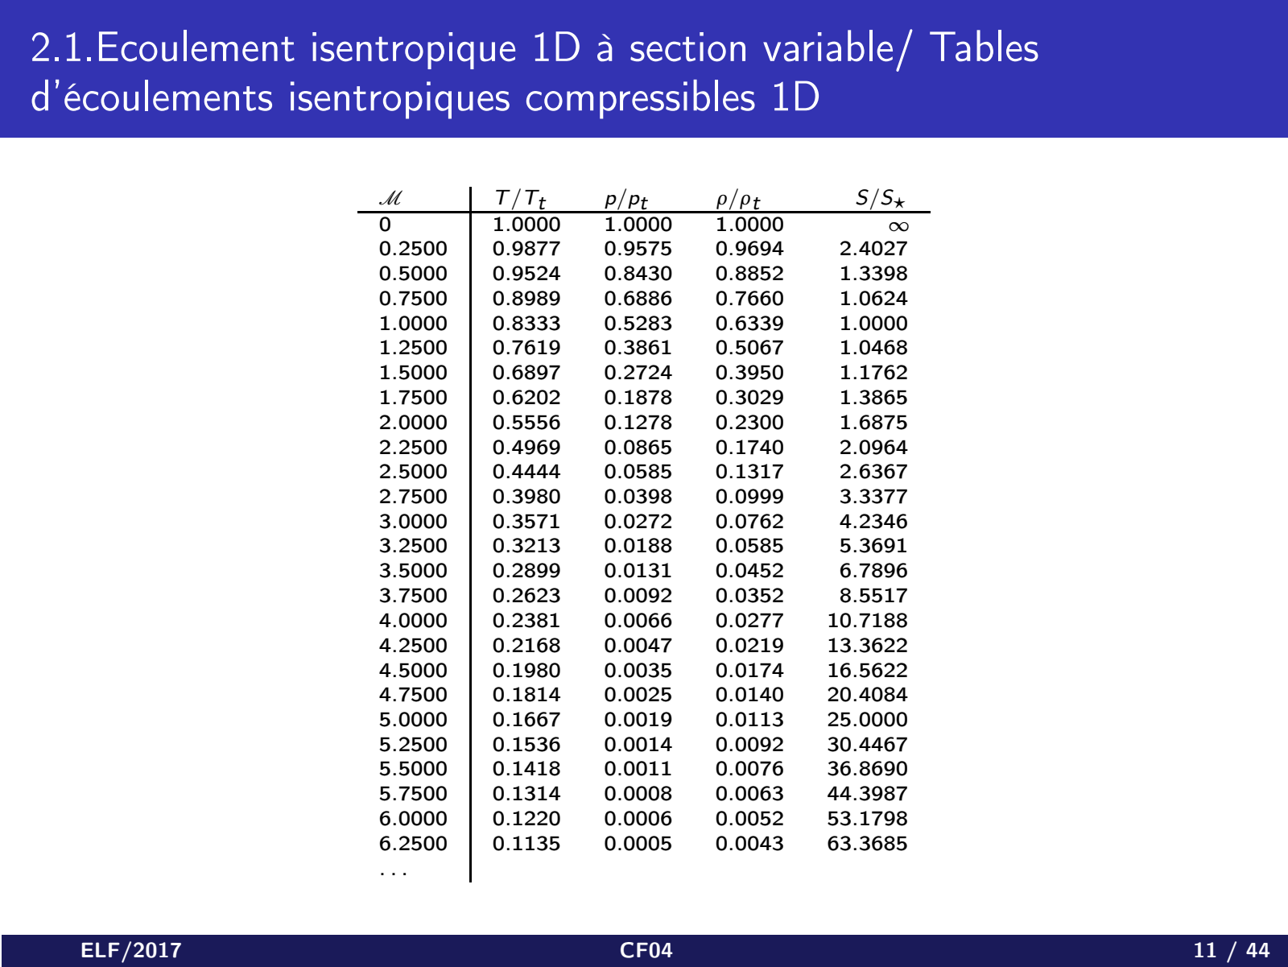
[picture p378: page 11]

### 2.1.Ecoulement isentropique 1D à section variable/ Tables d’écoulements isentropiques compressibles 1D

M | T/Tt | p/pt | ρ/ρt | S/S⋆
0 | 1.0000 | 1.0000 | 1.0000 | ∞
0.2500 | 0.9877 | 0.9575 | 0.9694 | 2.4027
0.5000 | 0.9524 | 0.8430 | 0.8852 | 1.3398
0.7500 | 0.8989 | 0.6886 | 0.7660 | 1.0624
1.0000 | 0.8333 | 0.5283 | 0.6339 | 1.0000
1.2500 | 0.7619 | 0.3861 | 0.5067 | 1.0468
1.5000 | 0.6897 | 0.2724 | 0.3950 | 1.1762
1.7500 | 0.6202 | 0.1878 | 0.3029 | 1.3865
2.0000 | 0.5556 | 0.1278 | 0.2300 | 1.6875
2.2500 | 0.4969 | 0.0865 | 0.1740 | 2.0964
2.5000 | 0.4444 | 0.0585 | 0.1317 | 2.6367
2.7500 | 0.3980 | 0.0398 | 0.0999 | 3.3377
3.0000 | 0.3571 | 0.0272 | 0.0762 | 4.2346
3.2500 | 0.3213 | 0.0188 | 0.0585 | 5.3691
3.5000 | 0.2899 | 0.0131 | 0.0452 | 6.7896
3.7500 | 0.2623 | 0.0092 | 0.0352 | 8.5517
4.0000 | 0.2381 | 0.0066 | 0.0277 | 10.7188
4.2500 | 0.2168 | 0.0047 | 0.0219 | 13.3622
4.5000 | 0.1980 | 0.0035 | 0.0174 | 16.5622
4.7500 | 0.1814 | 0.0025 | 0.0140 | 20.4084
5.0000 | 0.1667 | 0.0019 | 0.0113 | 25.0000
5.2500 | 0.1536 | 0.0014 | 0.0092 | 30.4467
5.5000 | 0.1418 | 0.0011 | 0.0076 | 36.8690
5.7500 | 0.1314 | 0.0008 | 0.0063 | 44.3987
6.0000 | 0.1220 | 0.0006 | 0.0052 | 53.1798
6.2500 | 0.1135 | 0.0005 | 0.0043 | 63.3685

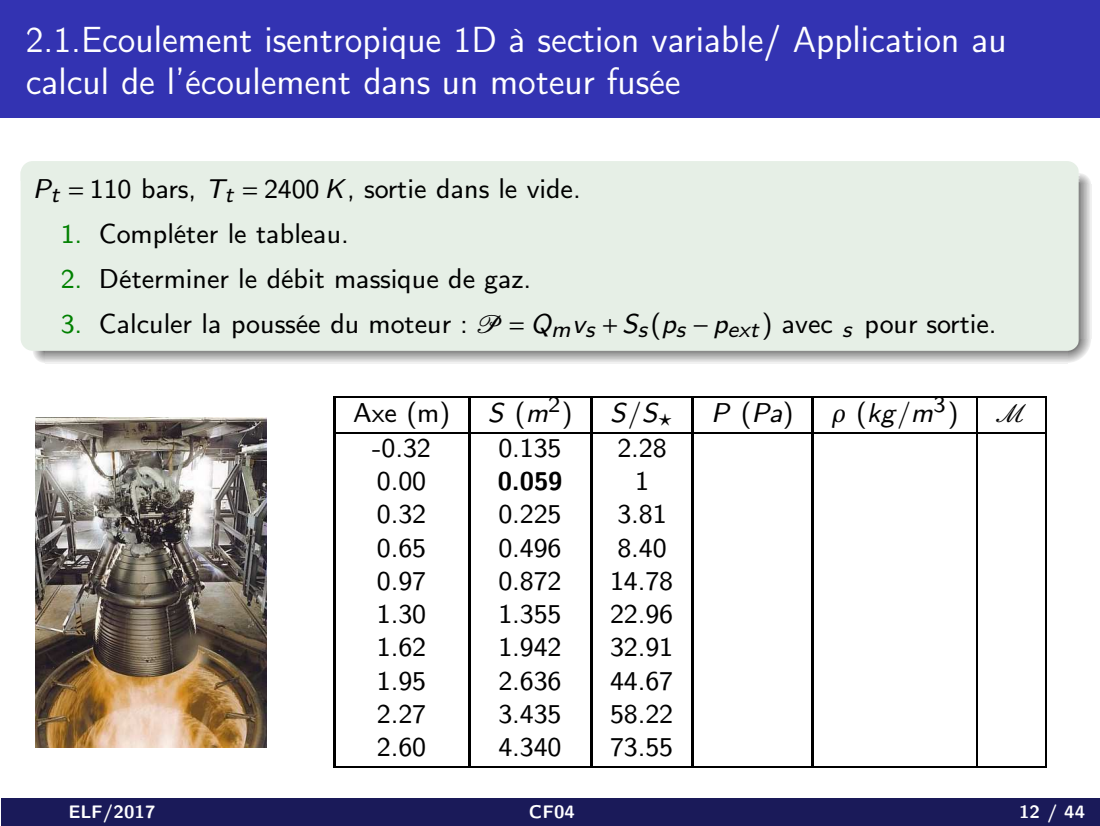
[picture p379: page 12]
Axe (m)

2.1.Ecoulement isentropique 1D à section variable/ Application au
calcul de l’écoulement dans un moteur fusée

Pt = 110 bars, Tt = 2400 K, sortie dans le vide.
1. Compléter le tableau.
2. Déterminer le débit massique de gaz.
3. Calculer la poussée du moteur : P = Qmvs +Ss (ps −pext ) avec s pour sortie.

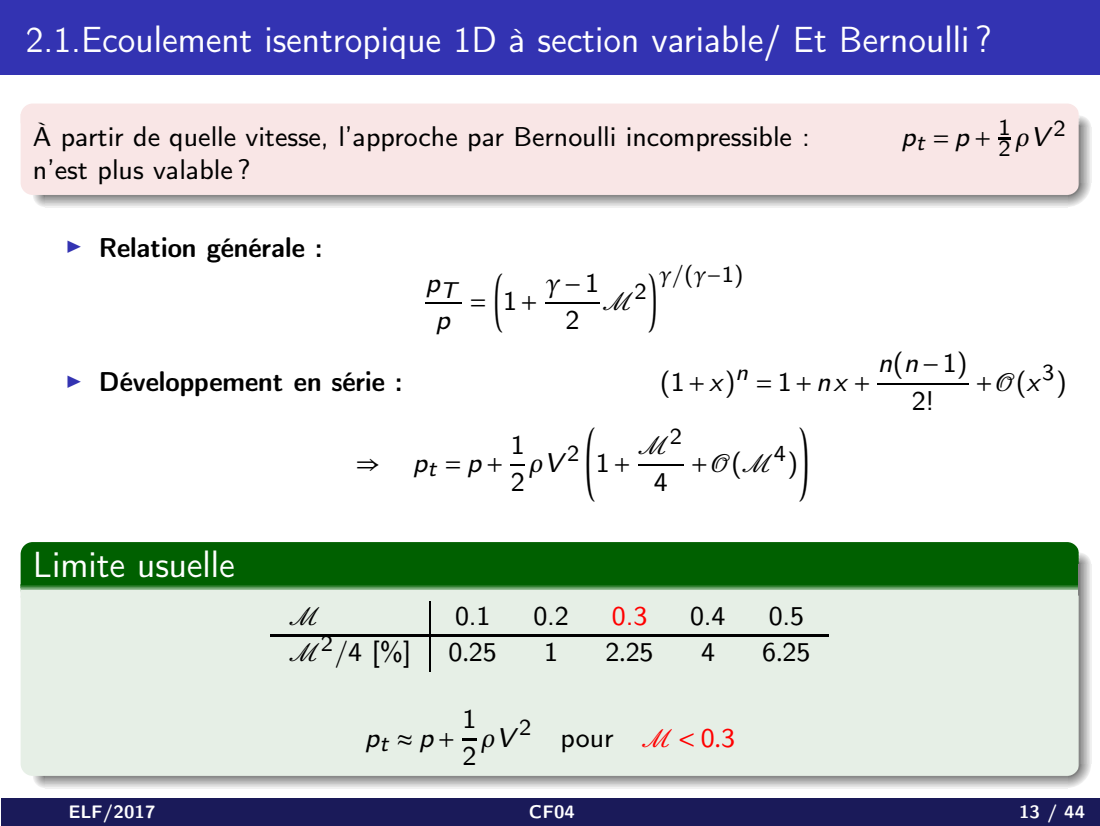
[picture p380: page 13]
À partir de quelle vitesse, l’approche par Bernoulli incompressible :; Ï Relation générale :; Ï Développement en série :; Limite usuelle; pour M < 0.3

2.1.Ecoulement isentropique 1D à section variable/ Et Bernoulli ?

n’est plus valable ?

## Section. 3

### 3.1. Késako ?

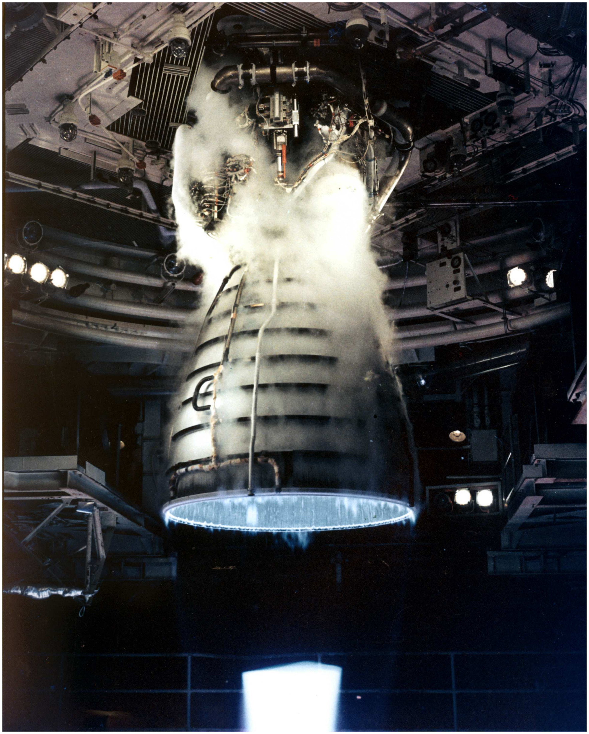
[picture p381: figure]
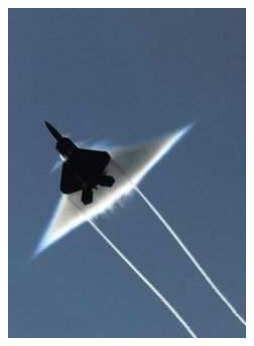
[picture p382: figure]
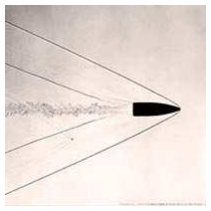
[picture p383: figure]

J2S Space Shuttle Engine | Projectile supersonique | Passage mur du son sur F22

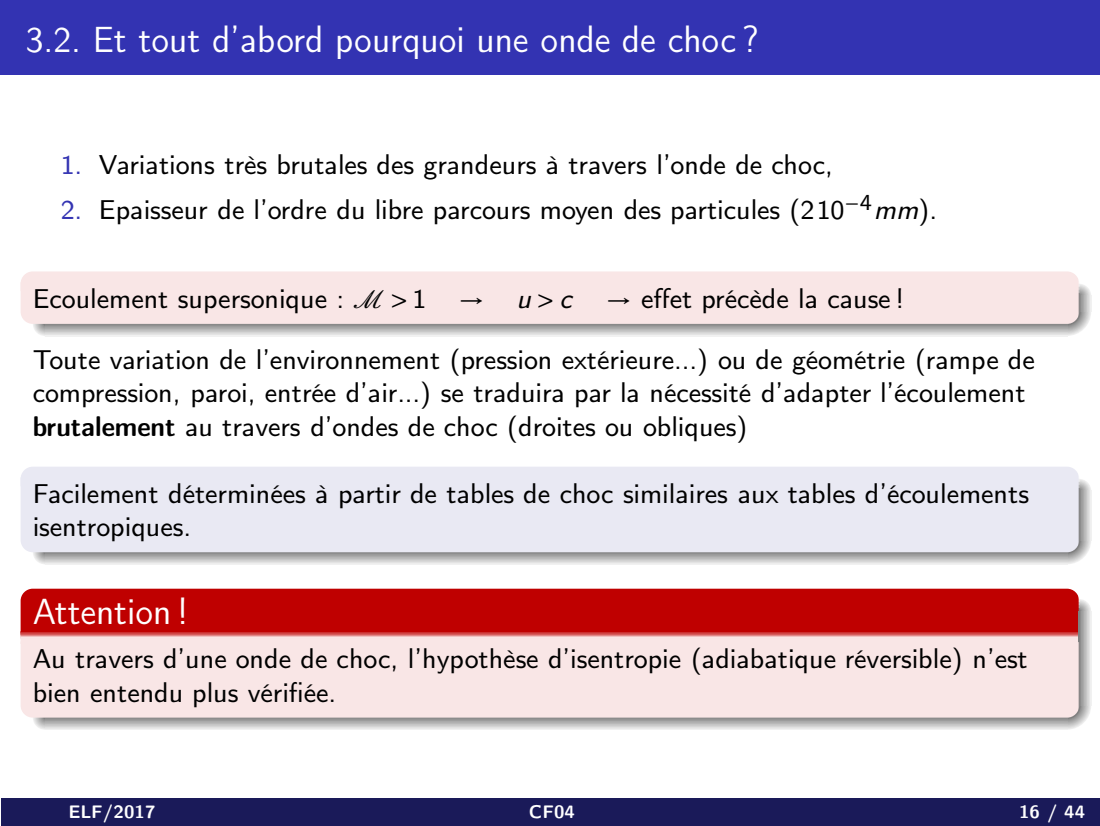
[picture p384: page 16]
Ecoulement supersonique : M > 1 →; → effet précède la cause !

3.2. Et tout d’abord pourquoi une onde de choc ?

1. Variations très brutales des grandeurs à travers l’onde de choc,
2. Epaisseur de l’ordre du libre parcours moyen des particules (210⁻⁴mm).

Toute variation de l’environnement (pression extérieure...) ou de géométrie (rampe de
compression, paroi, entrée d’air...) se traduira par la nécessité d’adapter l’écoulement
brutalement au travers d’ondes de choc (droites ou obliques)

Facilement déterminées à partir de tables de choc similaires aux tables d’écoulements
isentropiques.

Attention !
Au travers d’une onde de choc, l’hypothèse d’isentropie (adiabatique réversible) n’est
bien entendu plus vérifiée.

### 3.3. Onde de choc droite STATIONNAIRE

Onde de choc droite

Section S

u1 | u2
M1 > 1 | M2 < 1
p1, T1, ρ1 | p2, T2, ρ2

Hypothèses simplificatrices :
1. les forces de frottement,
2. les forces de gravité,
3. les échanges caloriques avec l’extérieur (adiabatique).

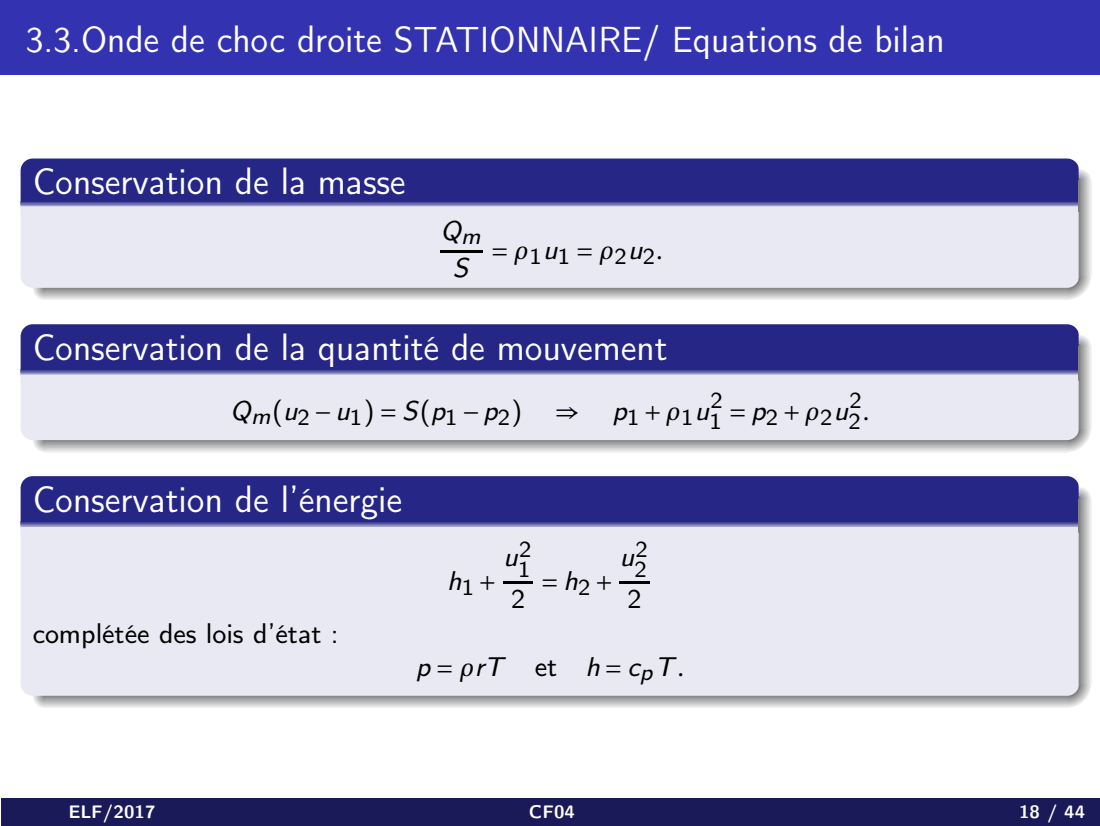
[picture p385: page 18]

3.3.Onde de choc droite STATIONNAIRE/ Equations de bilan

Conservation de la masse

Conservation de la quantité de mouvement

Conservation de l’énergie

complétée des lois d’état :

p = ρrT et h = cpT.

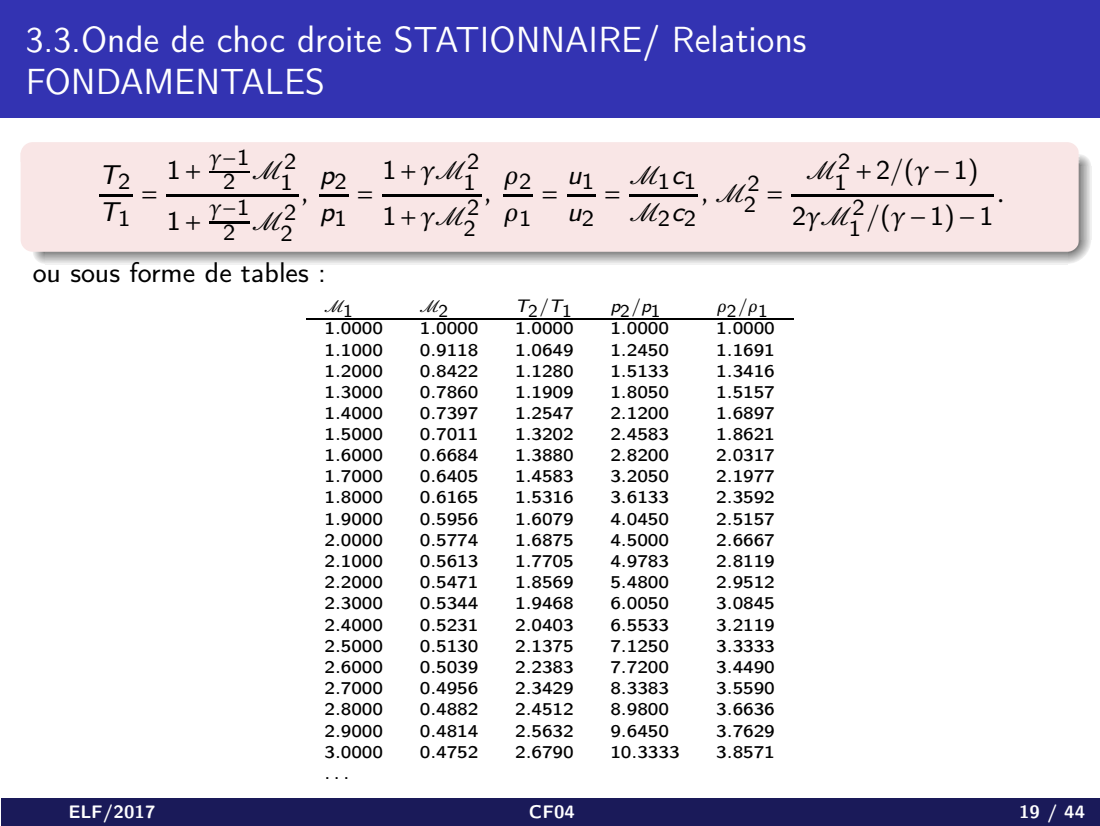
[picture p386: page 19]

3.3.Onde de choc droite STATIONNAIRE/ Relations
FONDAMENTALES

ou sous forme de tables :

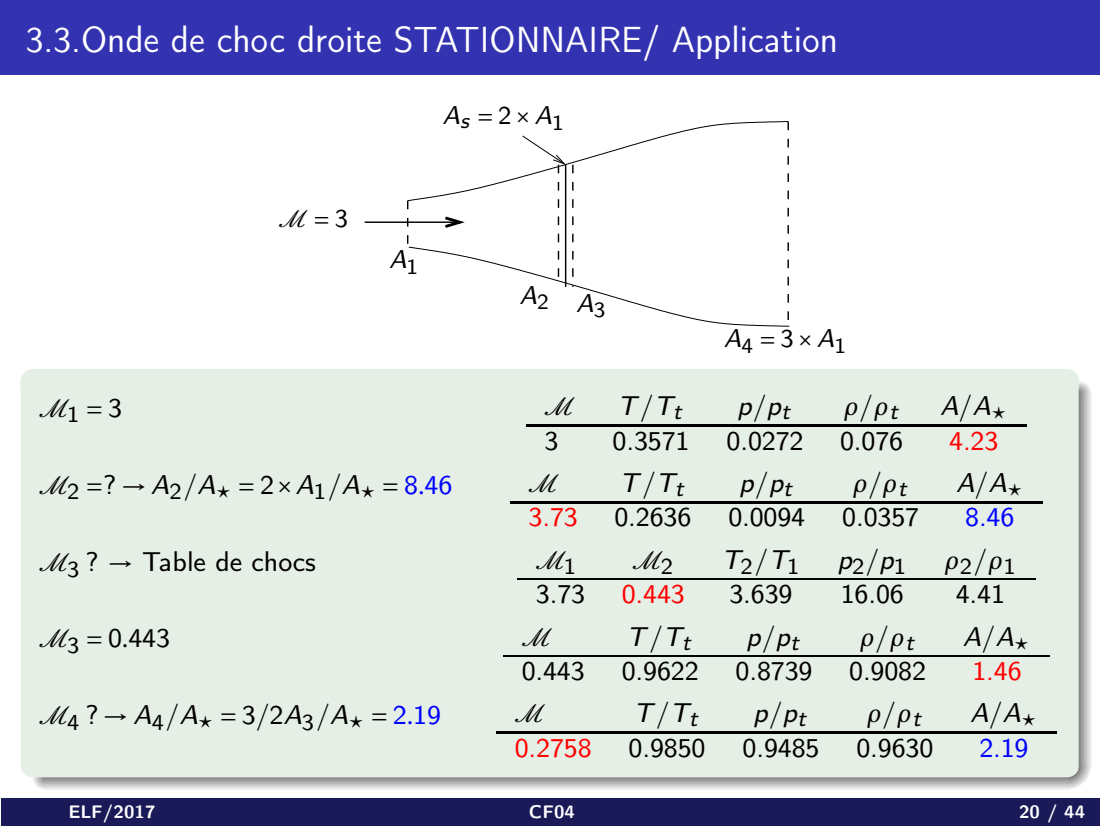
[picture p387: page 20]
M3 ? → Table de chocs

3.3.Onde de choc droite STATIONNAIRE/ Application

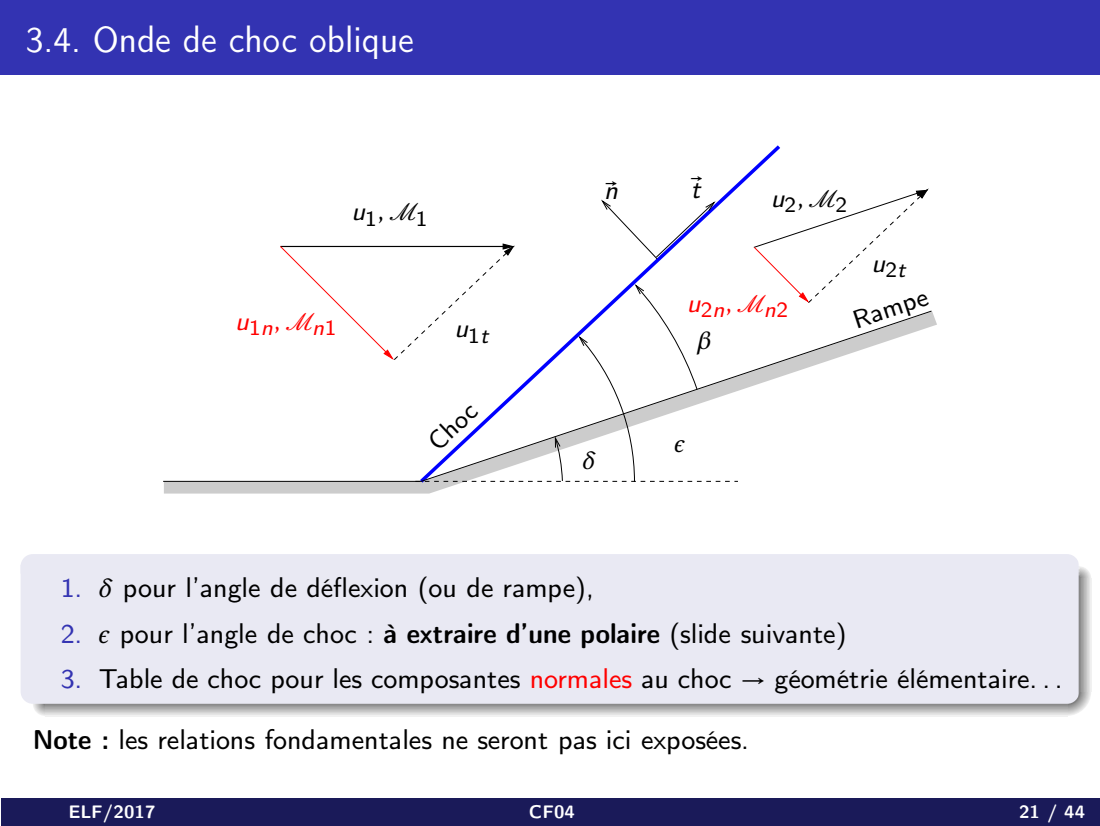
[picture p388: page 21]
Choc; Rampe

3.4. Onde de choc oblique

1. δ pour l’angle de déflexion (ou de rampe),
2. ǫ pour l’angle de choc : à extraire d’une polaire (slide suivante)
3. Table de choc pour les composantes normales au choc → géométrie élémentaire. . .

Note : les relations fondamentales ne seront pas ici exposées.

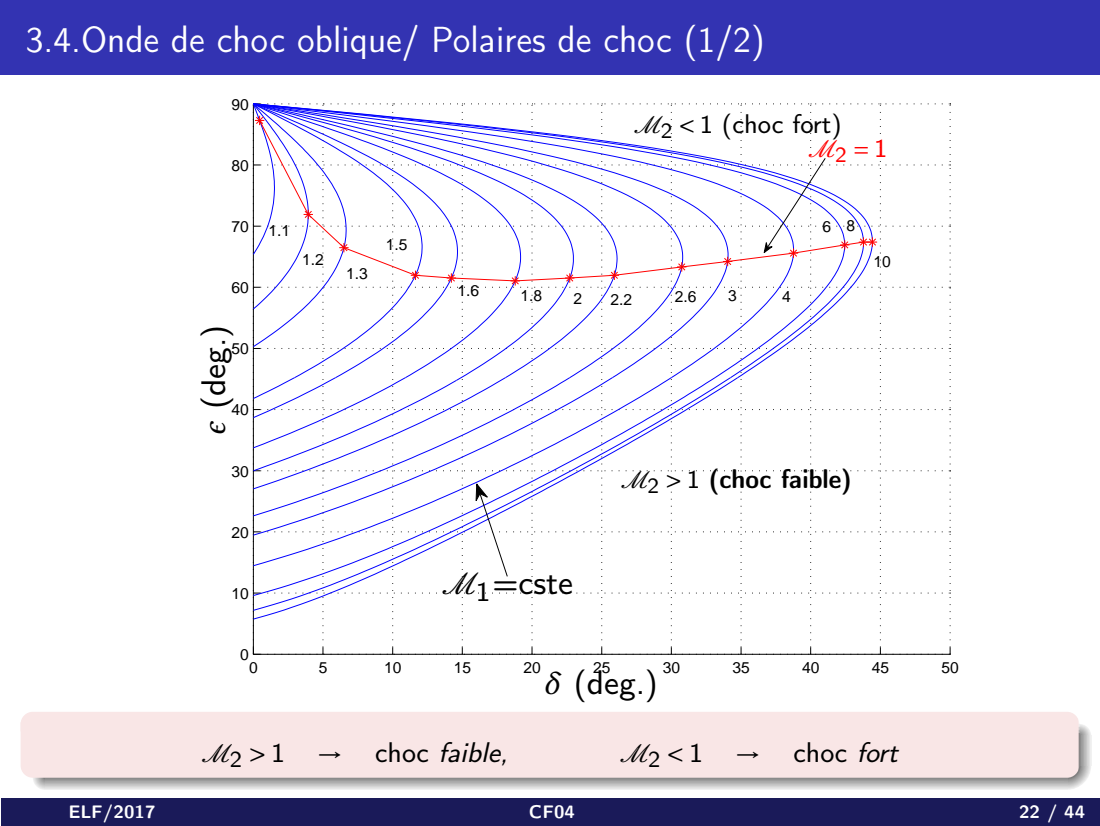
[picture p389: page 22]
ǫ (deg.); δ (deg.); choc faible,; choc fort

3.4.Onde de choc oblique/ Polaires de choc (1/2)

M2 < 1 (choc fort) | M2 = 1

1.1 | | 6 8
1.2 | 1.5 1.3 | | | | | | 10

M2 > 1 (choc faible)

M1=cste

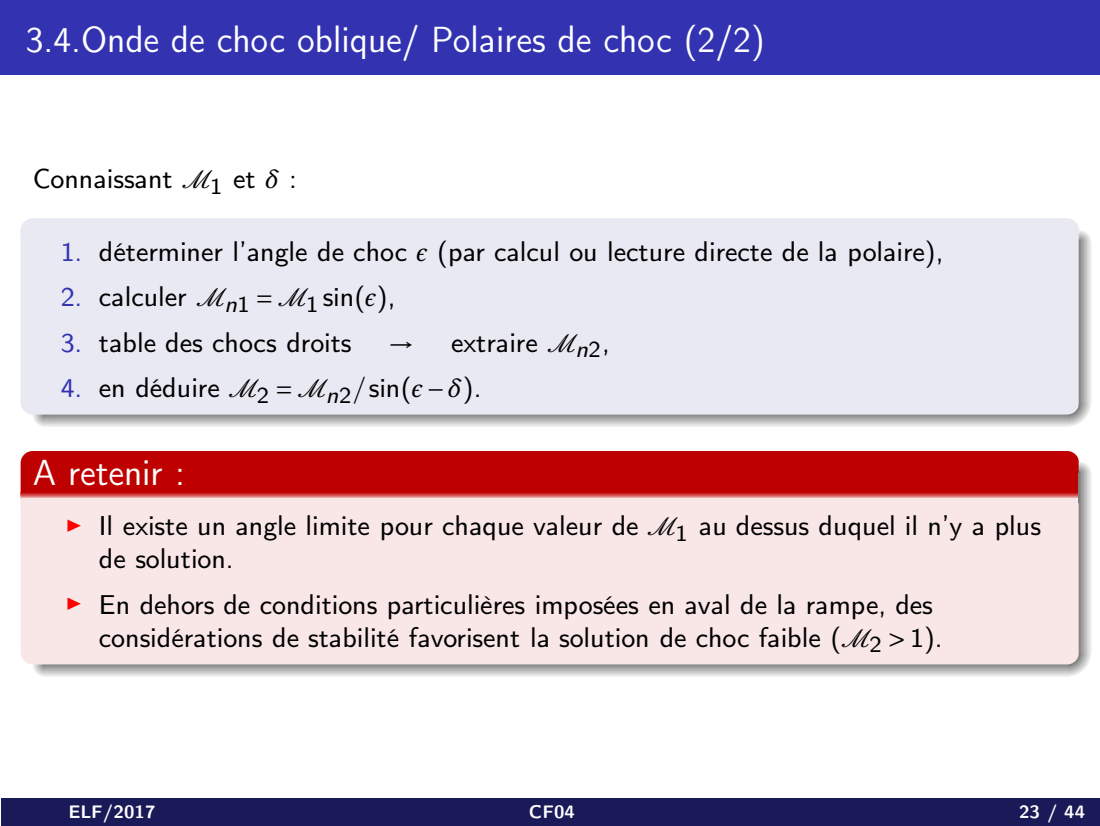
[picture p390: page 23]
Connaissant M1 et δ :; 3. table des chocs droits; extraire Mn2,

3.4.Onde de choc oblique/ Polaires de choc (2/2)

1. déterminer l’angle de choc ǫ (par calcul ou lecture directe de la polaire),
2. calculer Mn1 = M1 sin(ǫ),
4. en déduire M2 = Mn2/sin(ǫ−δ).

A retenir :
Ï Il existe un angle limite pour chaque valeur de M1 au dessus duquel il n’y a plus
de solution.
Ï En dehors de conditions particulières imposées en aval de la rampe, des
considérations de stabilité favorisent la solution de choc faible (M2 > 1).

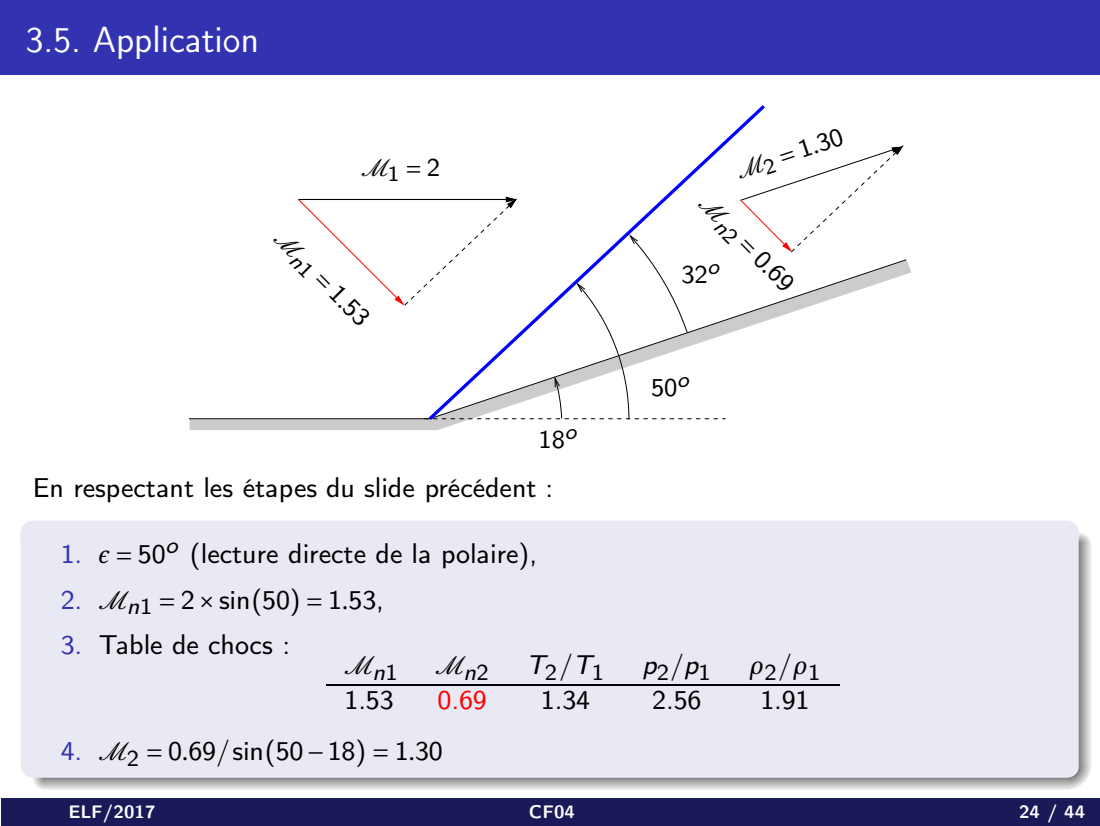
[picture p391: page 24]
3.5. Application; 2. Mn1 = 2×sin(50) = 1.53, 3. Table de chocs :; 4. M2 = 0.69/sin(50−18) = 1.30

En respectant les étapes du slide précédent :

(lecture directe de la polaire),

### 3.6. Faisceaux de détente : origine et descriptif du phénomène

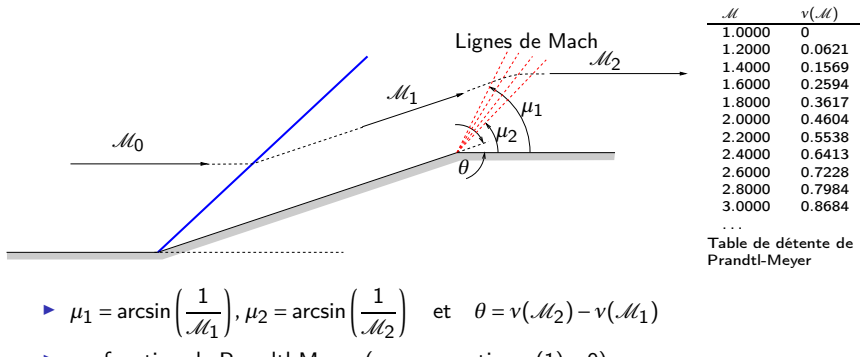
[picture p392: figure]
Lignes de Mach; M ν(M) 1.0000 0 1.2000 0.0621 1.4000 0.1569 1.6000 0.2594 1.8000 0.3617 2.0000 0.4604 2.2000 0.5538 2.4000 0.6413 2.6000 0.7228 2.8000 0.7984 3.0000 0.8684 . . . Table de détente de Prandtl-Meyer; Ï µ1 = arcsinµ; , µ2 = arcsinµ

Ï ν : fonction de Prandtl-Meyer (par convention ν(1) = 0)

ν(M) =

s
γ+1
γ−1

arctanÃs
γ+1
γ−1

(M2 −1)!
−arctan(p
M2 −1)

Ï MISE EN PRATIQUE : calculer ν(M1) puis on en déduit ν(M2) connaissant θ.

## Section. 4

## Application pragmatique au dimensionnement des entrées d’air

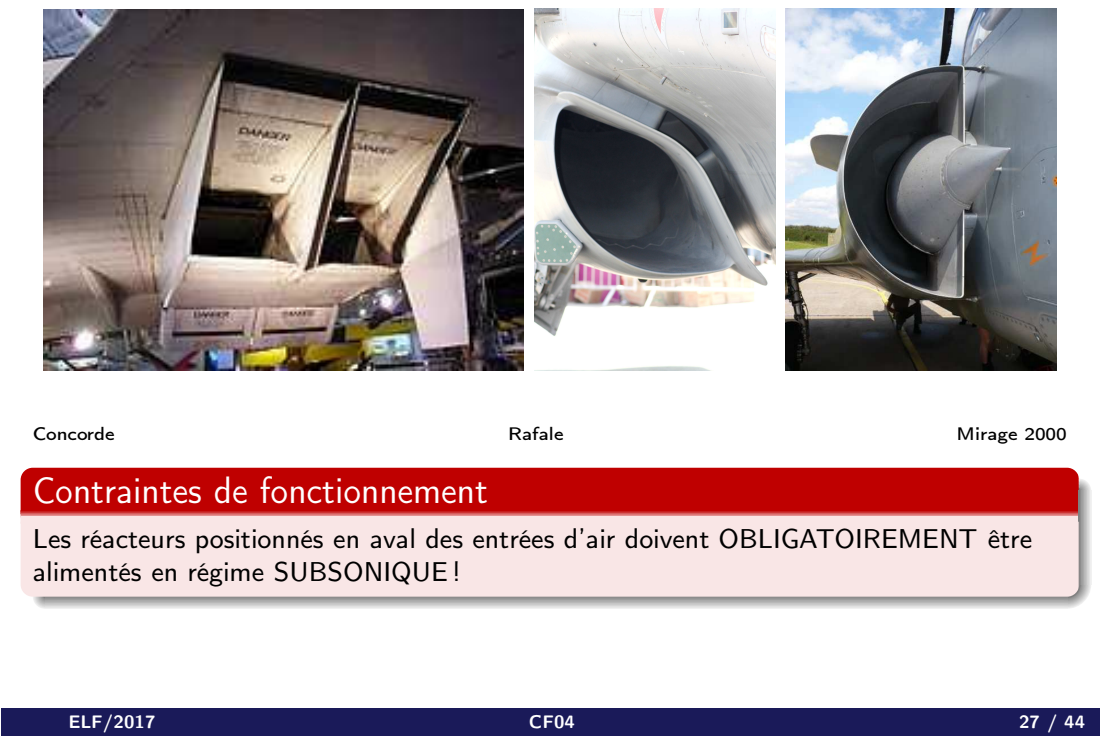
[picture p393: page 27]
Concorde; Rafale; Mirage 2000

Contraintes de fonctionnement
Les réacteurs positionnés en aval des entrées d’air doivent OBLIGATOIREMENT être
alimentés en régime SUBSONIQUE !

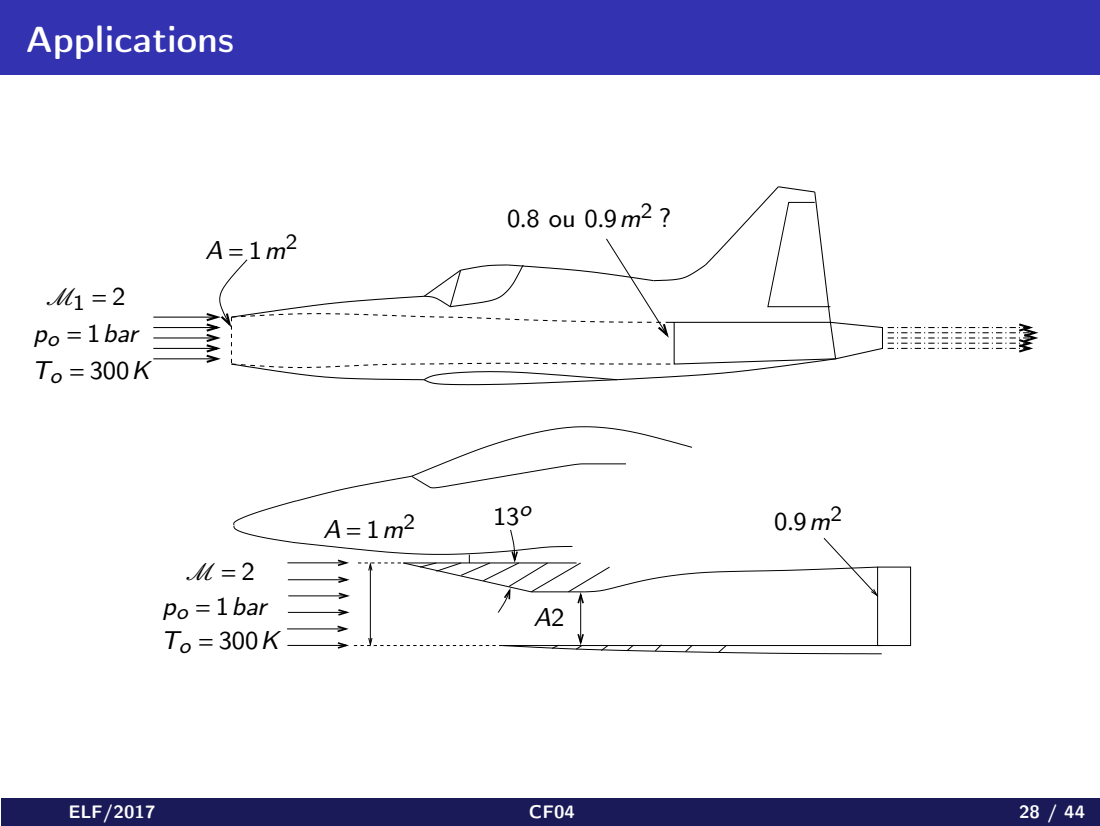
[picture p394: page 28]
Applications; po = 1bar To = 300K; M = 2 po = 1bar To = 300K

## Section. 5

## Techniques numériques de capture de chocs

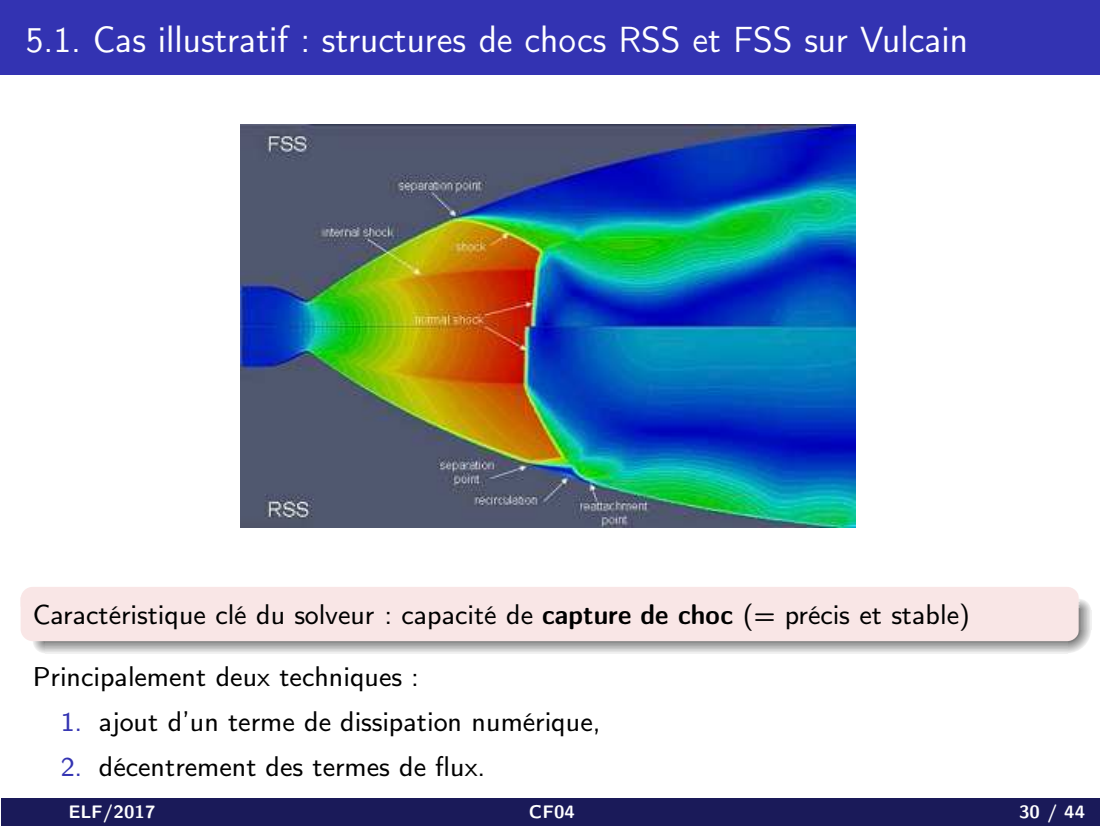
[picture p395: page 30]

5.1. Cas illustratif : structures de chocs RSS et FSS sur Vulcain

Caractéristique clé du solveur : capacité de capture de choc (= précis et stable)

Principalement deux techniques :
1. ajout d’un terme de dissipation numérique,
2. décentrement des termes de flux.

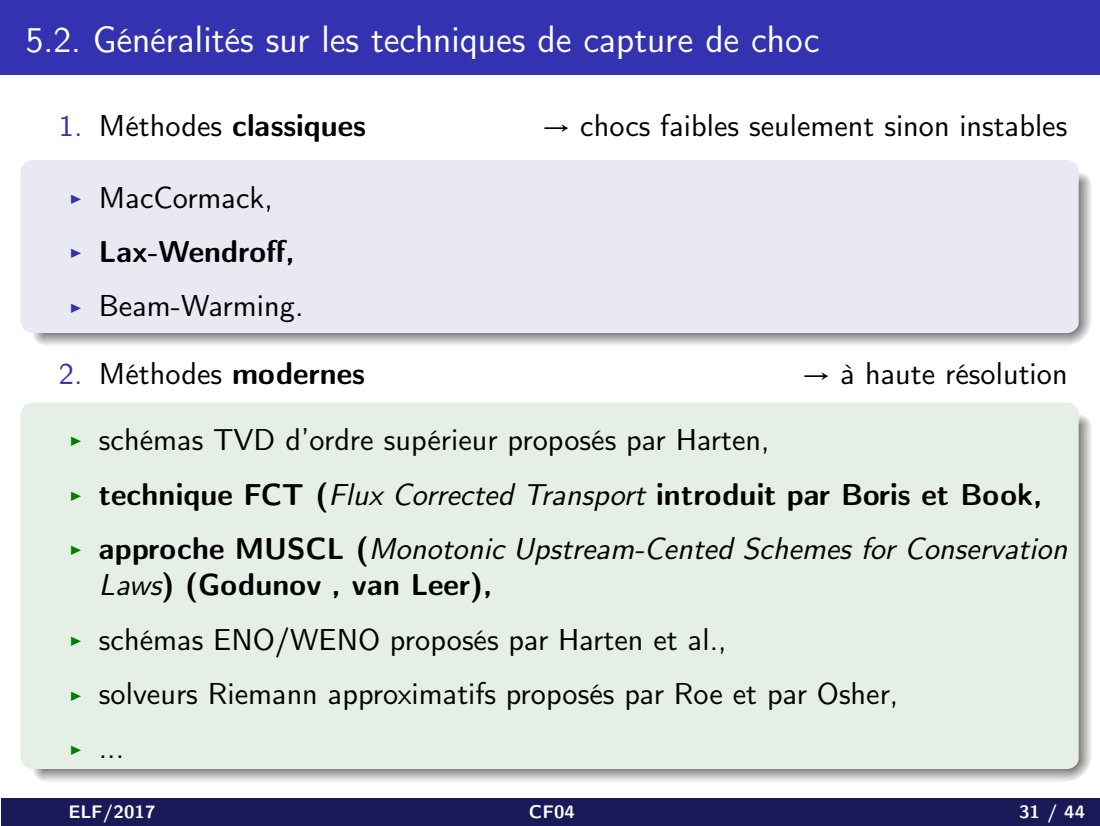
[picture p396: page 31]
1. Méthodes classiques; → chocs faibles seulement sinon instables; Ï MacCormack,; Ï Lax-Wendroff,; Ï Beam-Warming.; 2. Méthodes modernes; → à haute résolution

5.2. Généralités sur les techniques de capture de choc

Ï schémas TVD d’ordre supérieur proposés par Harten,
Ï technique FCT (Flux Corrected Transport introduit par Boris et Book,
Ï approche MUSCL (Monotonic Upstream-Cented Schemes for Conservation
Laws) (Godunov , van Leer),
Ï schémas ENO/WENO proposés par Harten et al.,
Ï solveurs Riemann approximatifs proposés par Roe et par Osher,

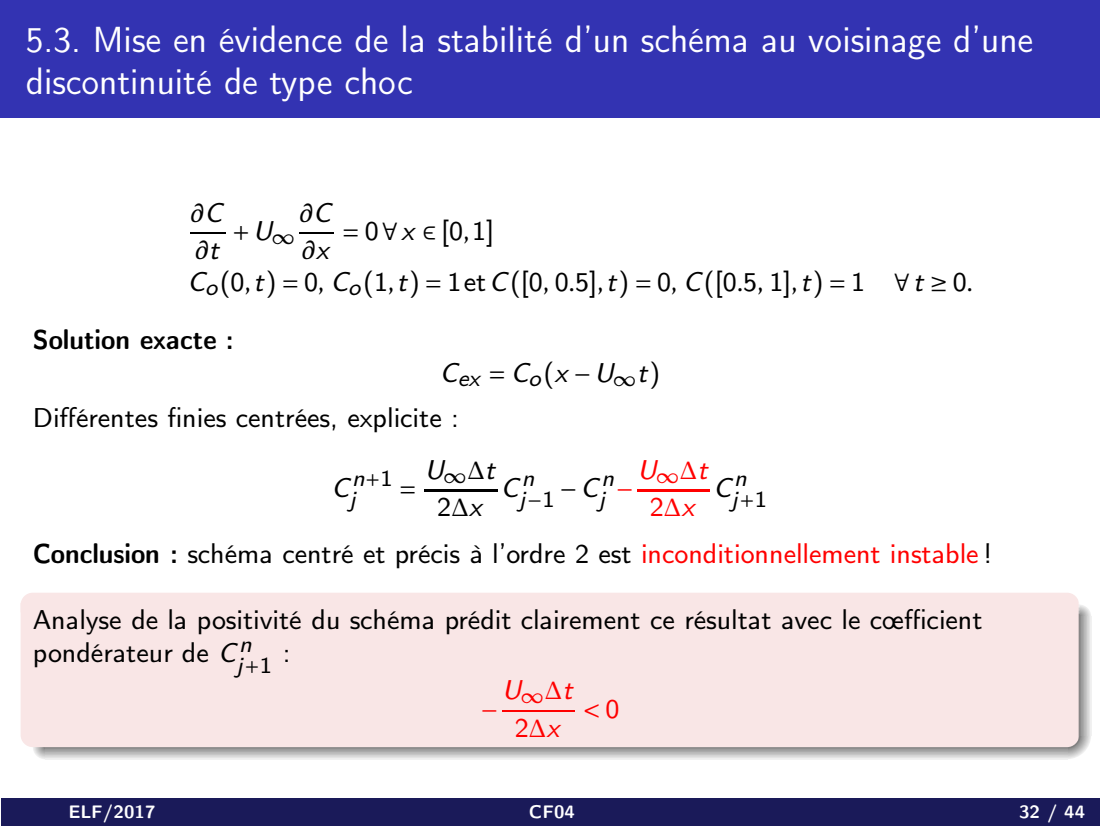
[picture p397: page 32]
Co(0,t) = 0, Co(1,t) = 1etC([0, 0.5],t) = 0, C([0.5, 1],t) = 1 ∀t ≥ 0.; Solution exacte :; Cex = Co(x −U∞t)

5.3. Mise en évidence de la stabilité d’un schéma au voisinage d’une
discontinuité de type choc

Différentes finies centrées, explicite :

Conclusion : schéma centré et précis à l’ordre 2 est inconditionnellement instable !

Analyse de la positivité du schéma prédit clairement ce résultat avec le cœfficient
pondérateur de C

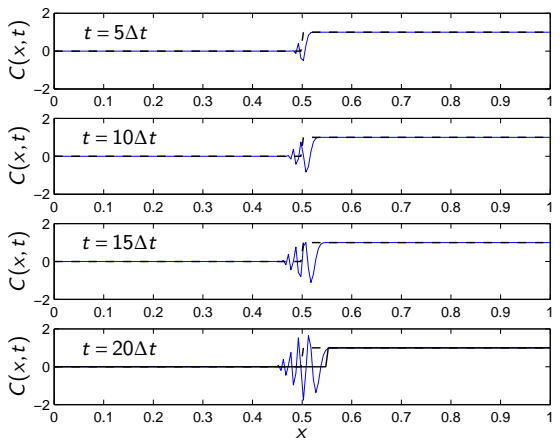
[picture p398: figure]

Propagation d’un front raide à l’aide d’un schéma centré en espace et précis à l’ordre 2 (U∞ = 0.5m/s, 200 nœuds, ∆t = 510⁻³
s)

### 5.4. . . . correction par ajoût d’un terme dissipatif

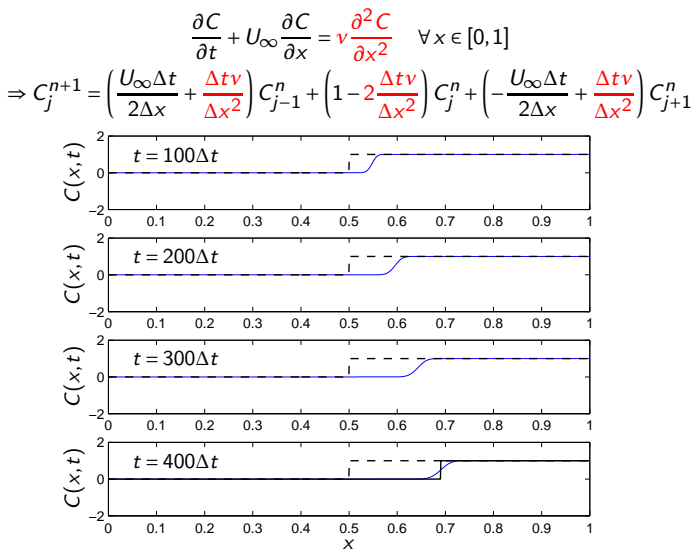
[picture p399: figure]
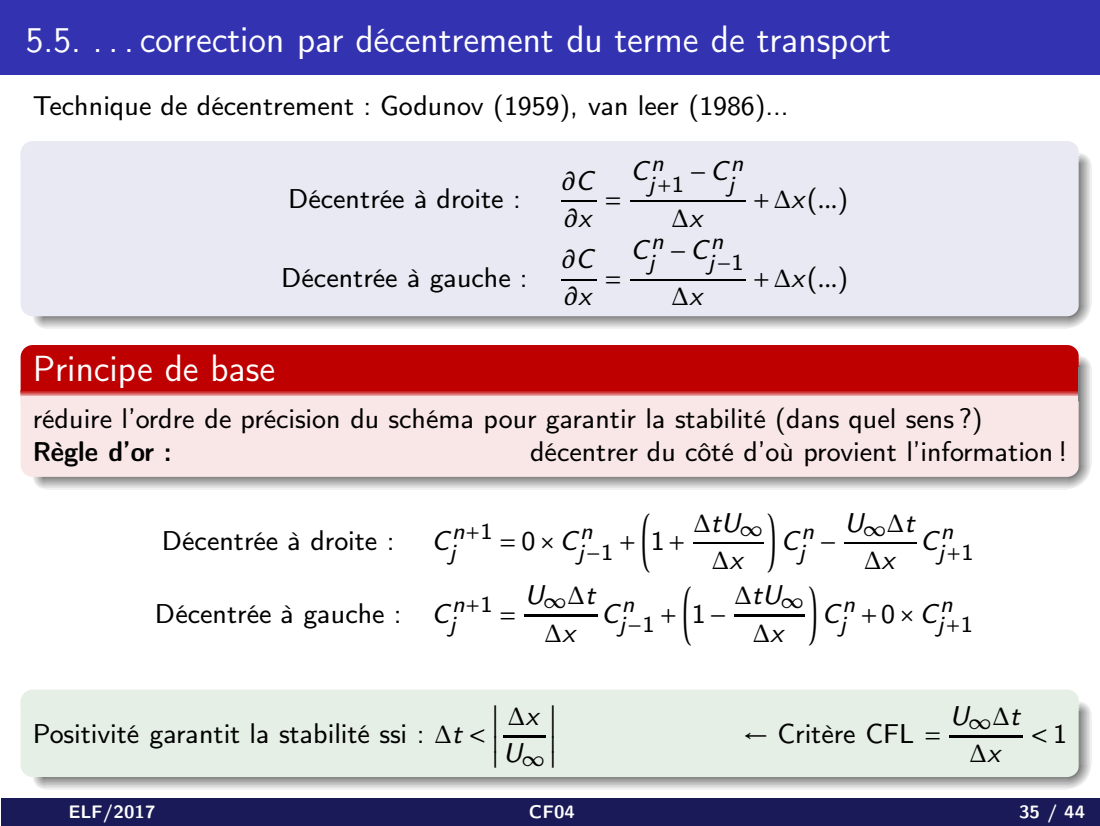
[picture p400: page 35]
Décentrée à droite :; Décentrée à gauche : ∂C; Règle d’or :; décentrer du côté d’où provient l’information !; Décentrée à gauche : C; ← Critère CFL =

5.5. . . . correction par décentrement du terme de transport

Technique de décentrement : Godunov (1959), van leer (1986)...

Principe de base
réduire l’ordre de précision du schéma pour garantir la stabilité (dans quel sens ?)

Positivité garantit la stabilité ssi : ∆t <

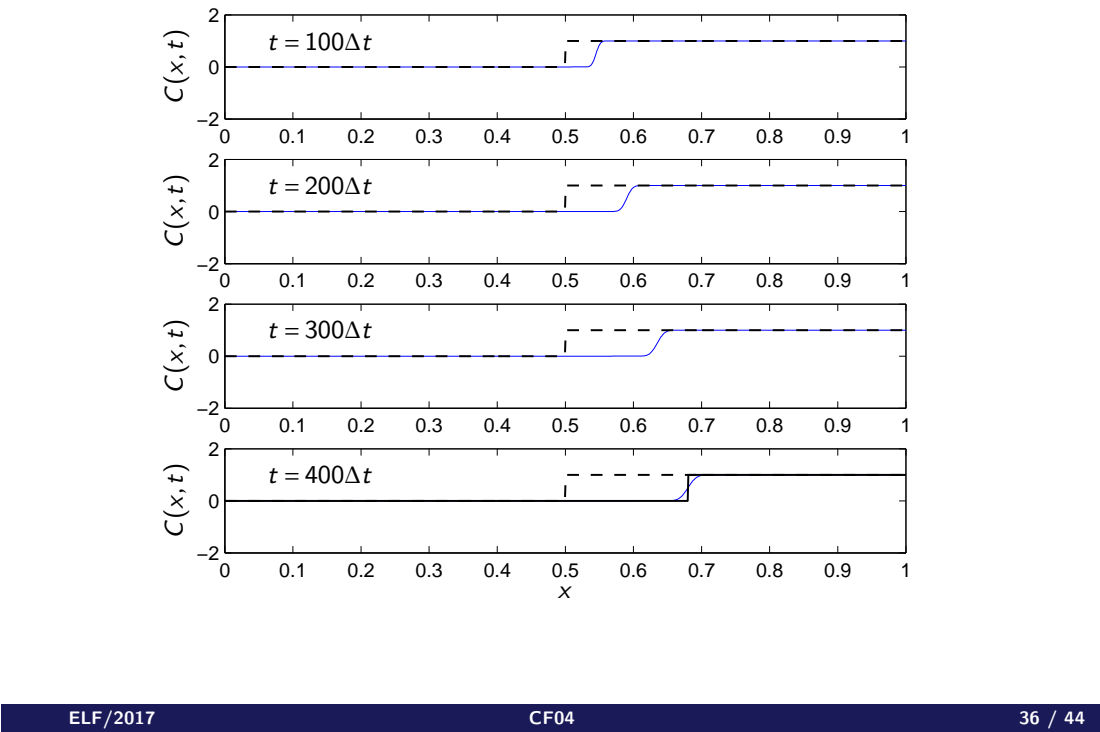
[picture p401: page 36]

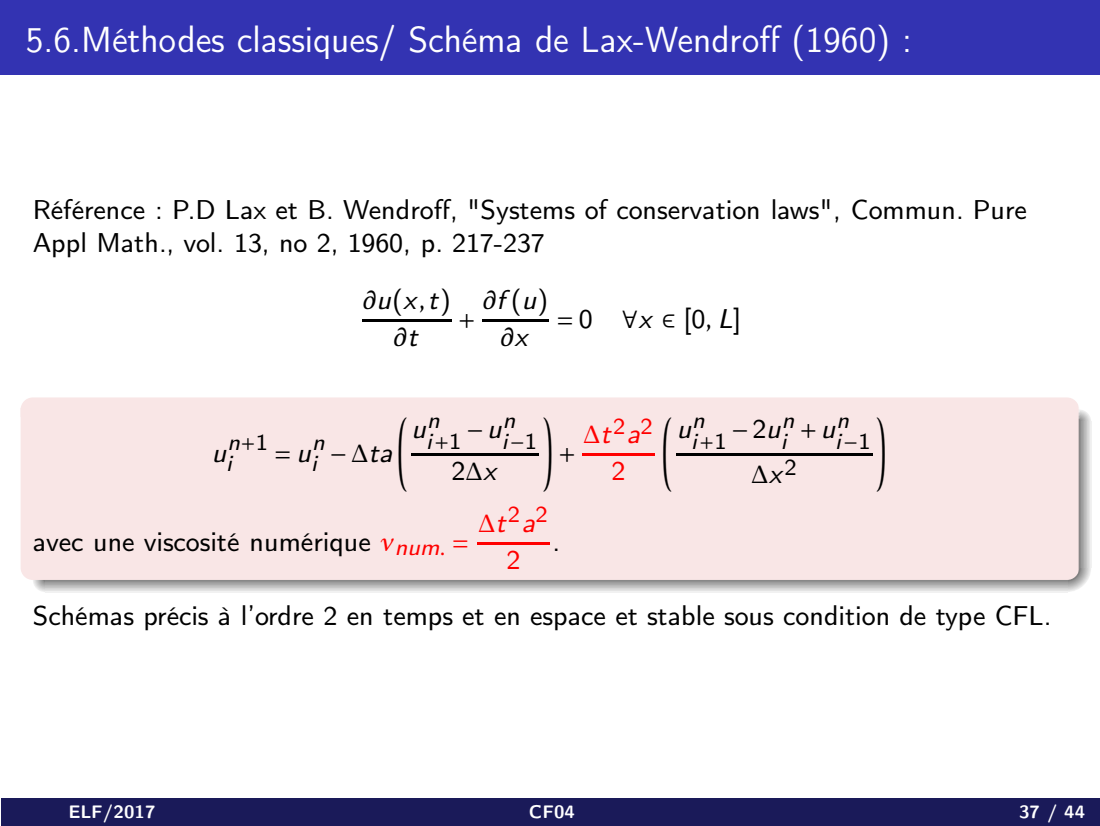
[picture p402: page 37]
−∆taÃ

5.6.Méthodes classiques/ Schéma de Lax-Wendroff (1960) :

Référence : P.D Lax et B. Wendroff, "Systems of conservation laws", Commun. Pure
Appl Math., vol. 13, no 2, 1960, p. 217-237

avec une viscosité numérique νnum. =

Schémas précis à l’ordre 2 en temps et en espace et stable sous condition de type CFL.

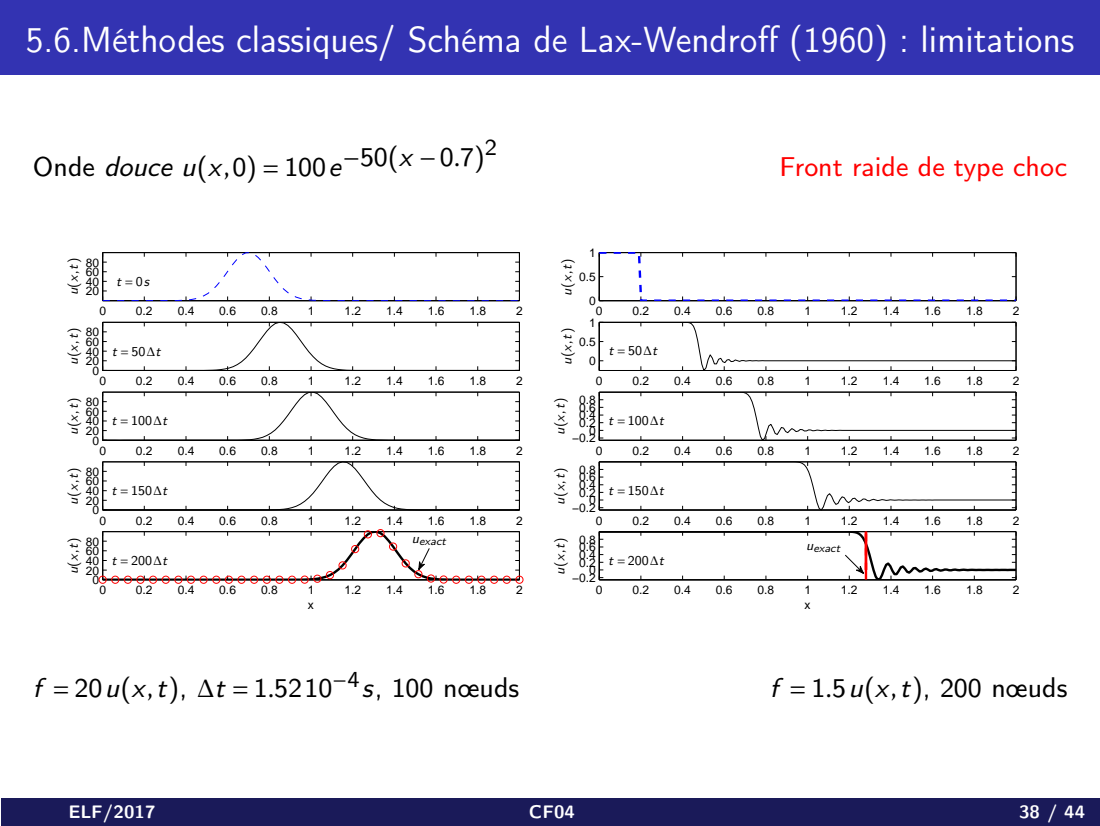
[picture p403: page 38]
Onde douce u(x,0) = 100e; uexact; s, 100 nœuds; f = 1.5u(x,t), 200 nœuds

5.6.Méthodes classiques/ Schéma de Lax-Wendroff (1960) : limitations

Front raide de type choc

### 5.7.Méthodes avancées/ Flux Corrected Transport

Trois étapes successives :

### 1. calcul pour chaque pas de temps :

### 1.1 d’une solution d’ordre dégradé (low order) : ul(x, t) 1.2 d’une solution d’ordre élevé (high order) : uh(x, t) 2. calcul d’un indicateur 0 ≤ α ≤ 1 (appelé limiteur de flux) = 0 dans les zones de

discontinuité, 1 dans les zones "calmes".

### 3. construction de la solution retenue :

u(x, t) = ul +α(uh −ul

).

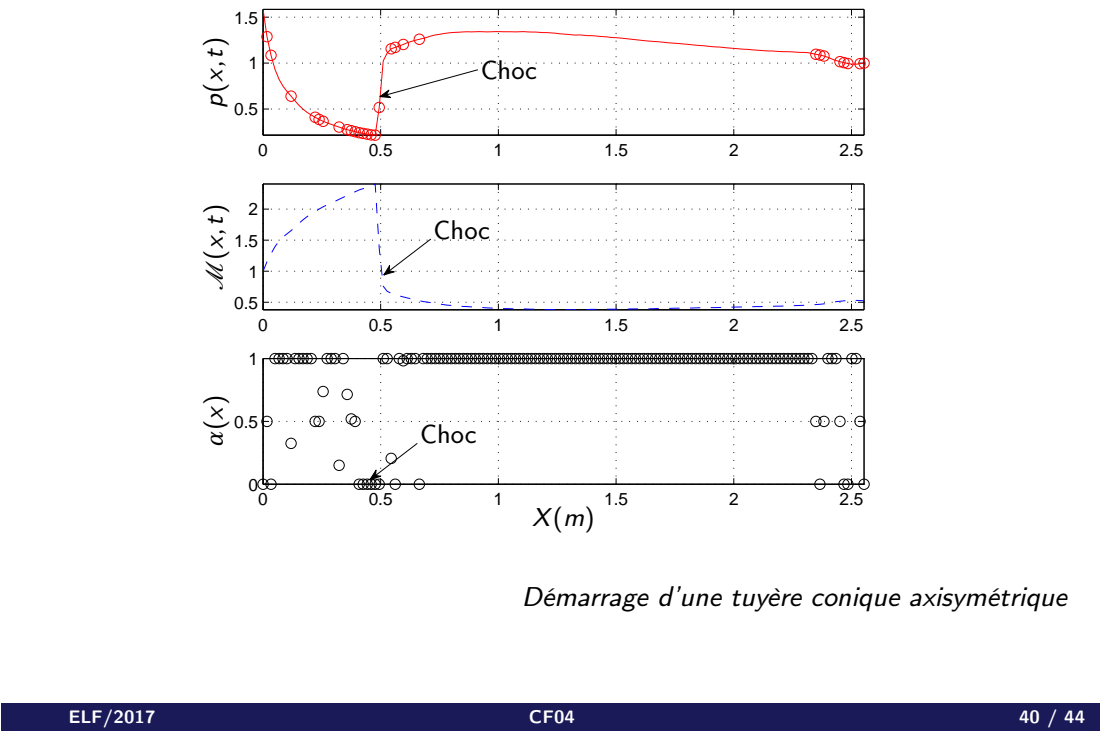
[picture p404: page 40]
Choc

Démarrage d’une tuyère conique axisymétrique

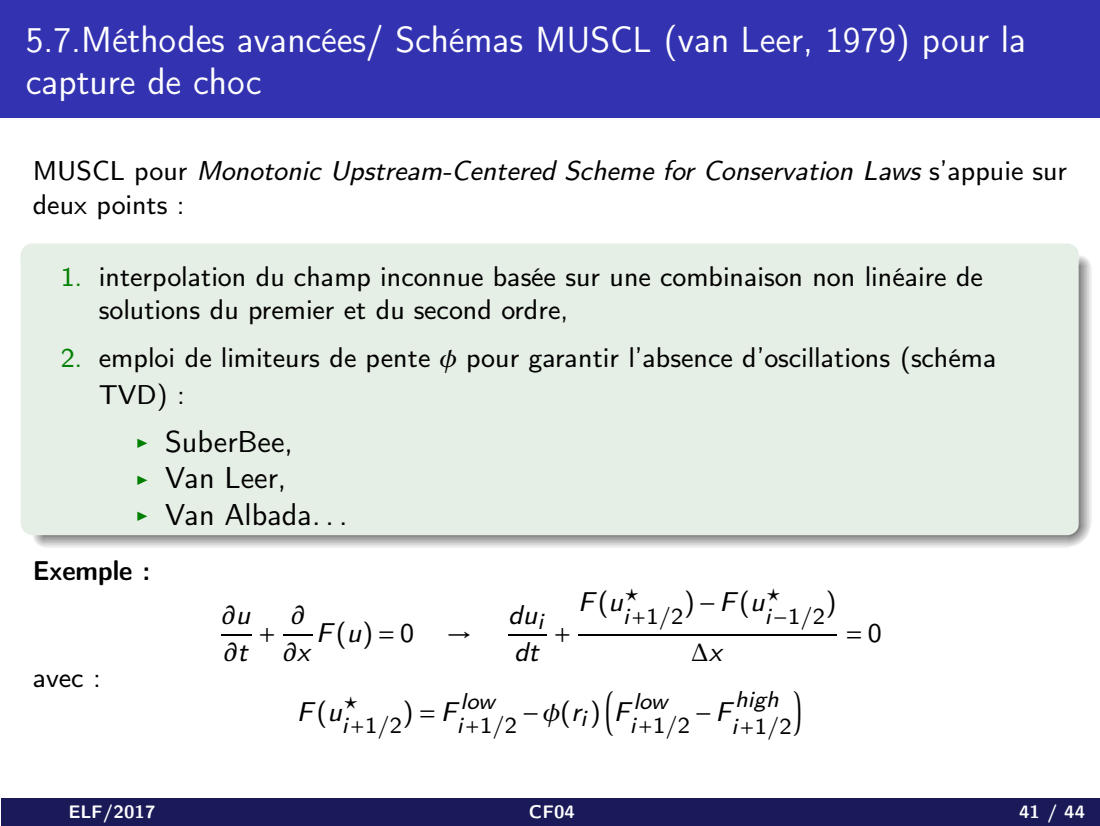
[picture p405: page 41]
Exemple :; dui dt; avec :; low i+1/2 −φ(ri; low i+1/2 −F; high i+1/2´

5.7.Méthodes avancées/ Schémas MUSCL (van Leer, 1979) pour la
capture de choc

MUSCL pour Monotonic Upstream-Centered Scheme for Conservation Laws s’appuie sur
deux points :

1. interpolation du champ inconnue basée sur une combinaison non linéaire de
solutions du premier et du second ordre,
2. emploi de limiteurs de pente φ pour garantir l’absence d’oscillations (schéma
TVD) :
Ï SuberBee,
Ï Van Leer,
Ï Van Albada. . .

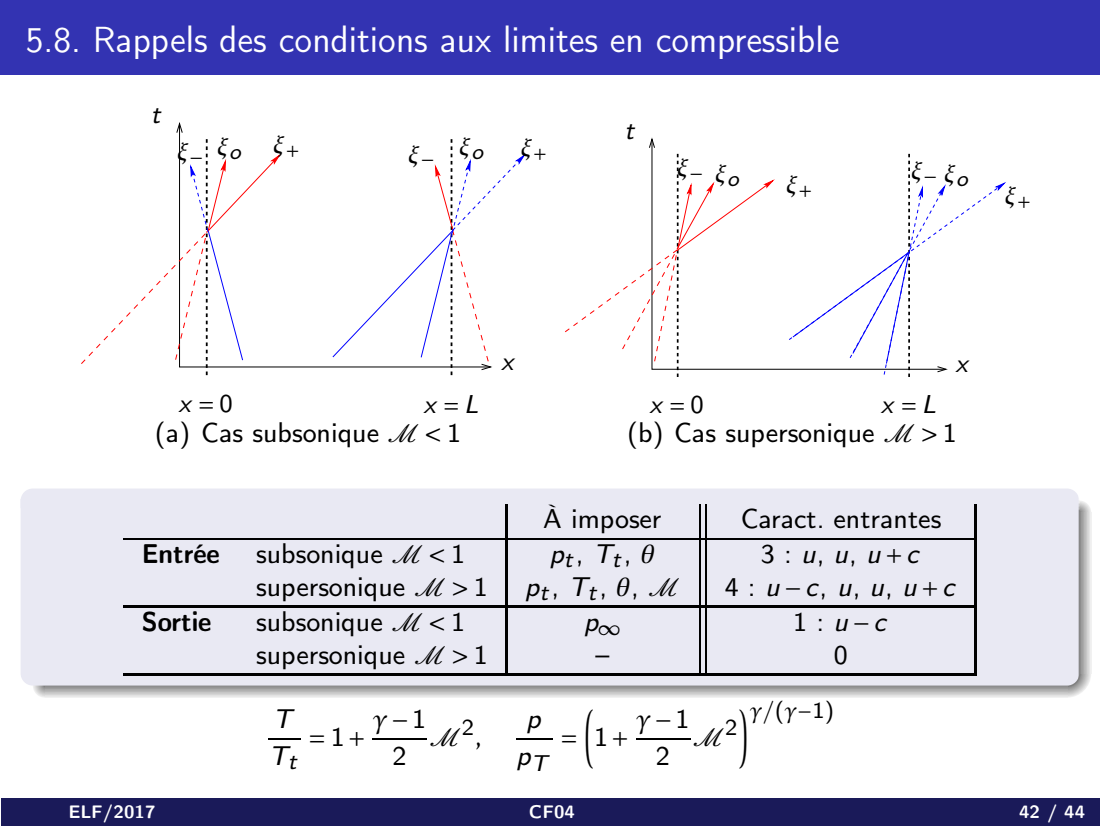
[picture p406: page 42]
(a) Cas subsonique M < 1; (b) Cas supersonique M > 1; À imposer; Caract. entrantes; Entrée; subsonique M < 1; supersonique M > 1; Sortie

5.8. Rappels des conditions aux limites en compressible

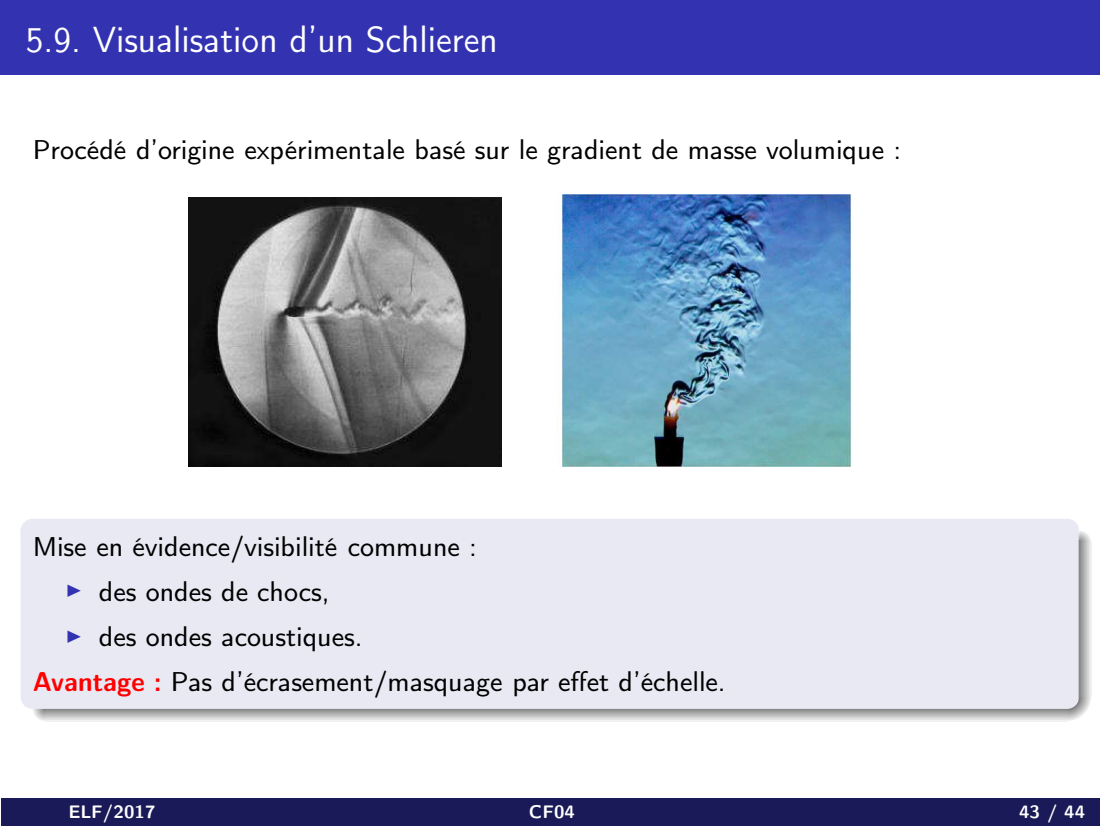
[picture p407: page 43]

5.9. Visualisation d’un Schlieren

Procédé d’origine expérimentale basé sur le gradient de masse volumique :

Mise en évidence/visibilité commune :
Ï des ondes de chocs,
Ï des ondes acoustiques.
Avantage : Pas d’écrasement/masquage par effet d’échelle.

¶

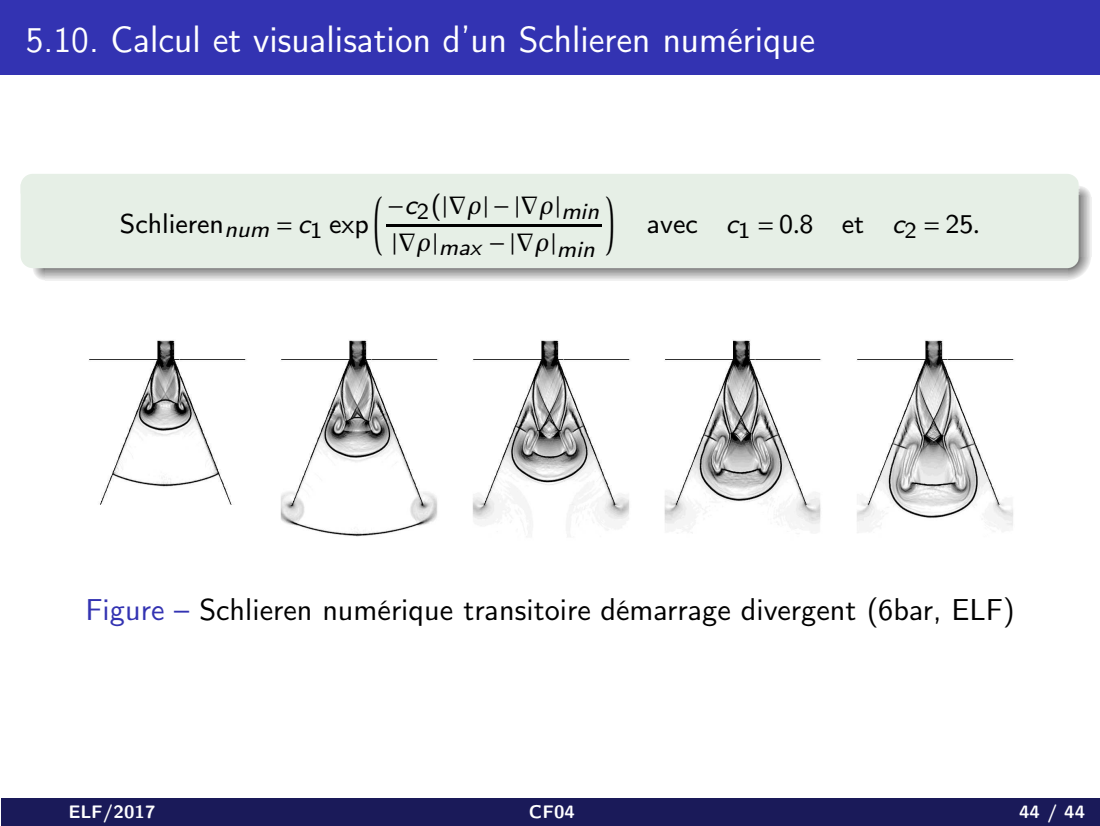
[picture p408: page 44]
Schlierennum = c1 expµ; −c2(|∇ρ| −|∇ρ|min; |∇ρ|max −|∇ρ|min; avec c1 = 0.8 et c2 = 25.

5.10. Calcul et visualisation d’un Schlieren numérique

Figure – Schlieren numérique transitoire démarrage divergent (6bar, ELF)
