EOSCogniton/Intergen/(commit log)

2018-03-11 Mise en forme et premiers docs
    [Couple à la roue.xlsx]
2018-03-16 modele du mt07 (mesuré par moi chez yamaha)
    [gabarit_moteur.CATPart, gabarit_moteur.SLDPRT, gabarit_moteur.STEP]
2018-03-21 Partage du "Rapport changement de moteur" et modification "Proposition techniques"
2018-05-30 MIC-3D Optimus
    [Admission.CATPart, Bras sus.CATPart, Chassis 2.CATPart, Chassis.CATPart, Circuit d'essence.CATPart, Fond-plat.CATPart, Jante + pneu.CATPart, LAS.CATPart]
2018-05-30 Correction erreur de GIT
    [Admission.CATPart, Bras sus.CATPart, Chassis 2.CATPart, Chassis.CATPart, Circuit d'essence.CATPart, Fond-plat.CATPart, Jante + pneu.CATPart, LAS.CATPart]
2018-09-13 Push Gantt Directeur de Projet
    [Gantt-pôle-Chassis-Optimus - En_Cours.xls, Gantt-pôle-Direction de Projet-Optimus - En_Cours.xls, Gantt-pôle-LAS-Optimus.xls]
2018-09-13 Modif Gantt Chassis
    [Gantt-pôle-Chassis-Optimus - En_Cours.xls]
2018-09-13 Mise en forme + rajoute Autres
    [Gantt-pôle-Direction de Projet-Optimus - En_Cours.xls]
2018-09-13 Rajouts gantt direction projet
    [Gantt-pôle-Direction de Projet-Optimus - En_Cours.xls]
2018-09-13 Modif gant partie châssis
    [Gantt-pôle-Chassis-Optimus - En_Cours.xls]
2018-09-13 Rajout section partenaires - gantt projet
    [Gantt-pôle-Direction de Projet-Optimus - En_Cours.xls]
2018-09-16 Finalisation du Gantt LAS
    [Gantt-pôle-Direction de Projet-Optimus - En_Cours.xls, Gantt-pôle-LAS-Optimus.xls]
2018-09-16 Remise en forme Gantt LAS
    [Gantt-pôle-LAS-Optimus.xls]
2018-09-17 Finalisation du gantt chassis
    [Gantt-pôle-Direction de Projet-Optimus.xls, Gantt-pôle-Elec-Optimus - En_Cours.xls, Gantt-pôle-Motorisation-Optimus - En_Cours.xls]
2018-09-17 Début de rédaction du gantt Motorisation
    [Gantt-pôle-Chassis-Optimus - En_Cours.xls, Gantt-pôle-Motorisation-Optimus - En_Cours.xls]
2018-09-17 Gantt Motorisation
    [Gantt-pôle-Motorisation-Optimus - En_Cours.xls]
2018-09-17 Modif gantt châssis
    [Gantt-pôle-Chassis-Optimus - En_Cours.xls]
2018-09-19 Ajustement gantt chassis
    [Gantt-pôle-Chassis-Optimus - En_Cours.xls, Gantt-pôle-Direction de Projet-Optimus.xls, Gantt-pôle-Elec-Optimus - En_Cours.xls, Gantt-pôle-Motorisation-Optimus - En_Cours.xls]
2018-09-20 debut maj gant (je finis ce we)
    [Gantt-pôle-Elec-Optimus - En_Cours.xls]
2018-09-20 suite maj gantt (mais pas fin)
    [Gantt-pôle-Elec-Optimus - En_Cours.xls]
2018-09-21 je sais pas
    [Gantt-pôle-Elec-Optimus - En_Cours.xls]
2018-09-22 Excel Organisation séance
    [Organisation_Séances.xls]
2018-09-23 Fin du Gant elec
    [Gantt-pôle-Elec-Optimus - En_Cours.xls, Organisation_Séances.xls]
2018-09-23 lisibilité
    [Gantt-pôle-Elec-Optimus - En_Cours.xls]
2018-09-24 Maj gantt motorisation
    [Gantt-pôle-Motorisation-Optimus - En_Cours.xls]
2018-09-25 MAJ du GANTT Motorisation
    [Gantt-pôle-Motorisation-Optimus - En_Cours.xls]
2018-09-25 MAJ Gantt
    [Gantt-pôle-Chassis-Optimus.xls, Gantt-pôle-LAS-Optimus.xls, Gantt-pôle-Motorisation-Optimus - En_Cours.xls, Organisation_Séances.xls]
2018-09-26 Mise en forme Gantt et suivi
    [Gantt-pôle-Chassis-Optimus.xls, Gantt-pôle-Direction de Projet-Optimus.xls, Gantt-pôle-LAS-Optimus.xls]
2018-10-02 Guide serrage / Règles de conception
2018-10-02 Organisation documents gestion de projet
    [Gantt-pôle-Chassis-Optimus.xls, Gantt-pôle-Direction de Projet-Optimus.xls, Gantt-pôle-Elec-Optimus - En_Cours.xls, Gantt-pôle-LAS-Optimus.xls, Gantt-pôle-Motorisation-Optimus - En_Cours.xls, Gantt_Lancement_production.xls]
2018-10-02 Revert "Organisation documents gestion de projet"
    This reverts commit 0c1cf025fa816a0a0fe16bb1ecea74430a7bcfde.
    [Gantt-pôle-Chassis-Optimus.xls, Gantt-pôle-Direction de Projet-Optimus.xls, Gantt-pôle-Elec-Optimus - En_Cours.xls, Gantt-pôle-LAS-Optimus.xls, Gantt-pôle-Motorisation-Optimus - En_Cours.xls, Gantt_Lancement_production.xls]
2018-10-03 Modif Gantt
    [Gantt-pôle-LAS-Optimus.xls]
2018-10-06 Suivi Gantt
    [Gantt-pôle-Chassis-Optimus.xls, Gantt-pôle-Elec-Optimus.xls, Gantt-pôle-LAS-Optimus.xls, Gantt-pôle-Motorisation-Optimus - En_Cours.xls, Gantt-pôle-Motorisation-Optimus.xls, Organisation_Séances.xls]
2018-10-07 gant elec
    [Gantt-pôle-Elec-Optimus.xls]
2018-10-25 Organisation Séance MaJ
    [Organisation_Séances.xls]
2018-10-25 Maj Gantt elec
    [Gantt-pôle-Elec-Optimus.xls]
2018-10-25 Inventaire Bron début
    [Inventaire_Bron.xlsx]
2018-10-25 Inventaire + Kit montage modif
    [Inventaire_Bron.xlsx, nomenclature_kit_de_montage.xlsx]
2018-10-26 Maj LAS
    [Gantt-pôle-LAS-Optimus.xls]
2018-10-29 MAJ gantt et réorganisation avec ajout doc CNN FEM CATIA
    [Gantt-Fabrication.xls, Gantt-Présidentiel.xls, Gantt-pôle-Chassis-Optimus.xls, Gantt-pôle-Direction de Projet-Optimus.xls, Gantt-pôle-Elec-Optimus.xls, Gantt-pôle-LAS-Optimus.xls, Gantt-pôle-Motorisation-Optimus.xls, Inventaire_Bron.xlsm]
2018-11-05 gantt elec
    [Gantt-pôle-Elec-Optimus.xls]
2018-11-08 Ordre du jour TOP Copeau
    [Ordre_Jour_TOPs.xlsx]
2018-11-09 MAJ ODJ
    [Ordre_Jour_TOPs.xlsx]
2018-11-15 MAJ et ajouts
    [FABRICATION.xlsx, Gantt-Fabrication.xls, Gantt-pôle-Chassis-Optimus.xls, Gantt-pôle-Direction de Projet-Optimus.xls, Masse_Prévisionnelle_Optimus.xlsx, Ordre_Jour_TOPs.xlsx, Organisation_Séances.xls]
2018-11-22 MAJ Gantt et Ajout au Git
    [Gantt-Département-Chassis-Optimus-v1.5.xls, Gantt-Département-LAS-Optimus-v1.5.xls, Gantt-Département-Motorisation-Optimus-v1.5.xls, Gantt-Fabrication.xls, Gantt-pôle-Chassis-Optimus.xls, Ordre_Jour_TOPs.xlsx, Organisation_Séances.xls, Préparation-Compet.xls]
2018-11-26 Ajouts fichiers
    [Masse_Prévisionnelle_Optimus.xlsx, Organisation_Séances.xls]
2018-11-27 MAJ Gantt Fab
    [Gantt-Fabrication.xls, Ordre_Jour_TOPs.xlsx]
2018-11-27 MAJ Gantt Fabrication
    [Gantt-Fabrication.xls]
2018-11-30 Formations CATIA
    [A.CATPart, AXE COULISSANT.CATPart, AXE_12x55.CATPart, AXE_8x18.CATPart, AXE_8x24.CATPart, AXE_POIGNEE.CATPart, Arbre.CATPart, Arbre_bride.CATPart]
2018-12-02 MAJ et ajout de documents
    [Gantt-Fabrication.xls, Référentiel standard de production.xlsx]
2018-12-06 gantt elec phase remontante
    [FABRICATION.xlsx, Gantt-Département-Elec-remontant.xls]
2018-12-06 gant fab elec
    [Gantt-Département-Elec-remontant.xls]
2018-12-10 Ajout et MAJ
    [Gantt-Fabrication.xls, Référentiel standard de production.xlsx]
2018-12-11 fait gaffe nico ptn !
    [IO_GAV.xlsx]
2018-12-11 t'as fait de la merde avec ton merge
2018-12-11 Fuel model
    [Fuel_model.xlsx]
2018-12-11 pdf IO_GAV
    [IO_GAV.xlsx]
2018-12-13 Ajout Documentation Suspension and Powertrain
    [Fiche_Suivi.xlsx, Organisation_Séances.xls]
2018-12-18 tuto frame
2018-12-18 tuto chassis
2019-01-04 Ajout Calendrier EPSA
    [Calendrier_EPSA.xlsx]
2019-03-15 Maj diapo TOP véhicule
    [Planning Intégration.xlsx]
2019-03-20 Point Projet 0As
    [Planning Intégration.xlsx]
2019-05-16 Ajout modèle RPM passage de vitesse et maj du modèle de tdn avec les données d'Optimus
2019-05-29 maj inertie de rotaion Optimus
2019-08-03 Adding Lap_Time_Model Files
    [Comparaison_Model.xlsx]
2019-08-03 passage de vitesse et freinage
2019-08-05 Modif Script tracer track
2019-08-06 Correction erreur nommage variable et ajout ecriture sur excel comparaison
    [Comparaison_Model.xlsx]
2019-08-07 Ajout track FSATA et quelques modif pour aire fonctionner le tout
    [Comparaison_Model.xlsx]
2019-08-07 petite modif circuit, modif coeff aéro (sur rapport PAI Italien), Ajout Setup Accel pour optimus
    [Comparaison_Model.xlsx]
2019-08-08 Ajout setup 10 pouce ( a affiner)
    [Comparaison_Model.xlsx]
2019-08-08 Modif App v0.3 lancement des simulation avec button
    [Comparaison_Model.xlsx, Template_Caract_Vehicle.xlsx]
2019-08-09 Réalisation code importer excel et générer .mat des variables (quelques points à corriger encore)
    [Template_Caract_Vehicle.xlsx]
2019-08-14 Calcul des points à chaque épreuves et modification de l'appli
    [Comparaison_Model.xlsx, Template_Caract_Vehicle.xlsx]
2019-10-10 Tuto_MECAmaster (je croyais que il y était déja le con...)
2019-10-11 Ajout du lien de modification Overleaf
2020-02-28 Rangement, changement mineur de l'arborescence et ajout de documents
    [Budget Optimus 2018_19.xlsx, Calendrier_EPSA.xlsx, CdCF.xlsx, Check_liste_départ_essai.xlsx, Fiche_Suivi.xlsx, GANTT_PROJET_OPTIMUS.xls, GP - Copie.xlsm, GP.xlsm]
2020-03-05 Rangement + Ajout de Documents Invictus
    Ajout de quelques documents de Gestion de Projet d'Invictus et création d'un dossier Template_Outils dans 03_Gestion de Projet, qui recense les templates d'outils utilisés, pour les générations futures
    [Check_liste_départ_essai.xlsx, GP - Gantt Project.xlsm, Logistique_Bron_Intégration.xlsx, Macro_Calendrier_EPSA.xlsx, Planning_Prévisionnel_Soudure.xlsx, RSP.xlsx, Template - Gantt.xlsm, nomenclature_kit_de_montage.xlsm]
2020-03-07 MAJ Fiches Bron pour Intégration Invictus
    [GP - Gantt Project.xlsm]
